Fake-Oxygen/3D-PRINTER/SOLIDWORKS/ASSEMBLY/Titan Aero from Aliexpress for GC/Render/Probe4_1.jpg

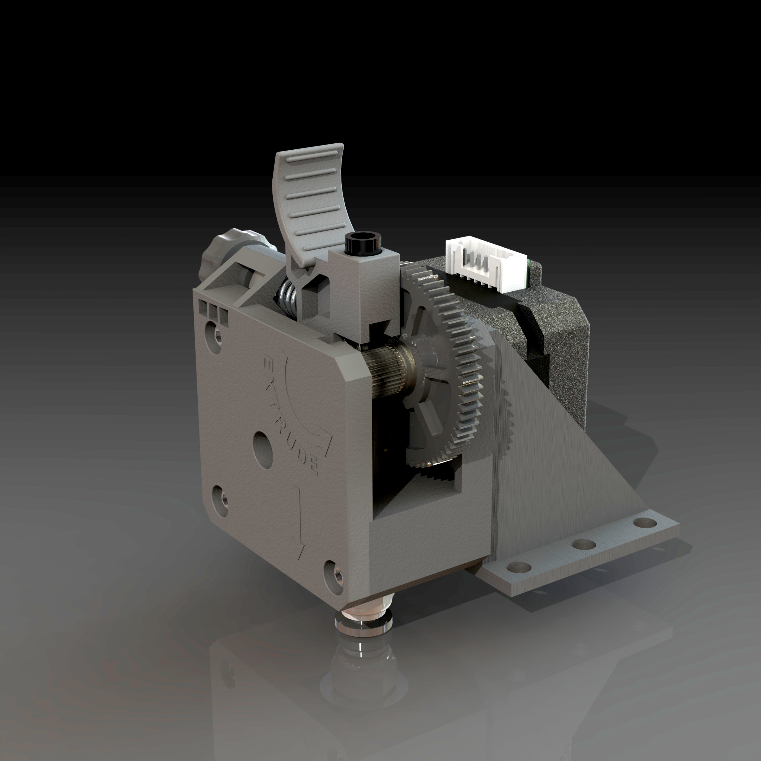
SOLIDWORKS/ASSEMBLY/Titan Aero from Aliexpress for GC/Render/Probe4_1.jpg
