Fake-Oxygen/3D-PRINTER/DRAWINGS/Back Header Cover2.pdf

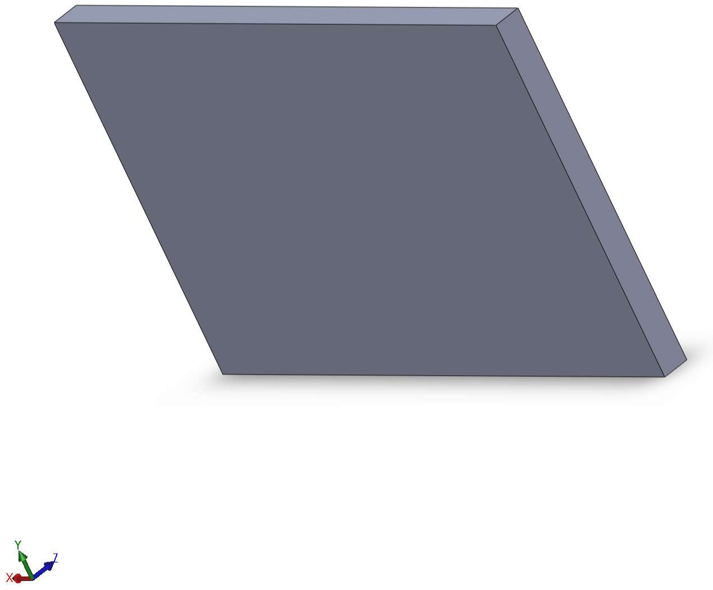
[picture p3: page 1]
