Fake-Oxygen/3D-PRINTER/DRAWINGS/Bearing holder cover2.pdf

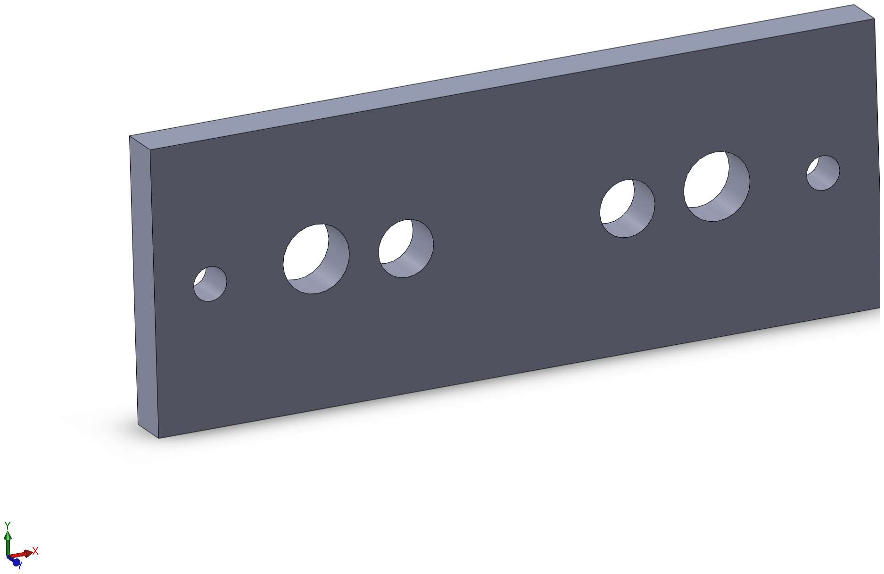
[picture p4: page 1]
