Fake-Oxygen/3D-PRINTER/DRAWINGS/Bearing holder2.pdf

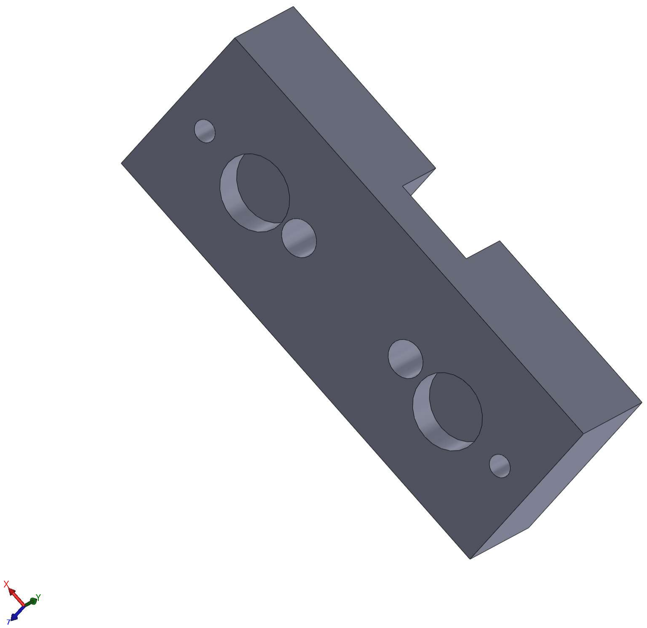
[picture p5: page 1]
