Fake-Oxygen/3D-PRINTER/DRAWINGS/Head Holder2.pdf

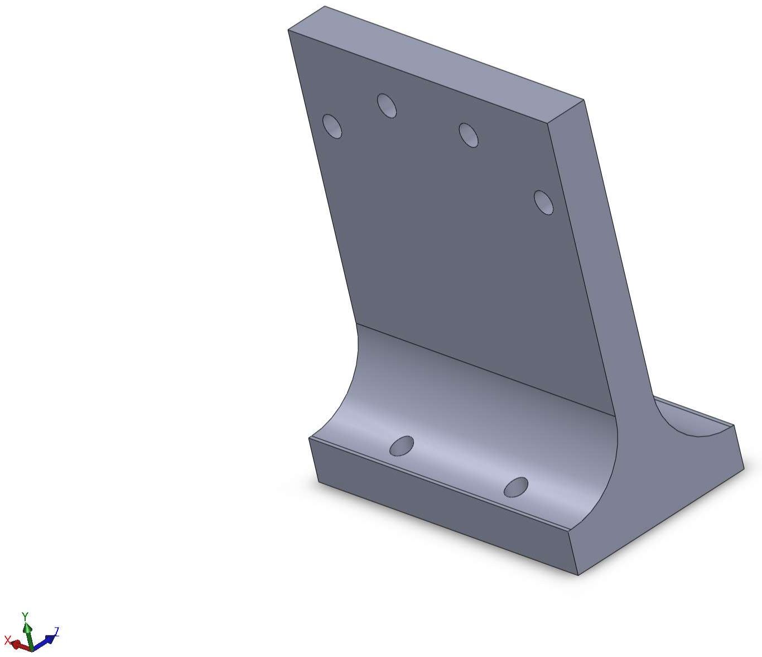
[picture p6: page 1]
