Fake-Oxygen/3D-PRINTER/DRAWINGS/Header fan holder2.pdf

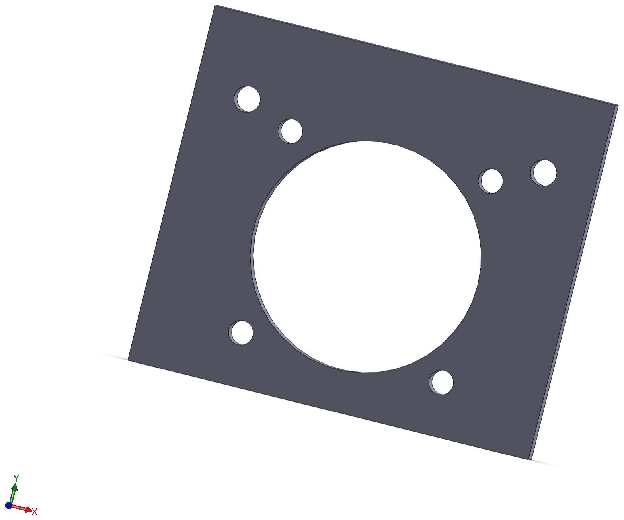
[picture p7: page 1]
