Fake-Oxygen/3D-PRINTER/DRAWINGS/Side Header Cover2.pdf

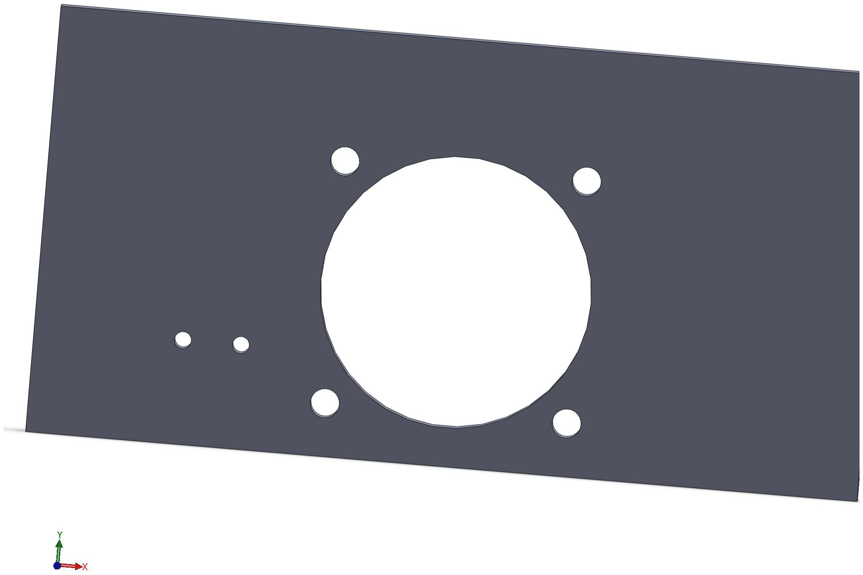
[picture p8: page 1]
