Fake-Oxygen/3D-PRINTER/DRAWINGS/Stabilizer2.pdf

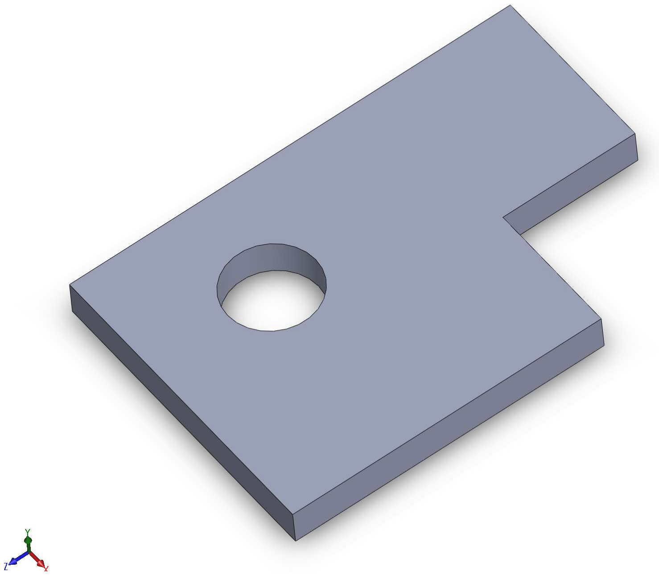
[picture p9: page 1]
