Fake-Oxygen/3D-PRINTER/IMAGES/Circuitry.png

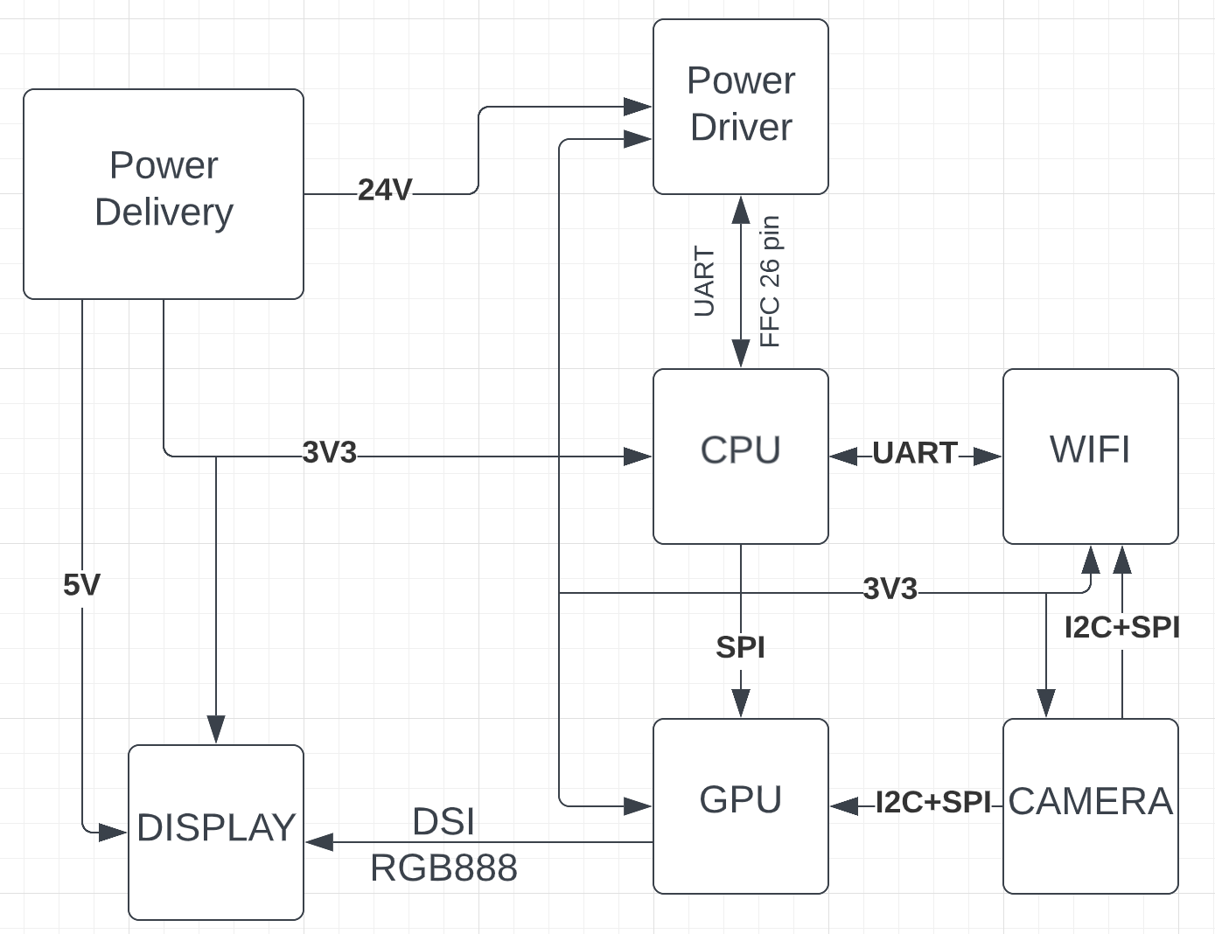
IMAGES/Circuitry.png
