Fake-Oxygen/3D-PRINTER/IMAGES/CPU (1).jpg

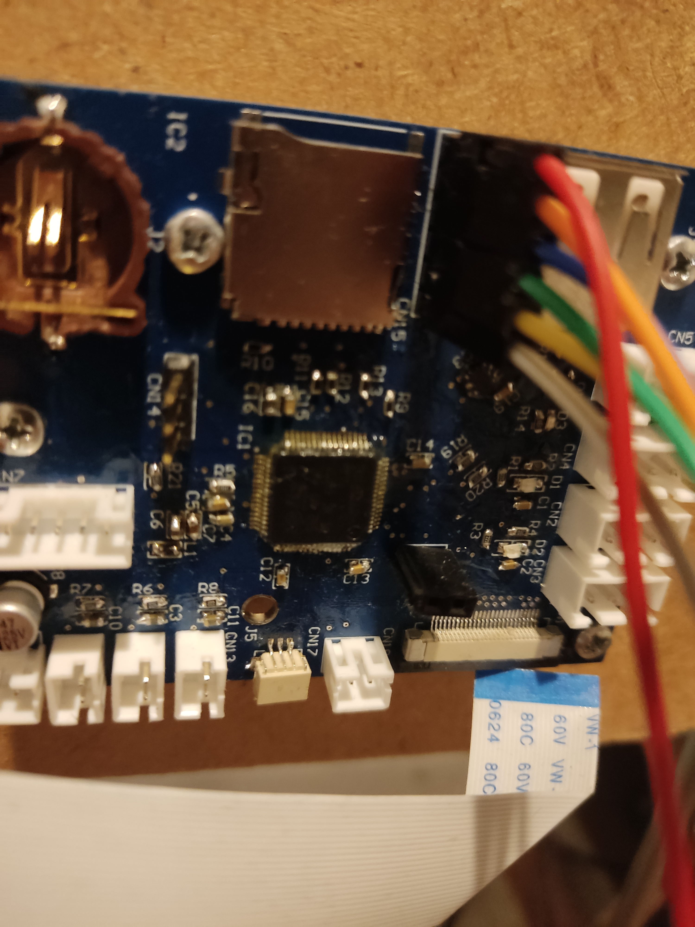
IMAGES/CPU (1).jpg
