Fake-Oxygen/3D-PRINTER/IMAGES/CPU (2).jpg

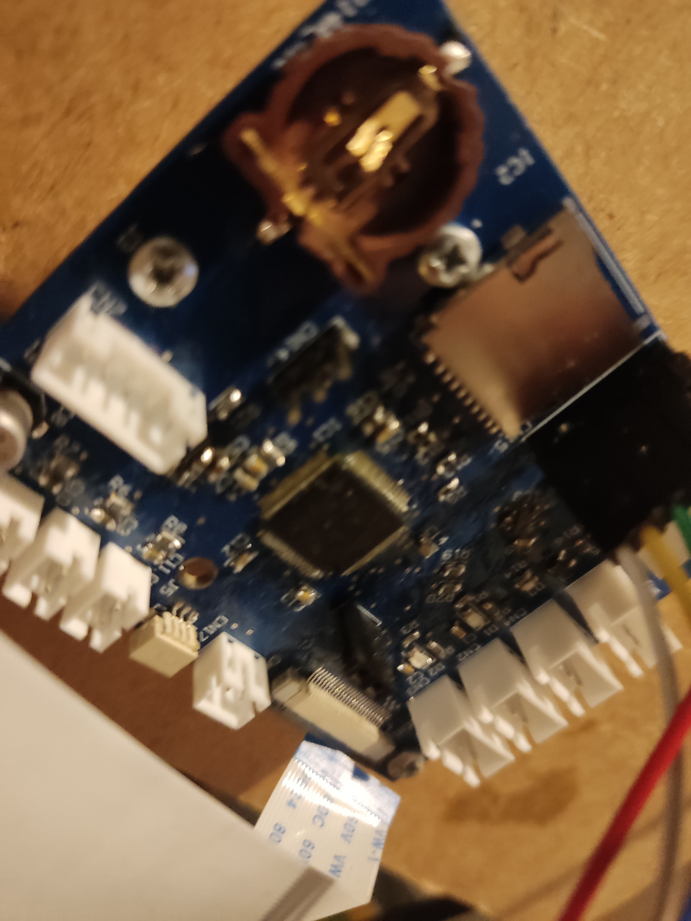
IMAGES/CPU (2).jpg
