Fake-Oxygen/3D-PRINTER/IMAGES/General Input Output Diagram.jpg

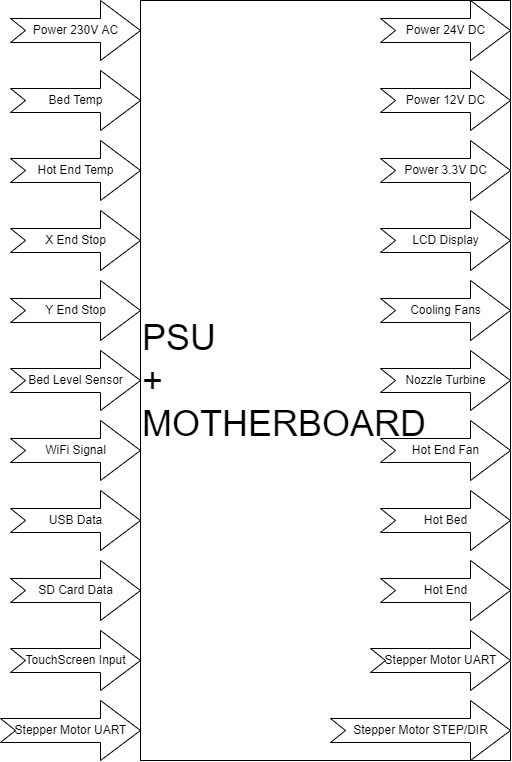
IMAGES/General Input Output Diagram.jpg
