Fake-Oxygen/3D-PRINTER/IMAGES/IMG_20221021_211350.jpg

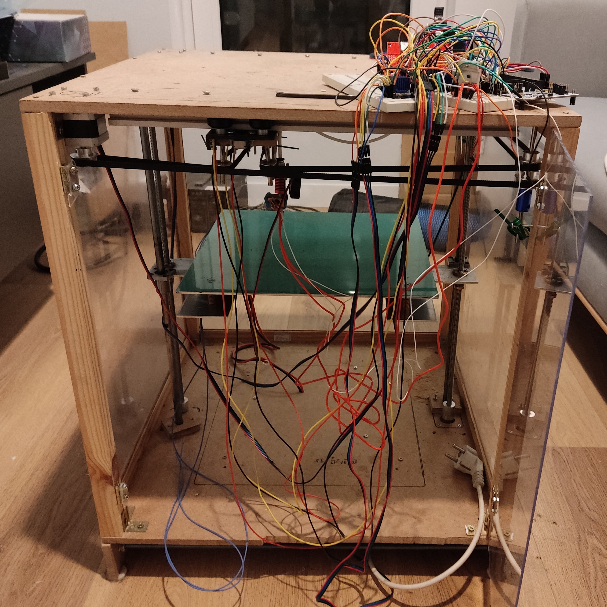
IMAGES/IMG_20221021_211350.jpg
