Fake-Oxygen/3D-PRINTER/IMAGES/preview2.JPG

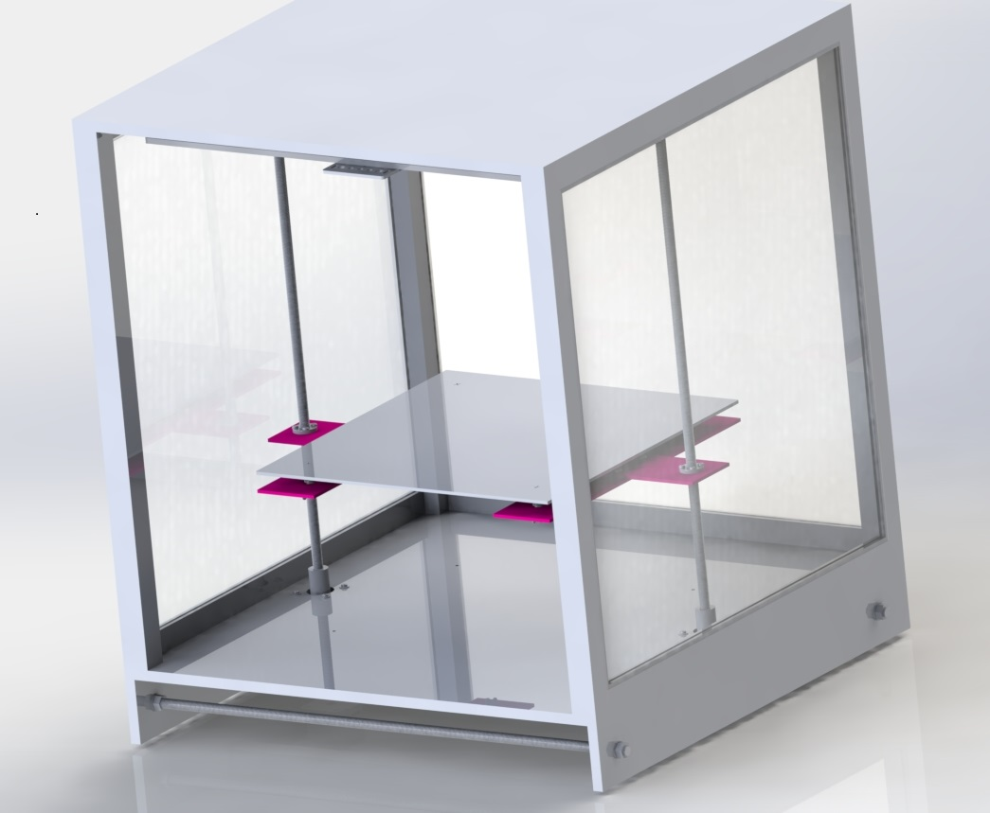
IMAGES/preview2.JPG
