Fake-Oxygen/3D-PRINTER/IMAGES/preview3.JPG

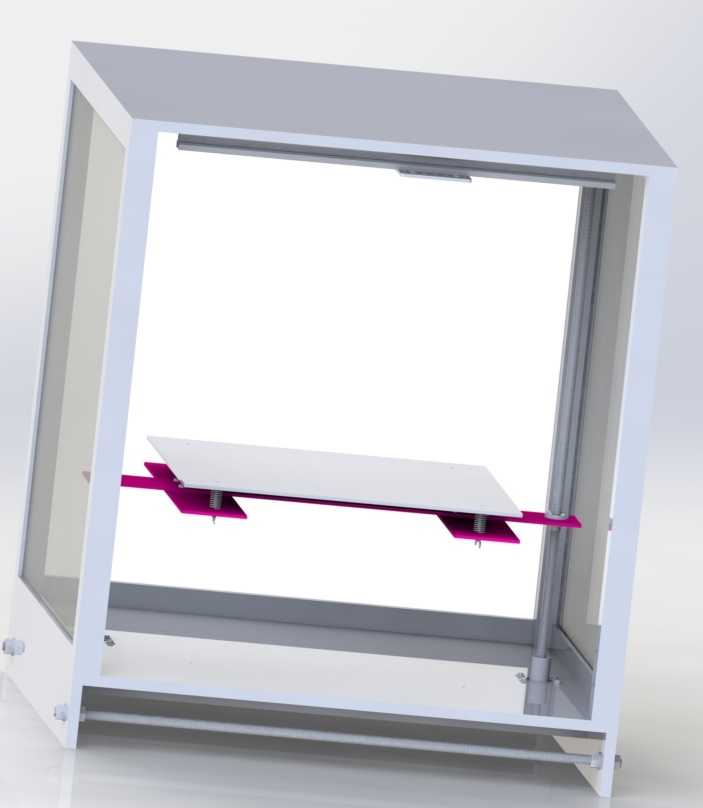
IMAGES/preview3.JPG
