Fake-Oxygen/3D-PRINTER/IMAGES/Preview4.JPG

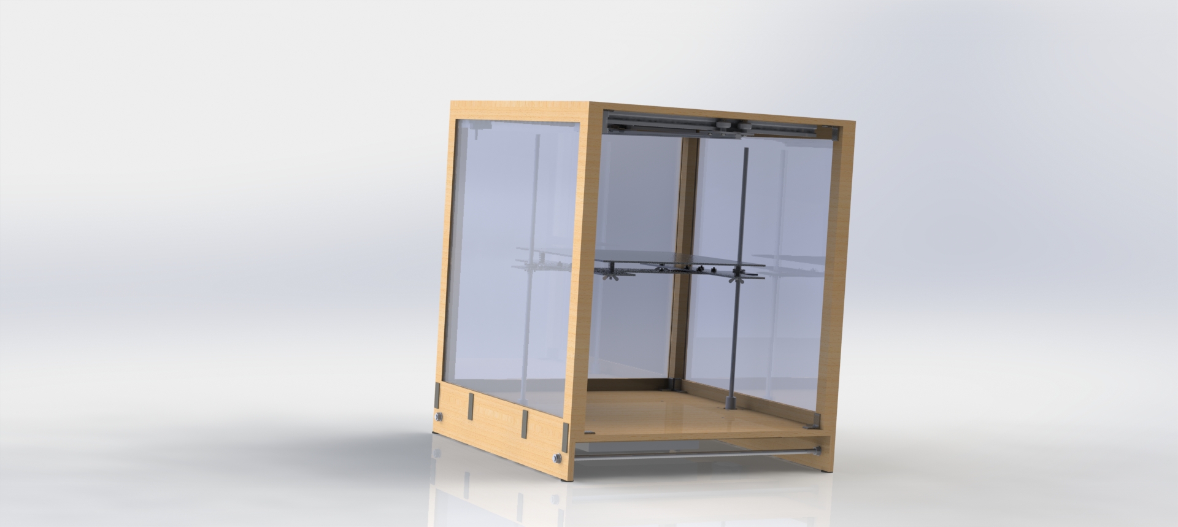
IMAGES/Preview4.JPG
