Fake-Oxygen/3D-PRINTER/IMAGES/Preview5.JPG

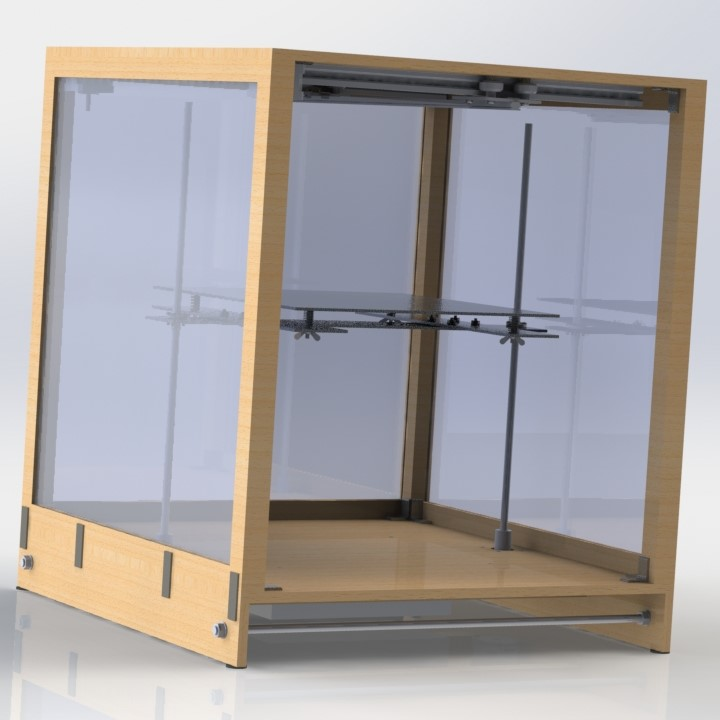
IMAGES/Preview5.JPG
