Fake-Oxygen/3D-PRINTER/IMAGES/preview.JPG

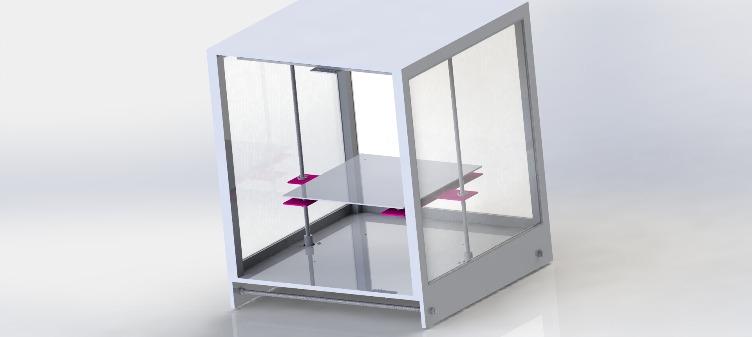
IMAGES/preview.JPG
