Fake-Oxygen/3D-PRINTER/IMAGES/RC for DIAG buffor 2.png

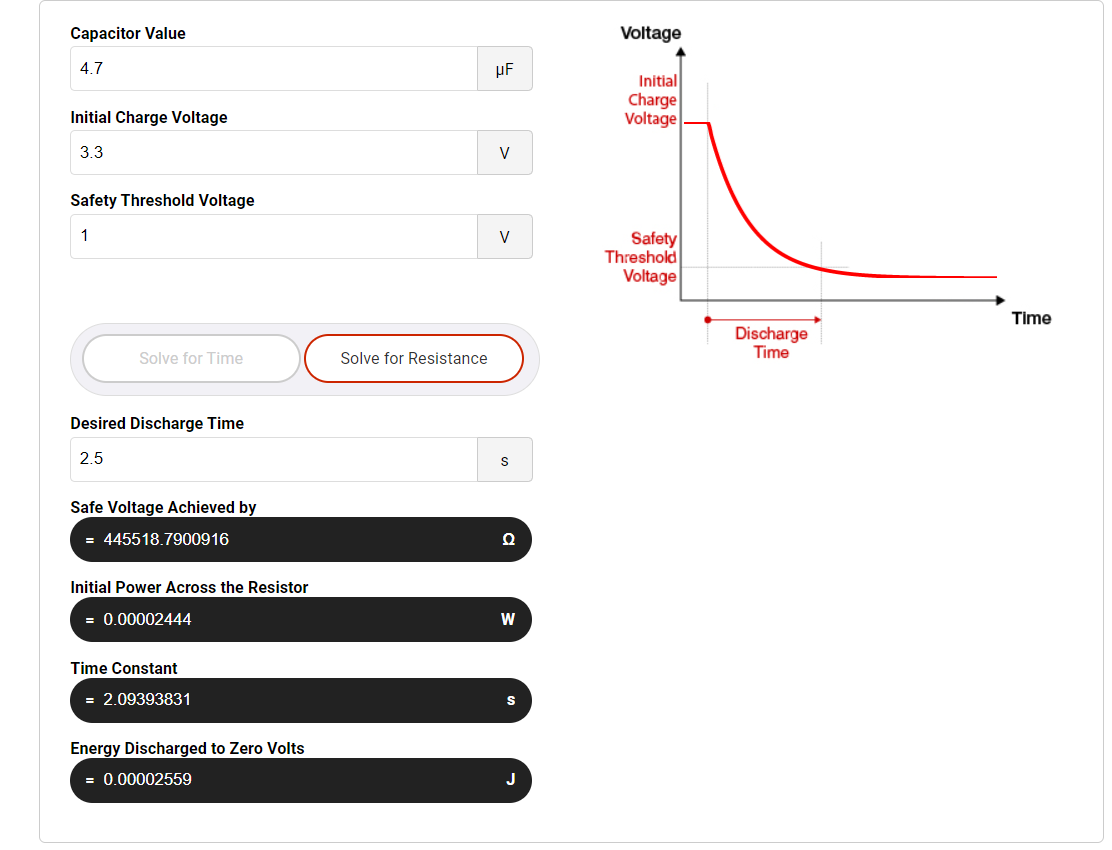
IMAGES/RC for DIAG buffor 2.png
