Fake-Oxygen/3D-PRINTER/IMAGES/RC for DIAG buffor 3.png

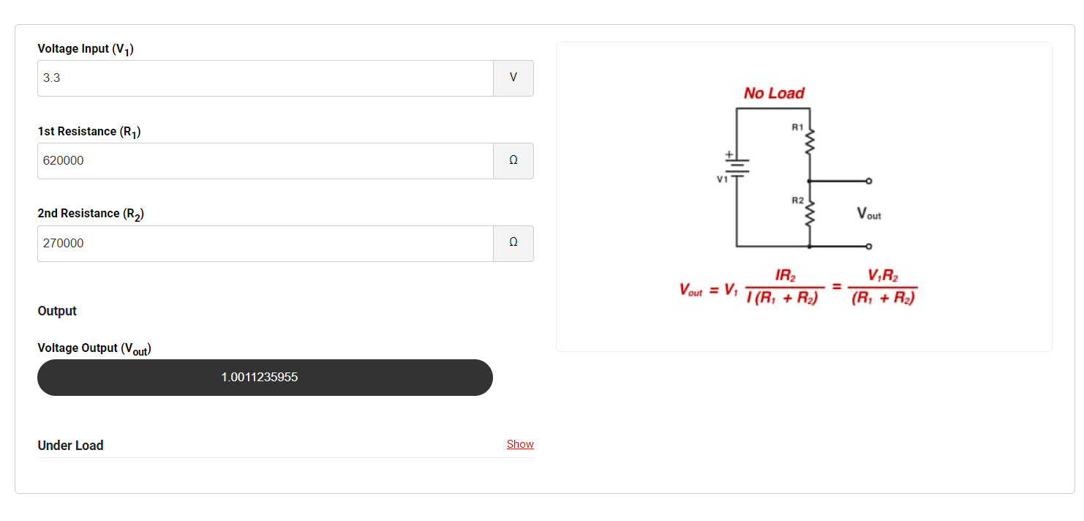
IMAGES/RC for DIAG buffor 3.png
