Fake-Oxygen/3D-PRINTER/IMAGES/RC for DIAG buffor.png

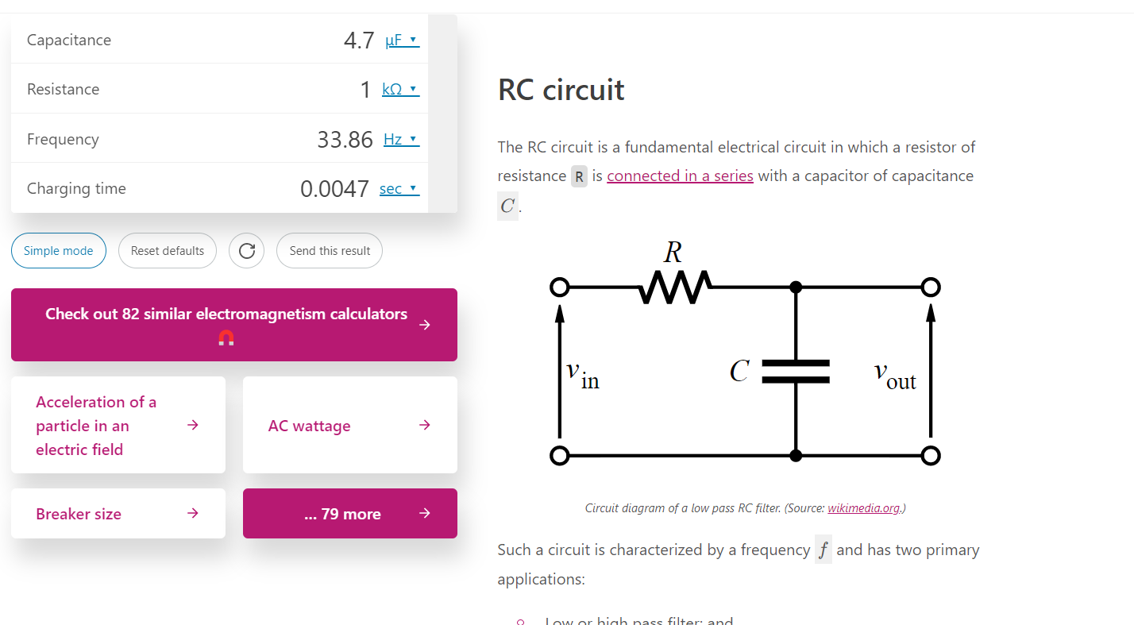
IMAGES/RC for DIAG buffor.png
