Fake-Oxygen/3D-PRINTER/IMAGES/Untit1led.JPG

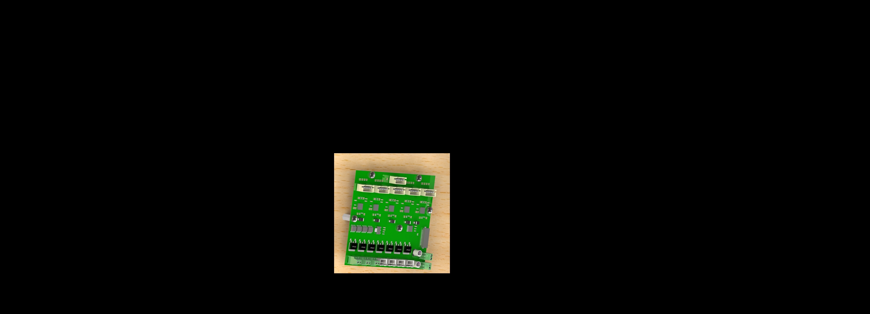
IMAGES/Untit1led.JPG
