Fake-Oxygen/3D-PRINTER/IMAGES/Untitled.JPG

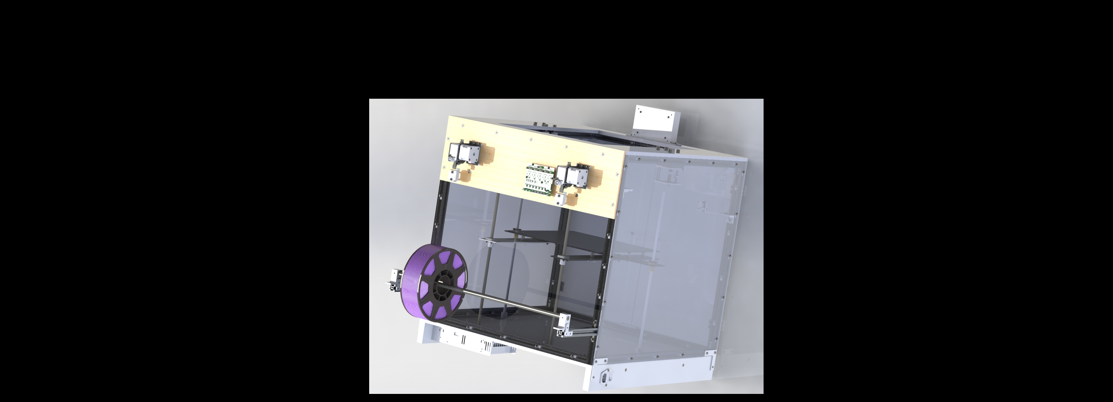
IMAGES/Untitled.JPG
