Fake-Oxygen/3D-PRINTER/PLANS/logic.png

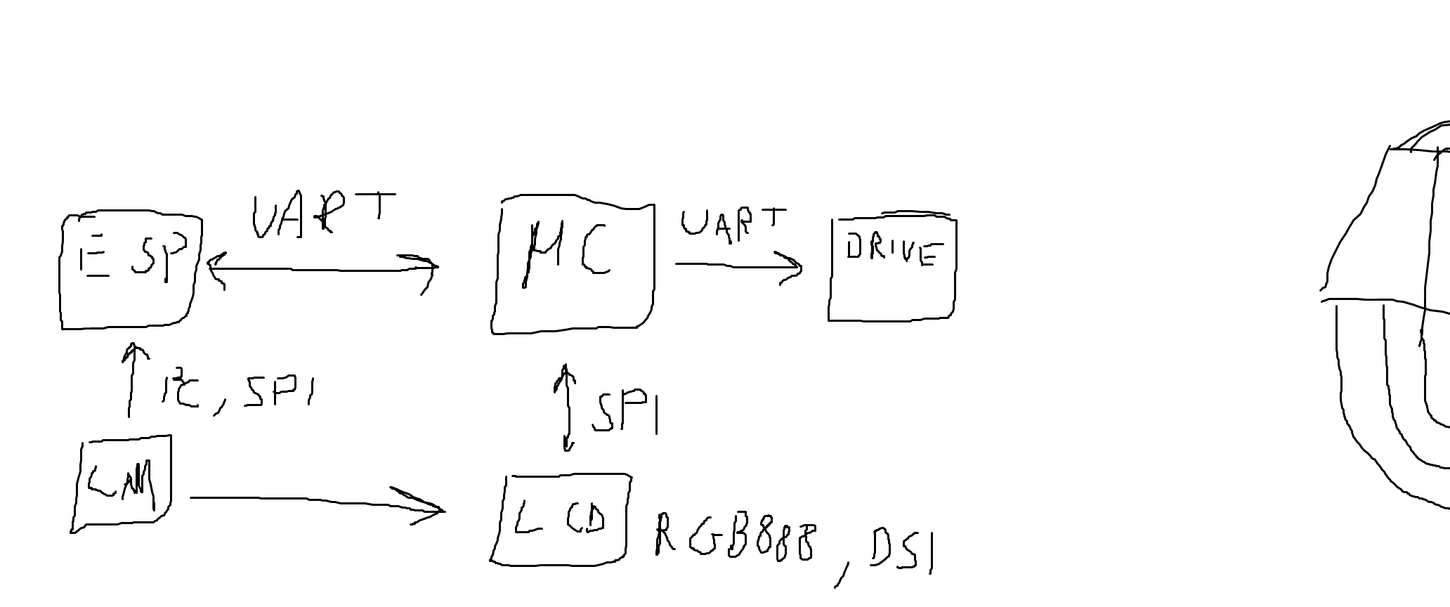
PLANS/logic.png
