Fake-Oxygen/3D-PRINTER/SOLIDWORKS/GENERAL/LMK_seri/LMK01.PNG

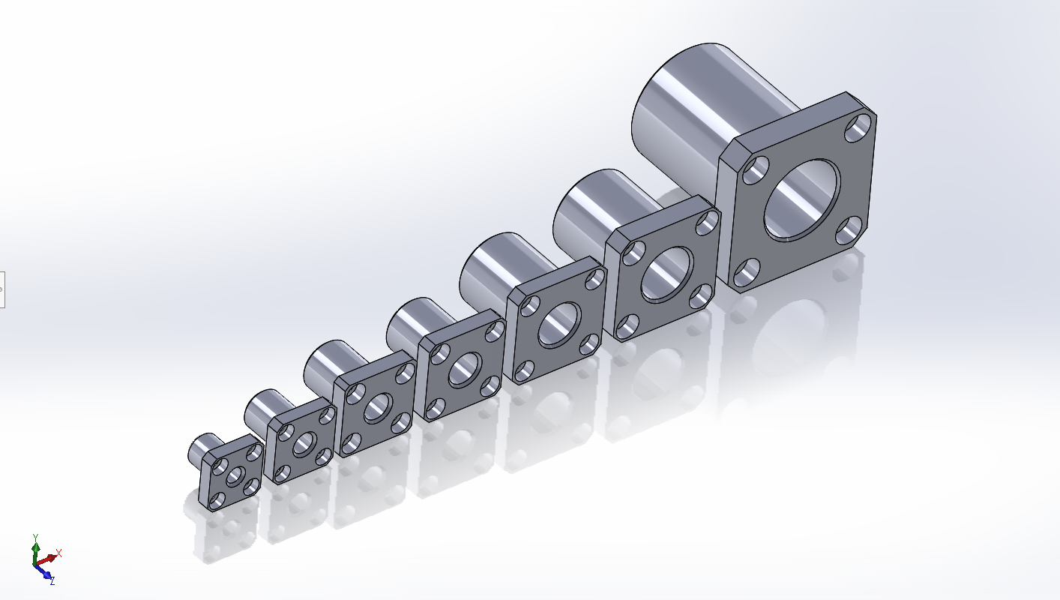
SOLIDWORKS/GENERAL/LMK_seri/LMK01.PNG
