Fake-Oxygen/3D-PRINTER/SOLIDWORKS/GENERAL/LMK_seri/LMKseri.JPG

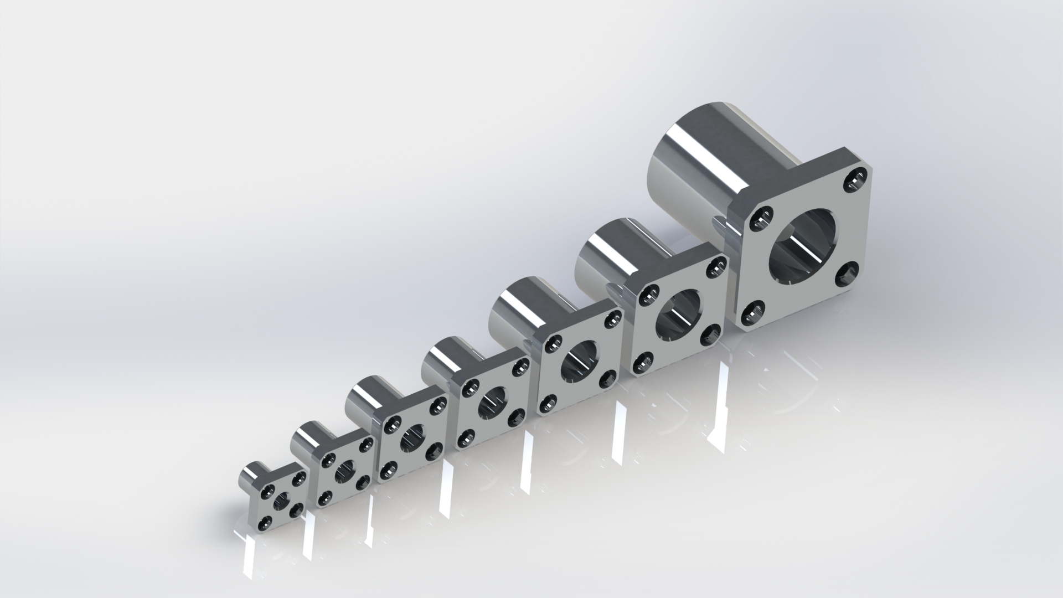
SOLIDWORKS/GENERAL/LMK_seri/LMKseri.JPG
