Fake-Oxygen/3D-PRINTER/BOM2.xlsx

Comment | Value | Description | Designator | Footprint | Quantity | price | Power (Watts)
1µF | 1µF | CAP CER 1UF 50V X7R 0603, CAP CER 1UF 35V X5R 0603 | C1, C2, C11, C28, C31, C67 | CAP 0603_1608 | 9 | 0.15, 0.03
0.1 µF | 0.1 µF | CAP CER 0.1UF 100V X7R 0603 | C3, C4, C5, C6, C7, C8, C9, C10, C12, C13, C14, C15, C19, C20, C21, C22, C23, C24, C29, C30, C32, C33, C34, C35, C36, C37, C50, C51, C52, C53, C66, C68 | CAP 0603_1608 | 51 | 0.01
22n | 22n | CAP CER 2200PF 50V NP0 0603 | C16, C17, C18, C48, C49 | CAP 0603_1608 | 5 | 0.18
4.7µF | 4.7µF | CAP CER 4.7UF 6.3V X5R 0603 | C25, C26, C27, C64, C65 | CAP 0603_1608 | 5 | 0.81
470 pF | 470 pF | CAP CER 0603 470PF 5% X7R 50V FL | C38, C39, C40, C41, C42, C43, C44, C45, C46, C47, C54, C55, C56, C57, C58, C59, C60, C61, C62, C63 | CAP 0603_1608 | 21 | 0.09
100µF | 100µF | CAP ALUM POLY 100UF 20% 35V SMD | C69, C70 | CAP ALSMD POLY 5.3MM H6.0MM | 2 | 0.51
B4B-XH-A_LF__SN_ |  | Connector | CN1, CN2, CN6, CN7, CN11, CN12 | B4BXHALFSN | 6
282834-2 |  | TERM BLK 2P SIDE ENT 2.54MM PCB | CN3, CN4, CN5, CN8, CN9 | TE 282834-2 | 5 | 0.88
B2B-XH-AM_LF__SN_ |  | Connector | CN10, CN13, CN14, CN15 | B2BXHAMLFSN | 4
FH12-26S-0.5SH_55_ |  | Connector | CN16 | FH1226S05SH55 | 1
MBRA120ET3G |  | DIODE SCHOTTKY 20V 1A SMA | D1, D2, D3, D4, D5 | DO214AC SMA | 5 | 0.09
IRLR7843TR |  | MOSFET (N-Channel) | Q1, Q2, Q3, Q4, Q5, Q6, Q7 | IRLR7843TR | 7
0R15 | 150 mOhms | RES 0.15 OHM 1% 1/4W 0603 | R1, R2, R3, R4, R5, R6, R16, R17, R18, R19 | STACKPOLE CSR0603 | 10 | 0.14 | 0.25W, 1/4W
20k | 20k | RES 20K OHM 1% 1/4W 0603 | R7, R8, R9, R10, R12, R14, R22, R23, R24, R26 | RES 0603_1608 | 10 | 0.03 | 0.25W, 1/4W
22k | 22k | RES 22K OHM 1% 1/10W 0603 | R11, R13, R15, R25, R27 | RES 0603_1608 | 5 | 0.01 | 0.1W, 1/10W
240R | 240R | RES SMD 240 OHM 1% 1/4W 0603 | R28 | RES 0603_1608 | 1 | 0.02 | 0.25W, 1/4W
2k | 2k | RES SMD 2K OHM 5% 1/4W 0603 | R29 | RES 0603_1608 | 1 | 0.01 | 0.25W, 1/4W
10k | 10k | RES 10K OHM 1% 1/5W 0603 | R30, R31, R32 | RES 0603_1608 | 3 | 0.01 | 0.2W, 1/5W
TMC2208-LA-T |  | Integrated Circuit | U1, U2, U3, U4, U5 | QFN50P500X500X90-29N-D | 5
LM317MBSTT3G |  | Integrated Circuit | U6 | SOT230P700X175-4N | 1
TC4427EOA713 |  | Integrated Circuit | U7, U8, U9, U10 | SOIC127P600X175-8N | 4
NX3L4051PW,118 |  | Integrated Circuit | U11 | SOP65P640X110-16N | 1
RESET | SE PUSHBUTTON | B1 | PB-6X6mm-Blue | SW PUSHBUTTON | 1
X7R | Capacitor | C5 | 1608[0603] | Cap | 1 | 10nF
Cap | Capacitor | C8, C10, C18, C19 | 1608[0603] | Cap | 4 | 6pF
10µF | CAP ALUM 10UF 20% 16V SMD | C25 | CAP ALSMD 5.3MM H5.4MM | UZP1C100MCL1GB | 1 | 10µF
FH12-30S-0.5SH | Connector | CN1 | FH1230S05SH | FH12-30S-0.5SH | 1
MEM2080-00-128-00-A | Connector | CN2 | MEM20800012800A | MEM2080-00-128-00-A | 1
Header 6 | Header, 6-Pin | CN3 | HDR1X6 | Header 6 | 1
Header 4 | Header, 4-Pin | CN4 | HDR1X4 | Header 4 | 1
10118193-0001LF | CONN RCPT USB2.0 MICRO B SMD R/A | CN5 | FCI USB 10118193-0001LF | 10118193-0001LF | 1
USB-A1HSW6 | CONN RCPT TYPEA 4POS R/A | CN6 | ON SHORE TECHNOLOGY USB-A1HSW6 | USB-A1HSW6 | 1
Header 8 | Header, 8-Pin | CN7 | HDR1X8 | Header 8 | 1
6339191-1 | Connector | CN8 | 63391911 | 6339191-1 | 1
282834-2 | TERM BLK 2P SIDE ENT 2.54MM PCB | CN9 | TE 282834-2 | 282834-2 | 1
BAT60JFILM | Default Diode | D1, D2, D5 | C0805 | Diode | 3
Green | Typical BLUE SiC LED | D3, D6 | 1608[0603] | LED3 | 2
Red | Typical BLUE SiC LED | D4 | 1608[0603] | LED3 | 1
BEAD | Inductor | L1 | 0603L | Inductor | 1 | 100uH
MMBT3904-TP | TRANS NPN 40V 0.2A SOT23 | Q1, Q2 | MCCSEMI SOT-23-3 | MMBT3904-TP | 2
Res1 | Resistor | R1, R2, R3, R4, R5, R6, R32 | 1608[0603] | Res1 | 7 | 47k
Res1 | Resistor | R7 | 1608[0603] | Res1 | 1 | 2k7
Res1 | Resistor | R8, R13, R14 | 1608[0603] | Res1 | 3 | 4k7
Res1 | Resistor | R9, R12, R30 | 1608[0603] | Res1 | 3 | 100k
Res1 | Resistor | R10, R11, R20, R27, R34, R35, R36, R37, R38, R41, R42, R43, R46, R51, R62 | 1608[0603] | Res1 | 15 | 10k
Res1 | Resistor | R15, R18, R26, R39, R40 | 1608[0603] | Res1 | 5 | 100R
Res1 | Resistor | R16, R17 | 1608[0603] | Res1 | 2 | 330R
Res1 | Resistor | R19, R21, R22, R23, R24, R25 | 1608[0603] | Res1 | 6 | 22R
Res1 | Resistor | R28 | 1608[0603] | Res1 | 1 | 36k
Res1 | Resistor | R29, R49 | 1608[0603] | Res1 | 2 | 1k5
Res1 | Resistor | R31 | 1608[0603] | Res1 | 1 | 330
Res1 | Resistor | R33 | 1608[0603] | Res1 | 1 | 22k
Res1 | Resistor | R44, R45, R47, R48, R50 | 1608[0603] | Res1 | 5 | 33R
Res1 | Resistor | R52 | 1608[0603] | Res1 | 1 | 12k1
Res1 | Resistor | R53, R54, R55, R56 | 1608[0603] | Res1 | 4 | 50R
Res1 | Resistor | R57, R58, R59, R60 | 1608[0603] | Res1 | 4 | 75R
Res1 | Resistor | R61, R63 | 1608[0603] | Res1 | 2 | 270R
Closed | Circuit Breaker | SB1, SB3, SB4, SB5, SB6, SB7, SB8, SB9, SB12 | SB_0603 | Circuit Breaker | 9
Open | Circuit Breaker | SB2, SB10, SB11 | SB_0603 | Circuit Breaker | 3
STM32F103CBT6 | Integrated Circuit | U1 | QFP50P900X900X160-48N | STM32F103CBT6 | 1
USBLC6-2SC6 | Integrated Circuit | U2, U4 | SOT95P280X145-6N | USBLC6-2SC6 | 2
LD3985M33R | Integrated Circuit | U3 | SOT95P280X145-5N | LD3985M33R | 1
ESP-12S | Integrated Circuit | U5 | ESP12S | ESP-12S | 1
KMS-1102NL |  | U6 | Transformer | KMS-1102NL | 1
USBLC6-4SC6 | Integrated Circuit | U7 | SOT95P280X145-6N | USBLC6-4SC6 | 1
LAN8742A-CZ-TR | LAN8742A-CZ-TR - Small Footprint RMII 10/100 Ethernet, Transceiver with HP Auto-MDIX and flexPWR Technology SQFN-24 | U8 | QFN24_0R5_4X4 | LAN8742A-CZ-TR | 1
Open | Jumper Wire | W1 | HDR1X2 | Jumper | 1
8 MHz | CRYSTAL 12.0000MHZ 20PF SMD | X1 | ECS CSM-3X | ECS-120-20-3X-EN-TR | 1 | 12 MHz
EB2532JA12-25.000M_TR | Crystal or Oscillator | X2 | EB2532JA1225000MTR | EB2532JA12-25.000M_TR | 1
X5R | Capacitor | C1, C2 | 1608[0603] | Cap | 2
FH12-20S-0.5SH_55_ | Connector | CN1 | FH12-20S-0.5SH(55) | FH12-20S-0.5SH_55_ | 1
Header 10X2 | Header, 10-Pin, Dual row | CN2 | HDR2X10 | Header 10X2 | 1
Res1 | Resistor | R1, R2, R3 | 1608[0603] | Res1 | 3
0.1 µF | CAP CER 0.1UF 100V X7R 0603 | C1, C2, C3, C4, C5, C6, C7, C8, C17, C18, C19, C20, C21, C22, C23, C24, C25, C26, C27, C28, C29, C30, C31 | CAP 0603_1608 | 0603B104K101CT | 23
10µF | CAP ALUM 10UF 20% 16V SMD | C9, C10 | CAP ALSMD 5.3MM H5.4MM | UZP1C100MCL1GB | 2
4.7µF | CAP ALUM POLY 4.7UF 20% 10V SMD | C11 | CAP ALSMD POLY 4.3MM H5.5MM | PCF1A4R7MCL1GB | 1
2.2 µF | CAP CER 2.2UF 6.3V X7R 0603 | C12, C13 | CAP 0603_1608 | CGA3E1X7R0J225M080AC | 2
X5R | Capacitor | C14, C15, C16, C36, C37, C38, C39, C40, C41, C42, C43, C44, C45, C46, C48 | 1608[0603] | Cap | 15
1µF | CAP CER 1UF 16V X5R 0603 | C32, C35 | CAP 0603_1608 | 0603YD105KAT4A | 2
4.7 µF | CAP CER 4.7UF 16V X5R 0603 | C33, C34 | CAP 0603_1608 | GRM185R61C475KE11D | 2
100µF | CAP ALUM POLY 100UF 20% 6.3V SMD | C47 | CAP ALSMD POLY 5.3MM H6.0MM | 6SVPC100M | 1
B2B-PH-K-S(LF)(SN) | CONN HEADER VERT 2POS 2MM | CN1, CN2, CN3 | JST B2B-PH-K | B2B-PH-K-S(LF)(SN) | 3
Header 3 | Header, 3-Pin | CN4 | HDR1X3 | Header 3 | 1
B3B-XH-A(LF)(SN) | CONN HEADER VERT 3POS 2.5MM | CN5, CN6, CN11, CN13 | JST XH B3B-XH-A | B3B-XH-A(LF)(SN) | 4
FH12-30S-0.5SH | Connector | CN7 | FH1230S05SH | FH12-30S-0.5SH | 1
FH12-26S-0.5SH_55_ | Connector | CN8 | FH1226S05SH55 | FH12-26S-0.5SH_55_ | 1
1-84953-5 | Connector | CN9 | 1849535 | 1-84953-5 | 1
FH12-20S-0.5SH_55_ | Connector | CN10 | FH12-20S-0.5SH(55) | FH12-20S-0.5SH_55_ | 1
282834-2 | TERM BLK 2P SIDE ENT 2.54MM PCB | CN12, CN14 | TE 282834-2 | 282834-2 | 2
B5B-PH-K-S(LF)(SN) | CONN HEADER VERT 5POS 2MM | CN15 | JST B5B-PH-K | B5B-PH-K-S(LF)(SN) | 1
Header 6 | Header, 6-Pin | CN16 | HDR1X6 | Header 6 | 1
Green | LED GREEN CLEAR 0805 SMD | D1, D2, D3 | LED 0805_2012 GREEN | QTLP630C4TR | 3
IS42S16160G-6TL | Integrated Circuit | IC1 | SOP80P1176X120-54N | IS42S16160G-6TL | 1
MX25L25645GZNI-08G | Integrated Circuit | IC2 | SON127P600X500X80-9N-D | MX25L25645GZNI-08G | 1
STM32F779IIT6 | Integrated Circuit | IC3 | QFP50P2600X2600X160-176N | STM32F779IIT6 | 1
CR1220-H-SMD | Integrated Circuit | IC4 | CR1220HSMD | CR1220-H-SMD | 1
FCM1608KF-601T03 | FIXED IND 27NH 780MA 200 MOHM | L1 | IND 0603_1608 RF WW | 744917127 | 1
SMT-0827-S-2-R | AUDIO MAGNETIC XDCR 2.5-4.5V SMD | LS1 | PUI Audio SMT-0827-S-2-R | SMT-0827-S-2-R | 1
MMBT3904 | TRANS NPN 40V 0.2A SOT416 | Q1, Q2 | SOT-23_N | MMBT3904TT1G | 2
4.7 kOhms | RES 4.7K OHM 0.1% 1/5W 0603 | R1, R2 | RES 0603_1608 | RS73G1JTTD4701B | 2
2.2 kOhms | RES 2.2K OHM 0.1% 1/5W 0603 | R3 | RES 0603_1608 | RS73G1JTTD2201B | 1
10k | RES 10K OHM 1% 1/5W 0603 | R4, R5, R6, R7 | RES 0603_1608 | RC0603FR-7W10KL | 4
Res1 | Resistor | R8, R9, R10, R11, R12, R13, R14 | 1608[0603] | Res1 | 7
32.768kHz | CRYSTAL 25.0000MHZ 8PF SMD | X1 | NDK NX5032GA | NX5032GA-25.000000MHZ-LN-CD-1 | 1
25 MHz | CRYSTAL 25.0000MHZ 8PF SMD | X2 | NDK NX5032GA | NX5032GA-25.000000MHZ-LN-CD-1 | 1
47uF | CAP ALUM 68UF 20% 16V SMD | C1, C2, C3 | CAP ALSMD 6.6MM H6.1MM | UUD1C680MCL1GS | 3
470uF | CAP ALUM 68UF 20% 16V SMD | C4 | CAP ALSMD 6.6MM H6.1MM | UUD1C680MCL1GS | 1
X5R | Capacitor | C5, C6, C7, C9, C10 | 1608[0603] | Cap | 5
X7R | Capacitor | C8 | 1608[0603] | Cap | 1
282834-2 | TERM BLK 2P SIDE ENT 2.54MM PCB | CN1, CN3 | TE 282834-2 | 282834-2 | 2
282834-3 | TERM BLK 3P SIDE ENT 2.54MM PCB | CN2 | TE 282834-3 | 282834-3 | 1
D Schottky | Schottky Diode | D1 | C0805 | D Schottky | 1
BAT60JFILM | Default Diode | D2 | C0805 | Diode | 1
120uH | FIXED IND 10UH 470MA 1.119OHM SM | L1 | IND 0806_2016 | SDED20161T-100MS | 1
Res1 | Resistor | R1, R2 | 1608[0603] | Res1 | 2 | 3k1
LM2596S-ADJ | Integrated Circuit | U1 | LM2596SXADJ | LM2596S-ADJ | 1
LD3985M33R | Integrated Circuit | U2 | SOT95P280X145-5N | LD3985M33R | 1
