Fake-Oxygen/3D-PRINTER/BOM.xlsx

No. | Part | Quantity | Cost | In Pack | Cost Total
1 | Płyta MDF 1x120x60 | 1 | 54.05 zł | 1 | 54.05 zł
2 | Pręt gwintowany M8x1000 | 1 | 3.95 zł | 1 | 3.95 zł
3 | Nakrętka M8 | 8 | 7.55 zł | 12 | 5.03 zł
4 | Podkładka M8 | 8 | 3.65 zł | 20 | 1.46 zł
5 | Łącznik płaski wąski 40x17x2 | 8 | 3.19 zł | 1 | 25.52 zł
6 | Kątownik meblowy 30 x 30 x 15 | 9 | 1.75 zł | 1 | 15.75 zł
7 | Listwa drewniana kwadratowa 25x25x1000 | 3 | 10.70 zł | 1 | 32.10 zł
8 | Listwa drewniana prostokątna sosnowa surowa 10x22x1000 | 3 | 10.70 zł | 1 | 32.10 zł
9 | Płyta MDF 4 mm 60 x 30 | 1 | 9.90 zł | 1 | 9.90 zł
10 | Zasilacz impulsowy 24V 25A | 1 | 145.00 zł | 1 | 145.00 zł
11 | Śruba 3 x 30 mm | 20 | 3.99 zł | 25 | 3.19 zł
12 | Śruba 3 x 20 mm | 16 | 3.95 zł | 30 | 2.11 zł
13 | Silnik krokowy NEMA17 - 42HB34F08AB - 1,70A - 36mm | 4 | 33.13 zł | 1 | 132.52 zł
14 | Korkowa Podkładka amortyzująca do silnika krokowego NEMA17 | 4 | 1.88 zł | 1 | 7.52 zł
15 | Wkręt 3.5 x 16 mm | 14 | 3.20 zł | 40 | 1.12 zł
16 | Wkręt 3 x 25 mm | 42 | 4.88 zł | 35 | 5.86 zł
17 | Nakrętka M3 | 30 | 7.35 zł | 45 | 4.90 zł
18 | Podkładka płaska 3 mm | 2 | 3.49 zł | 150 | 0.05 zł
19 | Śruba 3 x 10 mm | 8 | 3.99 zł | 30 | 1.06 zł
20 | Nakrętka trapezowa, samoregulująca T8 - do śruby trapezowej - ze sprężyną - 8mm | 2 | 7.24 zł | 1 | 14.48 zł
21 | Sprzęgło elastyczne 5/8 mm | 2 | 4.40 zł | 1 | 8.80 zł
22 | Nakrętka ślizgowa - wpust - M4 z kulką do profili aluminiowych 2020 | 12 | 5.57 zł | 10 | 6.68 zł
23 | Koło prowadnicy oś 5mm - rolka łożyskowana jezdna 625ZZ | 8 | 3.98 zł | 1 | 31.84 zł
24 | Ośka 5x150mm | 1 | 2.89 zł | 1 | 2.89 zł
25 | Łącznik osi - adapter z 5mm na 5mm | 2 | 3.88 zł | 1 | 7.76 zł
26 | Zębatka GT2 36 zębów - 5mm - na pasek 6mm | 6 | 7.76 zł | 1 | 46.56 zł
27 | Pasek zębaty GT2 Black - napędowy - szerokość 6mm | 4 | 6.90 zł | 1 | 27.60 zł
28 | Łożysko kulkowe 5x10x4 - oś 5mm - typ MR105 MINI | 6 | 1.60 zł | 1 | 9.60 zł
29 | Ośka 5x50mm | 4 | 1.30 zł | 1 | 5.20 zł
30 | Blacha Aluminiowa 3mm | 7 | 3.90 zł | 1 | 27.30 zł
31 | Sprężyn Stołu 4x8x30 | 4 | 14.99 zł | 4 | 14.99 zł
32 | Profil aluminiowy V-SLOT 2020 400mm | 2 | 18.80 zł | 1 | 37.60 zł
33 | LMK 10 UU ŁOŻYSKO LINIOWE z kołnierzem kwadratowym | 2 | 16.45 zł | 1 | 32.90 zł
34 | Płytka: V-Slot Gantry Plate | 2 | 26.90 zł | 1 | 53.80 zł
35 | 2x DYSTANS I TULEJKA MIMOŚRODOWA WÓZEK 2020 | 8 | 15.40 zł | 2 | 61.60 zł
36 | Śruba imbusowa walcowa M3 x 40mm | 7 | 6.99 zł | 10 | 4.89 zł
37 | Koło pasowe bez zębów napinacz do paska GT2 | 4 | 5.75 zł | 1 | 23.00 zł
38 | Zestaw Głowica hotend Ptfe CR 10 Ender 1.75 24V | 1 | 49.99 zł | 1 | 49.99 zł
39 | TMC2208 v3.0 STEPSTICK sterownik silnika | 3 | 19.99 zł | 1 | 59.97 zł
40 | Śruba trapezowa Tr8x8 450mm | 2 | 22.00 zł | 1 | 44.00 zł
41 | Pręt okrągły stalowy 1 m x 10 mm surowy | 1 | 14.70 zł | 1 | 14.70 zł
42 | Aluminium Heatbed MK3 310x310 | 1 | 109.70 zł | 1 | 109.70 zł
43 | Śruba 4 x 50 mm | 4 | 12.30 zł | 8 | 6.15 zł
44 | Nakrętka motylkowa 4 | 4 | 9.10 zł | 8 | 4.55 zł
45 | Nakrętka 4 | 12 | 7.35 zł | 45 | 1.96 zł
46 | Podkładka płaska 4 mm | 8 | 3.99 zł | 100 | 0.32 zł
47 | Śruba 4 x 16 mm | 12 | 4.40 zł | 25 | 2.11 zł
48 | Szkło syntetyczne Gładkie 4 mm Przejrzyste 150 x 50 cm | 1 | 159.00 zł | 1 | 159.00 zł
49 | Zawias 33x41 mm przykręcany ocynkowany | 4 | 3.75 zł | 1 | 15.00 zł
50 | Śruba 4 x 25 mm | 12 | 4.95 zł | 12 | 4.95 zł
51 | Śruba 5 x 25 mm | 4 | 4.95 zł | 12 | 1.65 zł
52 | Nakrętka 5 | 4 | 6.85 zł | 40 | 0.68 zł
53 | MGN12 Prowadnica liniowa 450 | 1 | 116.93 zł | 1 | 116.93 zł
Total |  | 340 |  |  | 1492.35 zł
