Fake-Oxygen/3D-PRINTER/SOLIDWORKS/BOM.xlsx

ITEM NO. | PART NUMBER | DESCRIPTION | MATERIAL | STOCK SIZE | WEIGHT | VENDOR | QTY.
1 | Frame |  |  |  |  |  | 1
1.1 | Aluminium panel | 560mm |  |  |  | v slot | 12
1.2 | CTI20-01 - Cantoneira interna base 20 v-slot |  | Zamak (Zn-Al-Cu-Mg) |  |  | abc rc | 20
1.3 | Top Plate v2 |  |  |  |  |  | 1
1.4 | Aluminium panel connector |  |  |  |  | abc rc | 228
1.5 | B18.6.7M - M4 x 0.7 x 16 Type I Cross Recessed FHMS --16N |  |  |  |  |  | 112
1.6 | B18.6.7M - M4 x 0.7 x 8 Type I Cross Recessed FHMS --8N |  |  |  |  |  | 32
1.7 | bottom plate v2 |  |  |  |  |  | 1
1.8 | Bottom Leg |  |  |  |  |  | 1
1.9 | Bottom Leg |  |  |  |  |  | 1
1.1 | L Shape profile connector |  |  |  |  |  | 4
1.11 | B18.6.7M - M5 x 0.8 x 13 Type I Cross Recessed PHMS --13N |  |  |  |  |  | 4
1.12 | B18.6.7M - M4 x 0.7 x 10 Type I Cross Recessed PHMS --10N |  |  |  |  |  | 4
1.13 | Bottom support bar |  |  |  |  |  | 2
1.14 | B18.6.7M - M3 x 0.5 x 16 Type I Cross Recessed FHMS --16N |  |  |  |  |  | 20
1.15 | Plexi side panel |  |  |  |  |  | 2
1.16 | B18.6.7M - M4 x 0.7 x 10 Type I Cross Recessed PHMS --10N |  |  |  |  |  | 40
1.17 | Back top plate |  |  |  |  |  | 1
1.18 | B18.6.7M - M4 x 0.7 x 13 Type I Cross Recessed FHMS --13N |  |  |  |  |  | 9
1.19 | Aluminium panel |  |  |  |  |  | 2
1.2 | B18.6.7M - M4 x 0.7 x 8 Type I Cross Recessed FHMS --8N |  |  |  |  |  | 4
1.21 | Plexi back plate |  |  |  |  |  | 1
1.22 | B18.6.7M - M4 x 0.7 x 10 Type I Cross Recessed PHMS --10N |  |  |  |  |  | 19
1.23 | Assem4^Frame |  |  |  |  |  | 2
1.23.1 | Filament holder rod support |  |  |  |  |  | 1
1.23.2 | L Shape profile connector |  |  |  |  |  | 2
1.24 | Rod |  |  |  |  |  | 1
1.25 | B18.3.6M - M3 x 0.5 x 5 Hex Socket Cone Pt. SS --N |  |  |  |  |  | 2
1.26 | 30x38 2020 HINGE v2.step |  |  |  |  |  | 4
1.27 | Slider T-Nut for 2020 - M5.step |  |  |  |  |  | 8
1.28 | B18.6.7M - M5 x 0.8 x 10 Type I Cross Recessed FHMS --10N |  |  |  |  |  | 8
1.29 | Plexi door |  |  |  |  |  | 2
1.3 | B18.6.7M - M5 x 0.8 x 13 Type I Cross Recessed FHMS --13N |  |  |  |  |  | 8
1.31 | B18.2.4.1M - Hex nut, Style 1, M5 x 0.8 --D-N |  |  |  |  |  | 8
1.32 | Part3 |  |  |  |  |  | 2
1.33 | B18.2.4.1M - Hex nut, Style 1, M4 x 0.7 --D-N |  |  |  |  |  | 4
1.34 | Assem3^Frame |  |  |  |  |  | 2
1.34.1 | Door blocker |  |  |  |  |  | 1
1.34.2 | Aluminium panel connector |  |  |  |  |  | 2
1.34.3 | B18.6.7M - M4 x 0.7 x 13 Type I Cross Recessed FHMS --13N |  |  |  |  |  | 2
2 | XY Axis assembly |  |  |  |  |  | 1
2.1 | Header |  |  |  |  |  | 1
2.1.1 | Head Holder v2 |  |  |  |  |  | 1
2.1.2 | e3d v6 |  |  |  |  |  | 2
2.1.2.1 | e3d nozzle (0.4) |  |  |  |  |  | 1
2.1.2.2 | e3d heaterblock |  |  |  |  |  | 1
2.1.2.3 | e3d heat break |  |  |  |  |  | 1
2.1.2.4 | e3d heatsink |  |  |  |  |  | 1
2.1.3 | Header holder bracket |  |  |  |  |  | 2
2.1.4 | B18.6.7M - M3 x 0.5 x 20 Type I Cross Recessed PHMS --20N |  |  |  |  |  | 4
2.1.5 | Radial-Cooling-Fan- 5015-DC12V |  |  |  |  |  | 1
2.1.5.1 | turbine |  |  |  |  |  | 1
2.1.5.2 | top |  |  |  |  |  | 1
2.1.5.3 | bottom |  |  |  |  |  | 1
2.1.6 | Blower fan holder |  |  |  |  |  | 1
2.1.7 | B18.6.7M - M4 x 0.7 x 25 Type I Cross Recessed PHMS --25N |  |  |  |  |  | 2
2.1.8 | B18.2.4.1M - Hex nut, Style 1, M4 x 0.7 -- D-N |  |  |  |  |  | 2
2.1.9 | Header fan holder plate v2 |  |  |  |  |  | 1
2.1.10 | B18.6.7M - M3 x 0.5 x 16 Type I Cross Recessed PHMS --16N |  |  |  |  |  | 8
2.1.11 | B18.6.7M - M3 x 0.5 x 20 Type I Cross Recessed PHMS --20N |  |  |  |  |  | 4
2.1.12 | B18.2.4.2M - Hex nut, Style 2, M3 x 0.5 -- D-N |  |  |  |  |  | 6
2.1.13 | BLTouch-Smart V3.1.step |  |  |  |  |  | 1
2.1.13.1 | 93245A111.step |  |  |  |  |  | 1
2.1.13.2 | BL-touch.step |  |  |  |  |  | 1
2.1.13.3 | BL-touch-0.step |  |  |  |  |  | 1
2.1.13.4 | BL-touch-1.step |  |  |  |  |  | 1
2.1.13.5 | BL-touch-2.step |  |  |  |  |  | 1
2.1.13.6 | BL-touch-3.step |  |  |  |  |  | 1
2.1.13.7 | BL-touch-4.step |  |  |  |  |  | 1
2.1.13.8 | BL-touch-5.step |  |  |  |  |  | 1
2.1.13.9 | BL-touch-6.step |  |  |  |  |  | 1
2.1.13.10 | BL-touch-7.step |  |  |  |  |  | 1
2.1.13.11 | BL-touch-8.step |  |  |  |  |  | 1
2.1.14 | B18.6.7M - M3 x 0.5 x 10 Type I Cross Recessed PHMS --10N |  |  |  |  |  | 2
2.1.15 | Part2^Header |  |  |  |  |  | 1
2.1.16 | Part3^Header |  |  |  |  |  | 1
2.1.17 | Part4^Header |  |  |  |  |  | 1
2.1.18 | Part5^Header |  |  |  |  |  | 1
2.1.19 | Part6^Header |  |  |  |  |  | 1
2.1.20 | fanduct |  |  |  |  |  | 1
2.1.20.1 | fan duct |  |  |  |  |  | 1
2.1.21 | FanDut |  |  |  |  |  | 1
2.1.22 | PTFE tube connector |  |  |  |  |  | 2
2.1.23 | B18.6.7M - M3 x 0.5 x 13 Type I Cross Recessed PHMS --13N |  |  |  |  |  | 1
2.1.24 | fan |  |  |  |  |  | 3
2.1.25 | fan duct |  |  |  |  |  | 1
2.2 | MGNxx block |  |  |  |  |  | 1
2.3 | MGNxx rail |  |  |  |  |  | 1
2.4 | Side pulley assembly |  |  |  |  |  | 2
2.4.1 | Bearing Holder |  |  |  |  |  | 1
2.4.2 | V Slot Carriage Assembly |  |  |  |  |  | 1
2.4.2.1 | Carriage for V Slot |  |  |  |  |  | 1
2.4.2.2 | Spacer M5 6mm |  |  |  |  |  | 4
2.4.2.3 | Wheel for guideway |  |  |  |  |  | 4
2.4.2.3.1 | Tire for 625ZZ bearing |  |  |  |  |  | 1
2.4.2.3.2 | Bearing |  |  |  |  |  | 2
2.4.2.4 | ISO 1580 - M5 x 25 - 25N |  |  |  |  |  | 4
2.4.2.5 | B18.2.4.1M - Hex nut, Style 1, M5 x 0.8 -- D-N |  |  |  |  |  | 4
2.4.3 | idle pulley |  |  |  |  |  | 2
2.4.4 | Bearing |  |  |  |  |  | 4
2.4.5 | Rod |  |  |  |  |  | 2
2.4.6 | Rod |  |  |  |  |  | 4
2.4.7 | B18.22M - Plain washer, 3 mm, narrow |  |  |  |  |  | 1
2.4.8 | B18.2.4.1M - Hex nut, Style 1, M3 x 0.5 -- D-N |  |  |  |  |  | 1
2.4.9 | bearing holder v2 |  |  |  |  |  | 1
2.4.10 | bearing holder v2 |  |  |  |  |  | 1
2.4.11 | Rod |  |  |  |  |  | 1
2.4.12 | B18.2.4.1M - Hex nut, Style 1, M5 x 0.8 -- D-N |  |  |  |  |  | 4
2.5 | Aluminium panel |  |  |  |  |  | 2
2.6 | Aluminium panel connector |  |  |  |  |  | 20
2.7 | B18.6.7M - M3 x 0.5 x 20 Type I Cross Recessed PHMS --20N |  |  |  |  |  | 2
2.8 | B18.6.7M - M3 x 0.5 x 30 Type I Cross Recessed PHMS --30N |  |  |  |  |  | 4
3 | B18.6.7M - M4 x 0.7 x 16 Type I Cross Recessed FHMS --16N |  |  |  |  |  | 22
4 | NEMA17 |  |  |  |  |  | 2
5 | Podkładka pod NEMA17 |  |  |  |  |  | 2
6 | AC Power Socket |  |  |  |  |  | 1
7 | Power supply |  |  |  |  |  | 1
8 | Back Belt Drive |  |  |  |  |  | 2
8.1 | Bearing |  |  |  |  |  | 2
8.2 | Rod |  |  |  |  |  | 1
8.3 | 36 Teeth GT2 gear |  |  |  |  |  | 2
9 | B18.6.7M - M3 x 0.5 x 25 Type I Cross Recessed FHMS --25N |  |  |  |  |  | 8
10 | 36 Teeth GT2 gear |  |  |  |  |  | 2
11 | Back belt holder |  |  |  |  |  | 2
12 | angle bar |  |  |  |  |  | 5
13 | Aluminium panel connector |  |  |  |  |  | 6
14 | B18.6.7M - M4 x 0.7 x 13 Type I Cross Recessed PHMS --13N |  |  |  |  |  | 4
15 | B18.2.4.1M - Hex nut, Style 1, M4 x 0.7 --D-N |  |  |  |  |  | 4
16 | B18.6.7M - M4 x 0.7 x 10 Type I Cross Recessed PHMS --10N |  |  |  |  |  | 4
17 | Hot Bed |  |  |  |  |  | 1
17.1 | Hot Bed |  |  |  |  |  | 1
17.2 | Left Y Carriage Plate |  |  |  |  |  | 1
17.3 | Right Y Carriage Plate |  |  |  |  |  | 1
17.4 | Spring M4 |  |  |  |  |  | 4
17.5 | B18.6.7M - M4 x 0.7 x 30 Slotted FHMS --30N |  |  |  |  |  | 4
17.6 | Wing nut M4 |  |  |  |  |  | 4
17.7 | Z Axis |  |  |  |  |  | 2
17.7.1 | NEMA17 |  |  |  |  |  | 1
17.7.2 | Podkładka pod NEMA17 |  |  |  |  |  | 1
17.7.3 | Stepper Motor Clutch |  |  |  |  |  | 1
17.7.4 | ROD M8 |  |  |  |  |  | 1
17.7.5 | t8 preload nut.step |  |  |  |  |  | 1
17.8 | Middle Y Carriage Plate |  |  |  |  |  | 1
17.9 | B18.6.7M - M4 x 0.7 x 13 Type I Cross Recessed PHMS --13N |  |  |  |  |  | 8
17.1 | B18.22M - Plain washer, 4 mm, regular |  |  |  |  |  | 8
17.11 | B18.2.4.1M - Hex nut, Style 1, M4 x 0.7 --D-N |  |  |  |  |  | 8
17.12 | B18.6.7M - M2.5 x 0.45 x 10 Type I Cross Recessed PHMS --10N |  |  |  |  |  | 8
17.13 | B18.2.4.1M - Hex nut, Style 1, M2.5 x 0.45 -- D-N |  |  |  |  |  | 8
18 | B18.6.7M - M3 x 0.5 x 20 Type I Cross Recessed FHMS --20N |  |  |  |  |  | 8
19 | B18.6.7M - M4 x 0.7 x 25 Type I Cross Recessed FHMS --25N |  |  |  |  |  | 4
20 | B18.6.7M - M3 x 0.5 x 10 Type I Cross Recessed FHMS --10N |  |  |  |  |  | 4
21 | Rod |  |  |  |  |  | 2
22 | LMK08 |  |  |  |  |  | 2
23 | B18.6.7M - M3 x 0.5 x 10 Type I Cross Recessed PHMS --10N |  |  |  |  |  | 8
24 | B18.22M - Plain washer, 3 mm, narrow |  |  |  |  |  | 8
25 | B18.2.4.1M - Hex nut, Style 1, M3 x 0.5 --D-N |  |  |  |  |  | 16
26 | SS-5GL |  |  |  |  |  | 2
27 | Titan_aero_Aliexpress |  |  |  |  |  | 2
27.1 | House |  |  |  |  |  | 1
27.2 | Adapter for connector |  |  |  |  |  | 1
27.3 | PC4-1_8 my edition |  |  |  |  |  | 1
27.4 | Guide |  |  |  |  |  | 1
27.5 | Thumbscrew |  |  |  |  |  | 1
27.6 | Hexagon Thin Nut ISO 4035 - M4 - C |  |  |  |  |  | 1
27.7 | Main Gear |  |  |  |  |  | 1
27.8 | Cup |  |  |  |  |  | 1
27.9 | Rocker_ASMBL |  |  |  |  |  | 1
27.9.1 | Rocker |  |  |  |  |  | 1
27.9.2 | Sleeve_in_rocker |  |  |  |  |  | 1
27.9.3 | MR95ZZ |  |  |  |  |  | 1
27.9.4 | 623-D-ZZ |  |  |  |  |  | 1
27.9.5 | ISO 7380 - M3 x 8 - 8C |  |  |  |  |  | 1
27.1 | Spring |  |  |  |  |  | 1
27.11 | Shaft and gear |  |  |  |  |  | 1
27.11.1 | Shaft |  |  |  |  |  | 1
27.11.2 | Gear |  |  |  |  |  | 1
27.12 | ISO 15 RBB - 276 - 16,DE,NC,16_68 |  |  |  |  |  | 2
27.13 | ISO 4029 - M3 x 3-C |  |  |  |  |  | 1
27.14 | ISO 7380 - M3 x 8 - 8C |  |  |  |  |  | 2
27.15 | ISO 7380 - M3 x 12 - 12C |  |  |  |  |  | 1
27.16 | ISO 7380 - M3 x 12 - 12C |  |  |  |  |  | 2
27.17 | NEMA17 |  |  |  |  |  | 1
27.18 | Bracket |  |  |  |  |  | 1
27.19 | Dystans |  |  |  |  |  | 6
28 | Filament sensor |  |  |  |  |  | 2
28.1 | Filament_Sensor_1.75m m.stp |  |  |  |  |  | 1
28.2 | Dystans |  |  |  |  |  | 2
29 | B18.6.7M - M3.5 x 0.6 x 25 Type I Cross Recessed PHMS --25N |  |  |  |  |  | 12
30 | B18.22M - Plain washer, 3.5 mm, regular |  |  |  |  |  | 12
31 | B18.2.4.1M - Hex nut, Style 1, M3.5 x 0.6 --D- N |  |  |  |  |  | 12
32 | Rod |  |  |  |  |  | 4
33 | B18.22M - Plain washer, 3 mm, regular |  |  |  |  |  | 8
34 | 1.75mm-filament- spool.step |  |  |  |  |  | 1
35 | Display |  |  |  |  |  | 1
35.1 | display | NOT SPECIFIED |  |  |  |  | 1
35.2 | Front frame |  |  |  |  |  | 1
35.3 | Spacer |  |  |  |  |  | 4
35.4 | Back plate |  |  |  |  |  | 1
35.5 | Spacer |  |  |  |  |  | 4
35.6 | B18.6.7M - M3 x 0.5 x 30 Type I Cross Recessed PHMS --30N |  |  |  |  |  | 4
35.7 | B18.6.7M - M2 x 0.4 x 20 Type I Cross Recessed PHMS --20N |  |  |  |  |  | 4
35.8 | Holding bracket |  |  |  |  |  | 1
36 | B18.6.7M - M5 x 0.8 x 20 Type I Cross Recessed PHMS --20N |  |  |  |  |  | 2
37 | B18.2.4.1M - Hex nut, Style 1, M5 x 0.8 --D-N |  |  |  |  |  | 2
38 | LED STRIP |  |  |  |  |  | 2
39 | Camera |  |  |  |  |  | 1
39.1 | Camera module |  |  |  |  |  | 1
39.2 | Spacer |  |  |  |  |  | 2
39.3 | Camera stand |  |  |  |  |  | 1
39.4 | B18.6.7M - M3 x 0.5 x 20 Type I Cross Recessed PHMS --20N |  |  |  |  |  | 2
39.5 | B18.2.4.1M - Hex nut, Style 1, M3 x 0.5 --D-N |  |  |  |  |  | 2
40 | B18.6.7M - M4 x 0.7 x 10 Type I Cross Recessed PHMS --10N |  |  |  |  |  | 4
41 | B18.2.4.1M - Hex nut, Style 1, M4 x 0.7 --D-N |  |  |  |  |  | 2
42 | angle bar |  |  |  |  |  | 1
