Fake-Oxygen/3D-PRINTER/MOTHERBOARD V2/Extension_Board/Project Outputs for Extension_Board/Extension_Board.xls

Sheet: BOM Report
 | Bill of Materials |  |  | Bill of Materials for Project [Extension_Board.PrjPcb] (No PCB Document Selected)
 | Source Data From: |  | Extension_Board.PrjPcb
 | Project: |  | Extension_Board.PrjPcb
 | Variant: |  | None
 | Creation Date: | 2/3/2023 | 9:15 PM
 | Print Date: | 2023-02-03 | 21:49:16
Name | Footprint | Comment | LibRef | Designator | Description | Pack | Cost/unit | Cost/quanity | Cost total | Quantity | Link
PTS645SM43SMTR92LFS | PB-6X6mm-Blue | RESET | SW PUSHBUTTON | B1 | SE PUSHBUTTON | 10 | PLN 1.39 | PLN 1.39 | PLN 13.90 | 1 | https://pl.farnell.com/c-k-components/pts645sm43smtr92lfs/switch-spst-0-05a-12vdc-smd-4/dp/2320087
CGA3E2X7R1H104K080AA | 0603 | Cap | Cap | C1, C2, C9, C11, C12, C13, C14, C15, C16, C17, C22, C23, C24, C26, C27, C28, C29 | Capacitor | 100 | PLN 0.18 | PLN 3.06 | PLN 18.00 | 17 | https://pl.farnell.com/tdk/cga3e2x7r1h104k080aa/cap-0-1-f-50v-10-x7r-0603/dp/2346967
C0603C105K8PACTU | 0603 | X5R | Cap | C3, C6, C21 | Capacitor | 100 | PLN 0.13 | PLN 0.39 | PLN 13.00 | 3 | https://pl.farnell.com/kemet/c0603c105k8pactu/cap-1-f-10v-10-x5r-0603/dp/9227776
CGA3E2X7R1H104K080AA | 0603 | X5R | Cap | C4, C7 | Capacitor | 100 | PLN 0.18 | PLN 0.36 | PLN 18.00 | 2 | https://pl.farnell.com/tdk/cga3e2x7r1h104k080aa/cap-0-1-f-50v-10-x7r-0603/dp/2346967
CC0603KRX7R8BB103 | 0603 | X7R | Cap | C5 | Capacitor | 100 | PLN 0.09 | PLN 0.09 | PLN 9.00 | 1 | https://pl.farnell.com/yageo/cc0603krx7r8bb103/cap-0-01-f-25v-10-x7r-0603/dp/3019561
0603N100D500CT | 0603 | Cap | Cap | C8, C10 | Capacitor | 100 | PLN 0.03 | PLN 0.06 | PLN 3.00 | 2 | https://pl.farnell.com/walsin/0603n100d500ct/cap-10pf-50v-c0g-np0-0603/dp/2496877
CC0603JRNPO9BN240 | 0603 | Cap | Cap | C18, C19 | Capacitor | 10 | PLN 0.19 | PLN 0.38 | PLN 1.90 | 2 | https://pl.farnell.com/yageo/cc0603jrnpo9bn240/cap-24pf-50v-mlcc-0603/dp/3764469
CC0603KRX7R9BB471 | 0603 | Cap | Cap | C20 | Capacitor | 10 | PLN 0.11 | PLN 0.11 | PLN 1.10 | 1 | https://pl.farnell.com/yageo/cc0603krx7r9bb471/cap-470pf-50v-10-x7r-0603/dp/722157
EEE1EA100SR | 5x5.4 | 10uF | Cap Pol1 | C25 | Polarized Capacitor (Radial) | 10 | PLN 1.25 | PLN 1.25 | PLN 12.50 | 1 | https://pl.farnell.com/panasonic/eee1ea100sr/cap-10-f-25v-radial-smd/dp/9696962
 | FH1234S05SH55 | FH12-34S-0.5SH_55_ | FH12-34S-0.5SH_55_ | CN1 | Connector |  |  | PLN 0.00 | PLN 0.00 | 1
 | PJS00820031 | PJS008-2003-1 | PJS008-2003-1 | CN2 | Connector |  |  | PLN 0.00 | PLN 0.00 | 1
 | HDR1X6 | Header 6 | Header 6 | CN3 | Header, 6-Pin |  |  | PLN 0.00 | PLN 0.00 | 1
 | HDR1X4 | Header 4 | Header 4 | CN4 | Header, 4-Pin |  |  | PLN 0.00 | PLN 0.00 | 1
 | FCI USB 10118193-0001LF | 10118193-0001LF | 10118193-0001LF | CN5 | CONN RCPT USB2.0 MICRO B SMD R/A |  |  | PLN 0.00 | PLN 0.00 | 1
 | ON SHORE TECHNOLOGY USB-A1HSW6 | USB-A1HSW6 | USB-A1HSW6 | CN6 | CONN RCPT TYPEA 4POS R/A |  |  | PLN 0.00 | PLN 0.00 | 1
 | HDR1X8 | Header 8 | Header 8 | CN7 | Header, 8-Pin |  |  | PLN 0.00 | PLN 0.00 | 1
 | RJ45_KRJ-CB4.2GYZNL | KRJ-CB4.2GYZNL | KRJ-CB4.2GYZNL | CN8 | 100 Base-TX (Fast Ethernet) SMD RJ45 single port (1x1) with LEDS Integrated Magnetics Connector |  |  | PLN 0.00 | PLN 0.00 | 1
 | TE 282834-2 | 282834-2 | 282834-2 | CN9 | TERM BLK 2P SIDE ENT 2.54MM PCB |  |  | PLN 0.00 | PLN 0.00 | 1
 | SMC | BAT60JFILM | Diode | D1, D2, D5 | Default Diode |  |  | PLN 0.00 | PLN 0.00 | 3
 | 3.5X2.8X1.9 | Green | LED3 | D3, D6 | Typical BLUE SiC LED |  |  | PLN 0.00 | PLN 0.00 | 2
 | 3.5X2.8X1.9 | Red | LED3 | D4 | Typical BLUE SiC LED |  |  | PLN 0.00 | PLN 0.00 | 1
 | 0603L | BEAD | Inductor | L1 | Inductor |  |  | PLN 0.00 | PLN 0.00 | 1
 | AXIAL-0.3 | Res1 | Res1 | R1, R2, R3, R4, R5, R6, R32 | Resistor |  |  | PLN 0.00 | PLN 0.00 | 7
 | AXIAL-0.3 | Res1 | Res1 | R7 | Resistor |  |  | PLN 0.00 | PLN 0.00 | 1
 | AXIAL-0.3 | Res1 | Res1 | R8, R13, R14 | Resistor |  |  | PLN 0.00 | PLN 0.00 | 3
 | AXIAL-0.3 | Res1 | Res1 | R9, R12, R30 | Resistor |  |  | PLN 0.00 | PLN 0.00 | 3
 | AXIAL-0.3 | Res1 | Res1 | R10, R11, R20, R27, R34, R35, R36, R37, R38, R41, R42, R43, R46, R51, R62 | Resistor |  |  | PLN 0.00 | PLN 0.00 | 15
 | AXIAL-0.3 | Res1 | Res1 | R15, R18, R26, R39, R40 | Resistor |  |  | PLN 0.00 | PLN 0.00 | 5
 | AXIAL-0.3 | Res1 | Res1 | R16, R17 | Resistor |  |  | PLN 0.00 | PLN 0.00 | 2
 | AXIAL-0.3 | Res1 | Res1 | R19, R21, R22, R23, R24, R25 | Resistor |  |  | PLN 0.00 | PLN 0.00 | 6
 | AXIAL-0.3 | Res1 | Res1 | R28 | Resistor |  |  | PLN 0.00 | PLN 0.00 | 1
 | AXIAL-0.3 | Res1 | Res1 | R29, R49 | Resistor |  |  | PLN 0.00 | PLN 0.00 | 2
 | AXIAL-0.3 | Res1 | Res1 | R31 | Resistor |  |  | PLN 0.00 | PLN 0.00 | 1
 | AXIAL-0.3 | Res1 | Res1 | R33 | Resistor |  |  | PLN 0.00 | PLN 0.00 | 1
 | AXIAL-0.3 | Res1 | Res1 | R44, R45, R47, R48, R50 | Resistor |  |  |  | PLN 0.00 | 5
 | AXIAL-0.3 | Res1 | Res1 | R52 | Resistor |  |  |  | PLN 0.00 | 1
 | AXIAL-0.3 | Res1 | Res1 | R53, R54, R55, R56 | Resistor |  |  |  | PLN 0.00 | 4
 | AXIAL-0.3 | Res1 | Res1 | R57, R58, R59, R60 | Resistor |  |  |  | PLN 0.00 | 4
 | AXIAL-0.3 | Res1 | Res1 | R61, R63 | Resistor |  |  |  | PLN 0.00 | 2
 | SB_0603 | Closed | Circuit Breaker | SB1, SB12 | Circuit Breaker |  |  |  | PLN 0.00 | 2
 | SPST-2 | Open | Circuit Breaker | SB2 | Circuit Breaker |  |  |  | PLN 0.00 | 1
 | SPST-2 | Closed | Circuit Breaker | SB3, SB4, SB5, SB6, SB7, SB8, SB9 | Circuit Breaker |  |  |  | PLN 0.00 | 7
 | SB_0603 | Open | Circuit Breaker | SB10, SB11 | Circuit Breaker |  |  |  | PLN 0.00 | 2
 | TO-226-AA | 9013 | NPN | T1, T2 | NPN Bipolar Transistor |  |  |  | PLN 0.00 | 2
 | QFP50P900X900X160-48N | STM32F103CBT6 | STM32F103CBT6 | U1 | Integrated Circuit |  |  |  | PLN 0.00 | 1
 | SOT95P280X145-6N | USBLC6-2SC6 | USBLC6-2SC6 | U2, U4 | Integrated Circuit |  |  |  | PLN 0.00 | 2
 | SOT95P280X145-5N | LD3985M33R | LD3985M33R | U3 | Integrated Circuit |  |  |  |  | 1
 | ESP12S | ESP-12S | ESP-12S | U5 | Integrated Circuit |  |  |  |  | 1
 | Transformer | KMS-1102NL | KMS-1102NL | U6 |  |  |  |  |  | 1
 | SOT95P280X145-6N | USBLC6-4SC6 | USBLC6-4SC6 | U7 | Integrated Circuit |  |  |  |  | 1
 | QFN24_0R5_4X4 | LAN8742A-CZ-TR | LAN8742A-CZ-TR | U8 | LAN8742A-CZ-TR - Small Footprint RMII 10/100 Ethernet, Transceiver with HP Auto-MDIX and flexPWR Technology SQFN-24 |  |  |  |  | 1
 | RAD-0.2 | Open | Jumper | W1 | Jumper Wire |  |  |  |  | 1
 | R38 | NX3225GD-8.00M | XTAL | X1 | Crystal Oscillator |  |  |  |  | 1
 | R38 | X53T-C20SSA-25.000MHz | XTAL | X2 | Crystal Oscillator |  |  |  |  | 1
 |  |  |  |  |  |  |  |  |  | 134
 | Approved |  | Notes

Sheet: Project Information
Project Full Path | C:\Users\Morroway\Documents\.A\Projects\3D-PRINTER\MOTHERBOARD V2\Extension_Board\Extension_Board.PrjPcb
Project Filename | Extension_Board.PrjPcb
Variant Name | None
Data-Source Filename | Extension_Board.PrjPcb
Data-Source Full Path | C:\Users\Morroway\Documents\.A\Projects\3D-PRINTER\MOTHERBOARD V2\Extension_Board\Extension_Board.PrjPcb
Title | Bill of Materials for Project [Extension_Board.PrjPcb] (No PCB Document Selected)
Total Quantity | 134
Report Time | 9:15 PM
Report Date | 2/3/2023
Report Date & Tine | 2/3/2023 9:15 PM
Output Name | Bill of Materials
Output Type | BOM_PartType
Output Generator Name | BOM
Output Generator Description | Bill of Materials
