Fake-Oxygen/3D-PRINTER/MOTHERBOARD V2/Motherboard/Project Outputs for Motherboard/Motherboard.xls

Sheet: BOM Report
Bill of Materials |  |  | Bill of Materials for Project [Motherboard.PrjPcb] (No PCB Document Selected)
Source Data From: |  | Motherboard.PrjPcb
Project: |  | Motherboard.PrjPcb
Variant: |  | None
Creation Date: | 2/3/2023 | 8:51 PM
Print Date: | 2023-02-03 | 20:52:00
Footprint | Comment | LibRef | Designator | Description | Quantity
RAD-0.3 | X5R | Cap | C1, C2, C3, C4, C5, C6, C7, C8, C9, C10, C11, C12, C13, C14, C15, C16, C17, C18, C22, C24, C25, C26, C27, C28, C29, C30, C33, C34, C35, C48_E0_AXIS, C48_E1_AXIS, C48_X_AXIS, C48_Y_AXIS, C48_Z_AXIS, C49_E0_AXIS, C49_E1_AXIS, C49_X_AXIS, C49_Y_AXIS, C49_Z_AXIS, C50_E0_AXIS, C50_E1_AXIS, C50_X_AXIS, C50_Y_AXIS, C50_Z_AXIS, C51_E0_AXIS, C51_E1_AXIS, C51_X_AXIS, C51_Y_AXIS, C51_Z_AXIS, C52_E0_AXIS, C52_E1_AXIS, C52_X_AXIS, C52_Y_AXIS, C52_Z_AXIS, C53_E0_AXIS, C53_E1_AXIS, C53_X_AXIS, C53_Y_AXIS, C53_Z_AXIS, C54_E0_AXIS, C54_E1_AXIS, C54_X_AXIS, C54_Y_AXIS, C54_Z_AXIS, C55_E0_AXIS, C55_E1_AXIS, C55_X_AXIS, C55_Y_AXIS, C55_Z_AXIS, C57_E0_AXIS, C57_E1_AXIS, C57_X_AXIS, C57_Y_AXIS, C57_Z_AXIS, C58_E0_AXIS, C58_E1_AXIS, C58_X_AXIS, C58_Y_AXIS, C58_Z_AXIS, C59_E0_AXIS, C59_E1_AXIS, C59_X_AXIS, C59_Y_AXIS, C59_Z_AXIS, C60_E0_AXIS, C60_E1_AXIS, C60_X_AXIS, C60_Y_AXIS, C60_Z_AXIS, C61 | Capacitor | 90
TAN-B | 4u7 | Cap Pol1 | C19, C20, C44 | Polarized Capacitor (Radial) | 3
TAN-B | 1uF | Cap Pol1 | C21, C23 | Polarized Capacitor (Radial) | 2
TAN-B | 100uF | Cap Pol1 | C30, C31, C32, C47_HOTBED, C47_HOTEND0, C47_HOTEND0_FAN, C47_HOTEND1, C47_HOTEND1_FAN, C47_NOZZLE_FAN | Polarized Capacitor (Radial) | 9
RAD-0.3 | X7R | Cap | C36, C37, C38, C39, C40, C41, C42, C43 | Capacitor | 8
TAN-B | 10uF | Cap Pol1 | C45, C46 | Polarized Capacitor (Radial) | 2
TAN-B | 100u | Cap Pol1 | C56_E0_AXIS, C56_E1_AXIS, C56_X_AXIS, C56_Y_AXIS, C56_Z_AXIS | Polarized Capacitor (Radial) | 5
JST XH B6B-XH-A | X_AXIS | B6B-XH-A(LF)(SN) | CN1 | CONN HEADER VERT 6POS 2.5MM | 1
JST XH B6B-XH-A | Y_AXIS | B6B-XH-A(LF)(SN) | CN2 | CONN HEADER VERT 6POS 2.5MM | 1
JST XH B6B-XH-A | Z0_AXIS | B6B-XH-A(LF)(SN) | CN3 | CONN HEADER VERT 6POS 2.5MM | 1
JST XH B6B-XH-A | Z1_AXIS | B6B-XH-A(LF)(SN) | CN4 | CONN HEADER VERT 6POS 2.5MM | 1
JST XH B6B-XH-A | E0_AXIS | B6B-XH-A(LF)(SN) | CN5 | CONN HEADER VERT 6POS 2.5MM | 1
JST XH B6B-XH-A | E1_AXIS | B6B-XH-A(LF)(SN) | CN6 | CONN HEADER VERT 6POS 2.5MM | 1
TE 282834-2 | 282834-2 | 282834-2 | CN7, CN8, CN9 | TERM BLK 2P SIDE ENT 2.54MM PCB | 3
JST XH B2B-XH-A | B2B-XH-A(LF)(SN) | B2B-XH-A(LF)(SN) | CN10, CN11, CN12 | CONN HEADER VERT 2POS 2.5MM | 3
TE 282834-6 | 282834-6 | 282834-6 | CN13 | TERM BLK 6P SIDE ENT 2.54MM PCB | 1
FH12-20S-0.5SH(55) | FH12-20S-0.5SH_55_ | FH12-20S-0.5SH_55_ | CN14 | Connector | 1
FH1240S05SH55 | FH12-40S-0.5SH_55_ | FH12-40S-0.5SH_55_ | CN15 | Connector | 1
JST XH B3B-XH-A | B3B-XH-A(LF)(SN) | B3B-XH-A(LF)(SN) | CN15, CN16 | CONN HEADER VERT 3POS 2.5MM | 2
JST B5B-PH-K | B5B-PH-K-S(LF)(SN) | B5B-PH-K-S(LF)(SN) | CN17 | CONN HEADER VERT 5POS 2MM | 1
FH1234S05SH55 | FH12-34S-0.5SH_55_ | FH12-34S-0.5SH_55_ | CN18 | Connector | 1
JST B2B-PH-K | B2B-PH-K-S(LF)(SN) | B2B-PH-K-S(LF)(SN) | CN19, CN20, CN21 | CONN HEADER VERT 2POS 2MM | 3
Broadcom 4-PLLC 3228 | GREEN | ASMT-QABD-AEF0E | D1, D2 | LED INDICATOR 0.5W AMBER 4PLCC | 2
DIODE-0.7 | 15V | D Zener | D3_HOTBED, D3_HOTEND0, D3_HOTEND0_FAN, D3_HOTEND1, D3_HOTEND1_FAN, D3_NOZZLE_FAN | Zener Diode | 6
Broadcom 4-PLLC 3228 | RED | ASMT-QABD-AEF0E | D4_HOTBED, D4_HOTEND0, D4_HOTEND0_FAN, D4_HOTEND1, D4_HOTEND1_FAN, D4_NOZZLE_FAN | LED INDICATOR 0.5W AMBER 4PLCC | 6
SOT-23_N | Diode BAT17 | Diode BAT17 | D5_E0_AXIS, D5_E1_AXIS, D5_X_AXIS, D5_Y_AXIS, D5_Z_AXIS | Silicon RF Schottky Diode for Mixer Applications in the VHF/UHF Range | 5
0603L | FCM1608KF-601T03 | Inductor | L1 | Inductor | 1
PUI Audio SMT-0827-S-2-R | SMT-0827-S-2-R | SMT-0827-S-2-R | LS1 | AUDIO MAGNETIC XDCR 2.5-4.5V SMD | 1
ON SEMICONDUCTOR SC-75 | MMBT3904 | MMBT3904TT1G | Q1, Q2_HOTBED, Q2_HOTEND0, Q2_HOTEND0_FAN, Q2_HOTEND1, Q2_HOTEND1_FAN, Q2_NOZZLE_FAN, Q3_HOTBED, Q3_HOTEND0, Q3_HOTEND0_FAN, Q3_HOTEND1, Q3_HOTEND1_FAN, Q3_NOZZLE_FAN | TRANS NPN 40V 0.2A SOT416 | 13
TO-92A | MMBT3906 | 2N3906 | Q4_HOTBED, Q4_HOTEND0, Q4_HOTEND0_FAN, Q4_HOTEND1, Q4_HOTEND1_FAN, Q4_NOZZLE_FAN | PNP General Purpose Amplifier | 6
E3 | IRLR7843PbF | MOSFET-N | Q5_HOTBED, Q5_HOTEND0, Q5_HOTEND0_FAN, Q5_HOTEND1, Q5_HOTEND1_FAN, Q5_NOZZLE_FAN | N-Channel MOSFET | 6
AXIAL-0.3 | Res1 | Res1 | R1, R2, R3, R4, R5, R6, R7, R8, R9, R10, R11, R12, R13, R14, R15, R16, R17, R18_HOTBED, R18_HOTEND0, R18_HOTEND0_FAN, R18_HOTEND1, R18_HOTEND1_FAN, R18_NOZZLE_FAN, R19_HOTBED, R19_HOTEND0, R19_HOTEND0_FAN, R19_HOTEND1, R19_HOTEND1_FAN, R19_NOZZLE_FAN, R20_HOTBED, R20_HOTEND0, R20_HOTEND0_FAN, R20_HOTEND1, R20_HOTEND1_FAN, R20_NOZZLE_FAN, R21_HOTBED, R21_HOTEND0, R21_HOTEND0_FAN, R21_HOTEND1, R21_HOTEND1_FAN, R21_NOZZLE_FAN, R22_HOTBED, R22_HOTEND0, R22_HOTEND0_FAN, R22_HOTEND1, R22_HOTEND1_FAN, R22_NOZZLE_FAN, R23_HOTBED, R23_HOTEND0, R23_HOTEND0_FAN, R23_HOTEND1, R23_HOTEND1_FAN, R23_NOZZLE_FAN, R24_HOTBED, R24_HOTEND0, R24_HOTEND0_FAN, R24_HOTEND1, R24_HOTEND1_FAN, R24_NOZZLE_FAN, R25_HOTBED, R25_HOTEND0, R25_HOTEND0_FAN, R25_HOTEND1, R25_HOTEND1_FAN, R25_NOZZLE_FAN, R26_HOTBED, R26_HOTEND0, R26_HOTEND0_FAN, R26_HOTEND1, R26_HOTEND1_FAN, R26_NOZZLE_FAN, R27_HOTBED, R27_HOTEND0, R27_HOTEND0_FAN, R27_HOTEND1, R27_HOTEND1_FAN, R27_NOZZLE_FAN, R28_E0_AXIS, R28_E1_AXIS, R28_X_AXIS, R28_Y_AXIS, R28_Z_AXIS, R29_E0_AXIS, R29_E1_AXIS, R29_X_AXIS, R29_Y_AXIS, R29_Z_AXIS, R30_E0_AXIS, R30_E1_AXIS, R30_X_AXIS, R30_Y_AXIS, R30_Z_AXIS, R31_E0_AXIS, R31_E1_AXIS, R31_X_AXIS, R31_Y_AXIS, R31_Z_AXIS, R32_E0_AXIS, R32_E1_AXIS, R32_X_AXIS, R32_Y_AXIS, R32_Z_AXIS, R33_E0_AXIS, R33_E1_AXIS, R33_X_AXIS, R33_Y_AXIS, R33_Z_AXIS, R34_E0_AXIS, R34_E1_AXIS, R34_X_AXIS, R34_Y_AXIS, R34_Z_AXIS, R35, R36, R37 | Resistor | 115
QFP50P3000X3000X160-208N | STM32F746BGT6 | STM32F746BGT6 | U1 | Integrated Circuit | 1
SOP80P1176X120-54N | IS42S16160G-6TL | IS42S16160G-6TL | U2 | Integrated Circuit | 1
SON127P600X500X80-9N-D | MX25L25645GZNI-08G | MX25L25645GZNI-08G | U3 | Integrated Circuit | 1
QFN50P500X500X90-29N-D | TMC2208-LA-T | TMC2208-LA-T | U4_E0_AXIS, U4_E1_AXIS, U4_X_AXIS, U4_Y_AXIS, U4_Z_AXIS | Integrated Circuit | 5
SOP65P640X110-16N | NX3L4051PW,118 | NX3L4051PW,118 | U5 | Integrated Circuit | 1
OSC_2SM_3R2x2R5 | 32.768kHz | XTAL | X1 | Crystal Oscillator | 1
OSC_2SM_3R2x2R5 | 25Mhz | XTAL | X2 | Crystal Oscillator | 1
 |  |  |  |  | 313
Approved |  | Notes

Sheet: Project Information
Project Full Path | C:\Users\Morroway\Documents\.A\Projects\3D-PRINTER\MOTHERBOARD V2\Motherboard\Motherboard.PrjPcb
Project Filename | Motherboard.PrjPcb
Variant Name | None
Data-Source Filename | Motherboard.PrjPcb
Data-Source Full Path | C:\Users\Morroway\Documents\.A\Projects\3D-PRINTER\MOTHERBOARD V2\Motherboard\Motherboard.PrjPcb
Title | Bill of Materials for Project [Motherboard.PrjPcb] (No PCB Document Selected)
Total Quantity | 313
Report Time | 8:51 PM
Report Date | 2/3/2023
Report Date & Tine | 2/3/2023 8:51 PM
Output Name | Bill of Materials
Output Type | BOM_PartType
Output Generator Name | BOM
Output Generator Description | Bill of Materials
