Fake-Oxygen/3D-PRINTER/MOTHERBOARD V2/Power Driver/Zeszyt1.xlsx

Object Kind | Layer | X1 (mil) | Y1 (mil) | Height (mil) | Locked | Designator | Show Designator | Component Comment | Show Comment | Lock Strings | Component Type | Footprint | Channel Offset | Rotation | Lock Primitives | Enable Pin Swapping | Enable Part Swapping | Hide Jumpers | Area
Component | Top Layer | 4650 | 3700.512 | 0 | False | U1 | True | TMC2208-LA-T | False | False | Standard | QFN50P500X500X90-29N-D | 97 | 0 | True | False | False | False | 0.056 sq.inch
Component | Top Layer | 4780 | 3495 | 17.716 | False | R11 | True | 22k | False | False | Standard | RES 0603_1608 | 80 | 180 | True | False | False | False | 0.006 sq.inch
Component | Top Layer | 4685 | 3470 | 17.716 | False | R10 | True | 20k | False | False | Standard | RES 0603_1608 | 79 | 90 | True | False | False | False | 0.006 sq.inch
Component | Top Layer | 4430 | 3740 | 17.716 | False | R7 | True | 20k | False | False | Standard | RES 0603_1608 | 76 | 180 | True | False | False | False | 0.006 sq.inch
Component | Top Layer | 4690 | 3970.433 | 17.716 | False | R2 | True | 0R15 | False | False | Standard | STACKPOLE CSR0603 | 71 | 90 | True | False | False | False | 0.008 sq.inch
Component | Top Layer | 4610 | 3970.433 | 17.716 | False | R1 | True | 0R15 | False | False | Standard | STACKPOLE CSR0603 | 70 | 90 | True | False | False | False | 0.008 sq.inch
Component | Top Layer | 4580 | 3468.425 | 35.039 | False | C26 | True | 4.7µF | False | False | Standard | CAP 0603_1608 | 25 | 90 | True | False | False | False | 0.007 sq.inch
Component | Top Layer | 14750 | 3910 | 35.039 | False | C21 | True | 0.1 µF | False | False | Standard | CAP 0603_1608 | 20 | 0 | True | False | False | False | 0.007 sq.inch
Component | Top Layer | 4385 | 3643.425 | 35.039 | False | C19 | True | 0.1 µF | False | False | Standard | CAP 0603_1608 | 18 | 270 | True | False | False | False | 0.007 sq.inch
Component | Top Layer | 4455 | 3643.425 | 35.039 | False | C16 | True | 22n | False | False | Standard | CAP 0603_1608 | 15 | 270 | True | False | False | False | 0.007 sq.inch
Component | Top Layer | 4760 | 3968.425 | 35.039 | False | C8 | True | 0.1 µF | False | False | Standard | CAP 0603_1608 | 7 | 90 | True | False | False | False | 0.007 sq.inch
Component | Top Layer | 4540 | 3970 | 35.039 | False | C7 | True | 0.1 µF | False | False | Standard | CAP 0603_1608 | 6 | 90 | True | False | False | False | 0.007 sq.inch
Component | Top Layer | 4420 | 3885 | 35.039 | False | C4 | True | 0.1 µF | False | False | Standard | CAP 0603_1608 | 3 | 0 | True | False | False | False | 0.007 sq.inch
Component | Top Layer | 4880 | 3885 | 35.039 | False | C3 | True | 0.1 µF | False | False | Standard | CAP 0603_1608 | 2 | 180 | True | False | False | False | 0.007 sq.inch
Component | Top Layer | 4880 | 3960 | 35.039 | False | C1 | True | 1µF | False | False | Standard | CAP 0603_1608 | 0 | 180 | True | False | False | False | 0.007 sq.inch
 |  |  |  |  |  |  |  |  |  |  | 4755 | 3953.425
 |  |  |  |  |  |  |  |  |  |  | 4535 | 3955
Object Kind | String Type | Layer | Component | X1 (mil) | Y1 (mil) | Locked | Hide | Rotation | String | Text Height (mil) | Text Width (mil) | Stroke Font | Autoposition | Mirror | TrueType Font Name | Bold | Italic | Inverted | Inverted Border Width (mil) | Bounding Rectangle Width (mil) | Bounding Rectangle Height (mil) | Text Justification | Inverted Text Offset (mil) | Text Kind | BarCode Full Width (mil) | BarCode Full Height (mil) | BarCode X Margin (mil) | BarCode Y Margin (mil) | BarCode Min Width (mil) | BarCode Type | BarCode Render Mode | BarCode Inverted | BarCode Text Font Name | BarCode Show Text | Border Space Type
Text | Designator | TopOverlay | U1 | 4534.997 | 3853.998 | False | False | 0 | U1 | 12 | 2 | Default | Left-Above | False | Arial | False | False | False | 0 | 0 | 0 | Center | 0 | Stroke Font | 1050 | 210 | 20 | 20 | 0 | Code 39 | By BarCode Full Width | True | Arial | True | Border Margin
Text | Designator | TopOverlay | R11 | 4740.996 | 3553.998 | False | False | 0 | R11 | 12 | 2 | Default | Left-Above | False | Arial | False | False | False | 0 | 0 | 0 | Center | 0 | Stroke Font | 1050 | 210 | 20 | 20 | 0 | Code 39 | By BarCode Full Width | True | Arial | True | Border Margin
Text | Designator | TopOverlay | R10 | 4670.995 | 3551.998 | False | False | 0 | R10 | 12 | 2 | Default | Left-Above | False | Arial | False | False | False | 0 | 0 | 0 | Center | 0 | Stroke Font | 1050 | 210 | 20 | 20 | 0 | Code 39 | By BarCode Full Width | True | Arial | True | Border Margin
Text | Designator | TopOverlay | R7 | 4387.997 | 3798.998 | False | False | 0 | R7 | 12 | 2 | Default | Left-Above | False | Arial | False | False | False | 0 | 0 | 0 | Center | 0 | Stroke Font | 1050 | 210 | 20 | 20 | 0 | Code 39 | By BarCode Full Width | True | Arial | True | Border Margin
Text | Designator | TopOverlay | R2 | 4670.997 | 4065.998 | False | False | 0 | R2 | 12 | 2 | Default | Left-Above | False | Arial | False | False | False | 0 | 0 | 0 | Center | 0 | Stroke Font | 1050 | 210 | 20 | 20 | 0 | Code 39 | By BarCode Full Width | True | Arial | True | Border Margin
Text | Designator | TopOverlay | R1 | 4588.997 | 4065.998 | False | False | 0 | R1 | 12 | 2 | Default | Left-Above | False | Arial | False | False | False | 0 | 0 | 0 | Center | 0 | Stroke Font | 1050 | 210 | 20 | 20 | 0 | Code 39 | By BarCode Full Width | True | Arial | True | Border Margin
Text | Designator | TopOverlay | C26 | 4566.995 | 3553.998 | False | False | 0 | C26 | 12 | 2 | Default | Left-Above | False | Arial | False | False | False | 0 | 0 | 0 | Center | 0 | Stroke Font | 1050 | 210 | 20 | 20 | 0 | Code 39 | By BarCode Full Width | True | Arial | True | Border Margin
Text | Designator | TopOverlay | C19 | 4350 | 3720 | False | False | 0 | C19 | 12 | 2 | Default | Manual | False | Arial | False | False | False | 0 | 0 | 0 | Center | 0 | Stroke Font | 1050 | 210 | 20 | 20 | 0 | Code 39 | By BarCode Full Width | True | Arial | True | Border Margin
Text | Designator | TopOverlay | C16 | 4505 | 3710 | False | False | 0 | C16 | 12 | 2 | Default | Manual | False | Arial | False | False | False | 0 | 0 | 0 | Center | 0 | Stroke Font | 1050 | 210 | 20 | 20 | 0 | Code 39 | By BarCode Full Width | True | Arial | True | Border Margin
Text | Designator | TopOverlay | C8 | 4740.997 | 4053.998 | False | False | 0 | C8 | 12 | 2 | Default | Left-Above | False | Arial | False | False | False | 0 | 0 | 0 | Center | 0 | Stroke Font | 1050 | 210 | 20 | 20 | 0 | Code 39 | By BarCode Full Width | True | Arial | True | Border Margin
Text | Designator | TopOverlay | C7 | 4520.997 | 4055.998 | False | False | 0 | C7 | 12 | 2 | Default | Left-Above | False | Arial | False | False | False | 0 | 0 | 0 | Center | 0 | Stroke Font | 1050 | 210 | 20 | 20 | 0 | Code 39 | By BarCode Full Width | True | Arial | True | Border Margin
Text | Designator | TopOverlay | C4 | 4373.997 | 3943.998 | False | False | 0 | C4 | 12 | 2 | Default | Left-Above | False | Arial | False | False | False | 0 | 0 | 0 | Center | 0 | Stroke Font | 1050 | 210 | 20 | 20 | 0 | Code 39 | By BarCode Full Width | True | Arial | True | Border Margin
Text | Designator | TopOverlay | C3 | 4805 | 3885 | False | False | 0 | C3 | 12 | 2 | Default | Manual | False | Arial | False | False | False | 0 | 0 | 0 | Center | 0 | Stroke Font | 1050 | 210 | 20 | 20 | 0 | Code 39 | By BarCode Full Width | True | Arial | True | Border Margin
Text | Designator | TopOverlay | C1 | 4831.997 | 4018.998 | False | False | 0 | C1 | 12 | 2 | Default | Left-Above | False | Arial | False | False | False | 0 | 0 | 0 | Center | 0 | Stroke Font | 1050 | 210 | 20 | 20 | 0 | Code 39 | By BarCode Full Width | True | Arial | True | Border Margin
