Fake-Oxygen/3D-PRINTER/SOLIDWORKS/Złożenie1.SLDASM

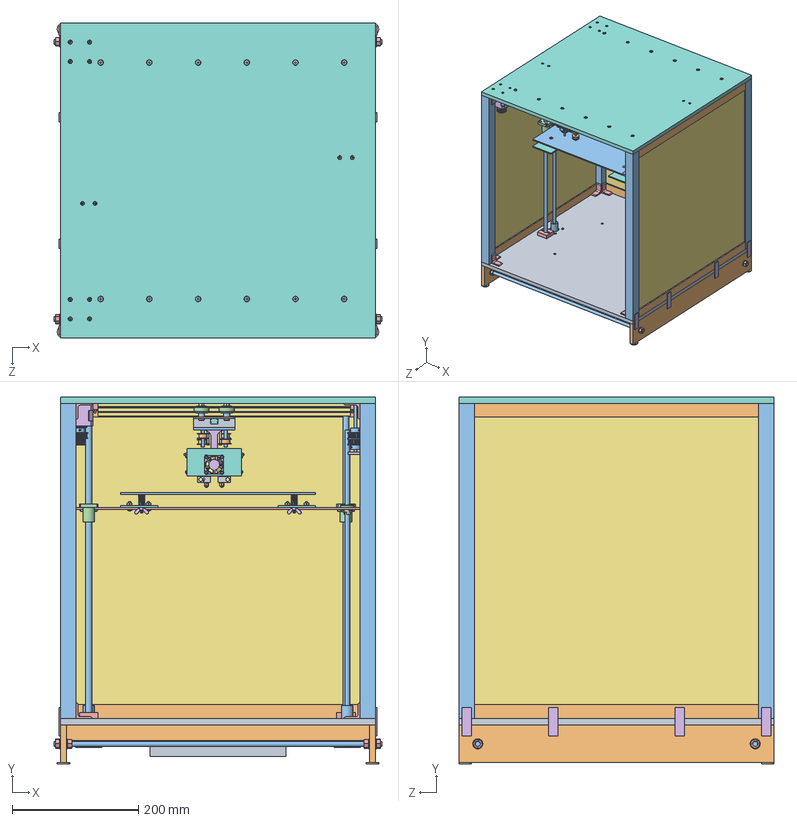
[picture p28: CAD file, 2022-10-26]
SOLIDWORKS/Złożenie1.SLDASM
520.0 x 582.0 x 500.0 mm
Bottom-Top Plate
Side Plate Bottom x 2
Rod x 16
Kopia Bolt Washer x 8
Kopia Nut x 8
NEMA17 x 4
Felt pad x 4
Podkładka pod NEMA17 x 4
cross recessed ctsk wood screws gb x 14
Bottom Plate Support Bar x 2
Stepper Motor Clutch x 2
Lead Screw M8 x 2
Middle Y Carriage Plate
pan cross head_ai x 16
machine screw nut hex_ai x 16
Left Y Carriage Plate x 2
flat washer type a narrow_ai x 8
Side Plate Top x 6
Pillar x 4
socket head cap screw_am x 5
equal angle (new zealand) as-nzs x 16
Reinforcement x 8
Plexi Panel x 2
Top Plate
Zasilacz WIP
flat head screw_am x 20
Hot Bed
Spring M4 x 4
Screw M4 x 4
Wing nut M4 x 4
Aluminium panel x 2
Aluminium panel connector x 12
socket countersunk head screw_am x 12
Carriage for V Slot x 2
Spacer M5 6mm x 8
Tire for 625ZZ bearing x 8
Bearing x 24
slotted pan head screw_iso x 8
hex nut style 1_am x 50
MGNxx rail
pan cross head_am x 22
flat washer narrow_am x 2
36 Teeth GT2 gear x 6
socket set screw flat point_am2 x 10
MGNxx block
Head Holder
HeatEnd Cooler block x 2
Throat tube x 2
Heating Block x 2
Nozzle 0.4mm x 2
PTFE tube connector x 2
flat washer regular_am x 8
Header fan holder x 2
Fan Housing x 3
Fan Propeller x 3
Side Header Cover
Bearing Holder x 2
idle pulley x 4
Bearing holder cover x 2
LMK Bearing x 2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
