Fake-Oxygen/3D-PRINTER/SOLIDWORKS/ASSEMBLY/Titan Aero from Aliexpress for GC/Main Gear.SLDPRT

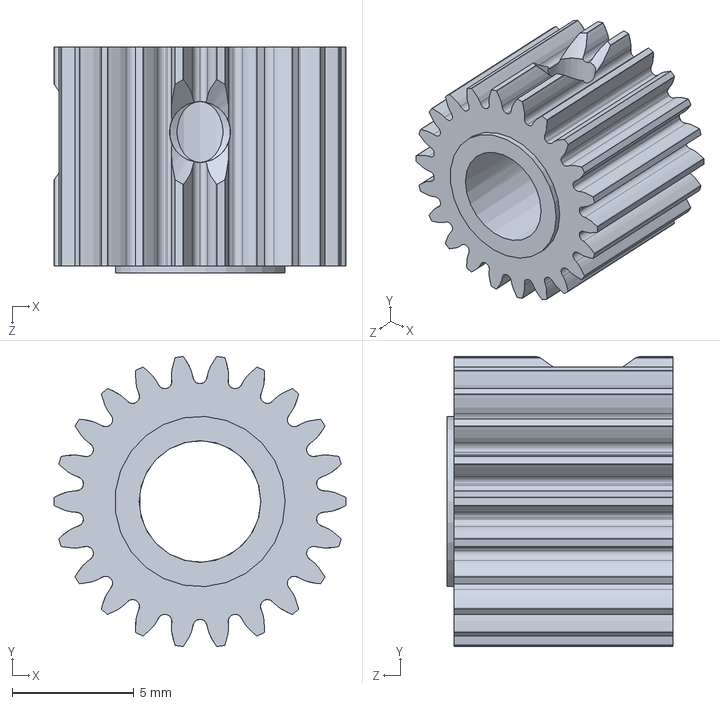
[picture p29: CAD file, 2023-02-11]
SOLIDWORKS/ASSEMBLY/Titan Aero from Aliexpress for GC/Main Gear.SLDPRT
12.0 x 11.9 x 9.30 mm
