Fake-Oxygen/3D-PRINTER/MOTHERBOARD V2/D-PACK.stp

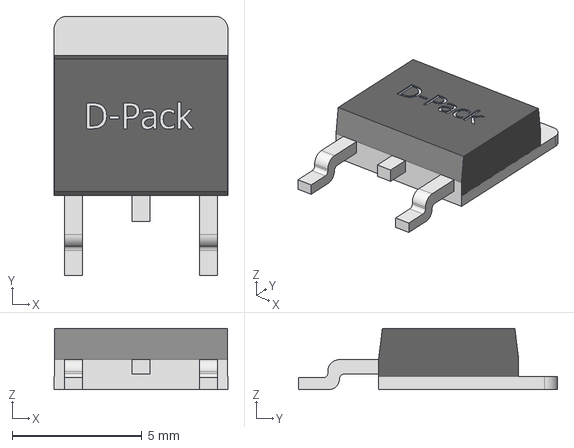
[picture p30: CAD file, 2023-06-17]
MOTHERBOARD V2/D-PACK.stp
6.70 x 9.99 x 2.35 mm
