Fake-Oxygen/3D-PRINTER/MOTHERBOARD V2/Power Driver/PCB1.step

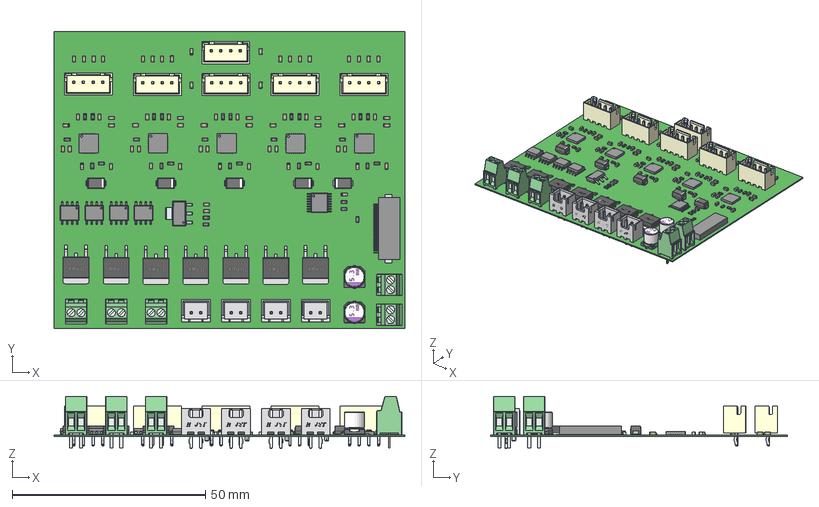
[picture p31: CAD file, 2023-06-17]
MOTHERBOARD V2/Power Driver/PCB1.step
90.8 x 76.8 x 13.5 mm
PinsArrayLR x 10
PinsArrayL
FilletPinR
ThermalPin x 5
PinsArrayTB x 5
0603 resistor x 20
Stackpole CSR0603 Res x 10
SMA x 5
Pins
B4B-XH-A(LF)(SN) - BODY x 6
B4B-XH-A(LF)(SN) - PIN x 6
c-282834-2-c-3d x 5
CAP ALSMD - POLY - 5.3 x 5.3 x 6.0 x 2
0603 cap x 68
D-PACK x 7
