Fake-Oxygen/3D-PRINTER/SOLIDWORKS/GENERAL/4.3inch Capacitive Touch LCD 3D Drawing/Front frame.SLDPRT

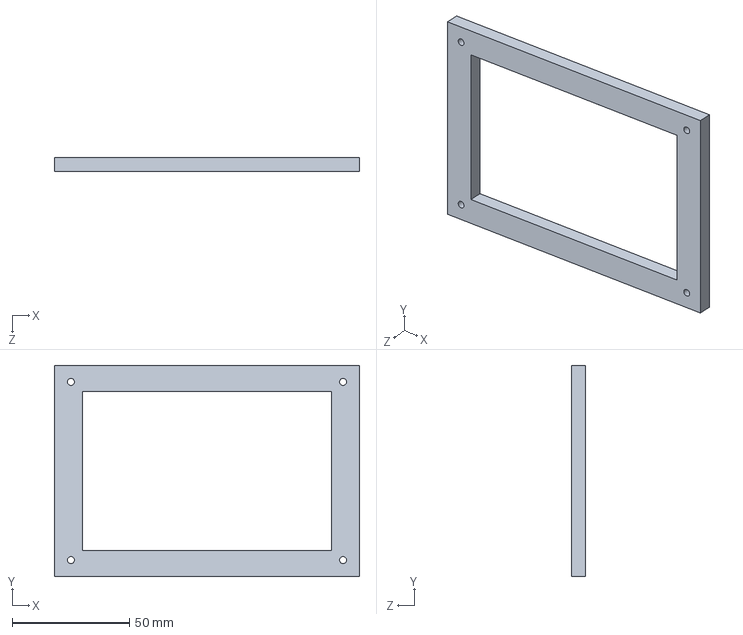
[picture p32: CAD file, 2023-10-18]
SOLIDWORKS/GENERAL/4.3inch Capacitive Touch LCD 3D Drawing/Front frame.SLDPRT
130.0 x 90.0 x 6.00 mm
