Fake-Oxygen/3D-PRINTER/SOLIDWORKS/GENERAL/camera/Camera stand.SLDPRT

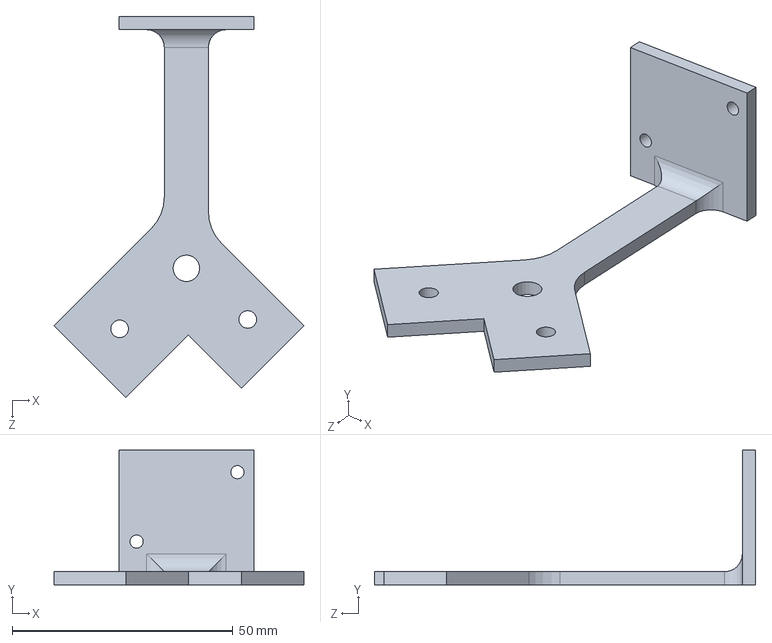
[picture p33: CAD file, 2023-10-18]
SOLIDWORKS/GENERAL/camera/Camera stand.SLDPRT
56.6 x 30.5 x 86.3 mm
