Fake-Oxygen/3D-PRINTER/SOLIDWORKS/GENERAL/LMK_seri/LMK30.SLDPRT

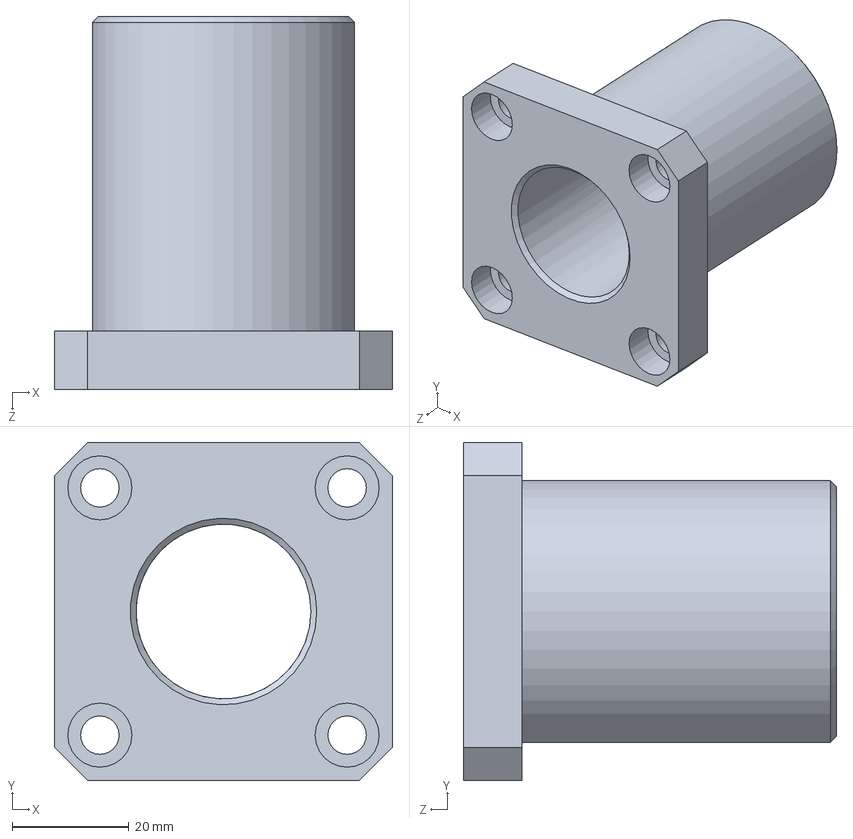
[picture p34: CAD file, 2023-01-27]
SOLIDWORKS/GENERAL/LMK_seri/LMK30.SLDPRT
58.0 x 58.0 x 64.0 mm
