Fake-Oxygen/3D-PRINTER/SOLIDWORKS/GENERAL/Radial Cooling Fan 50mm DC12V/top.SLDPRT

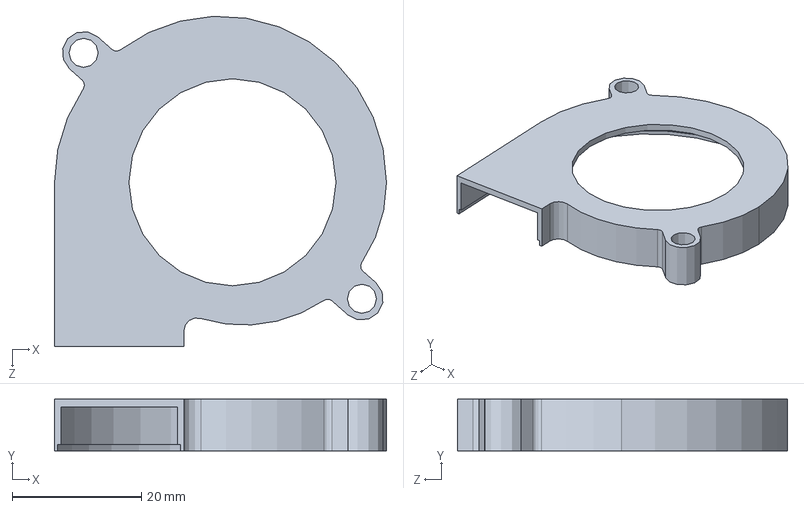
[picture p35: CAD file, 2023-08-07]
SOLIDWORKS/GENERAL/Radial Cooling Fan 50mm DC12V/top.SLDPRT
51.3 x 8.00 x 51.0 mm
