Fake-Oxygen/3D-PRINTER/SOLIDWORKS/SPECIFIC/Head Holder v2.SLDPRT

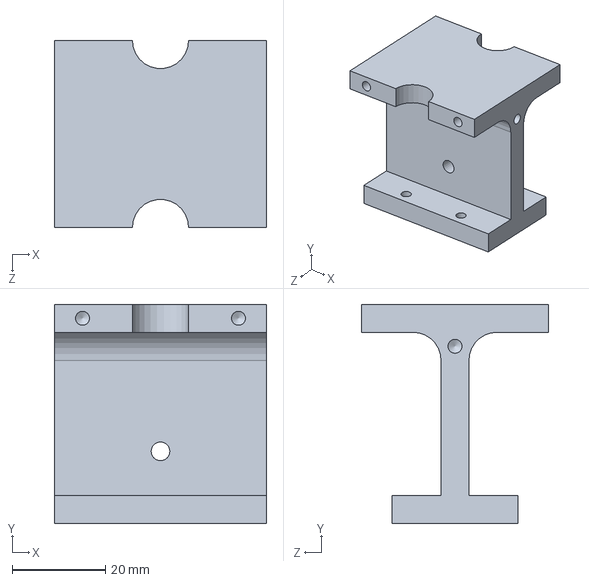
[picture p36: CAD file, 2023-10-18]
SOLIDWORKS/SPECIFIC/Head Holder v2.SLDPRT
45.4 x 47.0 x 40.0 mm
