Fake-Oxygen/3D-PRINTER/SOLIDWORKS/STL/Bearing holder Z axis.STL

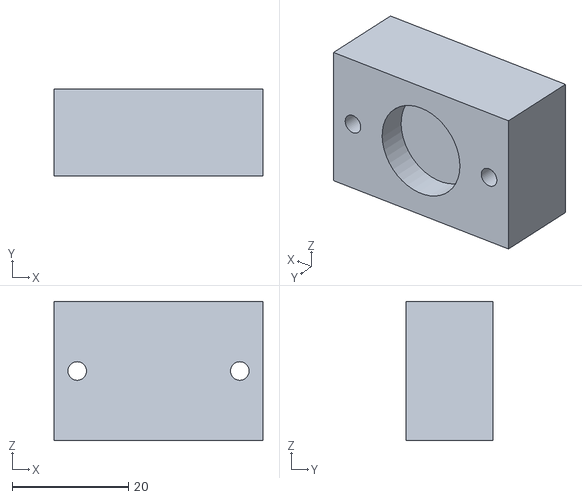
[picture p37: CAD file, 2023-08-07]
SOLIDWORKS/STL/Bearing holder Z axis.STL
36.0 x 15.0 x 24.0
