Fake-Oxygen/3D-PRINTER/TESTS/cube.SLDPRT

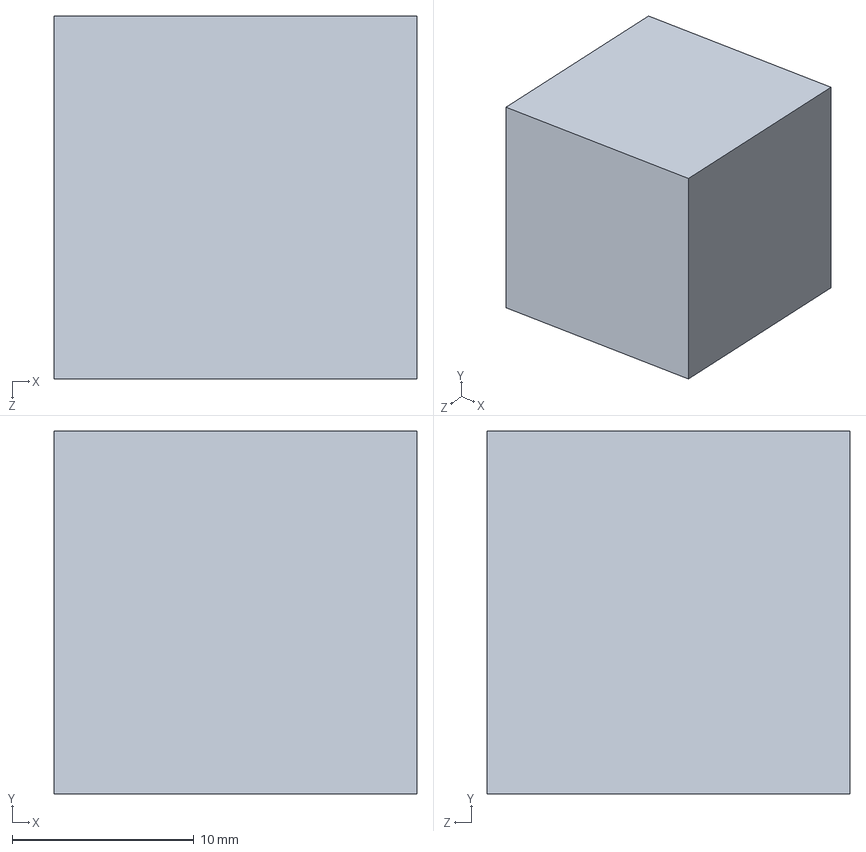
[picture p38: CAD file, 2023-10-18]
TESTS/cube.SLDPRT
20.0 x 20.0 x 20.0 mm
