Fake-Oxygen/3D-PRINTER/SOLIDWORKS/GENERAL/2020/30x38 2020 HINGE v2.step.SLDPRT

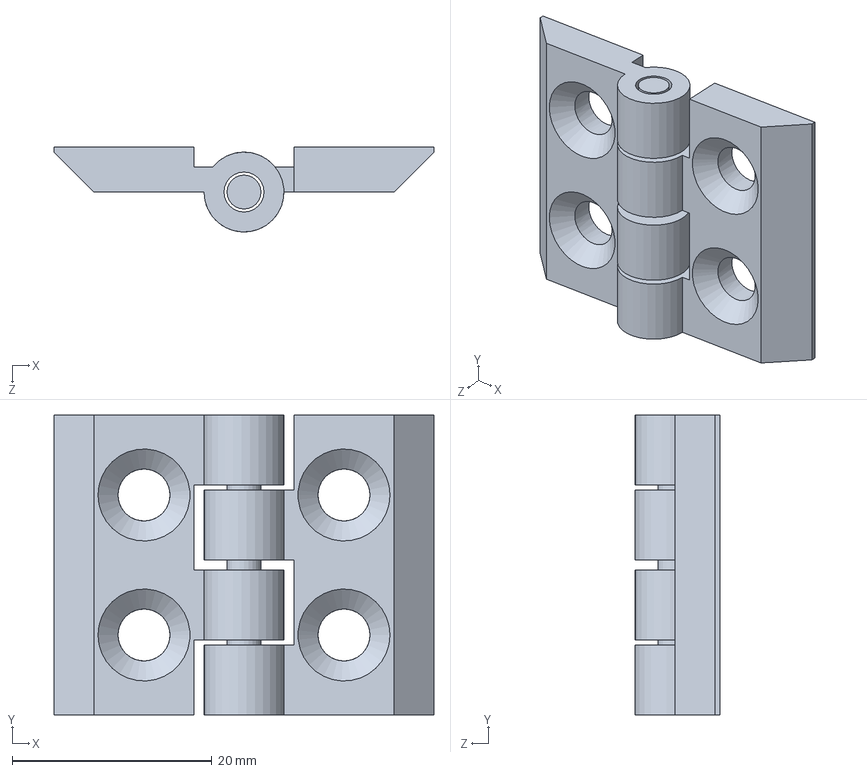
[picture p39: CAD file, 2023-02-11]
SOLIDWORKS/GENERAL/2020/30x38 2020 HINGE v2.step.SLDPRT
38.0 x 30.0 x 8.49 mm
