Fake-Oxygen/3D-PRINTER/SOLIDWORKS/GENERAL/LMK Bearing.SLDPRT

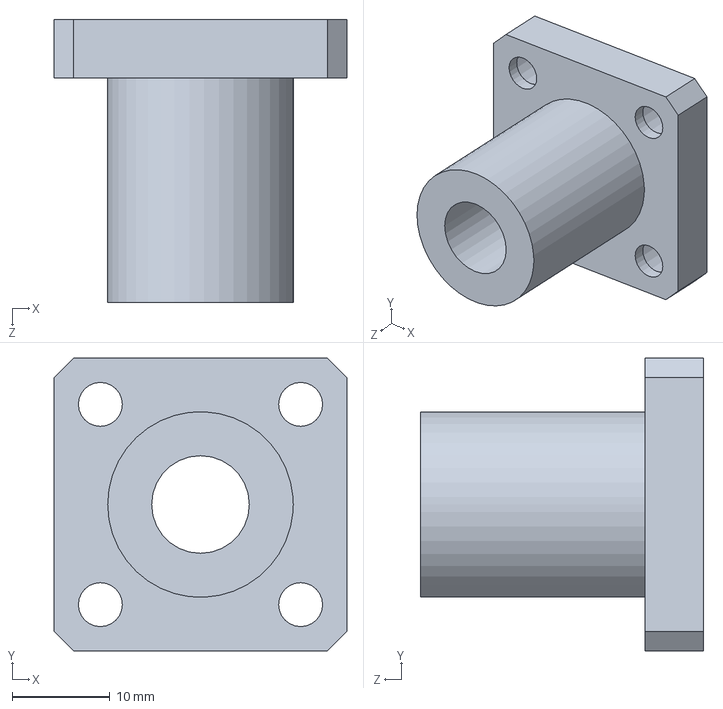
[picture p41: CAD file, 2023-10-18]
SOLIDWORKS/GENERAL/LMK Bearing.SLDPRT
30.0 x 30.0 x 29.0 mm
