Fake-Oxygen/3D-PRINTER/SOLIDWORKS/GENERAL/LMK_seri/LMK16.SLDPRT

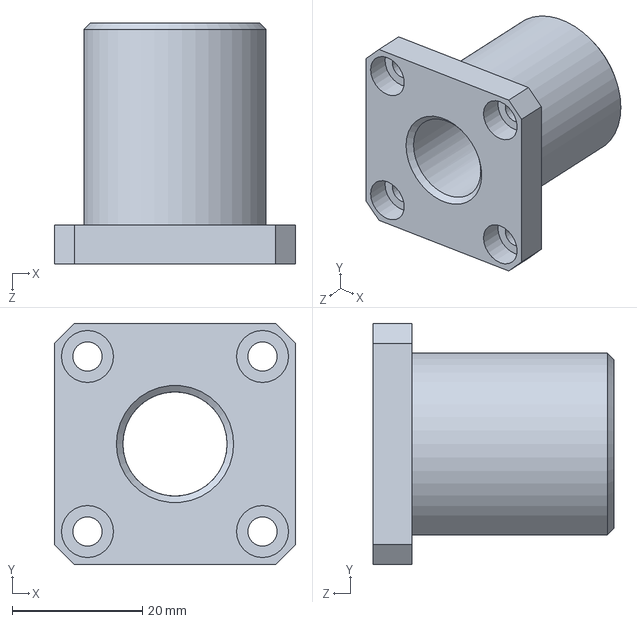
[picture p42: CAD file, 2023-01-27]
SOLIDWORKS/GENERAL/LMK_seri/LMK16.SLDPRT
37.0 x 37.0 x 37.0 mm
