Fake-Oxygen/3D-PRINTER/SOLIDWORKS/GENERAL/Power supply/Isulator.SLDPRT

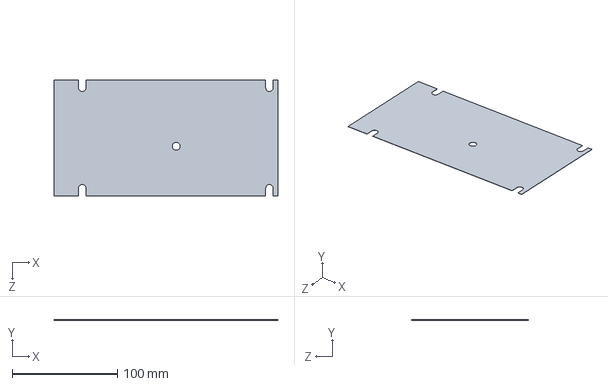
[picture p43: CAD file, 2023-01-27]
SOLIDWORKS/GENERAL/Power supply/Isulator.SLDPRT
212.4 x 0.2 x 110.1 mm
