Fake-Oxygen/3D-PRINTER/SOLIDWORKS/GENERAL/Radial Cooling Fan 50mm DC12V/bottom.SLDPRT

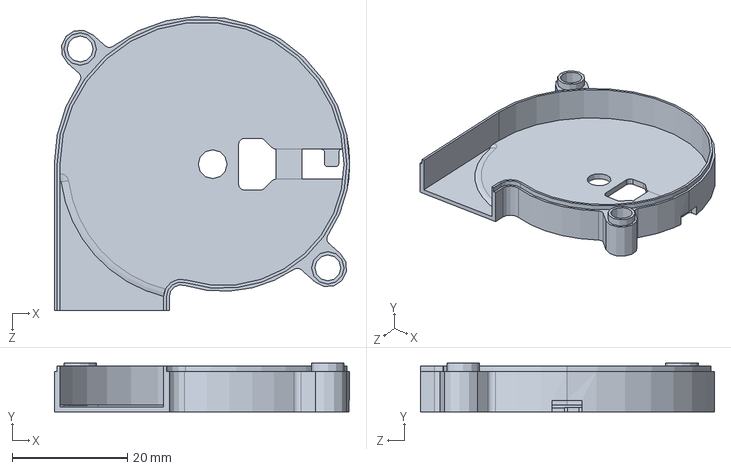
[picture p44: CAD file, 2023-08-07]
SOLIDWORKS/GENERAL/Radial Cooling Fan 50mm DC12V/bottom.SLDPRT
51.3 x 8.50 x 51.0 mm
