Fake-Oxygen/3D-PRINTER/SOLIDWORKS/SPECIFIC/Door blocker.SLDPRT

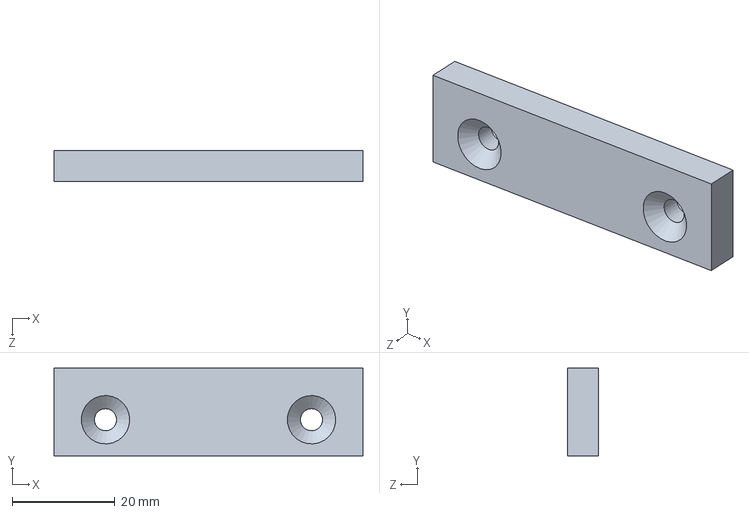
[picture p45: CAD file, 2023-10-18]
SOLIDWORKS/SPECIFIC/Door blocker.SLDPRT
60.0 x 17.0 x 6.00 mm
