Fake-Oxygen/3D-PRINTER/SOLIDWORKS/STL/Holding bracket.STL

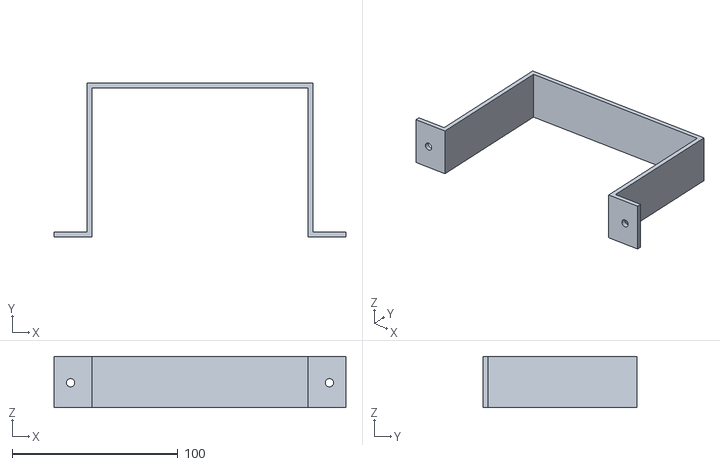
[picture p46: CAD file, 2023-08-07]
SOLIDWORKS/STL/Holding bracket.STL
176.0 x 93.0 x 30.9
