Fake-Oxygen/3D-PRINTER/SOLIDWORKS/GENERAL/36 Teeth GT2 gear.SLDPRT

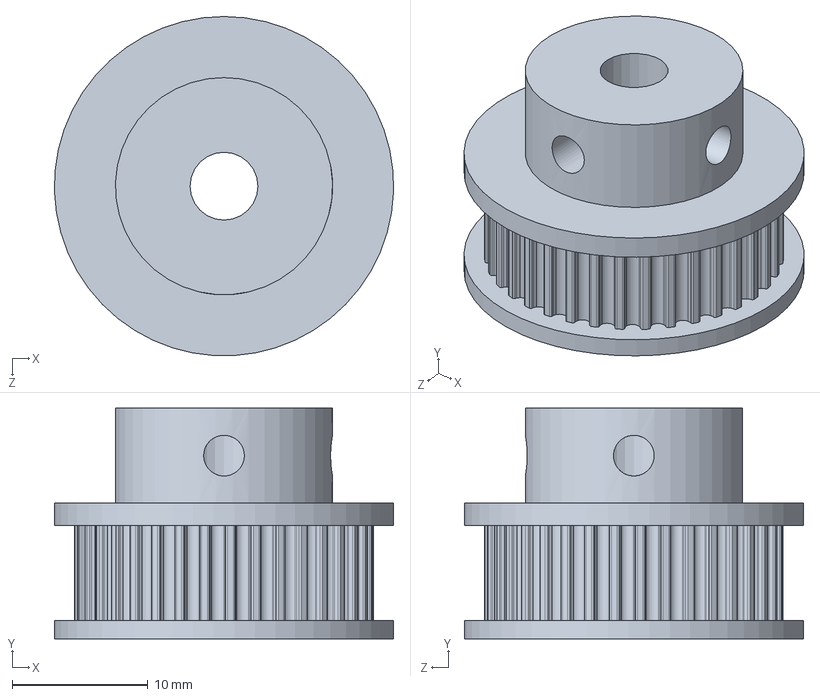
[picture p47: CAD file, 2023-10-18]
SOLIDWORKS/GENERAL/36 Teeth GT2 gear.SLDPRT
25.0 x 17.0 x 25.0 mm
