Fake-Oxygen/3D-PRINTER/SOLIDWORKS/GENERAL/camera/Camera module.SLDPRT

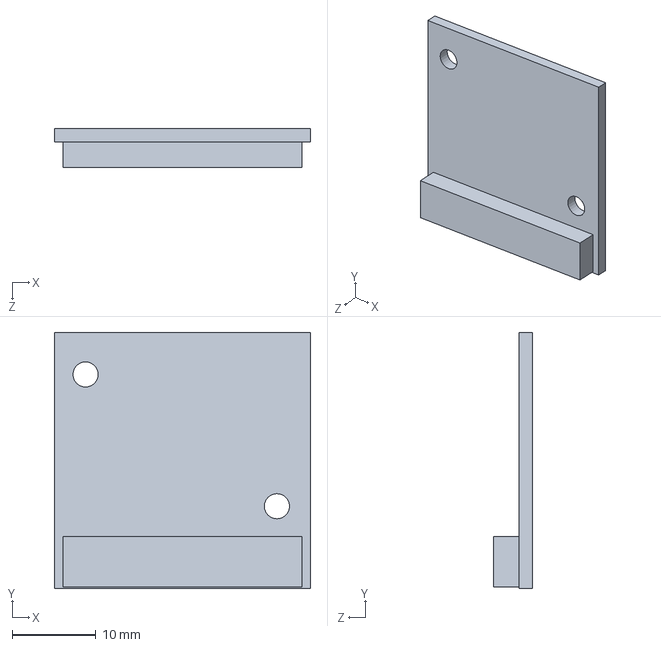
[picture p48: CAD file, 2023-02-11]
SOLIDWORKS/GENERAL/camera/Camera module.SLDPRT
30.5 x 30.5 x 4.60 mm
