Fake-Oxygen/3D-PRINTER/SOLIDWORKS/GENERAL/LMK_seri/LMK08.SLDPRT

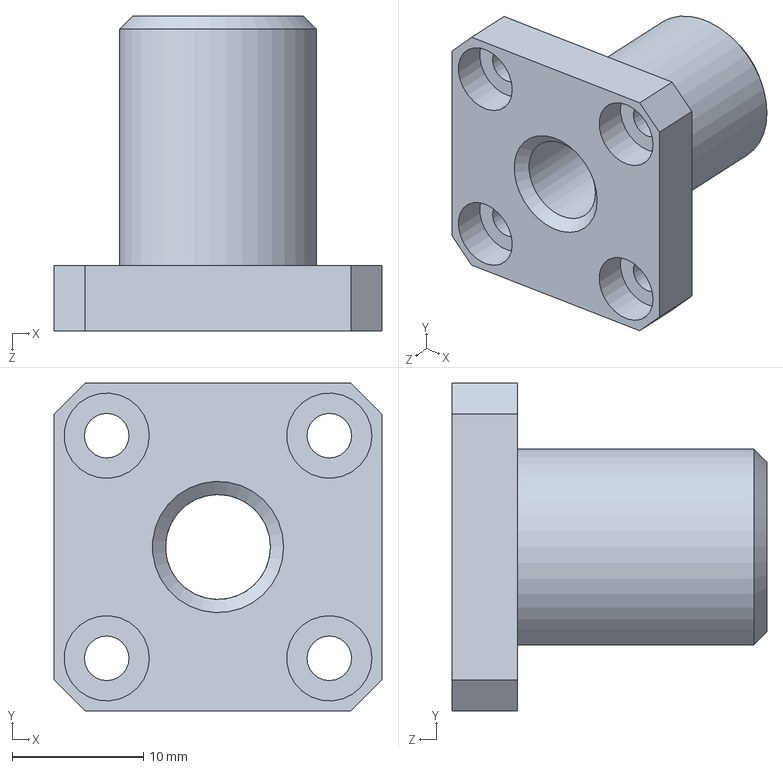
[picture p49: CAD file, 2023-01-27]
SOLIDWORKS/GENERAL/LMK_seri/LMK08.SLDPRT
25.0 x 25.0 x 24.0 mm
