Fake-Oxygen/3D-PRINTER/SOLIDWORKS/GENERAL/Power supply/Bottom case.SLDPRT

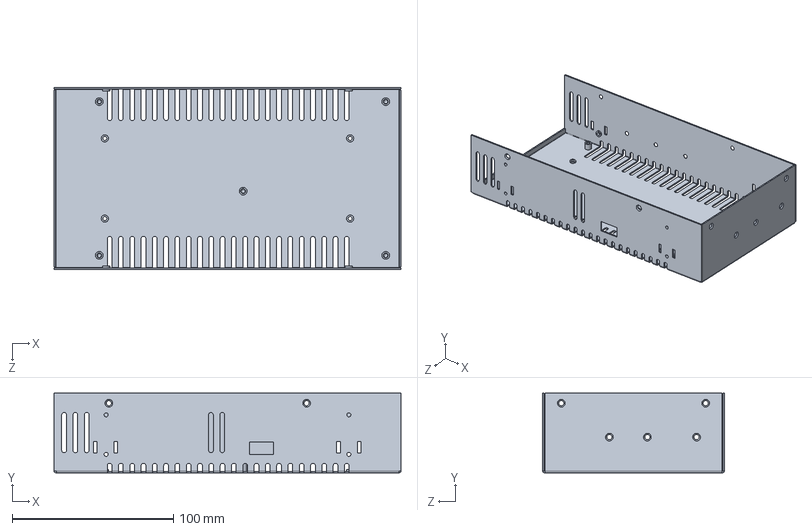
[picture p50: CAD file, 2023-01-27]
SOLIDWORKS/GENERAL/Power supply/Bottom case.SLDPRT
215.0 x 49.5 x 112.7 mm
