Fake-Oxygen/3D-PRINTER/SOLIDWORKS/GENERAL/Radial Cooling Fan 50mm DC12V/turbine.SLDPRT

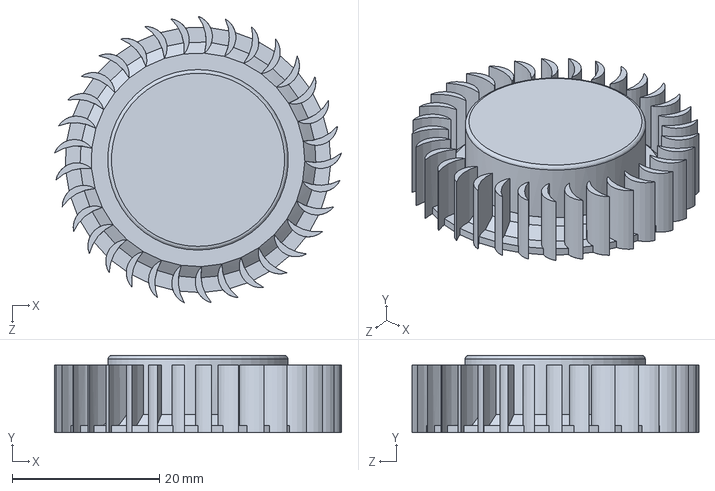
[picture p51: CAD file, 2023-05-07]
SOLIDWORKS/GENERAL/Radial Cooling Fan 50mm DC12V/turbine.SLDPRT
39.0 x 10.5 x 38.9 mm
