Fake-Oxygen/3D-PRINTER/SOLIDWORKS/SPECIFIC/Belt holder.SLDPRT

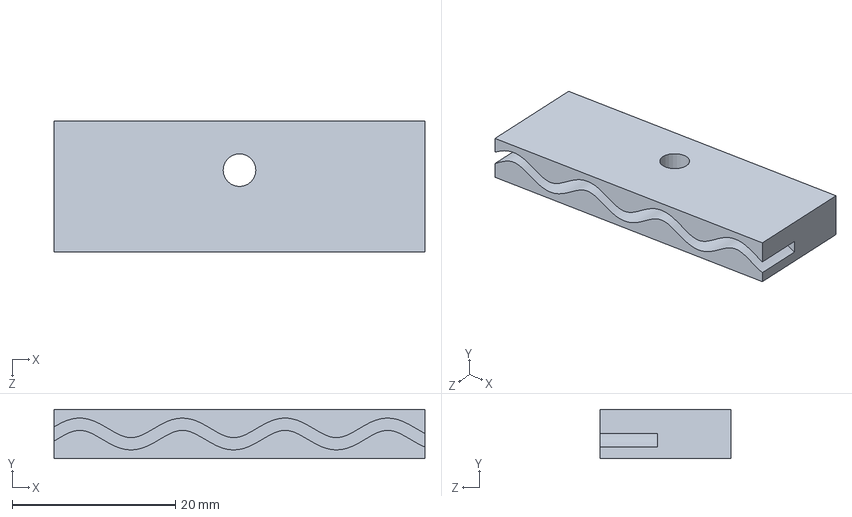
[picture p52: CAD file, 2023-10-18]
SOLIDWORKS/SPECIFIC/Belt holder.SLDPRT
45.4 x 6.00 x 16.0 mm
