Fake-Oxygen/3D-PRINTER/SOLIDWORKS/GENERAL/e3d v6/e3d heat break.SLDPRT

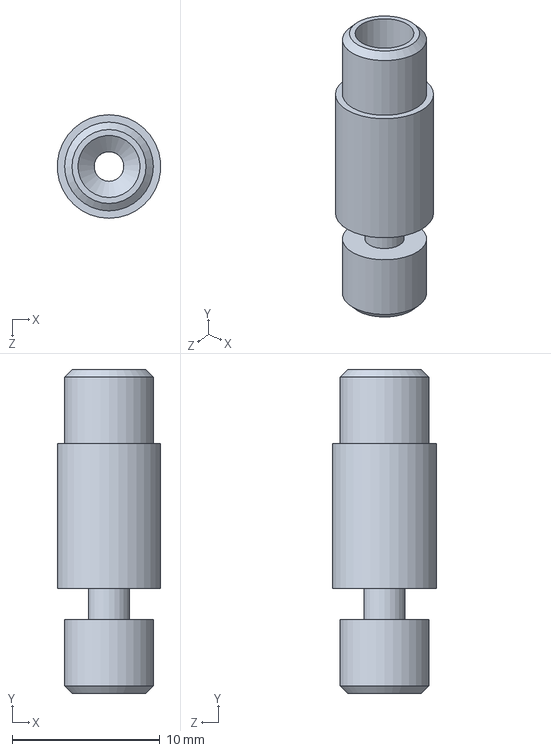
[picture p53: CAD file, 2023-05-07]
SOLIDWORKS/GENERAL/e3d v6/e3d heat break.SLDPRT
6.97 x 21.9 x 7.00 mm
