Fake-Oxygen/3D-PRINTER/SOLIDWORKS/GENERAL/LMK_seri/LMK12.SLDPRT

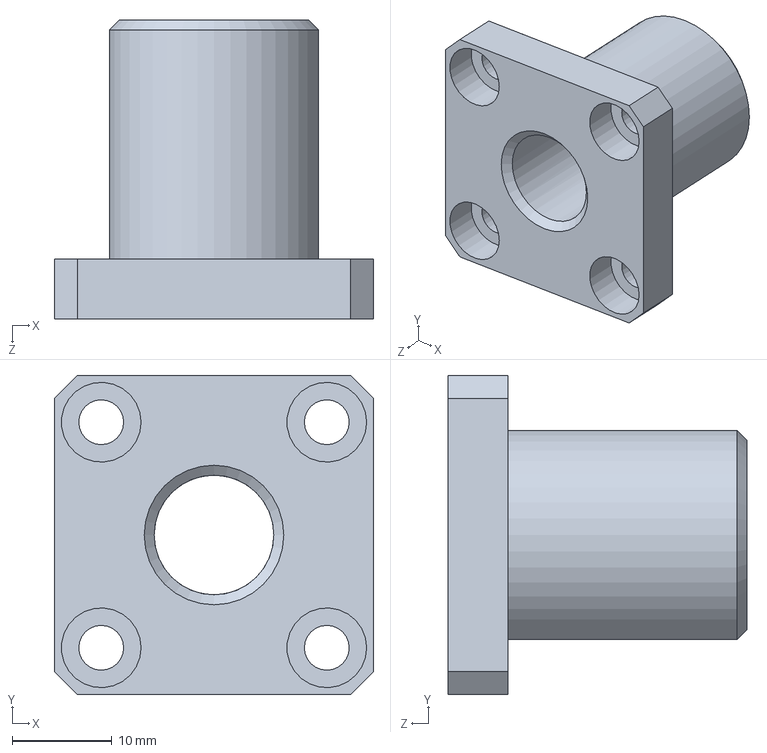
[picture p54: CAD file, 2023-01-27]
SOLIDWORKS/GENERAL/LMK_seri/LMK12.SLDPRT
32.0 x 32.0 x 30.0 mm
