Fake-Oxygen/3D-PRINTER/SOLIDWORKS/GENERAL/Power supply/Top case.SLDPRT

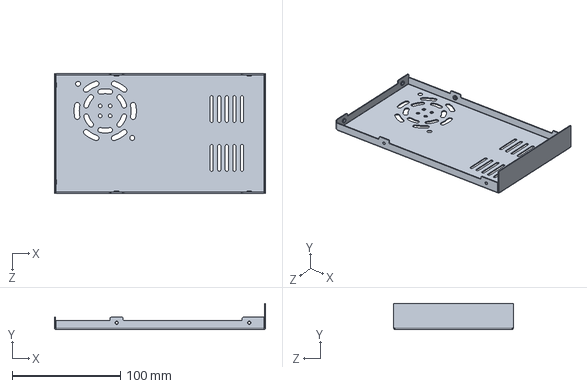
[picture p55: CAD file, 2023-01-27]
SOLIDWORKS/GENERAL/Power supply/Top case.SLDPRT
195.0 x 24.2 x 110.5 mm
