Fake-Oxygen/3D-PRINTER/SOLIDWORKS/GENERAL/Radial Cooling Fan 50mm DC12V/Radial-Cooling-Fan-5015-DC12V.STEP

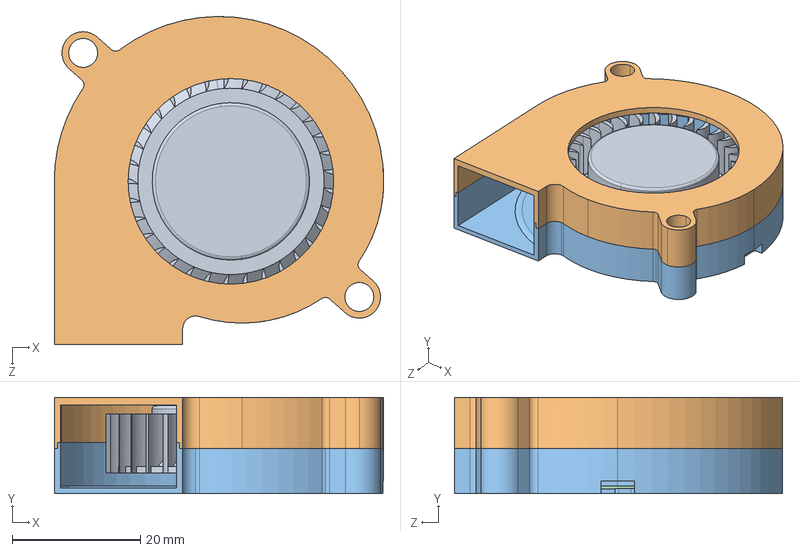
[picture p56: CAD file, 2023-01-13]
SOLIDWORKS/GENERAL/Radial Cooling Fan 50mm DC12V/Radial-Cooling-Fan-5015-DC12V.STEP
51.3 x 15.0 x 51.1 mm
turbine
top
bottom
