Fake-Oxygen/3D-PRINTER/SOLIDWORKS/GENERAL/Top Plate v2.SLDPRT

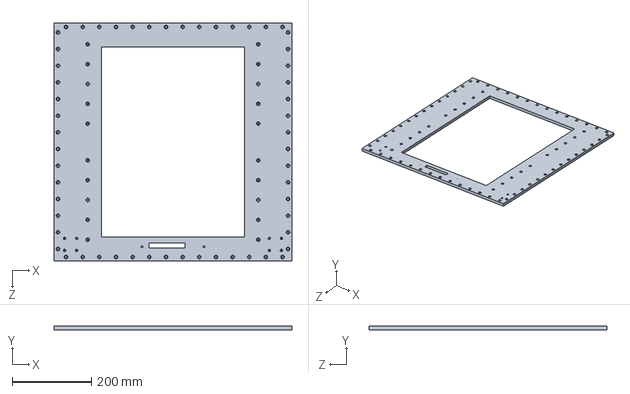
[picture p57: CAD file, 2023-08-07]
SOLIDWORKS/GENERAL/Top Plate v2.SLDPRT
600.0 x 10.0 x 600.0 mm
