Fake-Oxygen/3D-PRINTER/SOLIDWORKS/STL/rail cover.STL

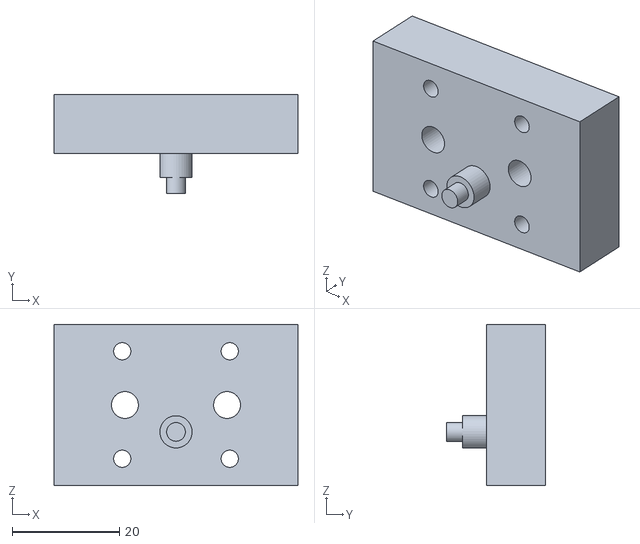
[picture p58: CAD file, 2023-08-07]
SOLIDWORKS/STL/rail cover.STL
45.4 x 18.5 x 30.0
