Fake-Oxygen/3D-PRINTER/SOLIDWORKS/GENERAL/4.3inch Capacitive Touch LCD 3D Drawing/Spacer.SLDPRT

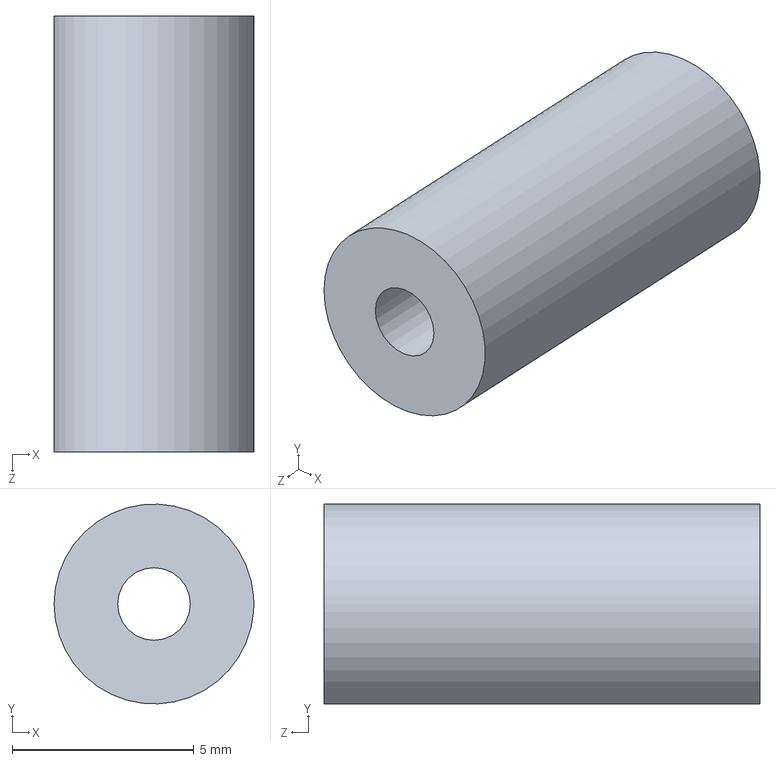
[picture p59: CAD file, 2023-05-07]
SOLIDWORKS/GENERAL/4.3inch Capacitive Touch LCD 3D Drawing/Spacer.SLDPRT
5.50 x 5.50 x 12.0 mm
