Fake-Oxygen/3D-PRINTER/SOLIDWORKS/GENERAL/e3d v6/e3d heatsink.SLDPRT

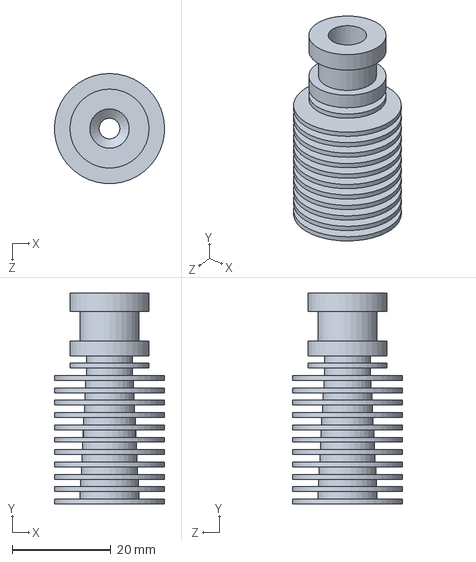
[picture p60: CAD file, 2023-05-07]
SOLIDWORKS/GENERAL/e3d v6/e3d heatsink.SLDPRT
22.3 x 42.7 x 22.3 mm
