Fake-Oxygen/3D-PRINTER/SOLIDWORKS/GENERAL/Throat tube.SLDPRT

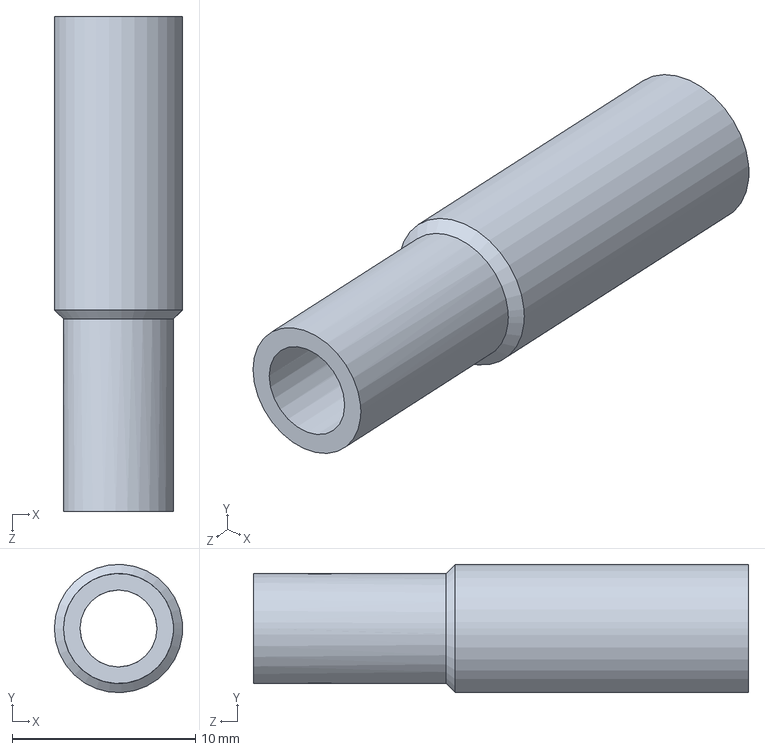
[picture p61: CAD file, 2023-08-07]
SOLIDWORKS/GENERAL/Throat tube.SLDPRT
7.00 x 6.99 x 27.0 mm
