Fake-Oxygen/3D-PRINTER/SOLIDWORKS/SPECIFIC/Belt protector in.SLDPRT

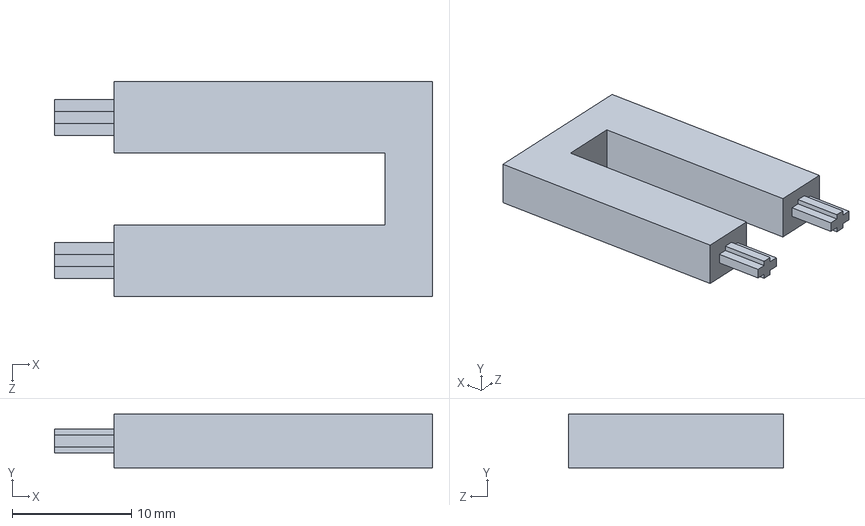
[picture p62: CAD file, 2023-10-18]
SOLIDWORKS/SPECIFIC/Belt protector in.SLDPRT
31.7 x 4.50 x 18.0 mm
