Fake-Oxygen/3D-PRINTER/SOLIDWORKS/STL/Blower fan holder.STL

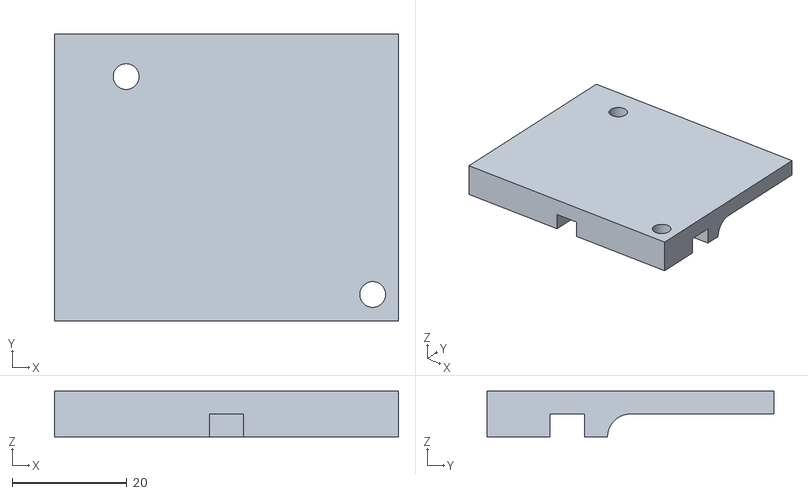
[picture p63: CAD file, 2023-08-07]
SOLIDWORKS/STL/Blower fan holder.STL
60.0 x 50.0 x 8.00
