Fake-Oxygen/3D-PRINTER/SOLIDWORKS/ASSEMBLY/Titan Aero from Aliexpress for GC/Adapter for connector.SLDPRT

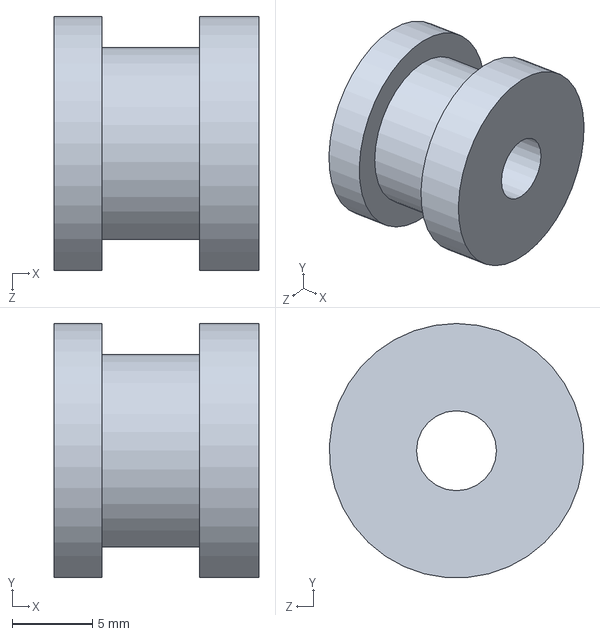
[picture p64: CAD file, 2023-02-11]
SOLIDWORKS/ASSEMBLY/Titan Aero from Aliexpress for GC/Adapter for connector.SLDPRT
12.8 x 15.9 x 15.9 mm
