Fake-Oxygen/3D-PRINTER/SOLIDWORKS/GENERAL/4.3inch Capacitive Touch LCD 3D Drawing/1.stp

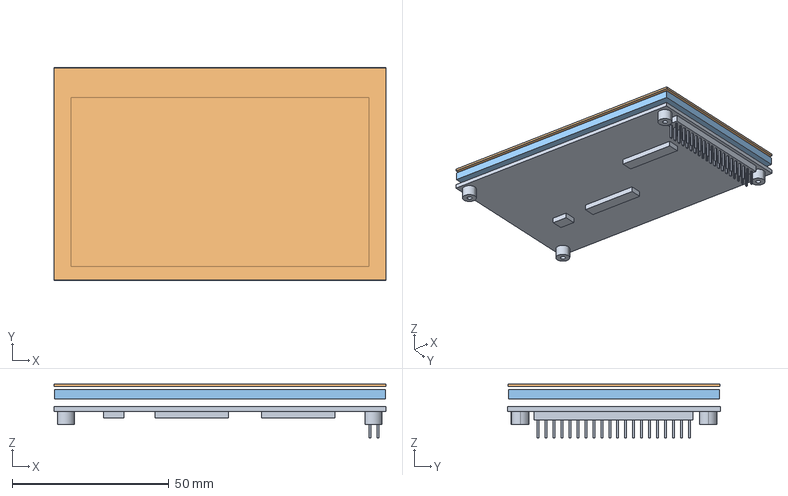
[picture p65: CAD file, 2023-02-11]
SOLIDWORKS/GENERAL/4.3inch Capacitive Touch LCD 3D Drawing/1.stp
106.0 x 67.9 x 17.2 mm
