Fake-Oxygen/3D-PRINTER/SOLIDWORKS/GENERAL/e3d v6/e3d nozzle (0.4).SLDPRT

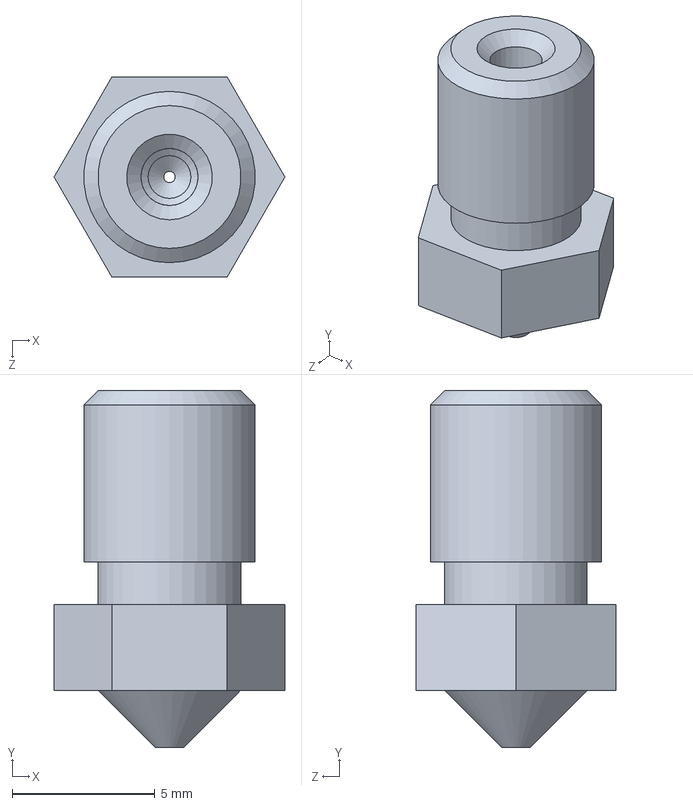
[picture p66: CAD file, 2023-05-07]
SOLIDWORKS/GENERAL/e3d v6/e3d nozzle (0.4).SLDPRT
8.08 x 12.5 x 7.00 mm
