Fake-Oxygen/3D-PRINTER/SOLIDWORKS/GENERAL/End Stop.SLDPRT

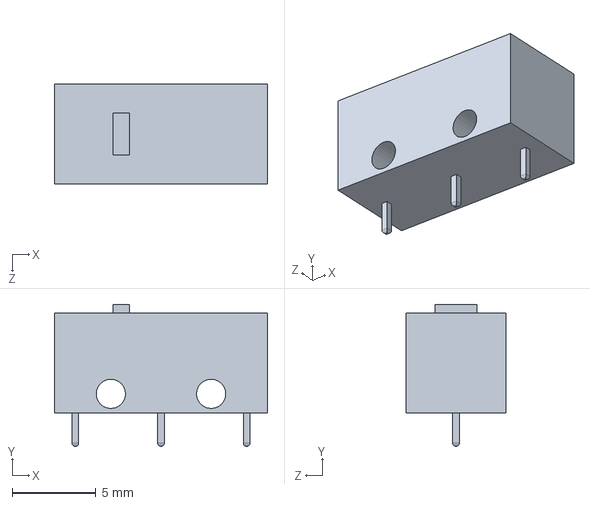
[picture p67: CAD file, 2023-08-07]
SOLIDWORKS/GENERAL/End Stop.SLDPRT
12.8 x 8.50 x 6.00 mm
