Fake-Oxygen/3D-PRINTER/SOLIDWORKS/GENERAL/LMK_seri/LMK06.SLDPRT

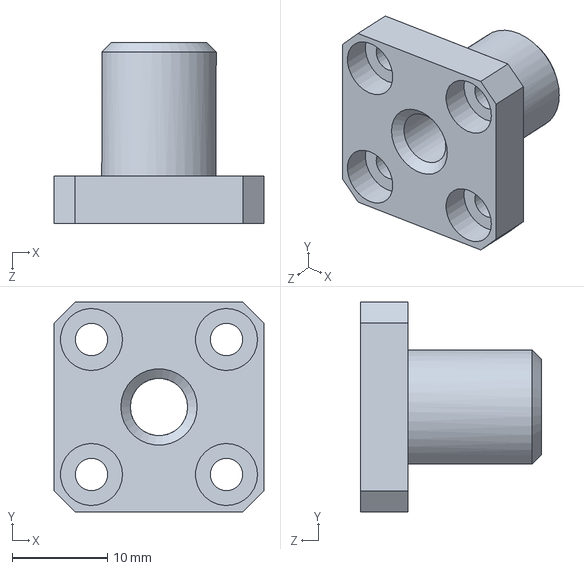
[picture p68: CAD file, 2023-01-27]
SOLIDWORKS/GENERAL/LMK_seri/LMK06.SLDPRT
22.0 x 22.0 x 19.0 mm
