Fake-Oxygen/3D-PRINTER/SOLIDWORKS/GENERAL/Power supply/Cooling_fan.SLDPRT

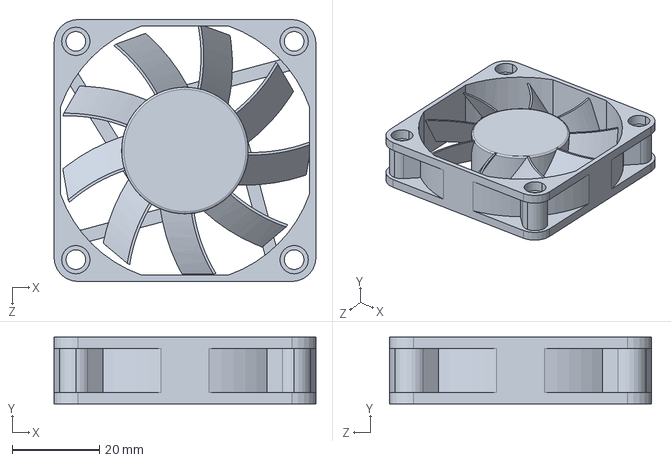
[picture p69: CAD file, 2023-01-27]
SOLIDWORKS/GENERAL/Power supply/Cooling_fan.SLDPRT
60.0 x 15.3 x 60.0 mm
