Fake-Oxygen/3D-PRINTER/SOLIDWORKS/SPECIFIC/Carriage.SLDPRT

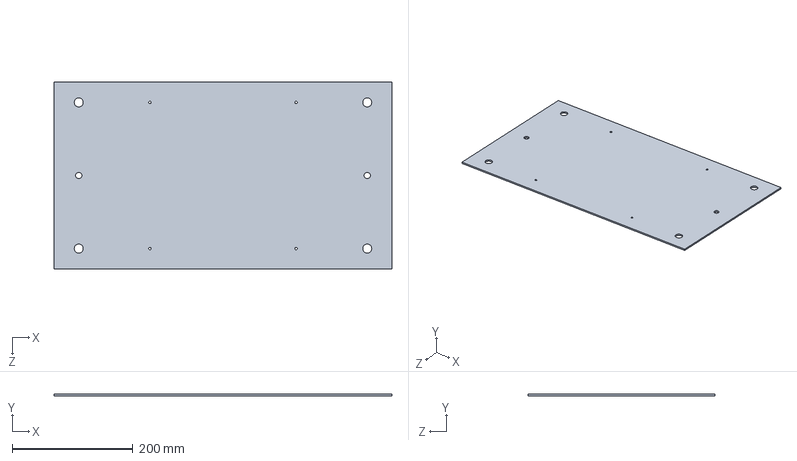
[picture p70: CAD file, 2023-10-18]
SOLIDWORKS/SPECIFIC/Carriage.SLDPRT
560.0 x 3.00 x 310.0 mm
