Fake-Oxygen/3D-PRINTER/SOLIDWORKS/STL/Header fan holder plate v2.STL

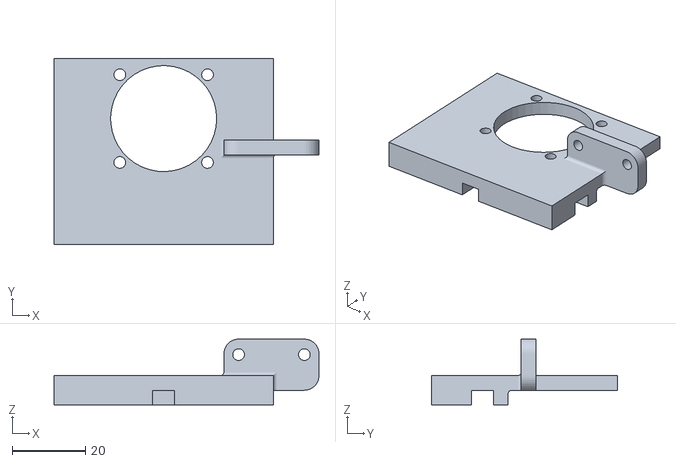
[picture p71: CAD file, 2023-08-07]
SOLIDWORKS/STL/Header fan holder plate v2.STL
72.5 x 51.0 x 18.0
