Fake-Oxygen/3D-PRINTER/SOLIDWORKS/ASSEMBLY/Titan Aero from Aliexpress for GC/Bracket.SLDPRT

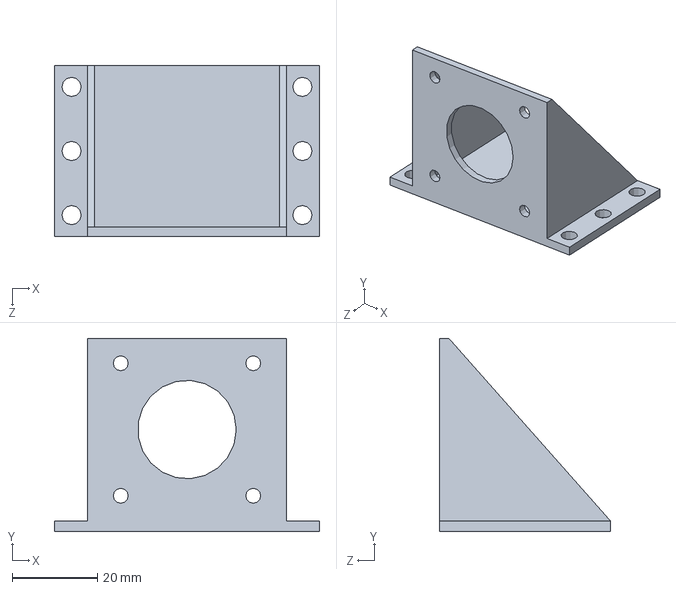
[picture p72: CAD file, 2023-02-11]
SOLIDWORKS/ASSEMBLY/Titan Aero from Aliexpress for GC/Bracket.SLDPRT
62.0 x 45.2 x 40.0 mm
