Fake-Oxygen/3D-PRINTER/SOLIDWORKS/GENERAL/4.3inch Capacitive Touch LCD 3D Drawing/2.stp

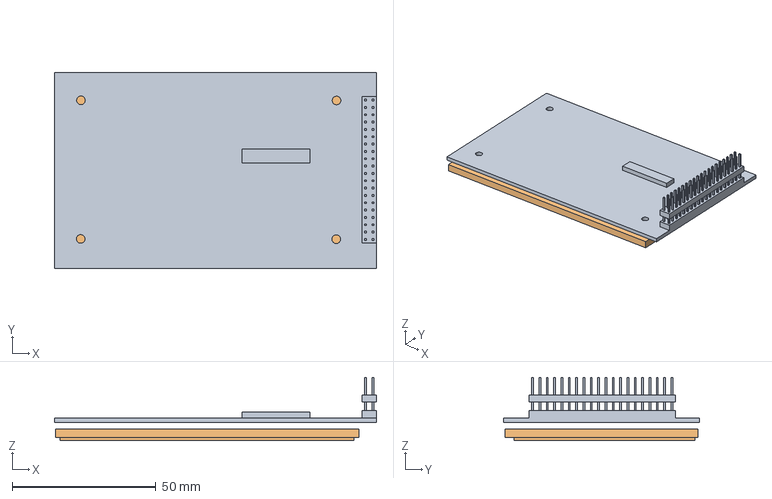
[picture p73: CAD file, 2023-02-11]
SOLIDWORKS/GENERAL/4.3inch Capacitive Touch LCD 3D Drawing/2.stp
112.0 x 68.1 x 22.0 mm
