Fake-Oxygen/3D-PRINTER/SOLIDWORKS/GENERAL/e3d v6/e3d heaterblock.SLDPRT

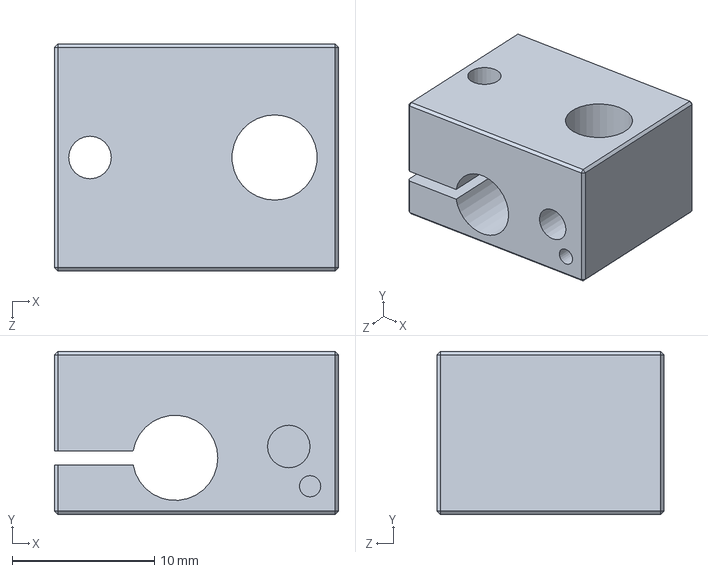
[picture p74: CAD file, 2023-05-07]
SOLIDWORKS/GENERAL/e3d v6/e3d heaterblock.SLDPRT
20.0 x 11.5 x 16.0 mm
