Fake-Oxygen/3D-PRINTER/SOLIDWORKS/GENERAL/Fan Housing.SLDPRT

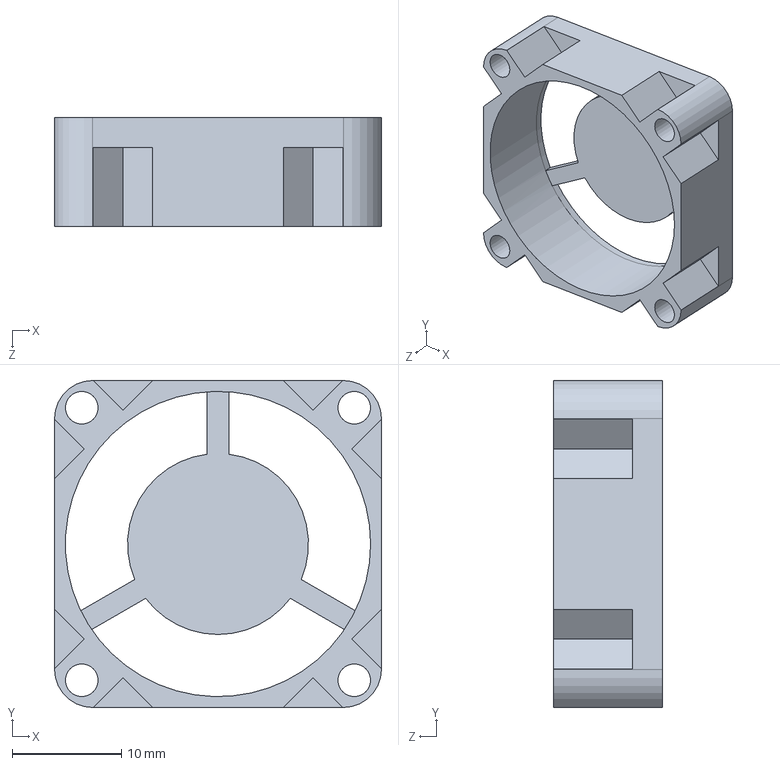
[picture p75: CAD file, 2023-08-07]
SOLIDWORKS/GENERAL/Fan Housing.SLDPRT
30.0 x 30.0 x 10.0 mm
