Fake-Oxygen/3D-PRINTER/SOLIDWORKS/GENERAL/LMK_seri/LMKAssem1.STEP

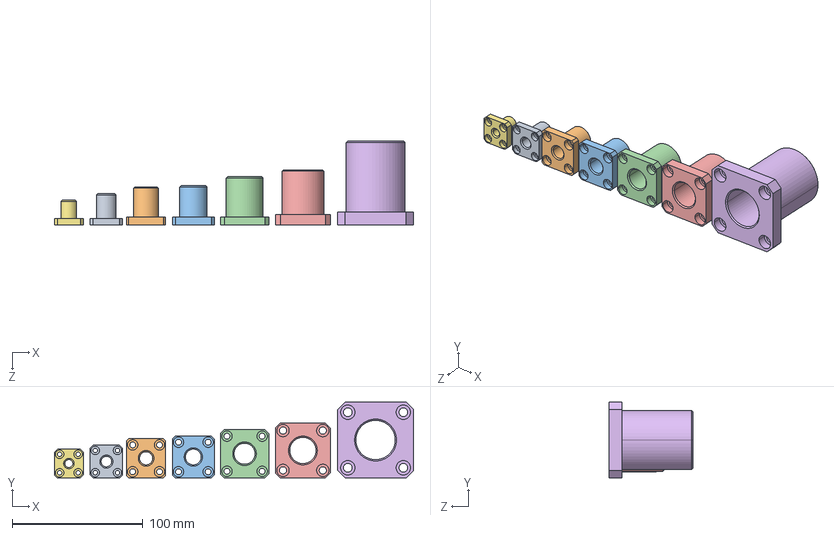
[picture p76: CAD file, 2023-01-27]
SOLIDWORKS/GENERAL/LMK_seri/LMKAssem1.STEP
274.3 x 58.0 x 64.0 mm
LMK08
LMK10
LMK12
LMK16
LMK20
LMK30
LMK06
