Fake-Oxygen/3D-PRINTER/SOLIDWORKS/SPECIFIC/Belt protector in2.STL

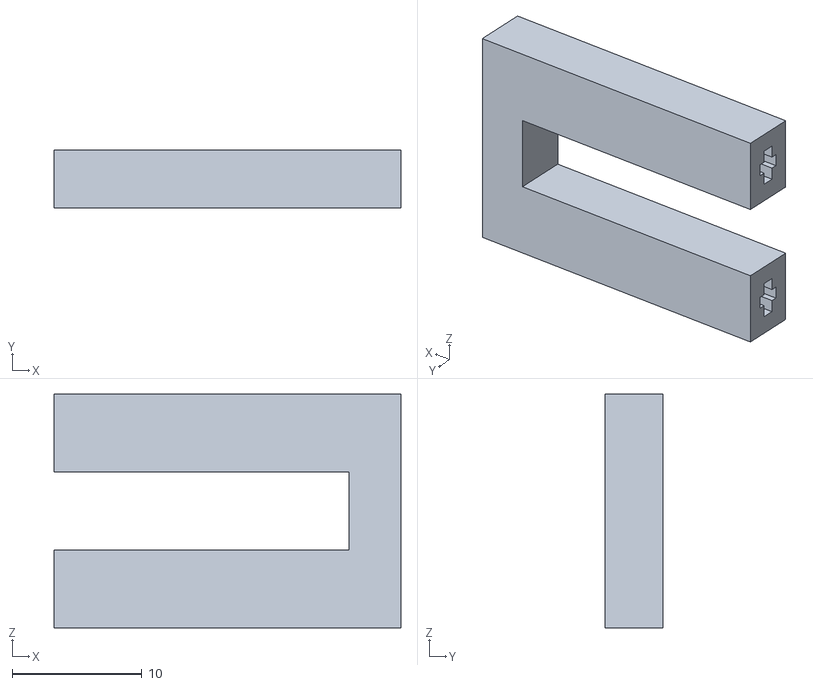
[picture p77: CAD file, 2023-10-18]
SOLIDWORKS/SPECIFIC/Belt protector in2.STL
26.7 x 4.50 x 18.0
