Fake-Oxygen/3D-PRINTER/SOLIDWORKS/ASSEMBLY/Titan Aero from Aliexpress for GC/Spring.SLDPRT

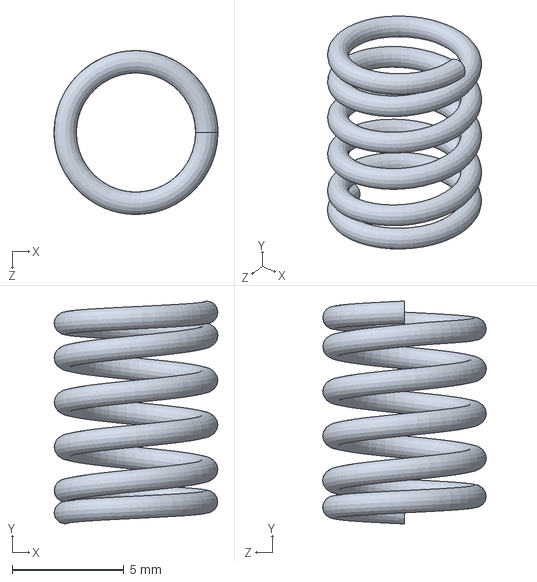
[picture p78: CAD file, 2023-02-11]
SOLIDWORKS/ASSEMBLY/Titan Aero from Aliexpress for GC/Spring.SLDPRT
7.35 x 10.0 x 7.35 mm
