Fake-Oxygen/3D-PRINTER/SOLIDWORKS/GENERAL/4.3inch Capacitive Touch LCD 3D Drawing/3.stp

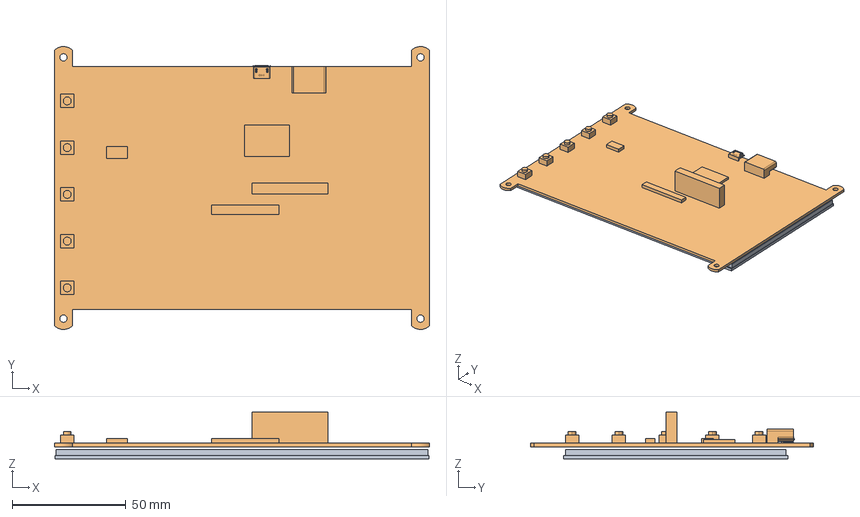
[picture p79: CAD file, 2023-02-11]
SOLIDWORKS/GENERAL/4.3inch Capacitive Touch LCD 3D Drawing/3.stp
164.9 x 124.4 x 20.5 mm
