Fake-Oxygen/3D-PRINTER/SOLIDWORKS/GENERAL/e3d v6/fan sub2.SLDPRT

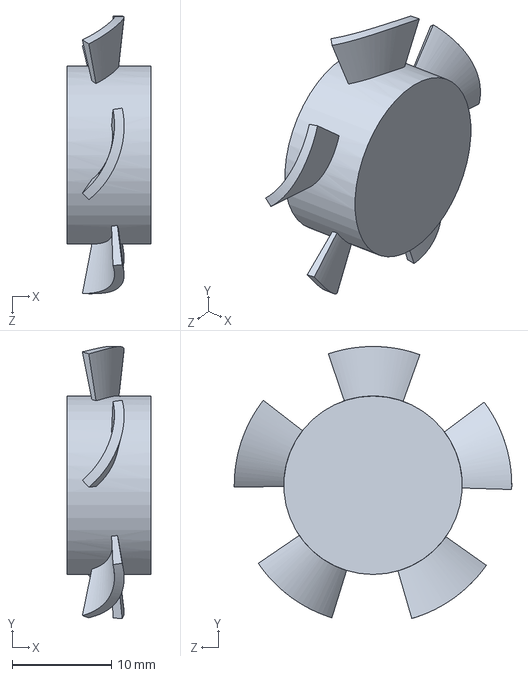
[picture p80: CAD file, 2023-01-13]
SOLIDWORKS/GENERAL/e3d v6/fan sub2.SLDPRT
8.50 x 27.4 x 28.0 mm
