Fake-Oxygen/3D-PRINTER/SOLIDWORKS/GENERAL/LMK_seri/LMK20.SLDPRT

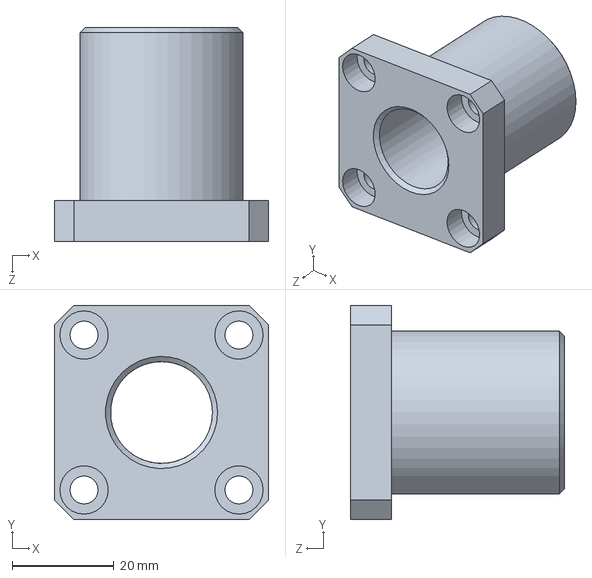
[picture p81: CAD file, 2023-01-27]
SOLIDWORKS/GENERAL/LMK_seri/LMK20.SLDPRT
42.0 x 42.0 x 42.0 mm
