Fake-Oxygen/3D-PRINTER/SOLIDWORKS/SPECIFIC/Middle Y Carriage Plate.SLDPRT

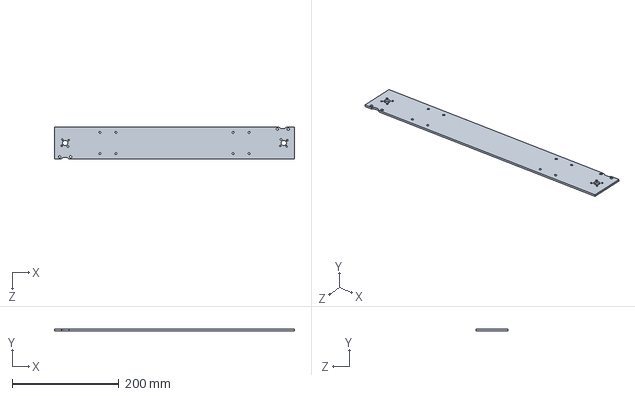
[picture p82: CAD file, 2023-10-18]
SOLIDWORKS/SPECIFIC/Middle Y Carriage Plate.SLDPRT
450.0 x 3.00 x 60.0 mm
