Fake-Oxygen/3D-PRINTER/SOLIDWORKS/STL/Header holder bracket.STL

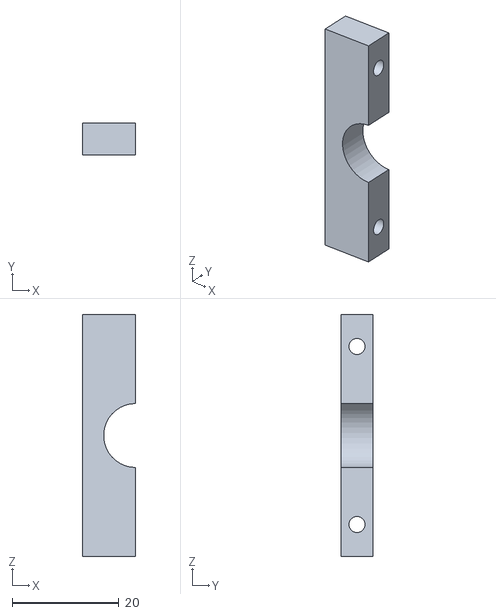
[picture p83: CAD file, 2023-08-07]
SOLIDWORKS/STL/Header holder bracket.STL
10.0 x 6.00 x 45.4
