Fake-Oxygen/3D-PRINTER/SOLIDWORKS/ASSEMBLY/Titan Aero from Aliexpress for GC/House.SLDPRT

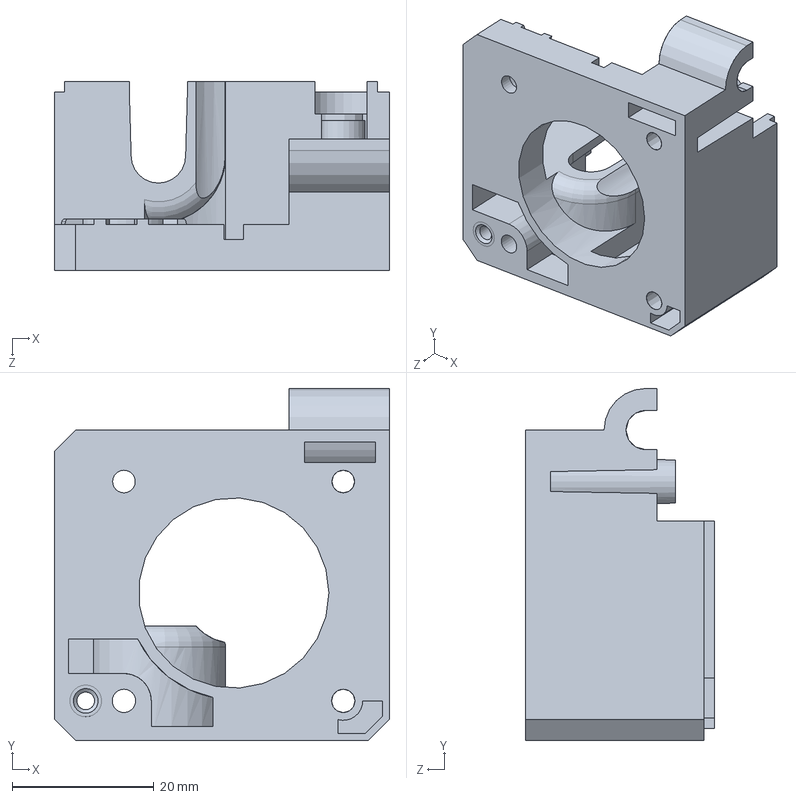
[picture p84: CAD file, 2023-02-11]
SOLIDWORKS/ASSEMBLY/Titan Aero from Aliexpress for GC/House.SLDPRT
47.4 x 49.8 x 26.7 mm
