Fake-Oxygen/3D-PRINTER/SOLIDWORKS/SPECIFIC/Z Stop Holder.SLDPRT

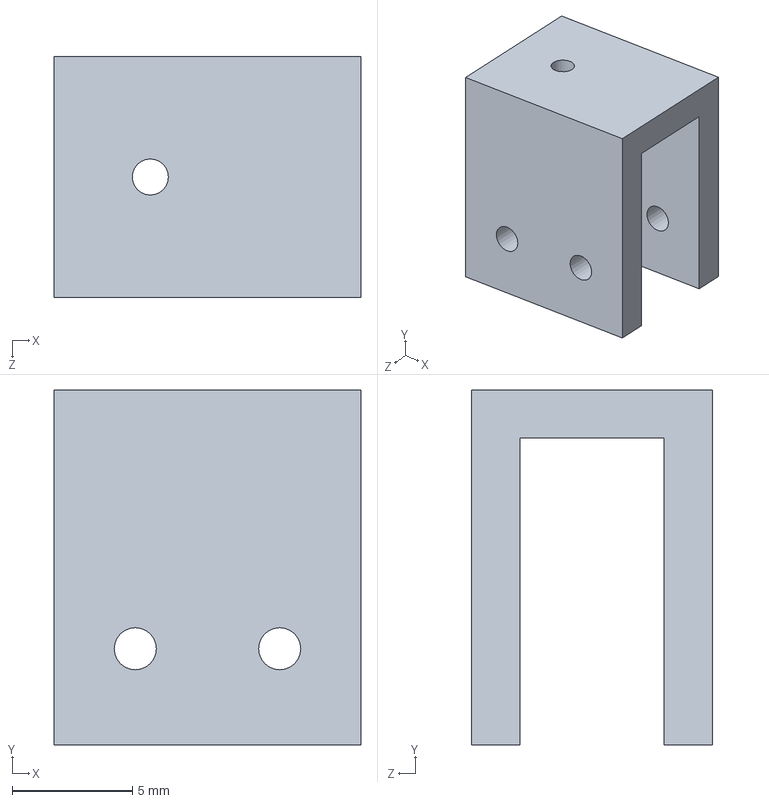
[picture p85: CAD file, 2023-08-07]
SOLIDWORKS/SPECIFIC/Z Stop Holder.SLDPRT
12.8 x 14.8 x 10.0 mm
