Fake-Oxygen/3D-PRINTER/SOLIDWORKS/STL/Head Holder v2.STL

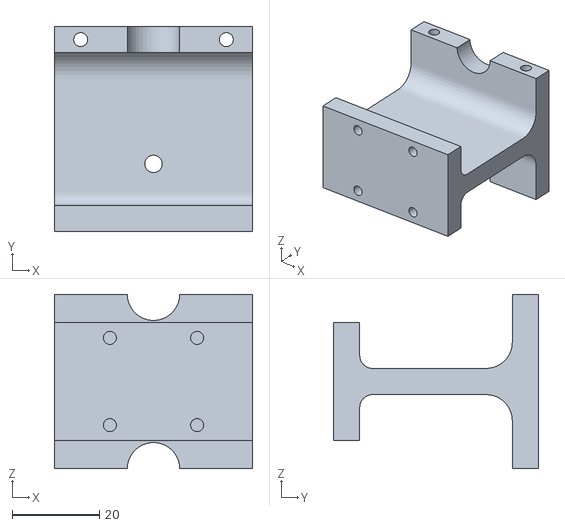
[picture p86: CAD file, 2023-08-07]
SOLIDWORKS/STL/Head Holder v2.STL
45.4 x 47.0 x 40.0
