Fake-Oxygen/3D-PRINTER/SOLIDWORKS/ASSEMBLY/Titan Aero from Aliexpress for GC/Sleeve_in_rocker.SLDPRT

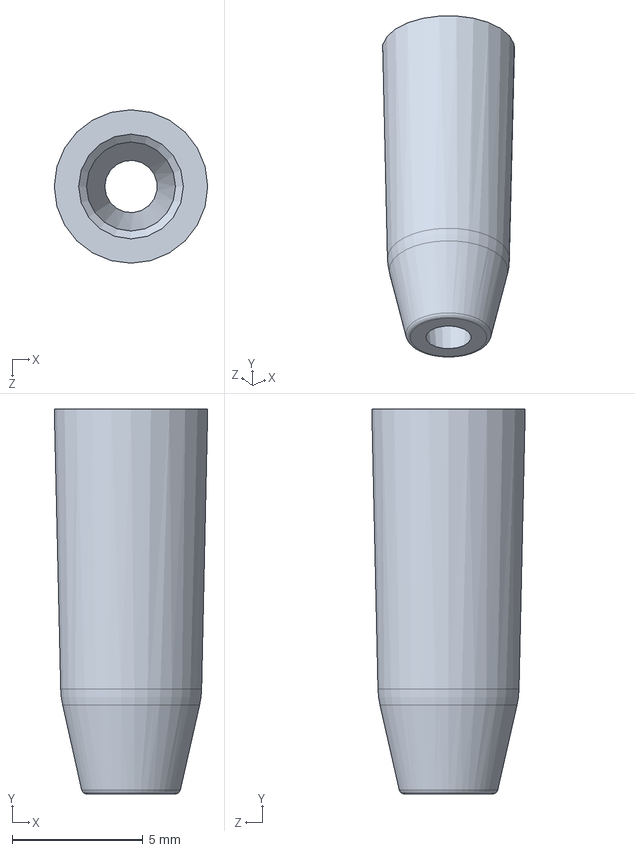
[picture p87: CAD file, 2023-02-11]
SOLIDWORKS/ASSEMBLY/Titan Aero from Aliexpress for GC/Sleeve_in_rocker.SLDPRT
5.86 x 14.7 x 5.86 mm
