Fake-Oxygen/3D-PRINTER/SOLIDWORKS/GENERAL/e3d v6/fan sub1.SLDPRT

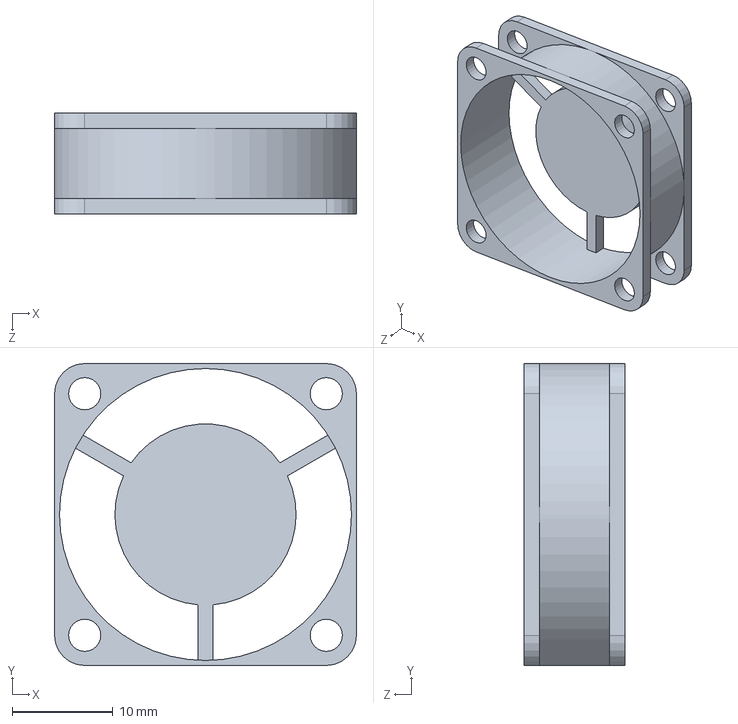
[picture p88: CAD file, 2023-01-13]
SOLIDWORKS/GENERAL/e3d v6/fan sub1.SLDPRT
30.0 x 30.0 x 10.0 mm
