Fake-Oxygen/3D-PRINTER/SOLIDWORKS/SPECIFIC/bearing holder v2.SLDPRT

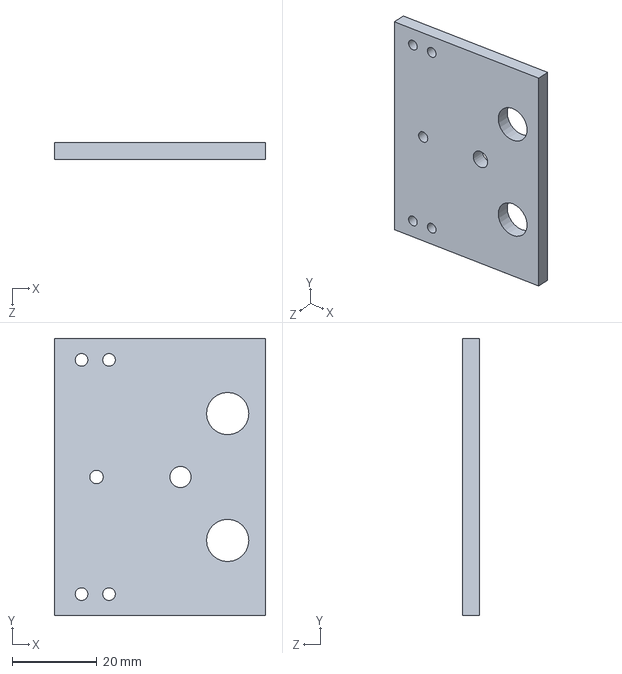
[picture p89: CAD file, 2023-08-07]
SOLIDWORKS/SPECIFIC/bearing holder v2.SLDPRT
50.0 x 65.5 x 4.00 mm
