Fake-Oxygen/3D-PRINTER/SOLIDWORKS/GENERAL/Bearing.SLDPRT

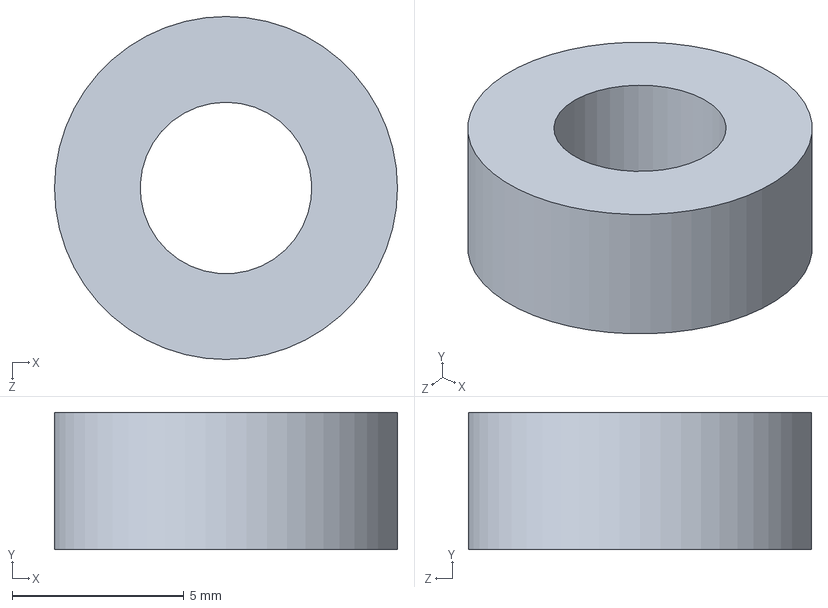
[picture p90: CAD file, 2023-08-07]
SOLIDWORKS/GENERAL/Bearing.SLDPRT
10.0 x 4.00 x 10.0 mm
