Fake-Oxygen/3D-PRINTER/SOLIDWORKS/SPECIFIC/Z Axis carriage.SLDPRT

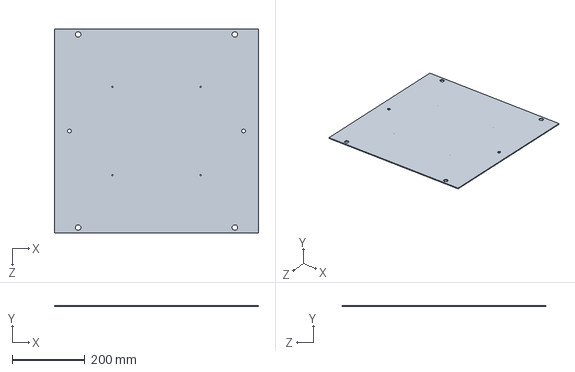
[picture p91: CAD file, 2023-08-07]
SOLIDWORKS/SPECIFIC/Z Axis carriage.SLDPRT
560.0 x 3.00 x 560.0 mm
