Fake-Oxygen/3D-PRINTER/SOLIDWORKS/STL/Cover for rail.STL

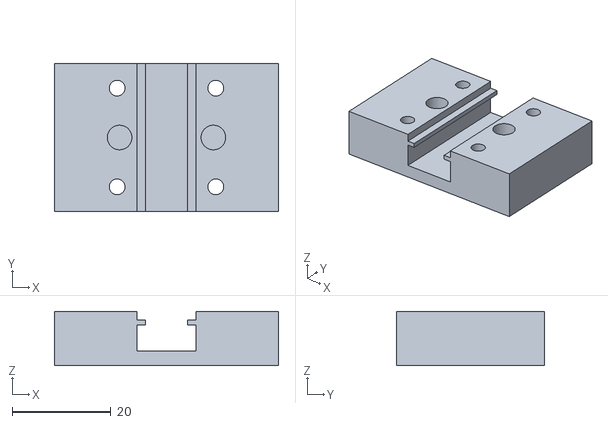
[picture p92: CAD file, 2023-08-07]
SOLIDWORKS/STL/Cover for rail.STL
45.4 x 30.0 x 11.0
