Fake-Oxygen/3D-PRINTER/SOLIDWORKS/ASSEMBLY/Titan Aero from Aliexpress for GC/Bearing 623-D-ZZ_modified.sldprt

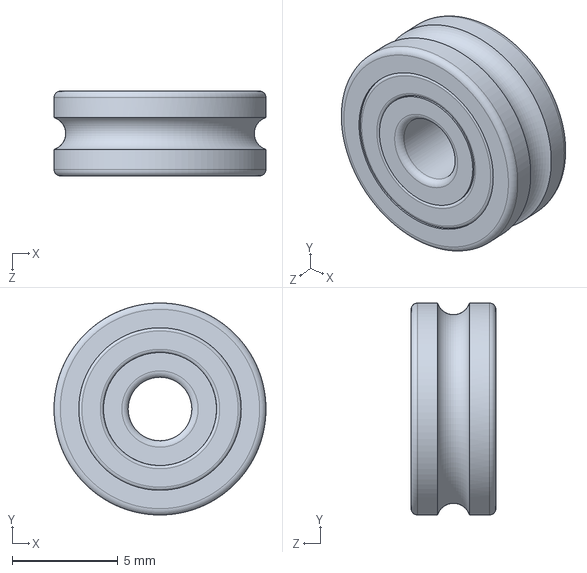
[picture p93: CAD file, 2023-02-11]
SOLIDWORKS/ASSEMBLY/Titan Aero from Aliexpress for GC/Bearing 623-D-ZZ_modified.sldprt
10.0 x 10.00 x 4.00 mm
