Fake-Oxygen/3D-PRINTER/SOLIDWORKS/ASSEMBLY/Titan Aero from Aliexpress for GC/ISO 15 RBB - 276 - 16,DE,NC,16_68.sldprt

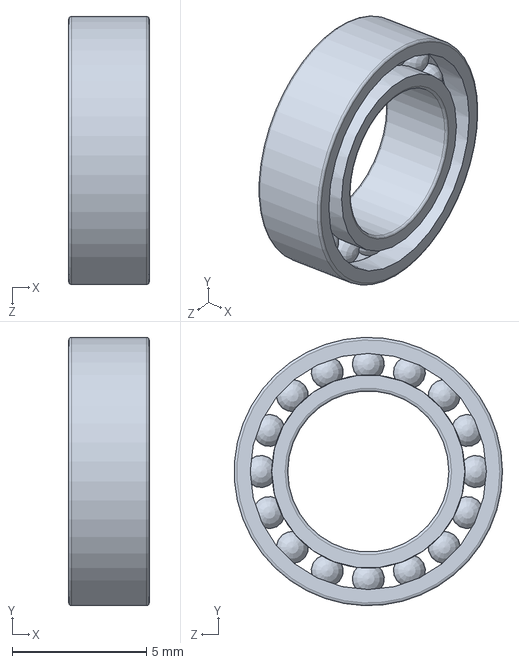
[picture p94: CAD file, 2023-02-11]
SOLIDWORKS/ASSEMBLY/Titan Aero from Aliexpress for GC/ISO 15 RBB - 276 - 16,DE,NC,16_68.sldprt
3.00 x 9.99 x 9.99 mm
