Fake-Oxygen/3D-PRINTER/SOLIDWORKS/GENERAL/Nozzle 0.4mm.SLDPRT

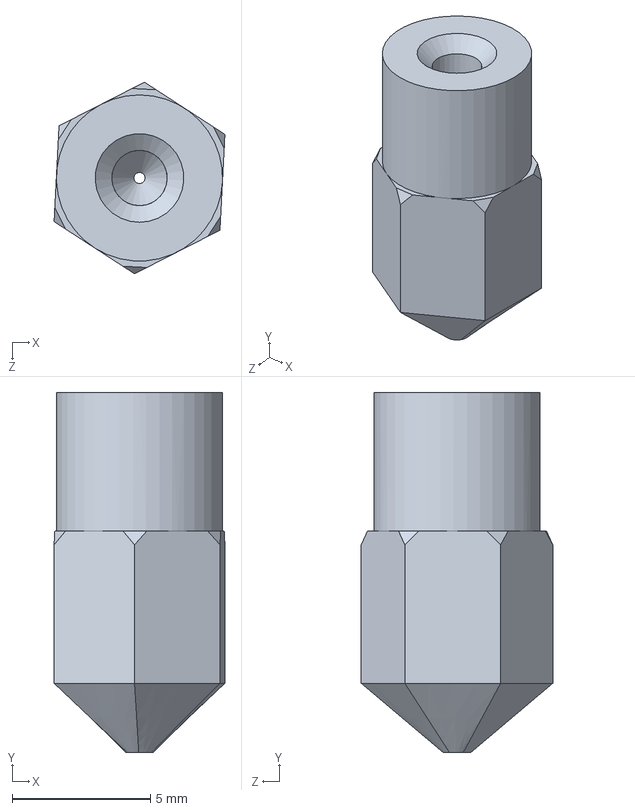
[picture p95: CAD file, 2023-08-07]
SOLIDWORKS/GENERAL/Nozzle 0.4mm.SLDPRT
6.17 x 13.0 x 6.92 mm
