Fake-Oxygen/3D-PRINTER/SOLIDWORKS/STL/Top cover for side pulleys.STL

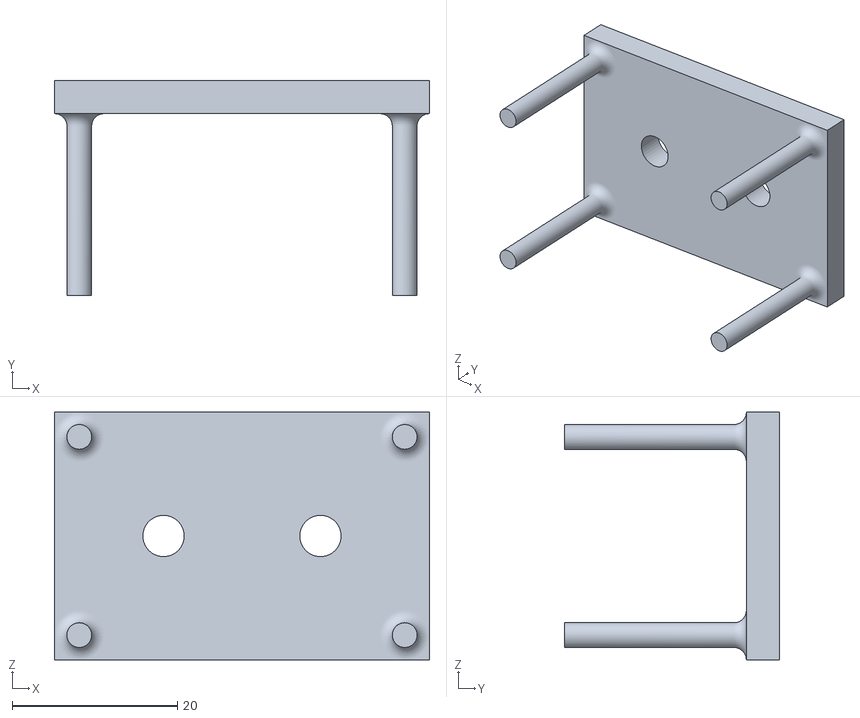
[picture p96: CAD file, 2023-08-07]
SOLIDWORKS/STL/Top cover for side pulleys.STL
45.4 x 26.0 x 30.0
