Fake-Oxygen/3D-PRINTER/SOLIDWORKS/GENERAL/Aluminium panel connector.SLDPRT

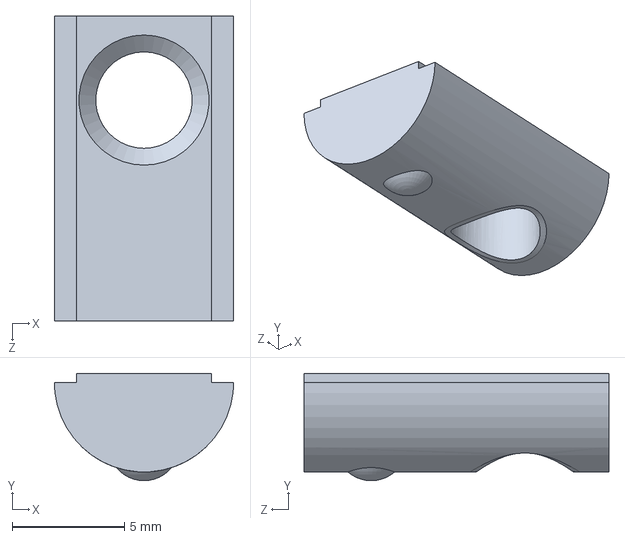
[picture p97: CAD file, 2023-08-07]
SOLIDWORKS/GENERAL/Aluminium panel connector.SLDPRT
8.00 x 4.79 x 13.6 mm
