Fake-Oxygen/3D-PRINTER/SOLIDWORKS/STL/FanDut.STL

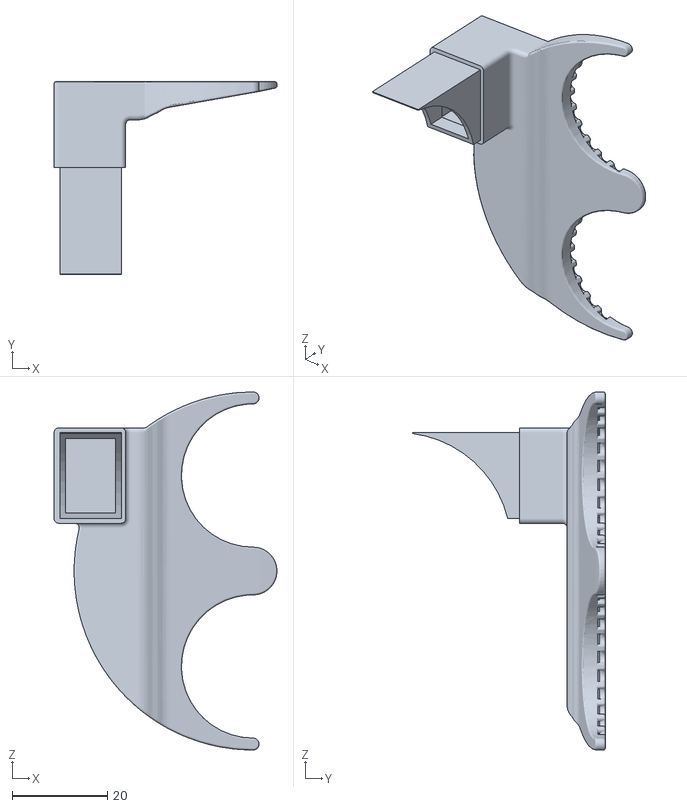
[picture p98: CAD file, 2023-01-13]
SOLIDWORKS/STL/FanDut.STL
46.7 x 40.4 x 75.0
