Fake-Oxygen/3D-PRINTER/SOLIDWORKS/ASSEMBLY/Titan Aero from Aliexpress for GC/Cuerpo.SLDPRT

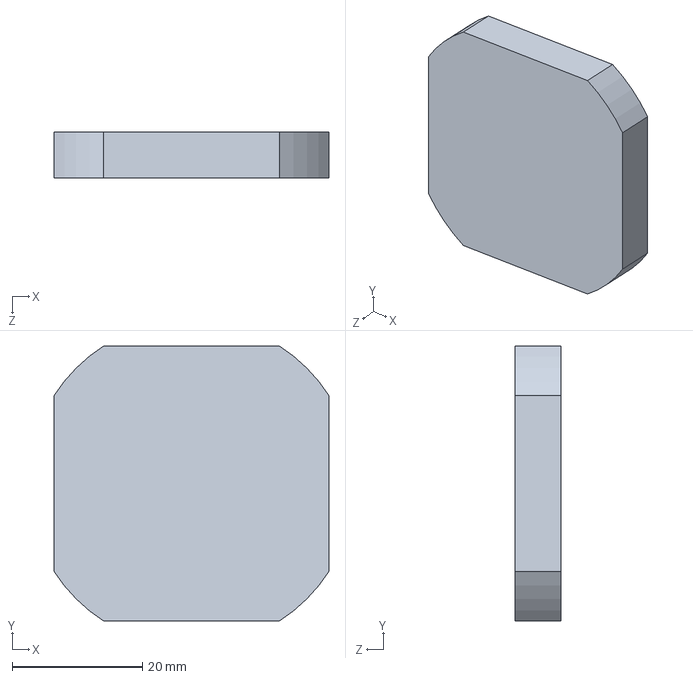
[picture p99: CAD file, 2023-02-11]
SOLIDWORKS/ASSEMBLY/Titan Aero from Aliexpress for GC/Cuerpo.SLDPRT
42.3 x 42.3 x 7.00 mm
