Fake-Oxygen/3D-PRINTER/SOLIDWORKS/GENERAL/Hot Bed.SLDPRT

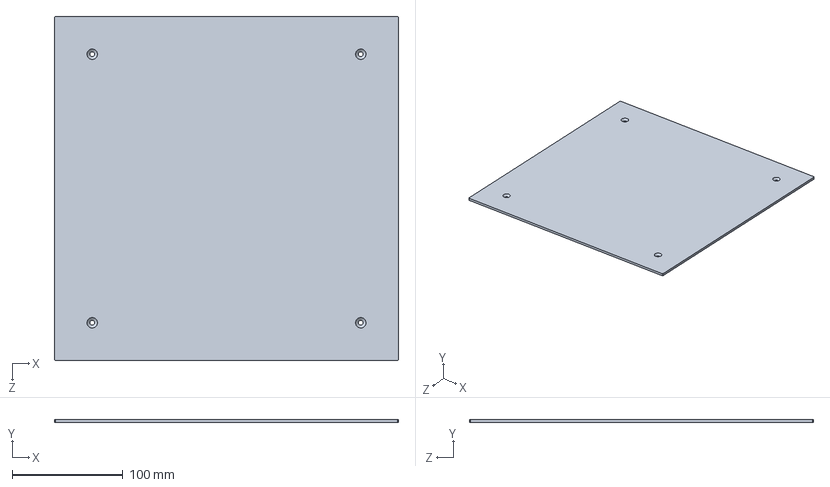
[picture p100: CAD file, 2023-08-07]
SOLIDWORKS/GENERAL/Hot Bed.SLDPRT
310.0 x 3.00 x 310.0 mm
