Fake-Oxygen/3D-PRINTER/SOLIDWORKS/GENERAL/Podkładka pod NEMA17.SLDPRT

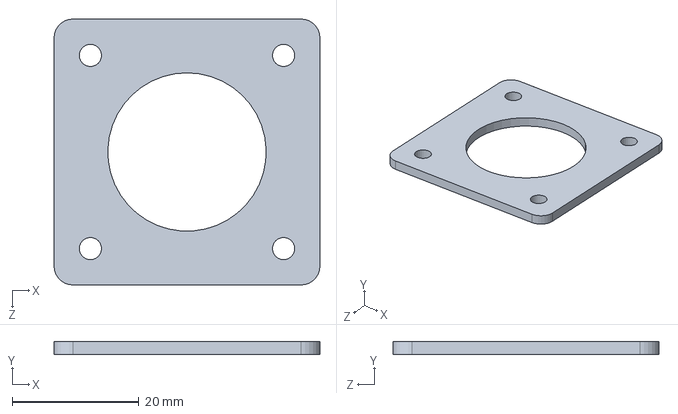
[picture p102: CAD file, 2023-08-07]
SOLIDWORKS/GENERAL/Podkładka pod NEMA17.SLDPRT
42.0 x 2.00 x 42.0 mm
