Fake-Oxygen/3D-PRINTER/SOLIDWORKS/ASSEMBLY/Titan Aero from Aliexpress for GC/JST - PH - Thru (V) - 6Pin - 2.00mm.SLDPRT

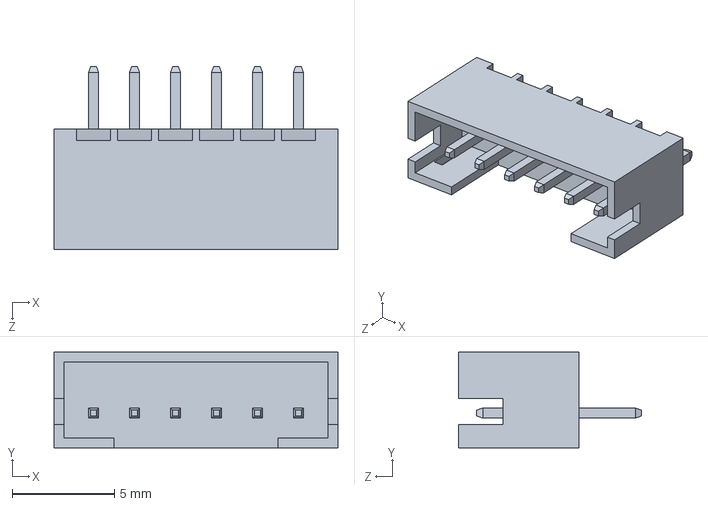
[picture p103: CAD file, 2023-02-11]
SOLIDWORKS/ASSEMBLY/Titan Aero from Aliexpress for GC/JST - PH - Thru (V) - 6Pin - 2.00mm.SLDPRT
13.9 x 4.67 x 8.94 mm
