Fake-Oxygen/3D-PRINTER/SOLIDWORKS/GENERAL/Heating Block.SLDPRT

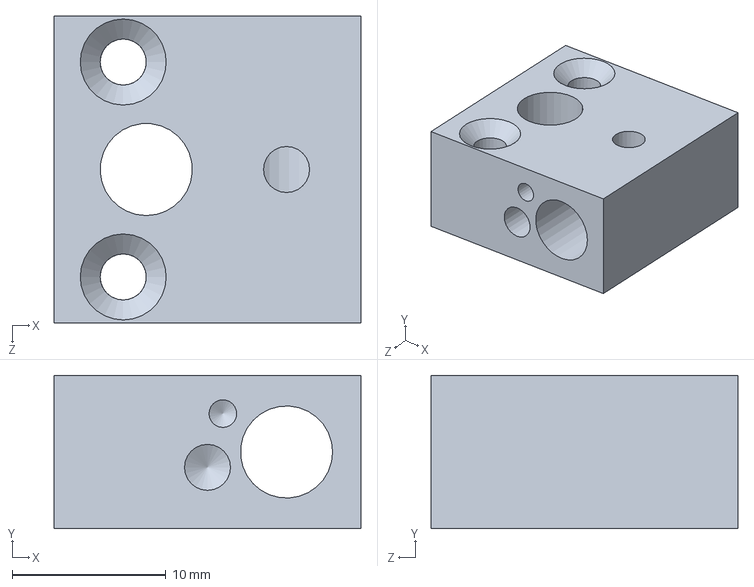
[picture p104: CAD file, 2023-08-07]
SOLIDWORKS/GENERAL/Heating Block.SLDPRT
20.0 x 10.0 x 20.0 mm
