Fake-Oxygen/3D-PRINTER/SOLIDWORKS/SPECIFIC/Plexi side panel.SLDPRT

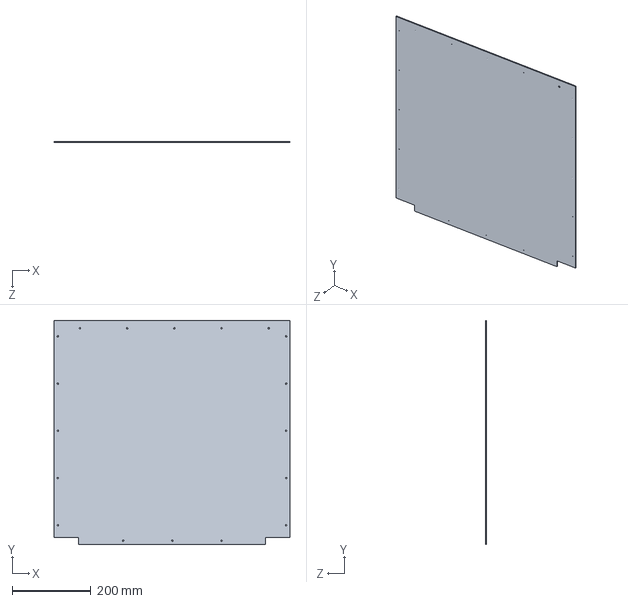
[picture p105: CAD file, 2023-08-07]
SOLIDWORKS/SPECIFIC/Plexi side panel.SLDPRT
600.0 x 570.0 x 3.00 mm
