Fake-Oxygen/3D-PRINTER/SOLIDWORKS/GENERAL/Fan Propeller.SLDPRT

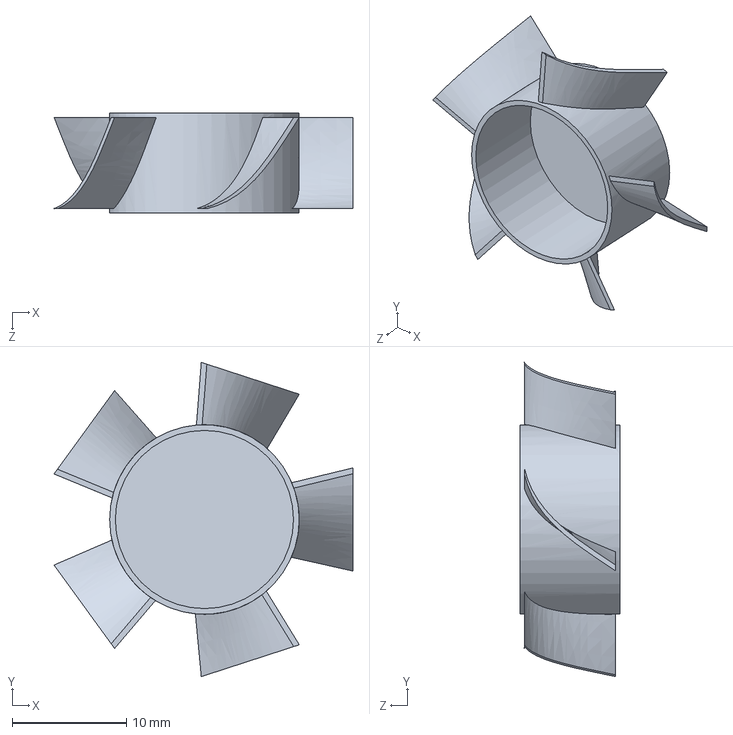
[picture p107: CAD file, 2023-08-07]
SOLIDWORKS/GENERAL/Fan Propeller.SLDPRT
26.2 x 27.5 x 8.75 mm
