Fake-Oxygen/3D-PRINTER/SOLIDWORKS/SPECIFIC/Header fan holder.SLDPRT

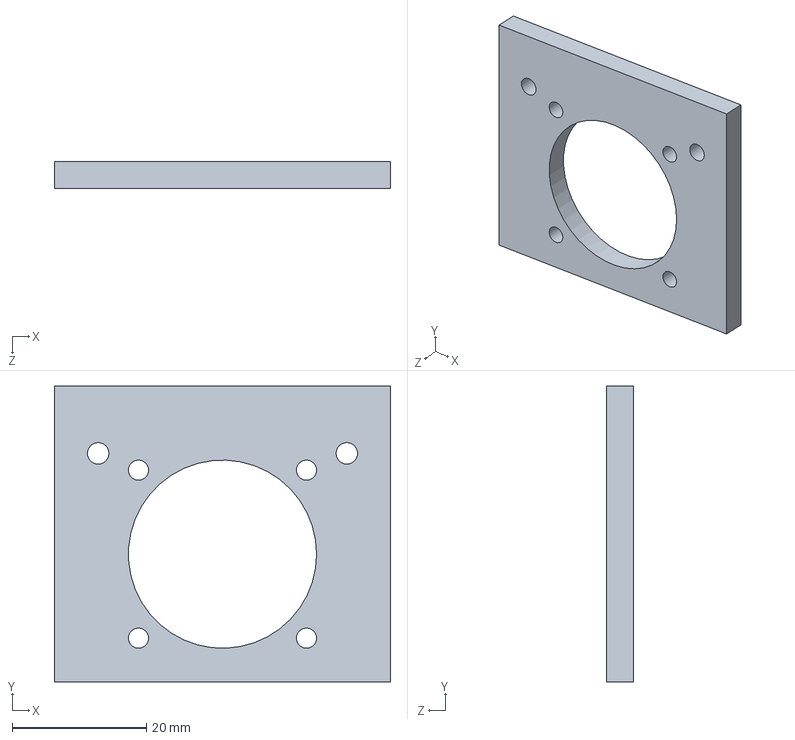
[picture p108: CAD file, 2023-08-07]
SOLIDWORKS/SPECIFIC/Header fan holder.SLDPRT
50.0 x 44.0 x 4.00 mm
