Fake-Oxygen/3D-PRINTER/SOLIDWORKS/GENERAL/idle pulley.SLDPRT

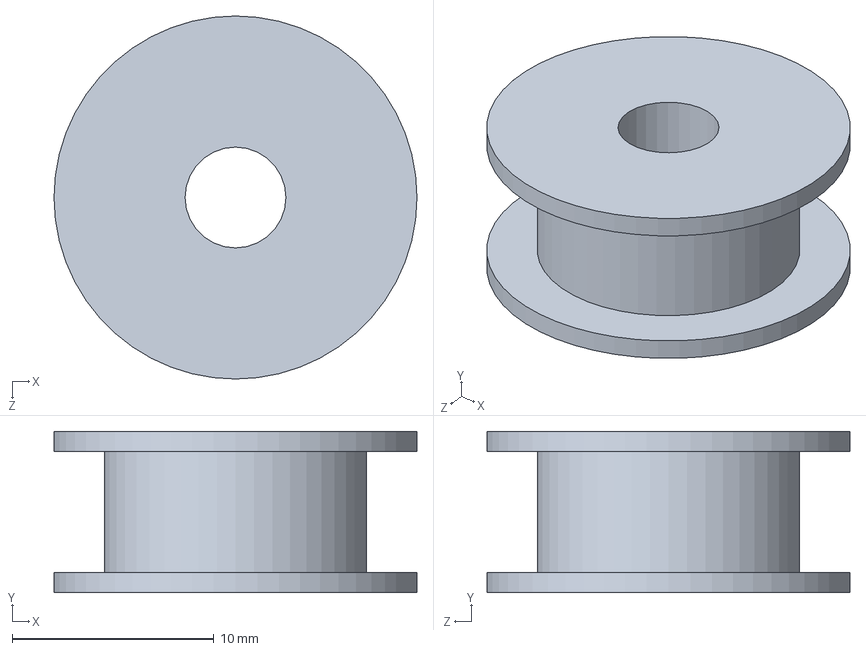
[picture p109: CAD file, 2023-08-07]
SOLIDWORKS/GENERAL/idle pulley.SLDPRT
18.0 x 8.00 x 18.0 mm
