Fake-Oxygen/3D-PRINTER/SOLIDWORKS/SPECIFIC/Pick.SLDPRT

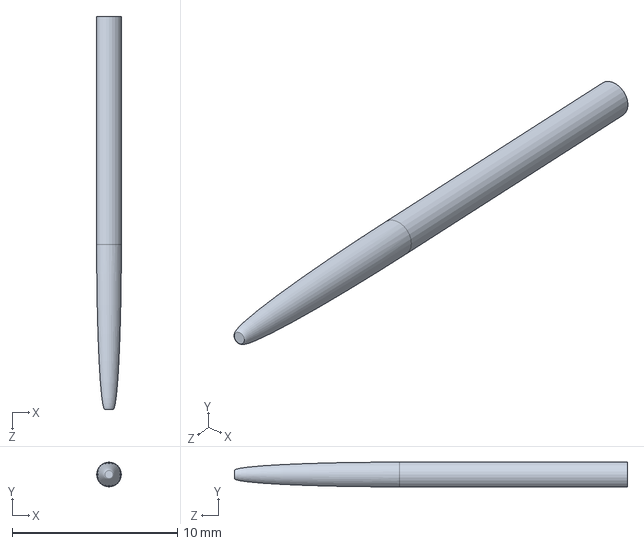
[picture p110: CAD file, 2023-08-07]
SOLIDWORKS/SPECIFIC/Pick.SLDPRT
1.50 x 1.50 x 23.8 mm
