Fake-Oxygen/3D-PRINTER/SOLIDWORKS/GENERAL/fan.SLDPRT

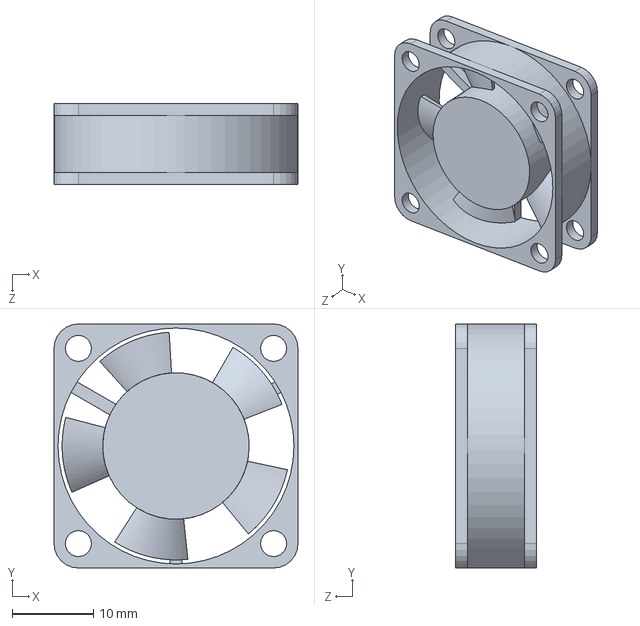
[picture p112: CAD file, 2023-08-07]
SOLIDWORKS/GENERAL/fan.SLDPRT
30.0 x 30.0 x 10.0 mm
