Fake-Oxygen/3D-PRINTER/SOLIDWORKS/SPECIFIC/Side Header Cover.SLDPRT

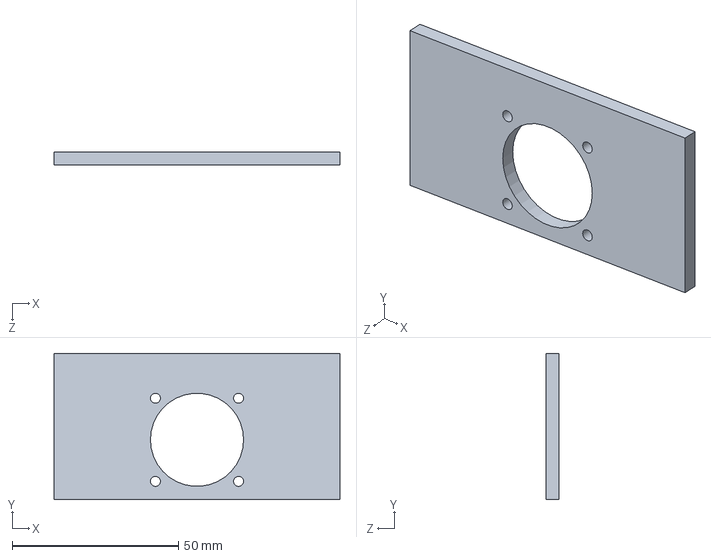
[picture p113: CAD file, 2023-08-07]
SOLIDWORKS/SPECIFIC/Side Header Cover.SLDPRT
86.0 x 44.0 x 4.00 mm
