Fake-Oxygen/3D-PRINTER/SOLIDWORKS/ASSEMBLY/Titan Aero from Aliexpress for GC/Tapa.SLDPRT

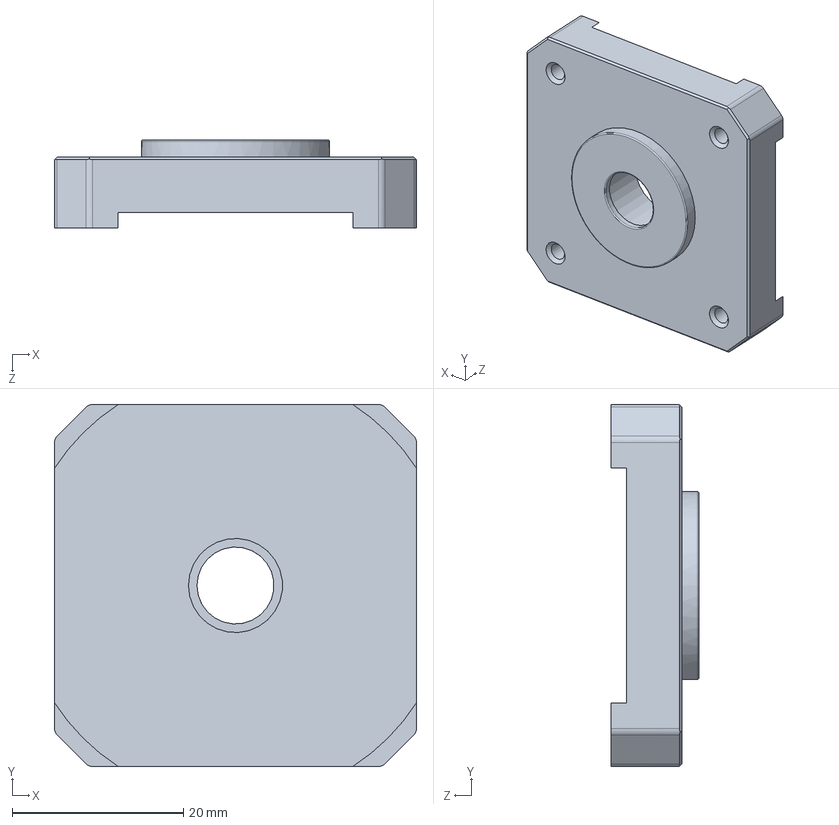
[picture p114: CAD file, 2023-02-11]
SOLIDWORKS/ASSEMBLY/Titan Aero from Aliexpress for GC/Tapa.SLDPRT
42.3 x 42.3 x 10.3 mm
