Fake-Oxygen/3D-PRINTER/SOLIDWORKS/GENERAL/Aluminium panel.SLDPRT

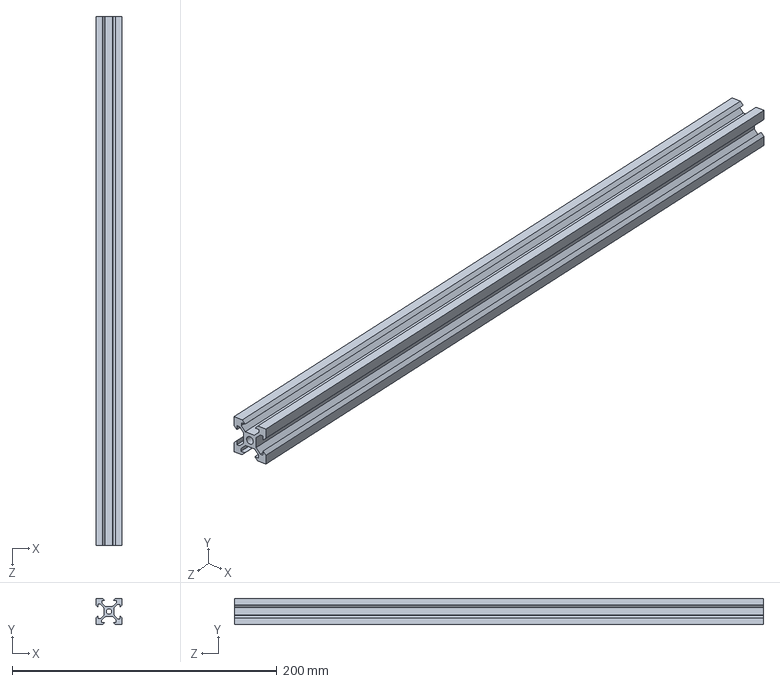
[picture p115: CAD file, 2023-08-07]
SOLIDWORKS/GENERAL/Aluminium panel.SLDPRT
20.0 x 20.0 x 400.0 mm
