Fake-Oxygen/3D-PRINTER/SOLIDWORKS/SPECIFIC/bottom plate v2.SLDPRT

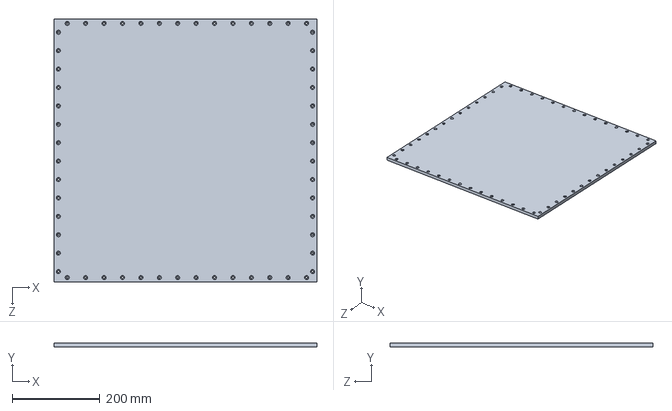
[picture p116: CAD file, 2023-08-07]
SOLIDWORKS/SPECIFIC/bottom plate v2.SLDPRT
600.0 x 10.0 x 600.0 mm
