Fake-Oxygen/3D-PRINTER/SOLIDWORKS/ASSEMBLY/Titan Aero from Aliexpress for GC/PC4-1_8 my edition.SLDPRT

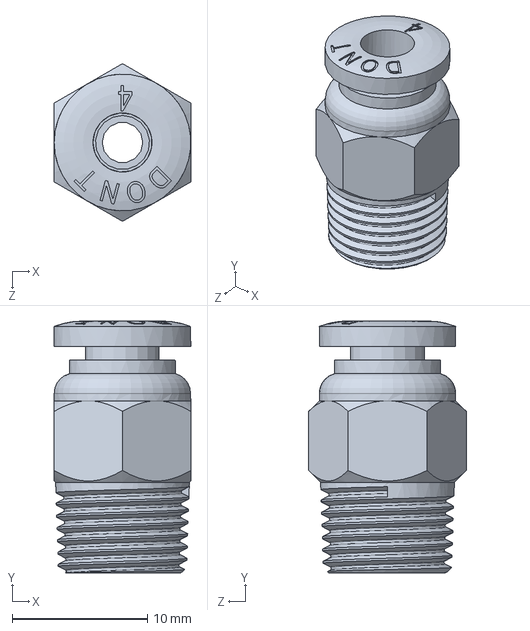
[picture p117: CAD file, 2023-02-11]
SOLIDWORKS/ASSEMBLY/Titan Aero from Aliexpress for GC/PC4-1_8 my edition.SLDPRT
10.1 x 18.6 x 11.7 mm
