Fake-Oxygen/3D-PRINTER/SOLIDWORKS/GENERAL/NEMA17.SLDPRT

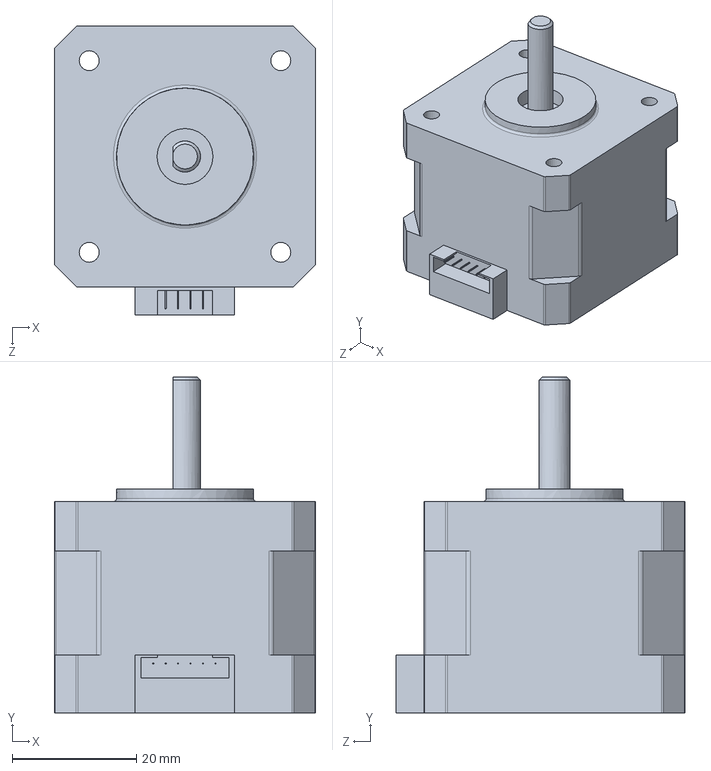
[picture p118: CAD file, 2023-08-07]
SOLIDWORKS/GENERAL/NEMA17.SLDPRT
42.0 x 54.0 x 46.5 mm
