Fake-Oxygen/3D-PRINTER/SOLIDWORKS/ASSEMBLY/Titan Aero from Aliexpress for GC/Shaft.SLDPRT

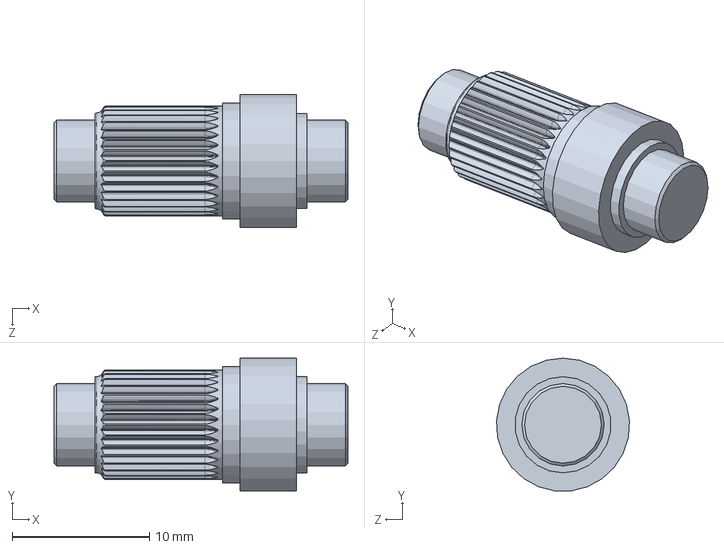
[picture p119: CAD file, 2023-02-11]
SOLIDWORKS/ASSEMBLY/Titan Aero from Aliexpress for GC/Shaft.SLDPRT
21.4 x 9.66 x 9.68 mm
