Fake-Oxygen/3D-PRINTER/SOLIDWORKS/GENERAL/HeatEnd Cooler block.SLDPRT

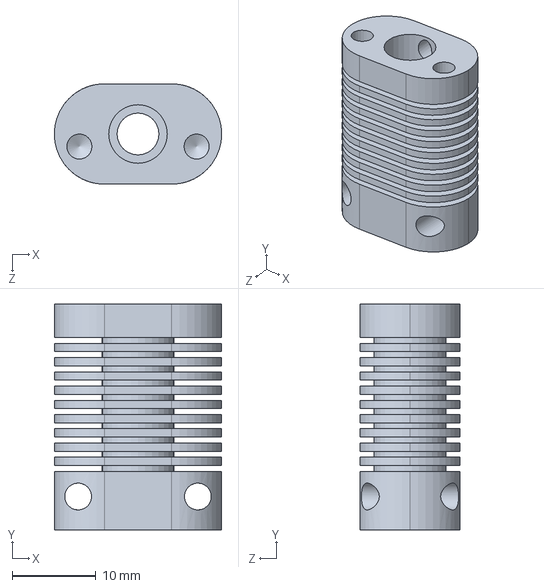
[picture p120: CAD file, 2023-08-07]
SOLIDWORKS/GENERAL/HeatEnd Cooler block.SLDPRT
20.0 x 27.0 x 12.0 mm
