Fake-Oxygen/3D-PRINTER/SOLIDWORKS/GENERAL/MGNxx block.SLDPRT

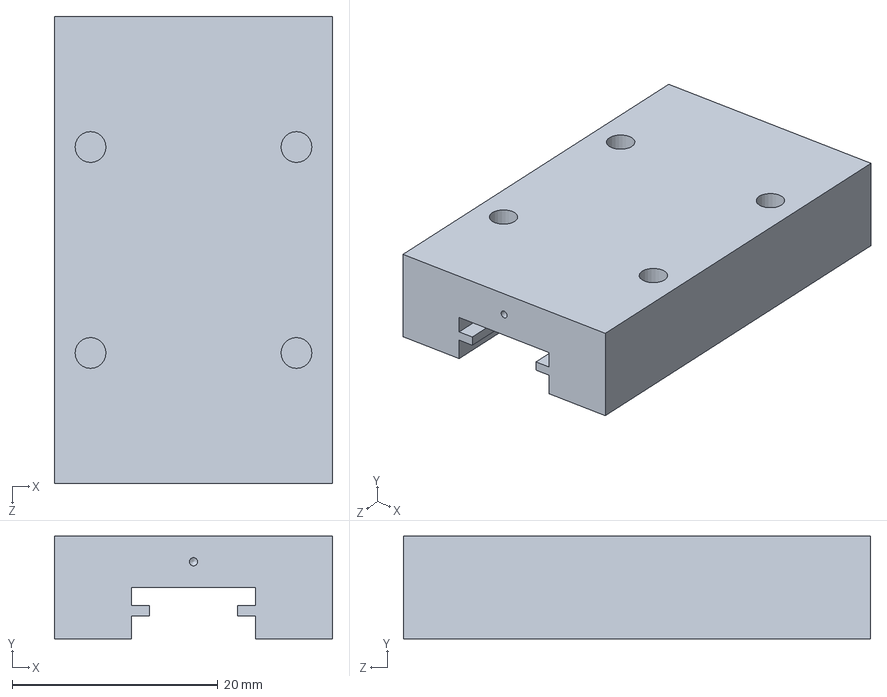
[picture p121: CAD file, 2023-06-17]
SOLIDWORKS/GENERAL/MGNxx block.SLDPRT
27.0 x 10.0 x 45.4 mm
