Fake-Oxygen/3D-PRINTER/SOLIDWORKS/SPECIFIC/Back top plate.SLDPRT

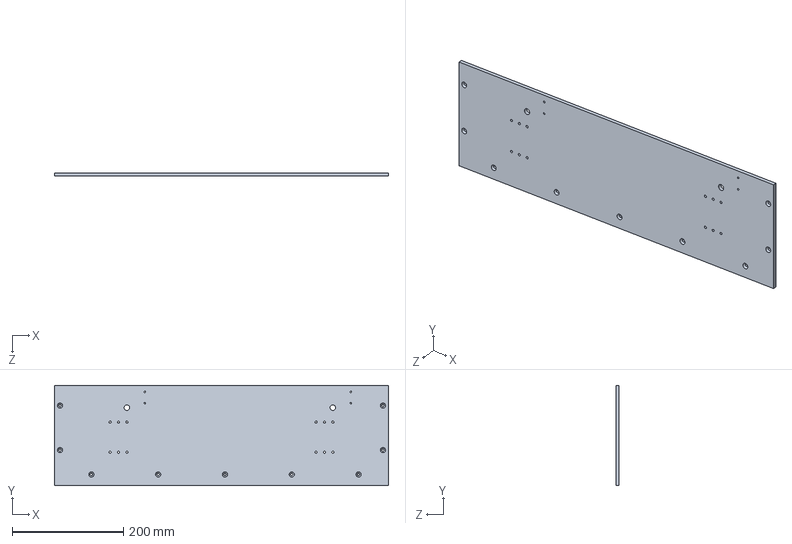
[picture p122: CAD file, 2023-06-17]
SOLIDWORKS/SPECIFIC/Back top plate.SLDPRT
600.0 x 180.0 x 6.00 mm
