Fake-Oxygen/3D-PRINTER/SOLIDWORKS/GENERAL/Carriage for V Slot.SLDPRT

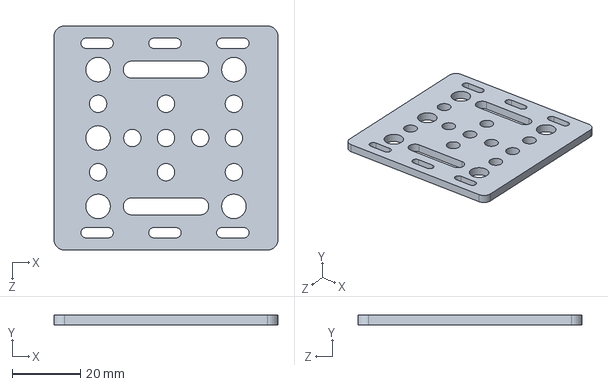
[picture p123: CAD file, 2023-06-17]
SOLIDWORKS/GENERAL/Carriage for V Slot.SLDPRT
65.5 x 3.00 x 65.5 mm
