Fake-Oxygen/3D-PRINTER/SOLIDWORKS/ASSEMBLY/Titan Aero from Aliexpress for GC/B18.6.7M - M3 x 0.5 x 5 Type I Cross Recessed PHMS --5N.sldprt

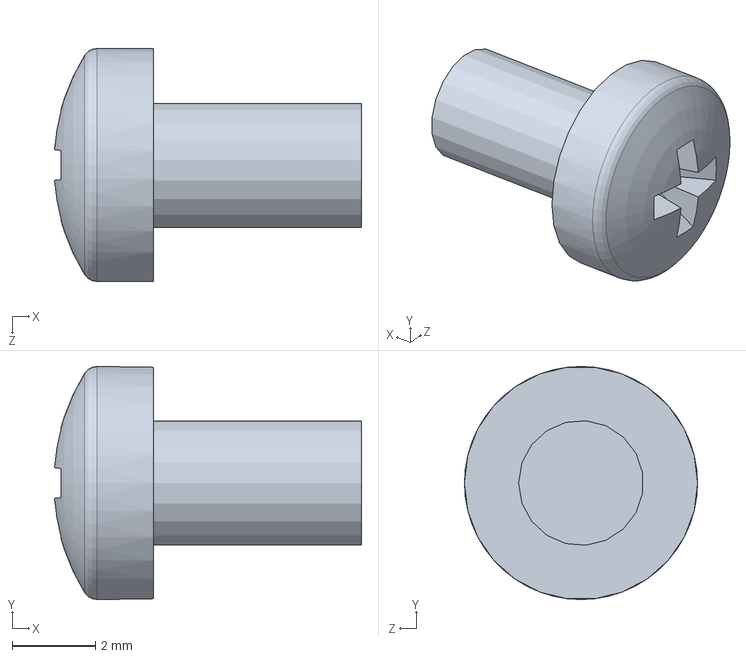
[picture p124: CAD file, 2023-02-11]
SOLIDWORKS/ASSEMBLY/Titan Aero from Aliexpress for GC/B18.6.7M - M3 x 0.5 x 5 Type I Cross Recessed PHMS --5N.sldprt
7.37 x 5.60 x 5.60 mm
