Fake-Oxygen/3D-PRINTER/SOLIDWORKS/GENERAL/Tire for 625ZZ bearing.SLDPRT

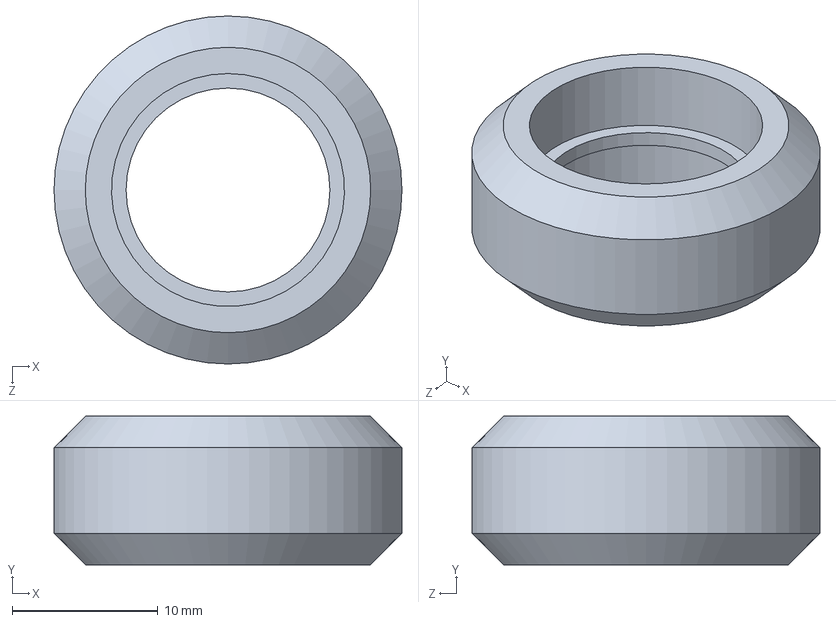
[picture p125: CAD file, 2023-06-17]
SOLIDWORKS/GENERAL/Tire for 625ZZ bearing.SLDPRT
23.9 x 10.2 x 23.9 mm
