Fake-Oxygen/3D-PRINTER/SOLIDWORKS/SPECIFIC/Plug.SLDPRT

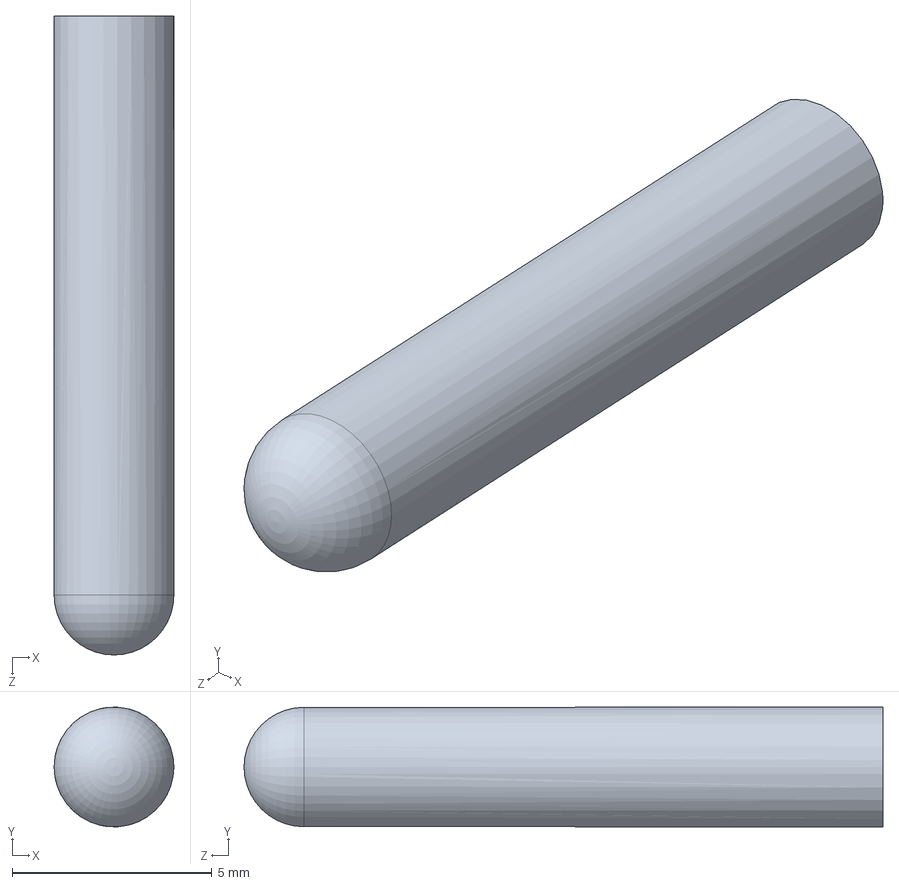
[picture p126: CAD file, 2023-05-07]
SOLIDWORKS/SPECIFIC/Plug.SLDPRT
3.00 x 2.99 x 16.0 mm
