Fake-Oxygen/3D-PRINTER/(list of files, cad)

Other CAD files:
SOLIDWORKS/Assem1.SLDASM
SOLIDWORKS/ASSEMBLY/Header.SLDASM
SOLIDWORKS/ASSEMBLY/Titan Aero from Aliexpress for GC/Nema17 17HS4223.SLDASM
SOLIDWORKS/GENERAL/e3d v6/e3d v6.SLDASM
SOLIDWORKS/GENERAL/Rail with block.SLDASM
SOLIDWORKS/ASSEMBLY/Hot Bed.SLDASM
SOLIDWORKS/ASSEMBLY/Titan Aero from Aliexpress for GC/Shaft and gear.SLDASM
SOLIDWORKS/GENERAL/camera/Camera.SLDASM
SOLIDWORKS/GENERAL/e3d v6/fanduct.SLDASM
SOLIDWORKS/ASSEMBLY/Titan Aero from Aliexpress for GC/Titan_aero_Aliexpress.SLDASM
SOLIDWORKS/ASSEMBLY/Z Axis v2.SLDASM
SOLIDWORKS/GENERAL/e3d v6/fan.SLDASM
SOLIDWORKS/ASSEMBLY/Frame.SLDASM
SOLIDWORKS/ASSEMBLY/Titan Aero from Aliexpress for GC/Rocker_ASMBL.SLDASM
SOLIDWORKS/GENERAL/4.3inch Capacitive Touch LCD 3D Drawing/Display.SLDASM
SOLIDWORKS/ASSEMBLY/Full Assembly.SLDASM
SOLIDWORKS/ASSEMBLY/Fan.SLDASM
SOLIDWORKS/ASSEMBLY/Heat End.SLDASM
SOLIDWORKS/ASSEMBLY/Head Assembly.SLDASM
SOLIDWORKS/ASSEMBLY/Side pulley assembly.SLDASM
SOLIDWORKS/GENERAL/Wheel for guideway.SLDASM
SOLIDWORKS/ASSEMBLY/Z End Stop.SLDASM
SOLIDWORKS/ASSEMBLY/V Slot Carriage Assembly.SLDASM
SOLIDWORKS/GENERAL/Assem2.SLDASM
SOLIDWORKS/ASSEMBLY/XY Axis assembly.SLDASM
SOLIDWORKS/ASSEMBLY/TRONXY TITAN EXTRUDER .SLDASM
SOLIDWORKS/ASSEMBLY/Filament sensor.SLDASM
SOLIDWORKS/ASSEMBLY/Back Belt Drive.SLDASM
SOLIDWORKS/ASSEMBLY/Turbine.SLDASM
SOLIDWORKS/ASSEMBLY/Aluminium panel with connectors.SLDASM
SOLIDWORKS/GENERAL/TRONXY TITAN EXTRUDER .SLDASM
SOLIDWORKS/GENERAL/Mini Interruptor v22.step.SLDASM
SOLIDWORKS/GENERAL/4.3inch Capacitive Touch LCD 3D Drawing/Holding bracket.SLDPRT
SOLIDWORKS/STL/Front frame.STL
SOLIDWORKS/SPECIFIC/Bearing holder Z axis.SLDPRT
SOLIDWORKS/GENERAL/LMK_seri/LMK10.SLDPRT
SOLIDWORKS/STL/Door blocker.STL
SOLIDWORKS/GENERAL/Blower fan holder.SLDPRT
SOLIDWORKS/GENERAL/e3d v6/e3d nozzle (0.2).SLDPRT
SOLIDWORKS/STL/Back plate.STL
SOLIDWORKS/GENERAL/e3d v6/e3d nozzle (0.6).SLDPRT
SOLIDWORKS/GENERAL/e3d v6/e3d nozzle (0.1).SLDPRT
SOLIDWORKS/SPECIFIC/Header fan holder plate v2.SLDPRT
SOLIDWORKS/STL/Camera stand.STL
SOLIDWORKS/GENERAL/e3d v6/e3d nozzle (0.3).SLDPRT
SOLIDWORKS/SPECIFIC/Cover for rail.SLDPRT
SOLIDWORKS/GENERAL/e3d v6/e3d nozzle (0.5).SLDPRT
SOLIDWORKS/SPECIFIC/Header holder bracket.SLDPRT
SOLIDWORKS/SPECIFIC/FanDut.SLDPRT
SOLIDWORKS/SPECIFIC/rail cover.SLDPRT
SOLIDWORKS/SPECIFIC/Top cover for side pulleys.SLDPRT
SOLIDWORKS/ASSEMBLY/Titan Aero from Aliexpress for GC/AFBMA 12.1.4.1 - 0050-11 - 10,SI,NC,10_68.sldprt
SOLIDWORKS/ASSEMBLY/Titan Aero from Aliexpress for GC/Cup.SLDPRT
SOLIDWORKS/ASSEMBLY/Titan Aero from Aliexpress for GC/Eje.SLDPRT
SOLIDWORKS/ASSEMBLY/Titan Aero from Aliexpress for GC/ISO 4029 - M3 x 3-C.sldprt
SOLIDWORKS/ASSEMBLY/Titan Aero from Aliexpress for GC/ISO 7380 - M3 x 25 - 12C.sldprt
SOLIDWORKS/ASSEMBLY/Titan Aero from Aliexpress for GC/ISO 7380 - M3 x 32 - 12C.sldprt
SOLIDWORKS/ASSEMBLY/Titan Aero from Aliexpress for GC/ISO 7380 - M3 x 8 - 8C.sldprt
SOLIDWORKS/ASSEMBLY/Titan Aero from Aliexpress for GC/MR95ZZ.SLDPRT
SOLIDWORKS/ASSEMBLY/Titan Aero from Aliexpress for GC/Nut M4 - 4,5 mm.sldprt
SOLIDWORKS/ASSEMBLY/Titan Aero from Aliexpress for GC/Rocker.SLDPRT
SOLIDWORKS/ASSEMBLY/Titan Aero from Aliexpress for GC/Thumbscrew.SLDPRT
SOLIDWORKS/ASSEMBLY/Z Axis.SLDASM
SOLIDWORKS/ASSEMBLY/t8 preload nut.step
SOLIDWORKS/DRAWINGS/Back Header Cover.SLDDRW
SOLIDWORKS/DRAWINGS/Bearing holder cover.SLDDRW
SOLIDWORKS/DRAWINGS/Bearing holder.SLDDRW
SOLIDWORKS/DRAWINGS/Bottom-Top Plate.SLDDRW
SOLIDWORKS/DRAWINGS/Head Holder.SLDDRW
SOLIDWORKS/DRAWINGS/Header fan holder.SLDDRW
SOLIDWORKS/DRAWINGS/Hot Bed.SLDDRW
SOLIDWORKS/DRAWINGS/Left Y Carriage Plate.SLDDRW
SOLIDWORKS/DRAWINGS/Middle Y Carriage Plate.SLDDRW
SOLIDWORKS/DRAWINGS/Right Y Carriage Plate.SLDDRW
SOLIDWORKS/DRAWINGS/Set1.SLDDRW
SOLIDWORKS/DRAWINGS/Set2.SLDDRW
SOLIDWORKS/DRAWINGS/Side Header Cover.SLDDRW
SOLIDWORKS/DRAWINGS/Stabilizer.SLDDRW
SOLIDWORKS/GENERAL/1.75mm-filament-spool.step
SOLIDWORKS/GENERAL/1.stp.SLDPRT
SOLIDWORKS/GENERAL/2.stp.SLDPRT
SOLIDWORKS/GENERAL/2020/Slider T-Nut for 2020 - M3.f3d
SOLIDWORKS/GENERAL/2020/Slider T-Nut for 2020 - M3.iges
SOLIDWORKS/GENERAL/2020/Slider T-Nut for 2020 - M3.step
SOLIDWORKS/GENERAL/2020/Slider T-Nut for 2020 - M4.f3d
SOLIDWORKS/GENERAL/2020/Slider T-Nut for 2020 - M4.iges
SOLIDWORKS/GENERAL/2020/Slider T-Nut for 2020 - M4.step
SOLIDWORKS/GENERAL/2020/Slider T-Nut for 2020 - M5.f3d
SOLIDWORKS/GENERAL/2020/Slider T-Nut for 2020 - M5.iges
SOLIDWORKS/GENERAL/2020/Slider T-Nut for 2020 - M5.step
SOLIDWORKS/GENERAL/2020/Slider T-Nut for 2020 - M5.step.SLDPRT
SOLIDWORKS/GENERAL/3.stp.SLDPRT
SOLIDWORKS/GENERAL/30x38 2020 HINGE v2.step
SOLIDWORKS/GENERAL/4.3inch Capacitive Touch LCD 3D Drawing/display.SLDPRT
SOLIDWORKS/GENERAL/BLTouch-Smart V3.1.step
SOLIDWORKS/GENERAL/CTI20-01 - Cantoneira interna base 20 v-slot.SLDPRT
SOLIDWORKS/GENERAL/Capsula Fusivel.step.SLDPRT
SOLIDWORKS/GENERAL/Case.step.SLDPRT
SOLIDWORKS/GENERAL/Component27.step.SLDPRT
SOLIDWORKS/GENERAL/Component28.step.SLDPRT
SOLIDWORKS/GENERAL/Component29.step.SLDPRT
SOLIDWORKS/GENERAL/Component32.step.SLDPRT
SOLIDWORKS/GENERAL/Component52.step.SLDPRT
SOLIDWORKS/GENERAL/Con 1.step.SLDPRT
SOLIDWORKS/GENERAL/Con 2.step.SLDPRT
SOLIDWORKS/GENERAL/Con 3.step.SLDPRT
SOLIDWORKS/GENERAL/Con 4.step.SLDPRT
SOLIDWORKS/GENERAL/Cont1.step.SLDPRT
SOLIDWORKS/GENERAL/Cont2.step.SLDPRT
SOLIDWORKS/GENERAL/Cover 1.SLDPRT
SOLIDWORKS/GENERAL/Dystans.SLDPRT
SOLIDWORKS/GENERAL/Encapsulamento.step.SLDPRT
SOLIDWORKS/GENERAL/Filament_Sensor_1.75mm.stp
SOLIDWORKS/GENERAL/Filament_Sensor_1.75mm.stp.SLDPRT
SOLIDWORKS/GENERAL/Fusivel.step.SLDPRT
SOLIDWORKS/GENERAL/GT2 Belt.SLDPRT
SOLIDWORKS/GENERAL/GT2 Belt.smg.SLDPRT
SOLIDWORKS/GENERAL/Interruptor.step.SLDPRT
SOLIDWORKS/GENERAL/Kopia Bolt Washer.SLDPRT
SOLIDWORKS/GENERAL/Kopia Nut.SLDPRT
SOLIDWORKS/GENERAL/L Shape profile connector.SLDPRT
SOLIDWORKS/GENERAL/LED STRIP.SLDPRT
SOLIDWORKS/GENERAL/LMK_seri/LMKAssem1.SLDASM
SOLIDWORKS/GENERAL/Lampada.step.SLDPRT
SOLIDWORKS/GENERAL/MGNxx rail.SLDPRT
SOLIDWORKS/GENERAL/Mola 1.step.SLDPRT
SOLIDWORKS/GENERAL/Mola 2.step.SLDPRT
SOLIDWORKS/GENERAL/PTFE tube connector.SLDPRT
SOLIDWORKS/GENERAL/Part3.SLDPRT
SOLIDWORKS/GENERAL/Plexi Panel.SLDPRT
SOLIDWORKS/GENERAL/Power supply/countersunk flat head cross recess screw_iso.SLDPRT
SOLIDWORKS/GENERAL/Power supply/pan head cross recess screw_iso.SLDPRT
SOLIDWORKS/GENERAL/Radial Cooling Fan 50mm DC12V/Radial-Cooling-Fan-5015-DC12V.SLDASM
SOLIDWORKS/GENERAL/Reinforcement.SLDPRT
SOLIDWORKS/GENERAL/Rod.SLDPRT
SOLIDWORKS/GENERAL/SS-5GL.SLDPRT
SOLIDWORKS/GENERAL/Screw Pan M3.SLDPRT
SOLIDWORKS/GENERAL/Serigrafia 0.step.SLDPRT
SOLIDWORKS/GENERAL/Serigrafia 1.step.SLDPRT
SOLIDWORKS/GENERAL/Spacer M5 6mm.SLDPRT
SOLIDWORKS/GENERAL/Speaker.SLDPRT
SOLIDWORKS/GENERAL/Turbine Housing Bot.SLDPRT
SOLIDWORKS/GENERAL/Turbine Housing Top.SLDPRT
SOLIDWORKS/GENERAL/Turbine propeller.SLDPRT
SOLIDWORKS/GENERAL/Zasilacz WIP.SLDPRT
SOLIDWORKS/GENERAL/angular connector for 2020.SLDPRT
SOLIDWORKS/GENERAL/e3d v6/fan duct.SLDPRT
SOLIDWORKS/GENERAL/spacer.SLDPRT
SOLIDWORKS/GENERAL/t8 preload nut.step.SLDPRT
SOLIDWORKS/SPECIFIC/Back Header Cover.SLDPRT
SOLIDWORKS/SPECIFIC/Back belt holder.SLDPRT
SOLIDWORKS/SPECIFIC/Bearing Holder.SLDPRT
SOLIDWORKS/SPECIFIC/Bearing Holder.STL
SOLIDWORKS/SPECIFIC/Bearing holder cover.SLDPRT
SOLIDWORKS/SPECIFIC/Belt holder.STL
SOLIDWORKS/SPECIFIC/Belt protector in.STL
SOLIDWORKS/SPECIFIC/Bottom Leg.SLDPRT
SOLIDWORKS/SPECIFIC/Bottom Plate Support Bar.SLDPRT
SOLIDWORKS/SPECIFIC/Bottom support bar.SLDPRT
SOLIDWORKS/SPECIFIC/Bottom-Top Plate.SLDPRT
SOLIDWORKS/SPECIFIC/FanDuct.SLDPRT
SOLIDWORKS/SPECIFIC/Filament holder rod support.SLDPRT
SOLIDWORKS/SPECIFIC/Filament holder rod support.STL
SOLIDWORKS/SPECIFIC/Head Holder v2.STL
SOLIDWORKS/SPECIFIC/Head Holder.SLDPRT
SOLIDWORKS/SPECIFIC/Head Holder.STL
SOLIDWORKS/SPECIFIC/Header fan holder plate v2.STL
SOLIDWORKS/SPECIFIC/Header fan holder plate.SLDPRT
SOLIDWORKS/SPECIFIC/Header holder bracket.STL
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
