Fake-Oxygen/3D-PRINTER/IMAGES/3D Printer-Specific.jpg

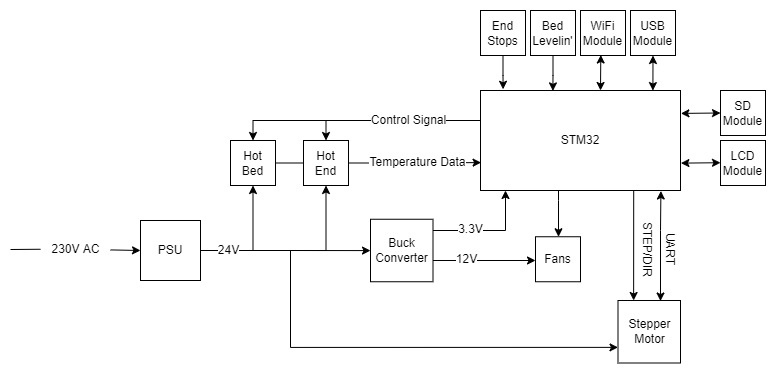
IMAGES/3D Printer-Specific.jpg
