Fake-Oxygen/3D-PRINTER/IMAGES/full assembly.JPG

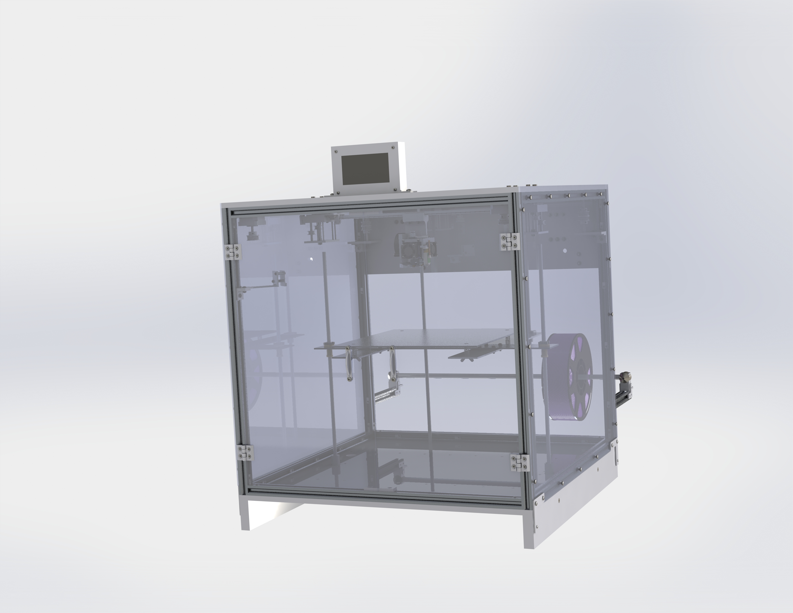
IMAGES/full assembly.JPG
