Fake-Oxygen/3D-PRINTER/SOLIDWORKS/ASSEMBLY/Titan Aero from Aliexpress for GC/Render/Probe1.JPG

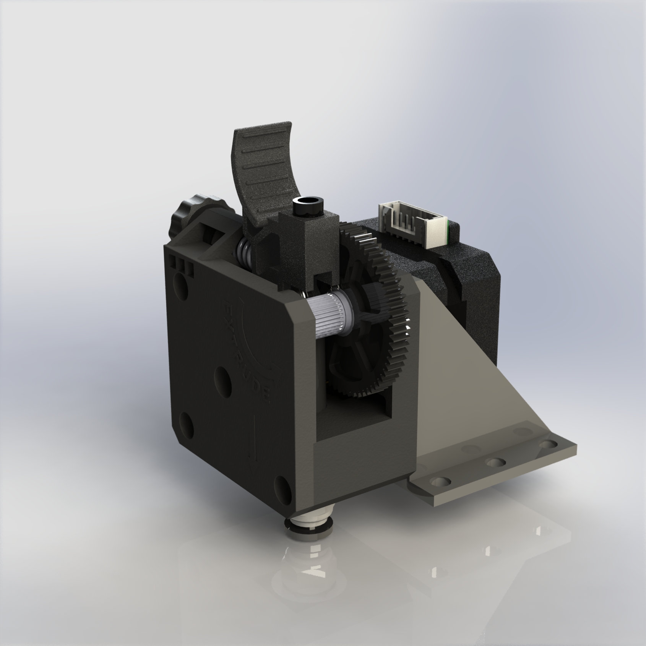
SOLIDWORKS/ASSEMBLY/Titan Aero from Aliexpress for GC/Render/Probe1.JPG
