Fake-Oxygen/3D-PRINTER/SOLIDWORKS/ASSEMBLY/Titan Aero from Aliexpress for GC/Render/Probe4 disassembly_1.jpg

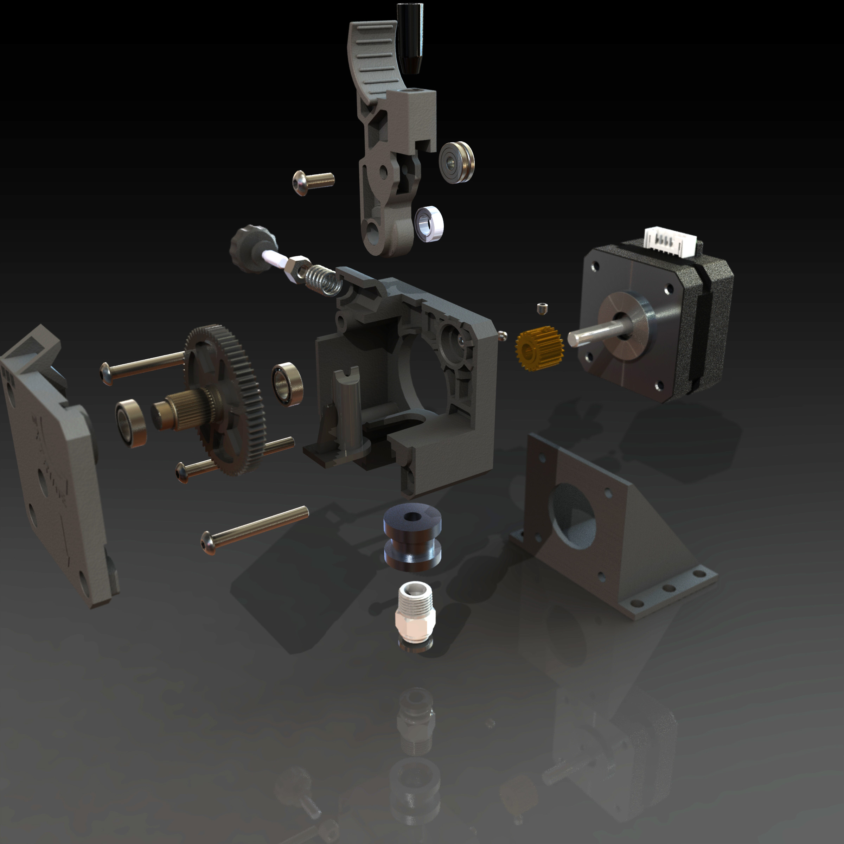
SOLIDWORKS/ASSEMBLY/Titan Aero from Aliexpress for GC/Render/Probe4 disassembly_1.jpg
