Fake-Oxygen/3D-PRINTER/TESTS/printer.png

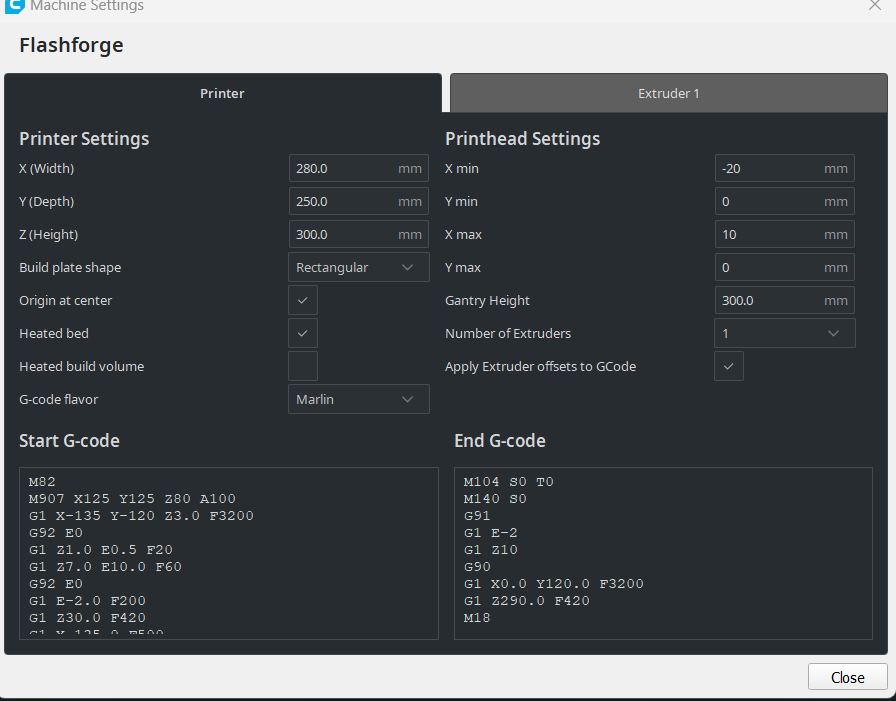
TESTS/printer.png
