Fake-Oxygen/3D-PRINTER/TESTS/Book1.xlsx

Sheet: data
Column1 | Column1.1 | Column1.2 | Column2.1 | Column2.2 | Column3 | Column4 | Column5 | Column6
0 | bed | 30.77 | outb | 100 | he0:32.34 | outhe0:100 | he1:32.61 | outhe1:100
1 | bed | 30.65 | outb | 100 | he0:32.34 | outhe0:100 | he1:32.71 | outhe1:100
2 | bed | 30.69 | outb | 100 | he0:32.36 | outhe0:100 | he1:32.58 | outhe1:100
3 | bed | 30.68 | outb | 100 | he0:32.33 | outhe0:100 | he1:32.59 | outhe1:100
4 | bed | 30.69 | outb | 100 | he0:32.34 | outhe0:100 | he1:32.85 | outhe1:100
5 | bed | 30.68 | outb | 100 | he0:32.63 | outhe0:100 | he1:32.88 | outhe1:100
6 | bed | 30.68 | outb | 100 | he0:32.37 | outhe0:100 | he1:32.90 | outhe1:100
7 | bed | 30.68 | outb | 100 | he0:32.36 | outhe0:100 | he1:32.60 | outhe1:100
8 | bed | 30.68 | outb | 100 | he0:32.34 | outhe0:100 | he1:32.59 | outhe1:100
9 | bed | 30.68 | outb | 100 | he0:32.42 | outhe0:100 | he1:32.86 | outhe1:100
10 | bed | 30.68 | outb | 100 | he0:32.62 | outhe0:100 | he1:32.89 | outhe1:100
11 | bed | 30.68 | outb | 100 | he0:32.33 | outhe0:100 | he1:32.91 | outhe1:100
12 | bed | 30.68 | outb | 100 | he0:32.34 | outhe0:100 | he1:32.56 | outhe1:100
13 | bed | 30.69 | outb | 100 | he0:32.34 | outhe0:100 | he1:32.71 | outhe1:100
14 | bed | 30.68 | outb | 100 | he0:32.55 | outhe0:100 | he1:32.86 | outhe1:100
15 | bed | 30.68 | outb | 100 | he0:32.64 | outhe0:100 | he1:32.89 | outhe1:100
16 | bed | 30.67 | outb | 100 | he0:32.35 | outhe0:100 | he1:32.60 | outhe1:100
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
1463 | bed | 45.81 | outb | 100 | he0:32.73 | outhe0:100 | he1:32.99 | outhe1:100
1464 | bed | 45.82 | outb | 100 | he0:32.74 | outhe0:100 | he1:33.03 | outhe1:100
1465 | bed | 45.83 | outb | 100 | he0:32.44 | outhe0:100 | he1:32.99 | outhe1:100
1466 | bed | 45.85 | outb | 100 | he0:32.47 | outhe0:100 | he1:32.68 | outhe1:100
1467 | bed | 45.85 | outb | 100 | he0:32.51 | outhe0:100 | he1:32.68 | outhe1:100
1468 | bed | 45.86 | outb | 100 | he0:32.47 | outhe0:100 | he1:33.03 | outhe1:100
1469 | bed | 45.88 | outb | 100 | he0:32.78 | outhe0:100 | he1:33.00 | outhe1:100
1470 | bed | 45.88 | outb | 100 | he0:32.70 | outhe0:100 | he1:32.99 | outhe1:100
1471 | bed | 45.89 | outb | 100 | he0:32.47 | outhe0:100 | he1:32.97 | outhe1:100
1472 | bed | 45.91 | outb | 100 | he0:32.49 | outhe0:100 | he1:32.70 | outhe1:100
1473 | bed | 45.92 | outb | 100 | he0:32.48 | outhe0:100 | he1:32.71 | outhe1:100
1474 | bed | 45.93 | outb | 100 | he0:32.53 | outhe0:100 | he1:32.98 | outhe1:100
1475 | bed | 45.95 | outb | 100 | he0:32.77 | outhe0:100 | he1:32.95 | outhe1:100
1476 | bed | 45.95 | outb | 100 | he0:32.50 | outhe0:100 | he1:33.01 | outhe1:100
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
