Fake-Oxygen/3D-PRINTER/COLLECTED DATA/STEPPER MOTOR DRIVER TEST.xlsx

Sterownik | Napięcie | Natężenie | Prędkość | Stepping | Ragged?
 |  | 0.85 | 50 | 1 | SLIGHTLY
 |  | 0.84 | 100 | 1 | NO
A4988 | 24V | 0.82 | 200 | 1 | NO | SLIGHTLY=NOISE
A4988 | 24V | 0.78 | 400 | 1 | NO
 |  | 0.66 | 600 | ` | NO | DRV8825 | > | A4988
 |  | 0.55 | 800 |  | NO
 |  | 0.45 | 1000 |  | NO
 |  | 0.36 | 1200 |  | NO
 |  | 0.28 | 1400 |  | NO
 |  | 0.82 | 50 | 1/2 | SLIGHTLY
 |  | 0.82 | 100 |  | SLIGHTLY
 |  | 0.81 | 200 |  | NO
 |  | 0.8 | 400 |  | NO
 |  | 0.72 | 1200 |  | NO
 |  | 0.47 | 2000 |  | NO
 |  | 0.3 | 3000 |  | No
 |  | 0.8 | 50 | 1/4 | SLIGHTLY
 |  | 0.8 | 200 |  | NO
 |  | 0.8 | 1000 |  | NO
 |  | 0.79 | 2000 |  | NO
 |  | 0.8 | 50 | 1/8 | SLIGHTLY
