Fake-Oxygen/3D-PRINTER/TESTS/extruder.png

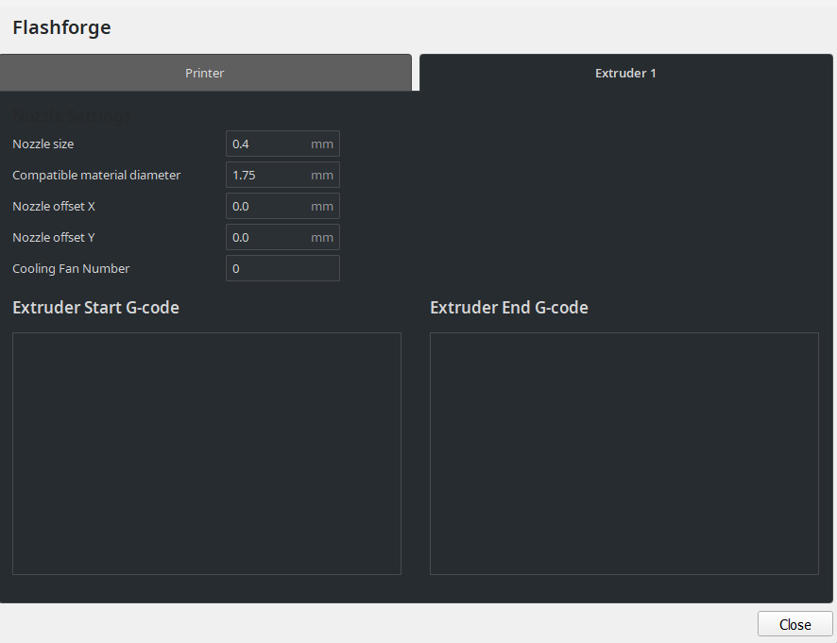
TESTS/extruder.png
