Fake-Oxygen/3D-PRINTER/SOLIDWORKS/BOM.pdf

Hex Socket Cone Pt. SS --
Type I Cross Recessed
FHMS --10N
