Fake-Oxygen/3D-PRINTER/DRAWINGS/Header fan holder.pdf

2

3

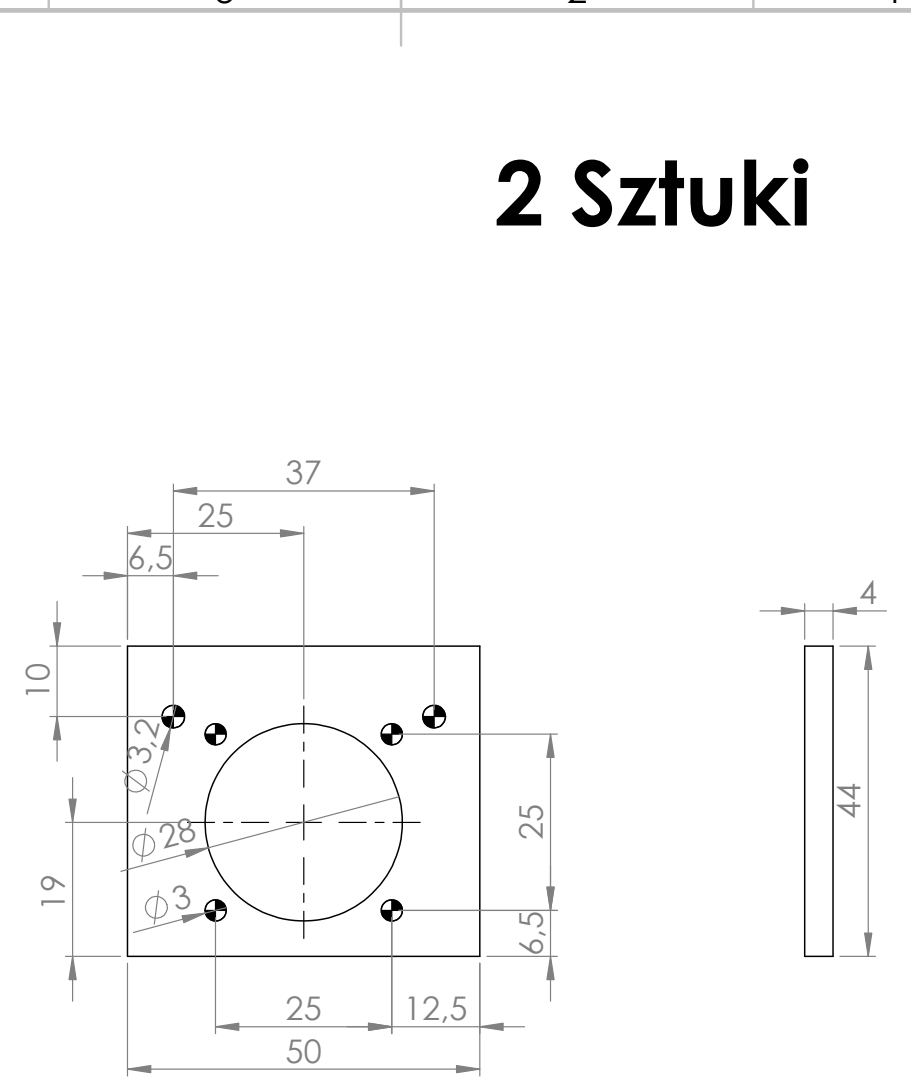
[picture p134: page 1]
MFG; FINISH:; EDGES; NAME; SIGNATURE; DATE; MATERIAL:; DO NOT SCALE DRAWING; REVISION; TITLE:; SCALE:1:1; SHEET 1 OF 1; DEBURR AND BREAK SHARP; 2 Sztuki 44

UNLESS OTHERWISE SPECIFIED:
DIMENSIONS ARE IN MILLIMETERS
SURFACE FINISH:
TOLERANCES:
LINEAR:
ANGULAR:

APPV'D | WEIGHT: DRAWN
CHK'D

DWG NO.
Header fan holder
