Fake-Oxygen/3D-PRINTER/DRAWINGS/Back Header Cover.pdf

E E

F F

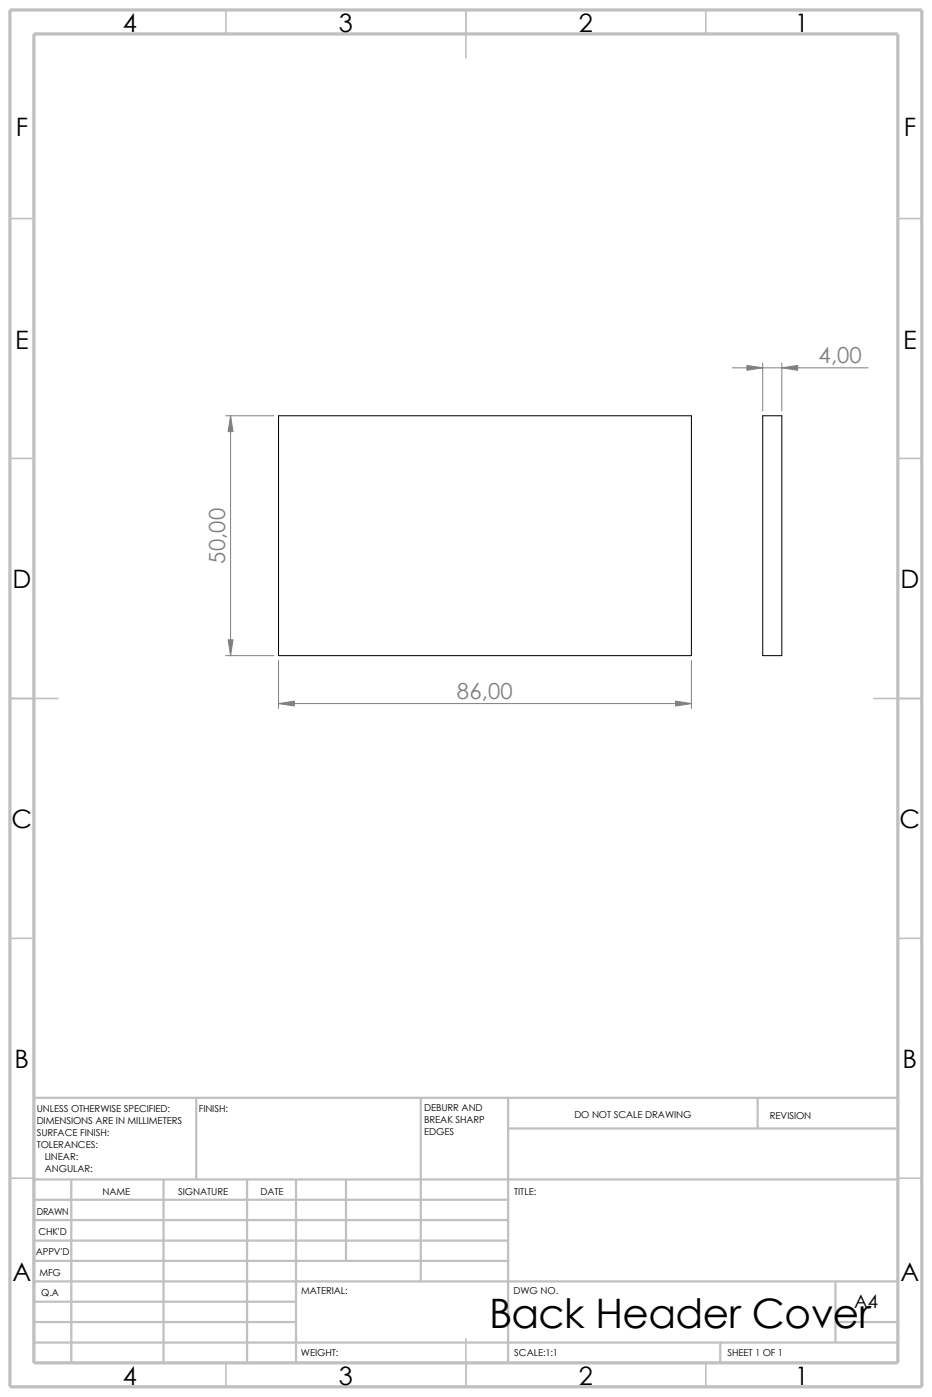
[picture p135: page 1]
SHEET 1 OF 1; WEIGHT:; SCALE:1:1; DO NOT SCALE DRAWING; REVISION; MFG; FINISH:; EDGES; MATERIAL:; DEBURR AND BREAK SHARP

UNLESS OTHERWISE SPECIFIED:
DIMENSIONS ARE IN MILLIMETERS
SURFACE FINISH:
TOLERANCES:
LINEAR:
ANGULAR:

NAME | SIGNATURE | DATE | TITLE:

DRAWN
CHK'D
APPV'D

DWG NO.
Back Header Cover
