Fake-Oxygen/3D-PRINTER/DRAWINGS/Bearing holder cover.pdf

E E

F F

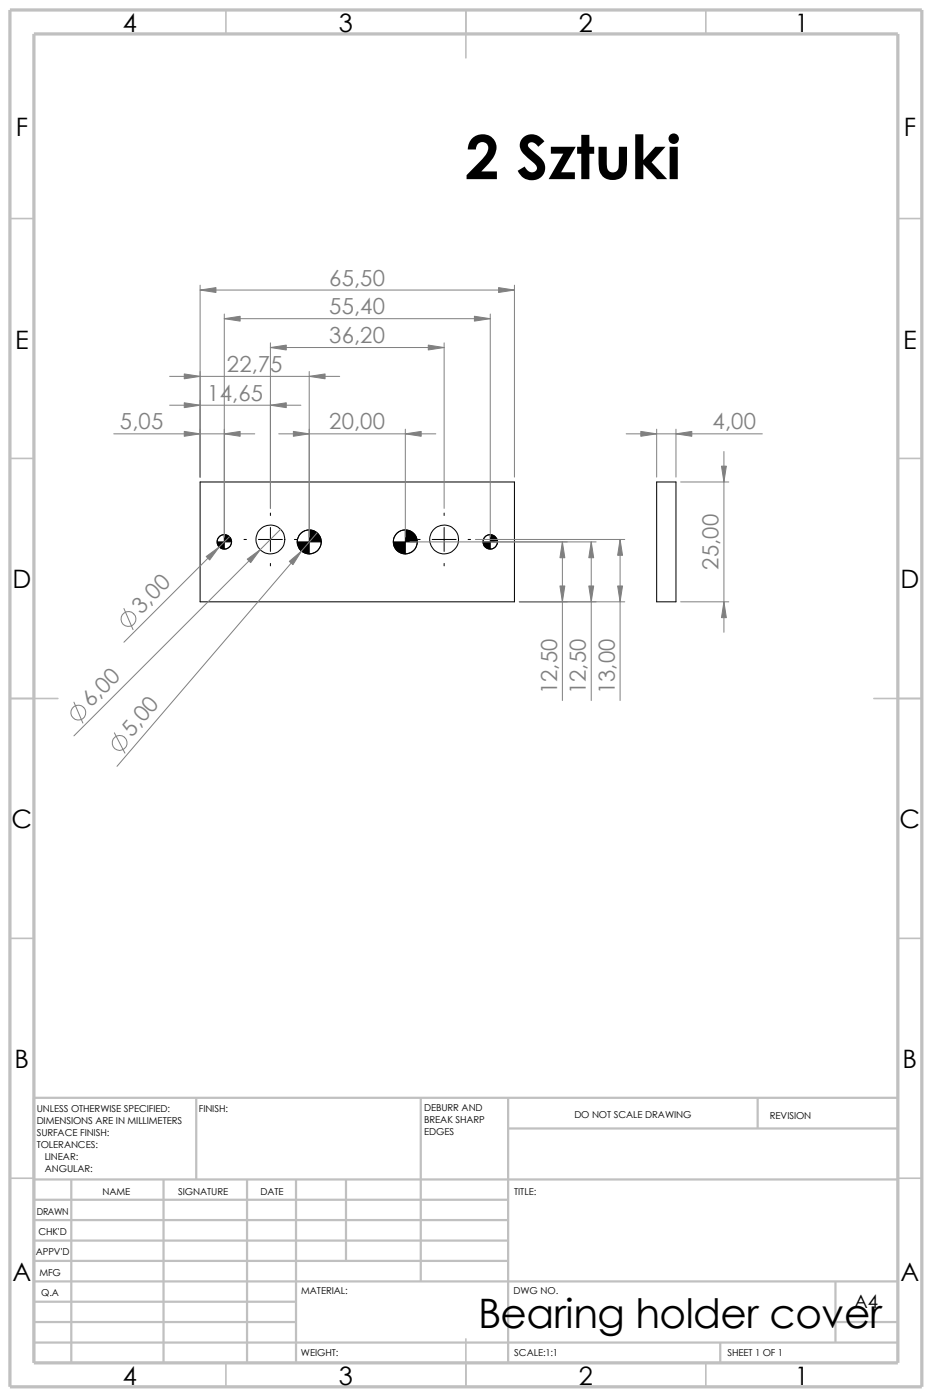
[picture p136: page 1]
SHEET 1 OF 1; WEIGHT:; SCALE:1:1; DO NOT SCALE DRAWING; REVISION; MFG; FINISH:; EDGES; MATERIAL:; DEBURR AND BREAK SHARP; 2 Sztuki 12,50

UNLESS OTHERWISE SPECIFIED:
DIMENSIONS ARE IN MILLIMETERS
SURFACE FINISH:
TOLERANCES:
LINEAR:
ANGULAR:

NAME | SIGNATURE | DATE | TITLE:

DRAWN
CHK'D
APPV'D

DWG NO.
Bearing holder cover
