Fake-Oxygen/3D-PRINTER/DRAWINGS/Bearing holder.pdf

E E

F F

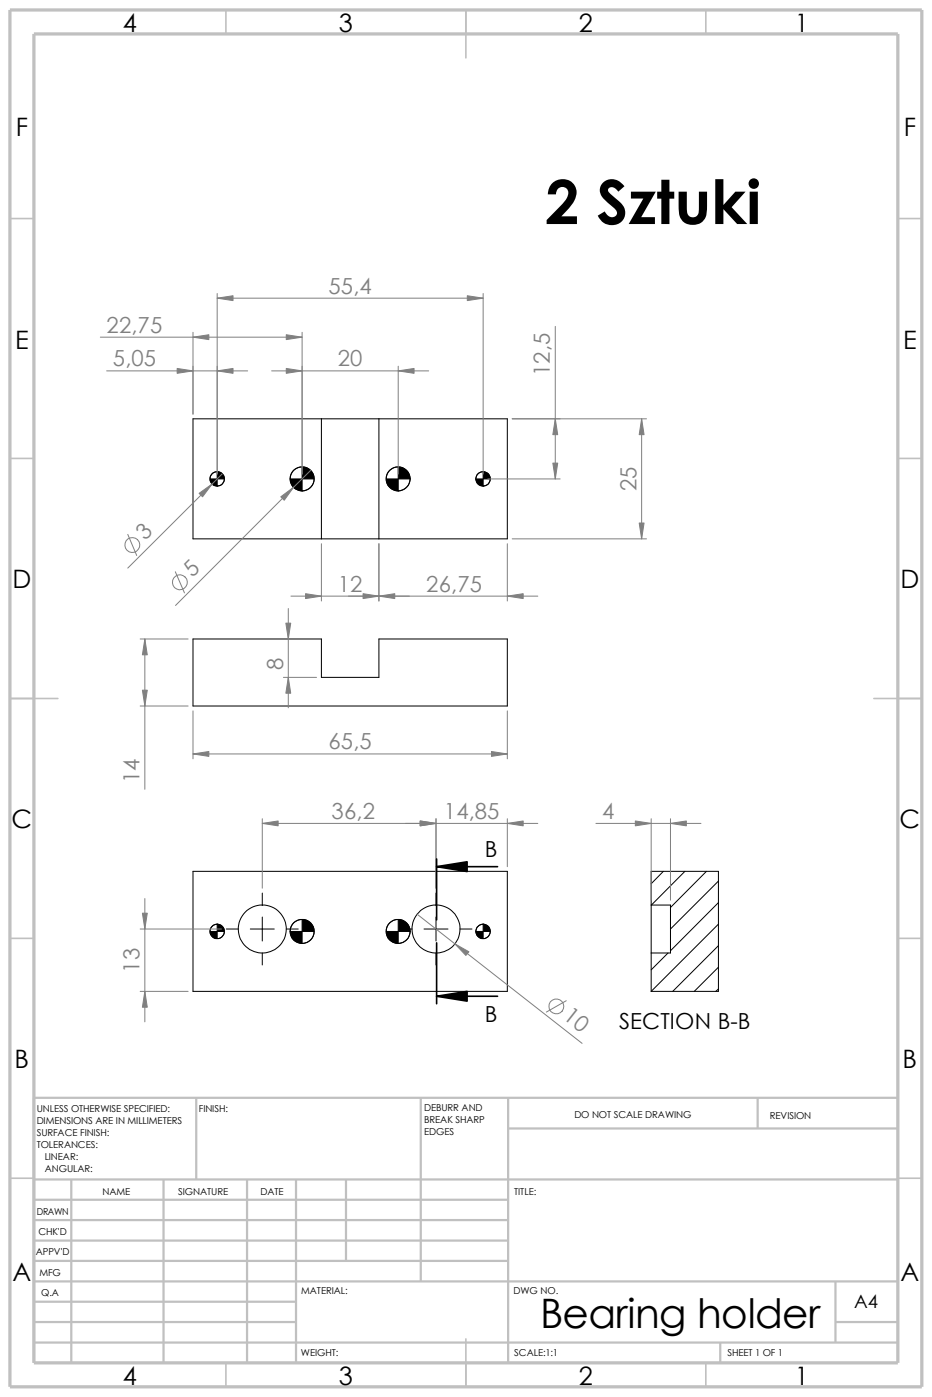
[picture p137: page 1]
SHEET 1 OF 1; WEIGHT:; SCALE:1:1; DWG NO.; DO NOT SCALE DRAWING; REVISION; MFG; FINISH:; EDGES; MATERIAL:; DEBURR AND BREAK SHARP; Bearing holder; 2 Sztuki; SECTION B-B

UNLESS OTHERWISE SPECIFIED:
DIMENSIONS ARE IN MILLIMETERS
SURFACE FINISH:
TOLERANCES:
LINEAR:
ANGULAR:

NAME | SIGNATURE | DATE | TITLE:

DRAWN
CHK'D
APPV'D
