Fake-Oxygen/3D-PRINTER/DRAWINGS/Czesci.pdf

E E

F F

SHEET 1 OF 1; WEIGHT:; SCALE:1:1; DO NOT SCALE DRAWING; REVISION; MFG; FINISH:; EDGES; MATERIAL:; DEBURR AND BREAK SHARP

UNLESS OTHERWISE SPECIFIED:
DIMENSIONS ARE IN MILLIMETERS
SURFACE FINISH:
TOLERANCES:
LINEAR:
ANGULAR:

NAME | SIGNATURE | DATE | TITLE:

DRAWN
CHK'D
APPV'D

DWG NO.
Back Header Cover

E E

F F

DO NOT SCALE DRAWING; REVISION; MFG; FINISH:; EDGES; DEBURR AND BREAK SHARP; 2 Sztuki 12,50

UNLESS OTHERWISE SPECIFIED:
DIMENSIONS ARE IN MILLIMETERS
SURFACE FINISH:
TOLERANCES:
LINEAR:
ANGULAR:

NAME | SIGNATURE | DATE | TITLE:

DRAWN
CHK'D
APPV'D

Bearing holder cover

SCALE:1:1

E E

F F

DO NOT SCALE DRAWING; REVISION; MFG; FINISH:; EDGES; DEBURR AND BREAK SHARP; 2 Sztuki; SECTION B-B

UNLESS OTHERWISE SPECIFIED:
DIMENSIONS ARE IN MILLIMETERS
SURFACE FINISH:
TOLERANCES:
LINEAR:
ANGULAR:

NAME | SIGNATURE | DATE | TITLE:

DRAWN
CHK'D
APPV'D

Bearing holder

SCALE:1:1

E E

F F

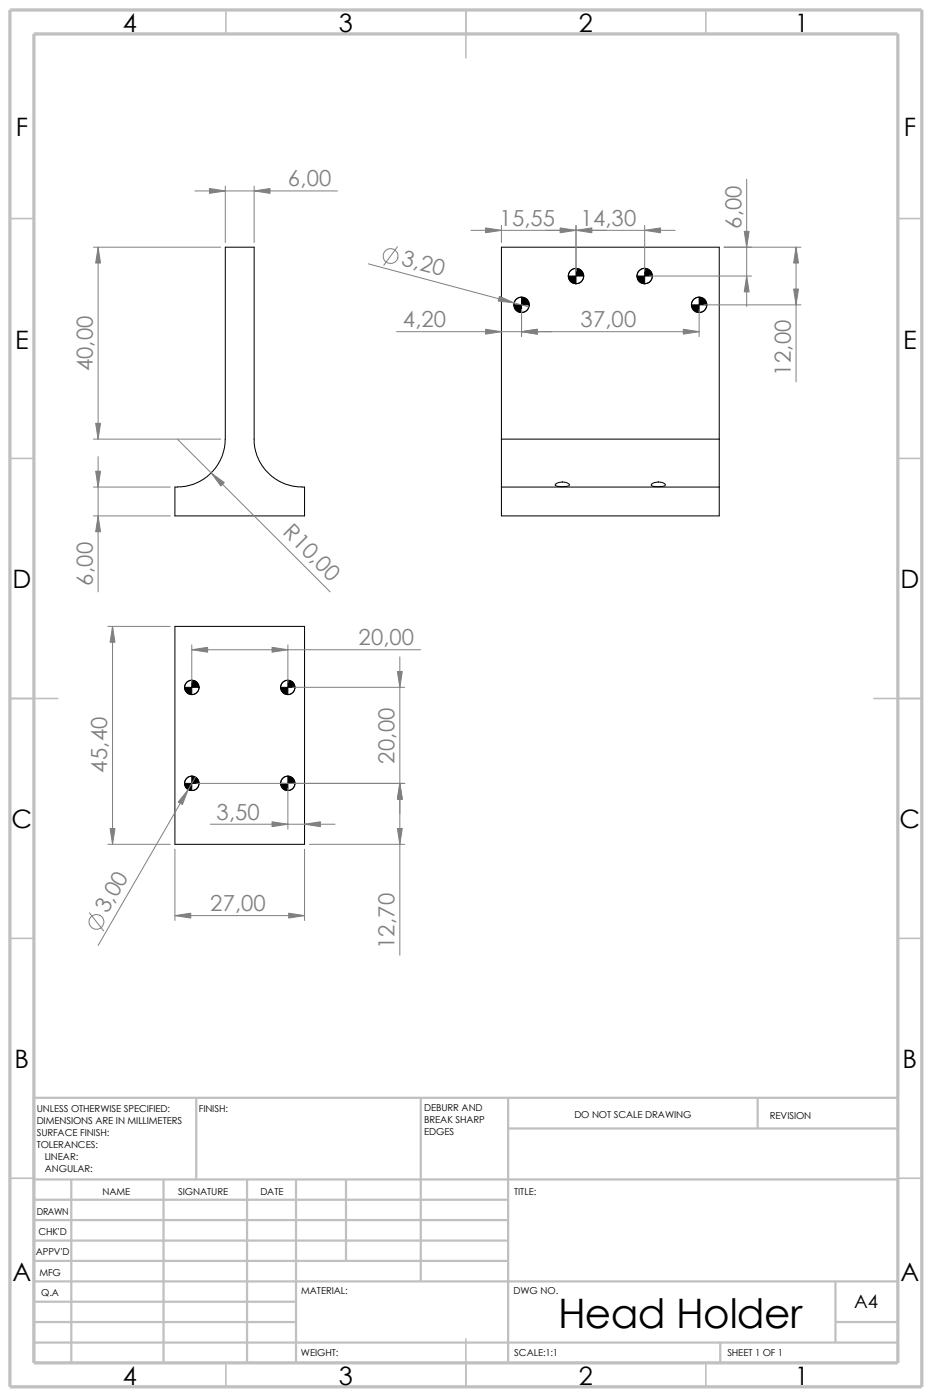
[picture p138: page 7]
DO NOT SCALE DRAWING; REVISION; SCALE:1:1; SHEET 1 OF 1; EDGES; FINISH:; MFG; DEBURR AND BREAK SHARP; Head Holder ⁴⁰,00 6,00

UNLESS OTHERWISE SPECIFIED:
DIMENSIONS ARE IN MILLIMETERS
SURFACE FINISH:
TOLERANCES:
LINEAR:
ANGULAR:

NAME | SIGNATURE | DATE | TITLE:

DRAWN
CHK'D
APPV'D

E E

F F

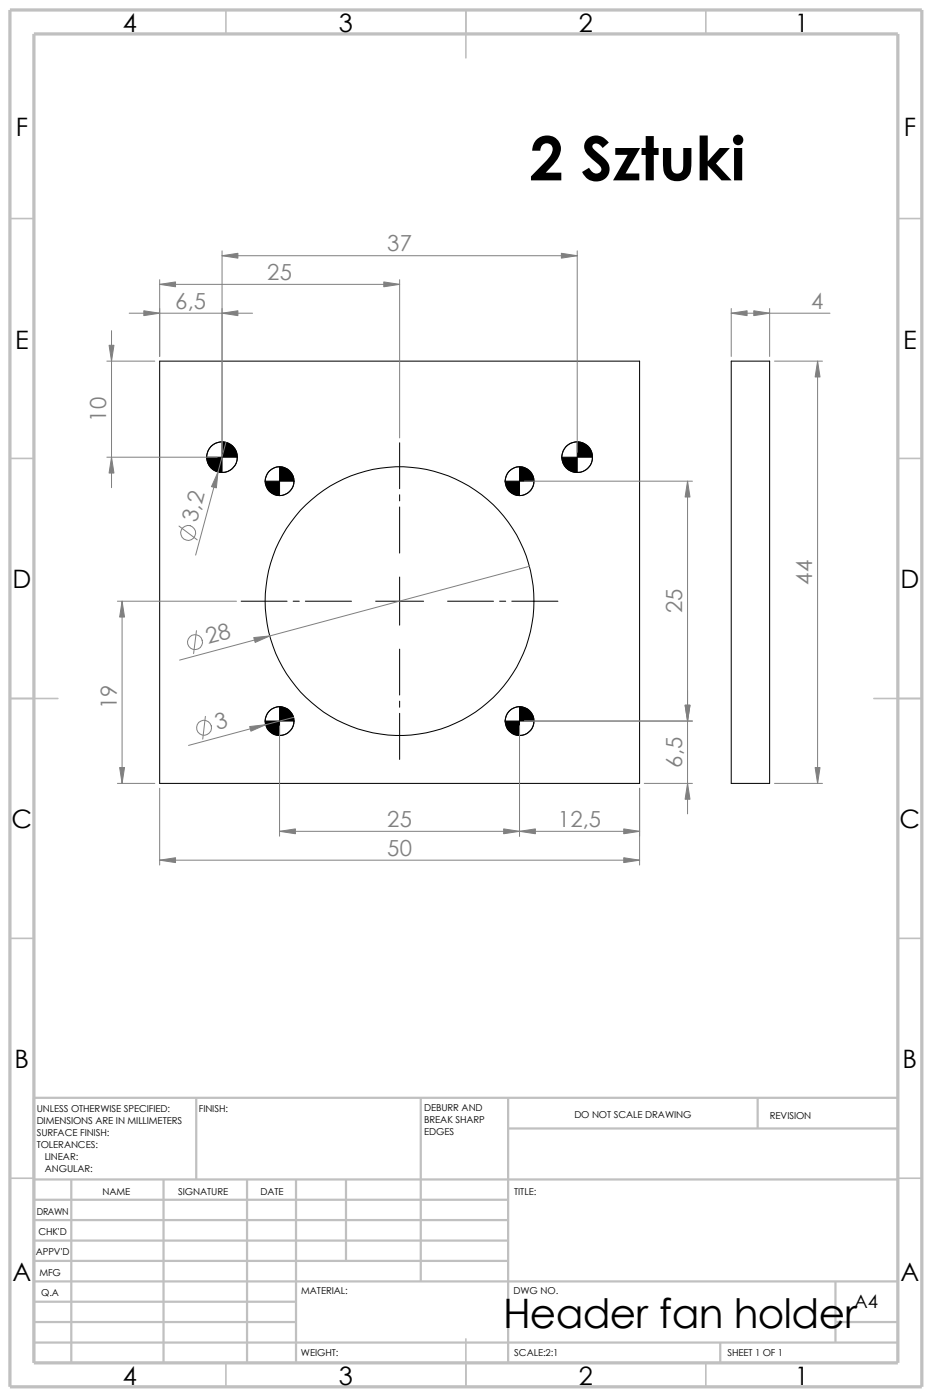
[picture p139: page 9]
DO NOT SCALE DRAWING; REVISION; MFG; FINISH:; EDGES; DEBURR AND BREAK SHARP; 2 Sztuki

UNLESS OTHERWISE SPECIFIED:
DIMENSIONS ARE IN MILLIMETERS
SURFACE FINISH:
TOLERANCES:
LINEAR:
ANGULAR:

NAME | SIGNATURE | DATE | TITLE:

DRAWN
CHK'D
APPV'D

Header fan holder

SCALE:2:1

E E

F F

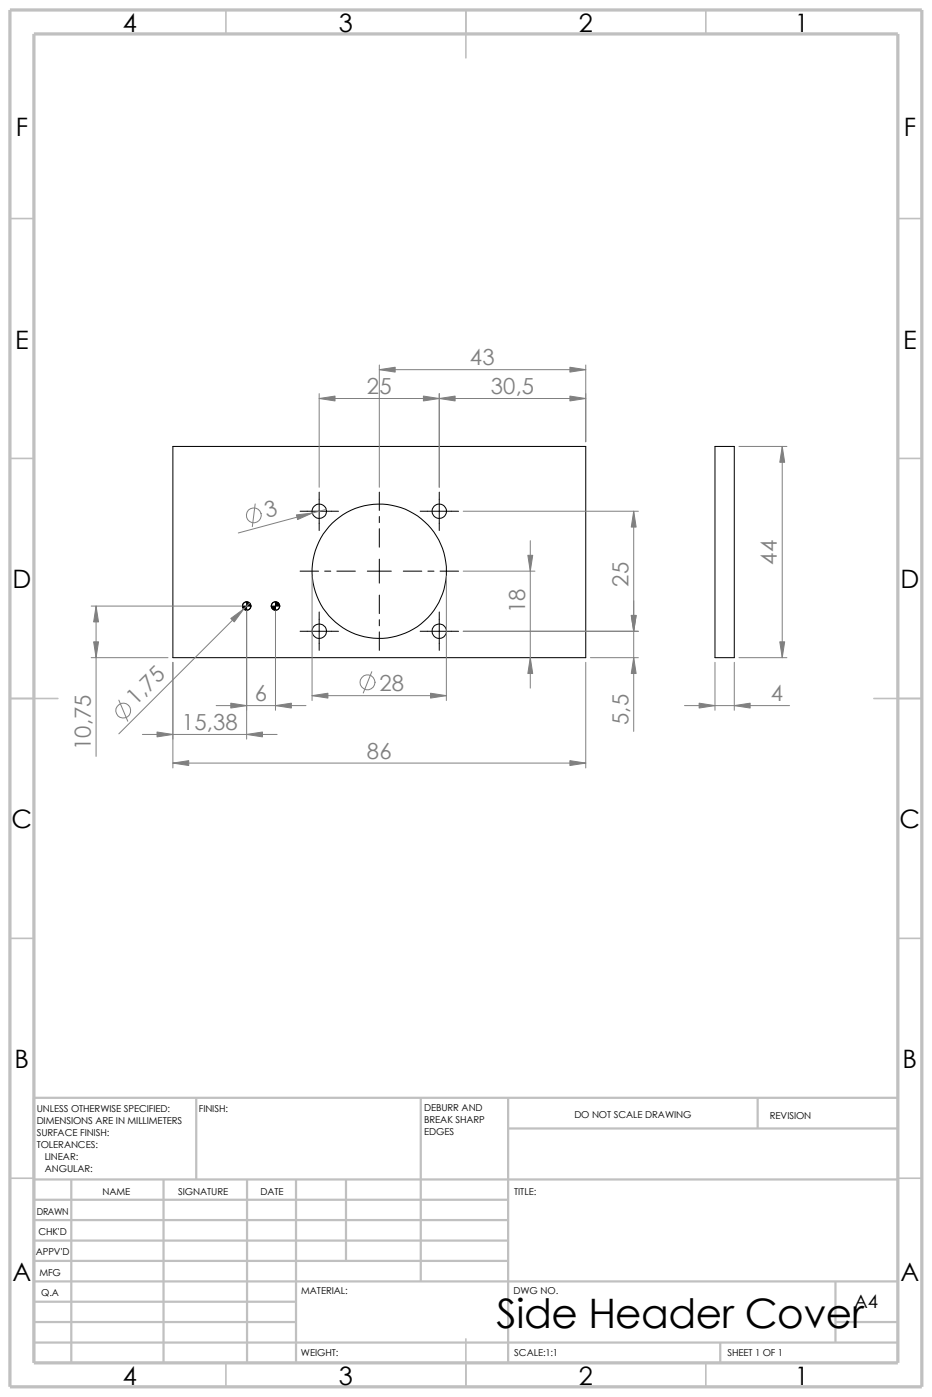
[picture p140: page 11]
DO NOT SCALE DRAWING; REVISION; MFG; FINISH:; EDGES; DEBURR AND BREAK SHARP

UNLESS OTHERWISE SPECIFIED:
DIMENSIONS ARE IN MILLIMETERS
SURFACE FINISH:
TOLERANCES:
LINEAR:
ANGULAR:

NAME | SIGNATURE | DATE | TITLE:

DRAWN
CHK'D
APPV'D

Side Header Cover

SCALE:1:1

E E

F F

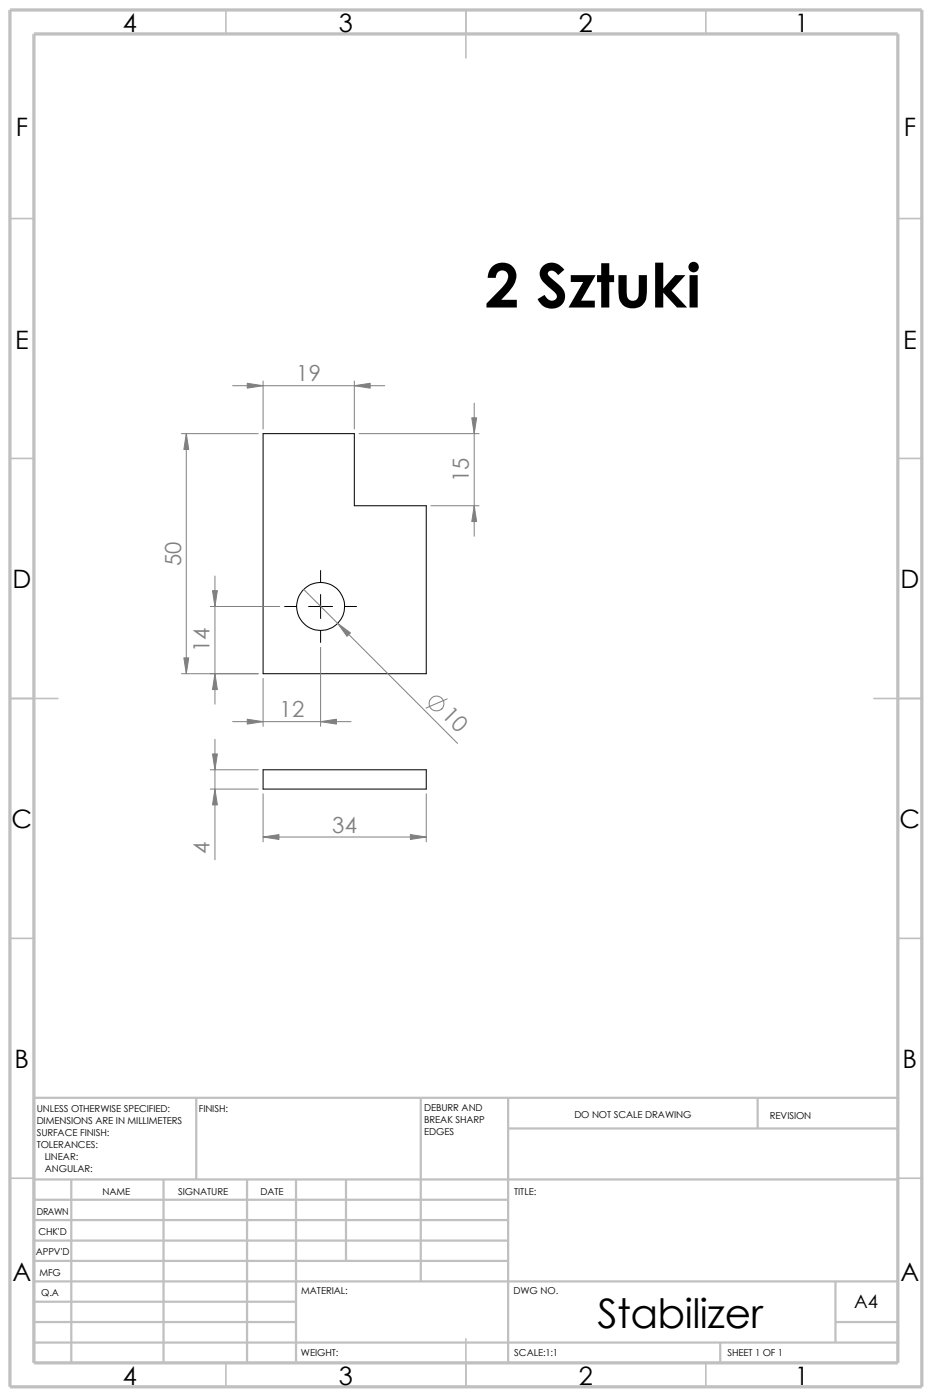
[picture p141: page 13]
DO NOT SCALE DRAWING; REVISION; MFG; FINISH:; EDGES; DEBURR AND BREAK SHARP; 2 Sztuki

UNLESS OTHERWISE SPECIFIED:
DIMENSIONS ARE IN MILLIMETERS
SURFACE FINISH:
TOLERANCES:
LINEAR:
ANGULAR:

NAME | SIGNATURE | DATE | TITLE:

DRAWN
CHK'D
APPV'D

Stabilizer

SCALE:1:1
