Fake-Oxygen/3D-PRINTER/DRAWINGS/Head Holder.pdf

E E

F F

MATERIAL:; DO NOT SCALE DRAWING; REVISION; DWG NO.; SCALE:1:1; SHEET 1 OF 1; WEIGHT:; EDGES; FINISH:; MFG; DEBURR AND BREAK SHARP; Head Holder ⁴⁰,00 6,00

UNLESS OTHERWISE SPECIFIED:
DIMENSIONS ARE IN MILLIMETERS
SURFACE FINISH:
TOLERANCES:
LINEAR:
ANGULAR:

NAME | SIGNATURE | DATE | TITLE:

DRAWN
CHK'D
APPV'D
