Fake-Oxygen/3D-PRINTER/MOTHERBOARD V2/CPU/CPU.pdf

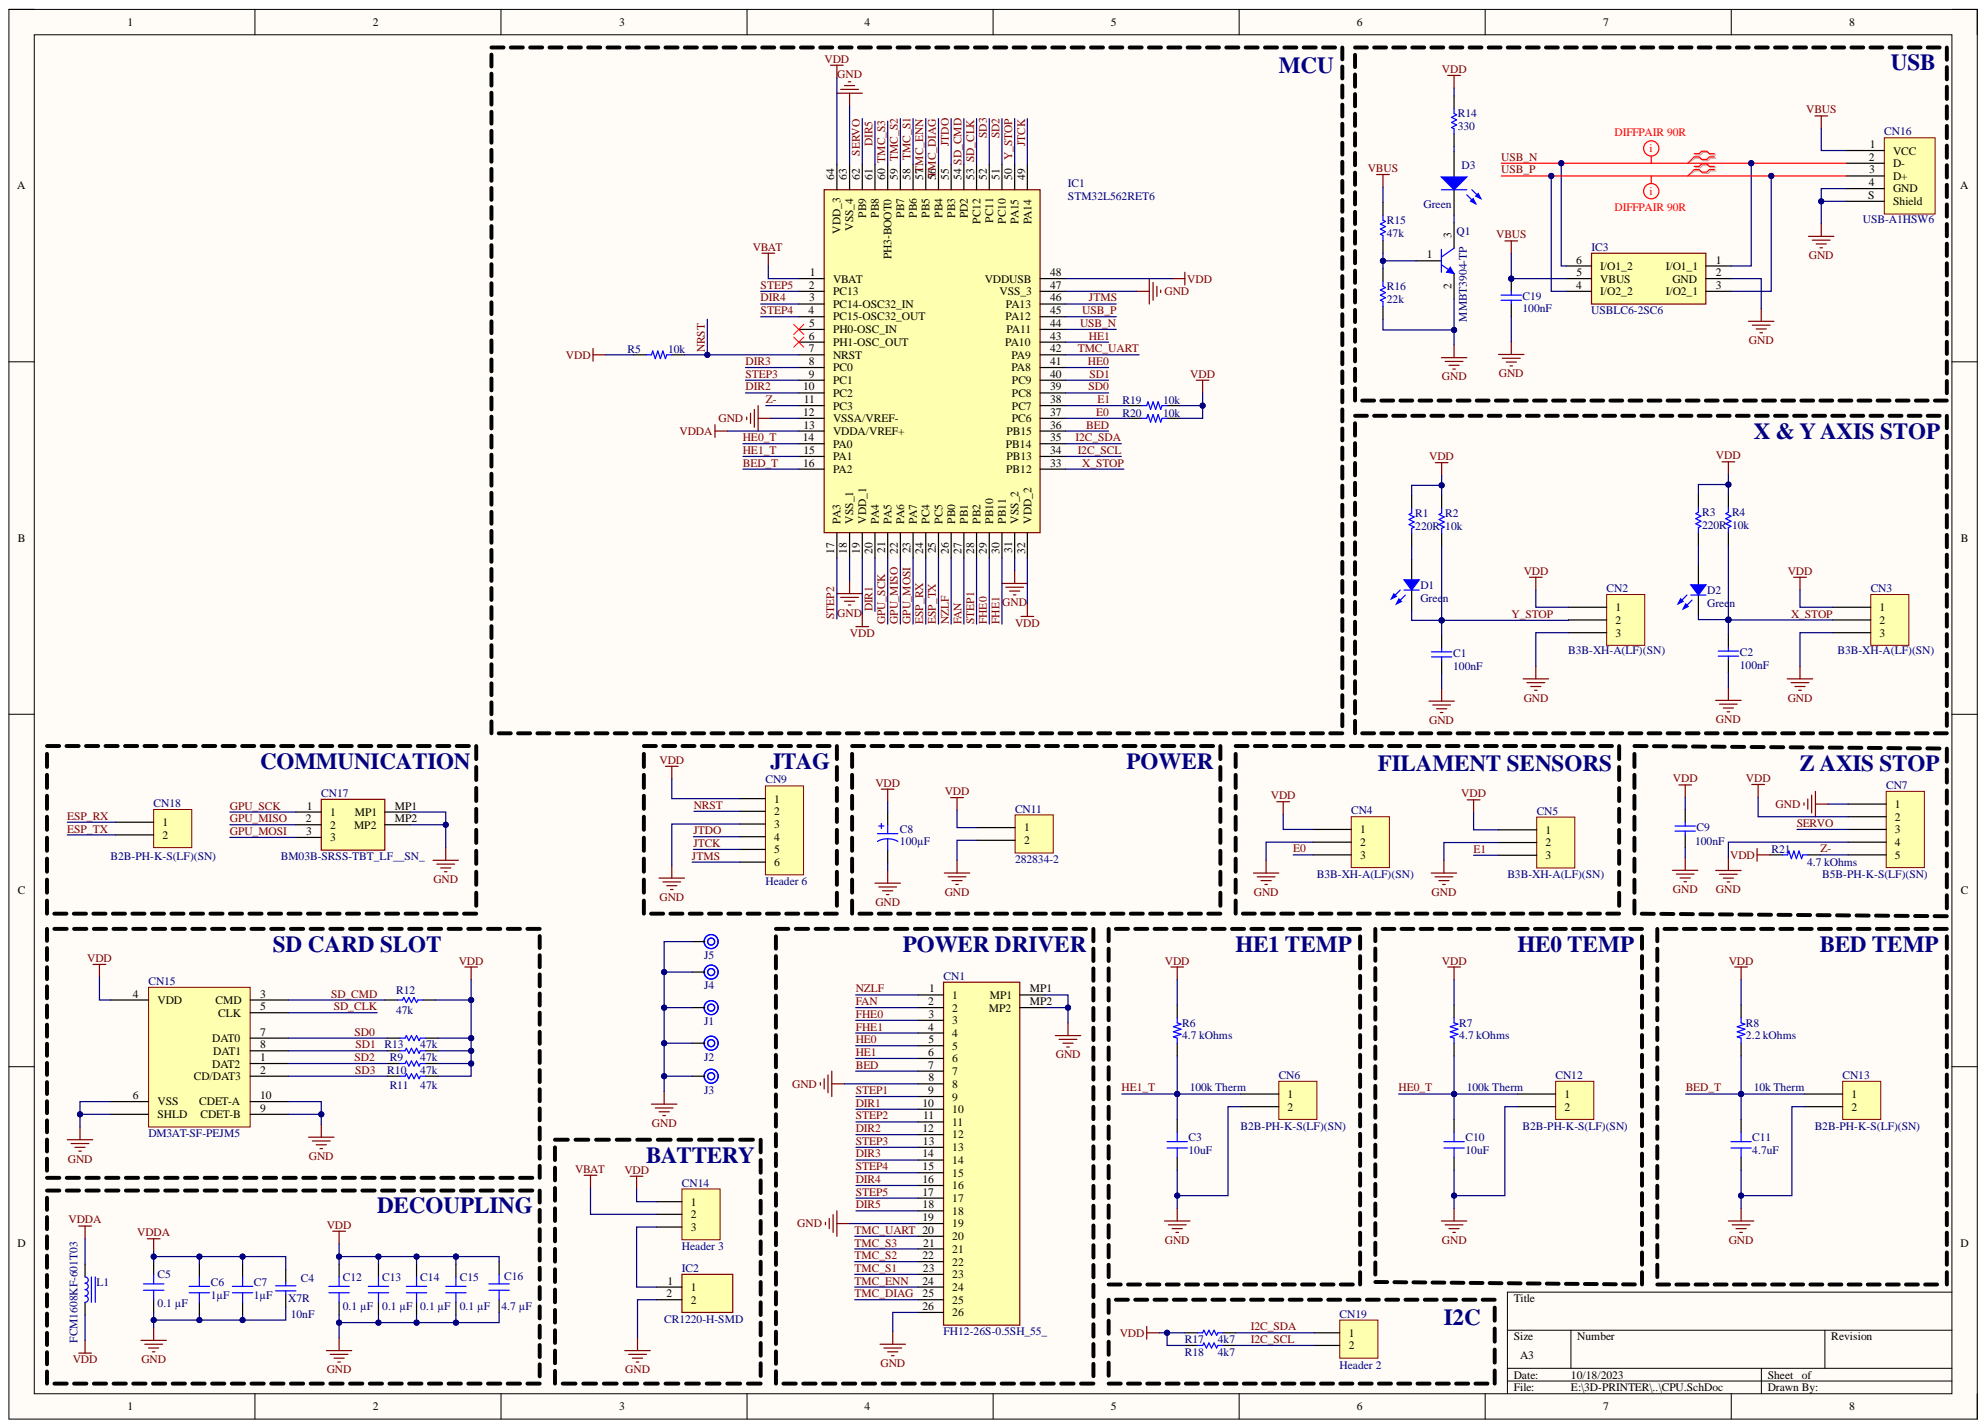
[picture p142: page 1]

i DIFFPAIR 90R IC3 | | GND 4

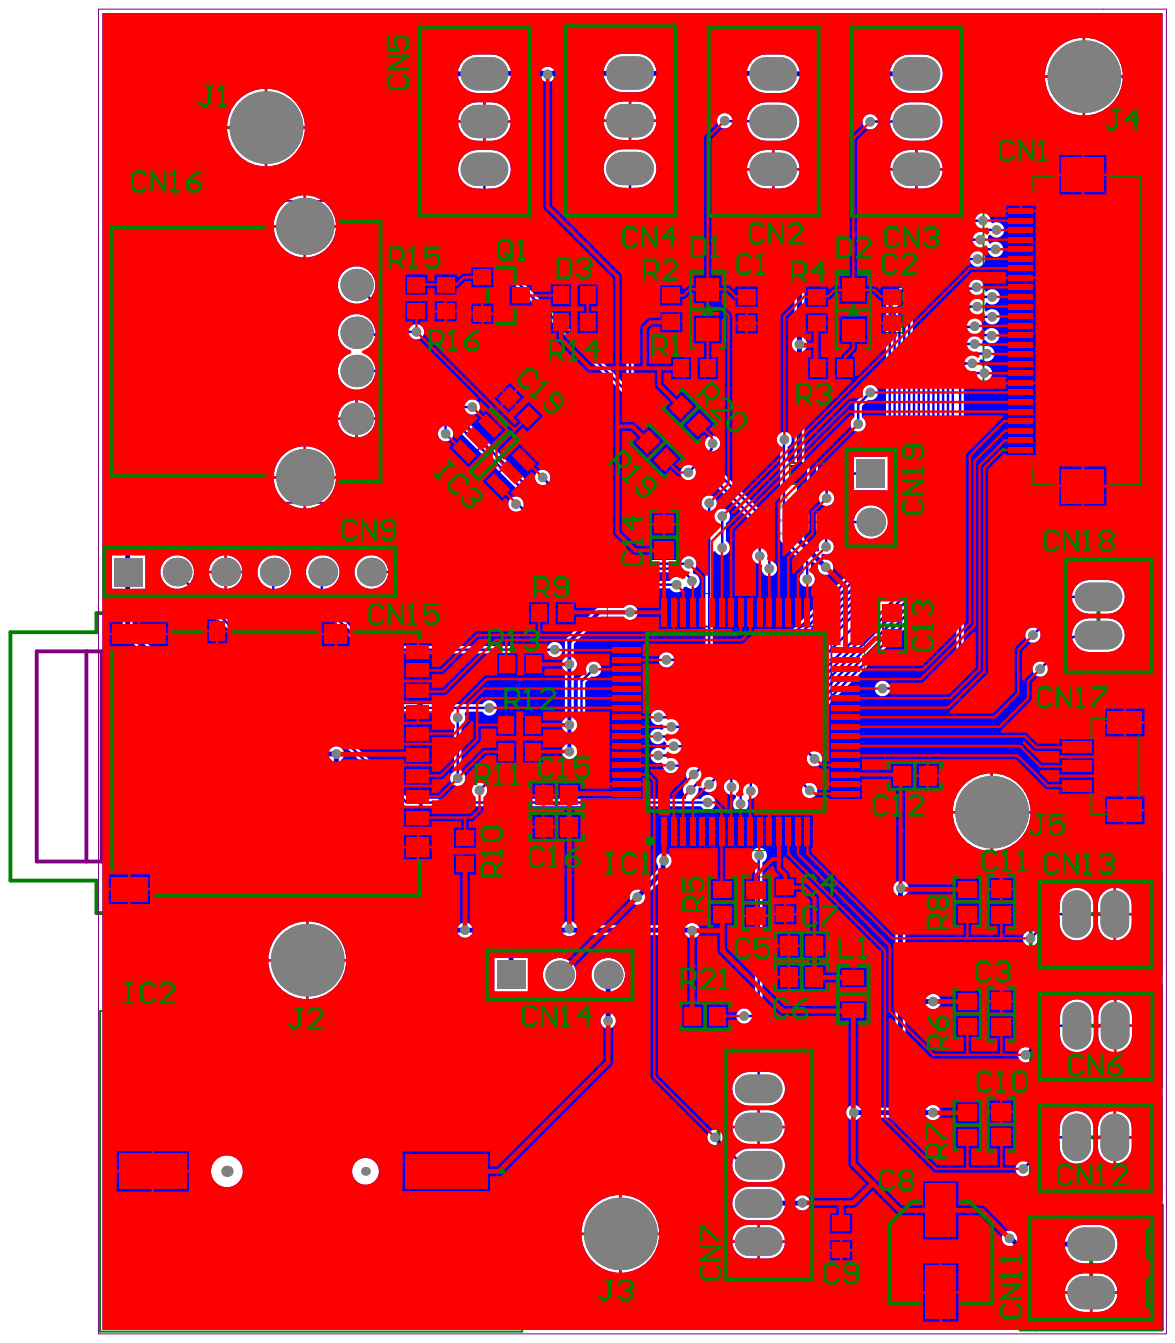
[picture p143: page 2]
