Fake-Oxygen/3D-PRINTER/MOTHERBOARD V2/Power Driver/Power Driver.pdf

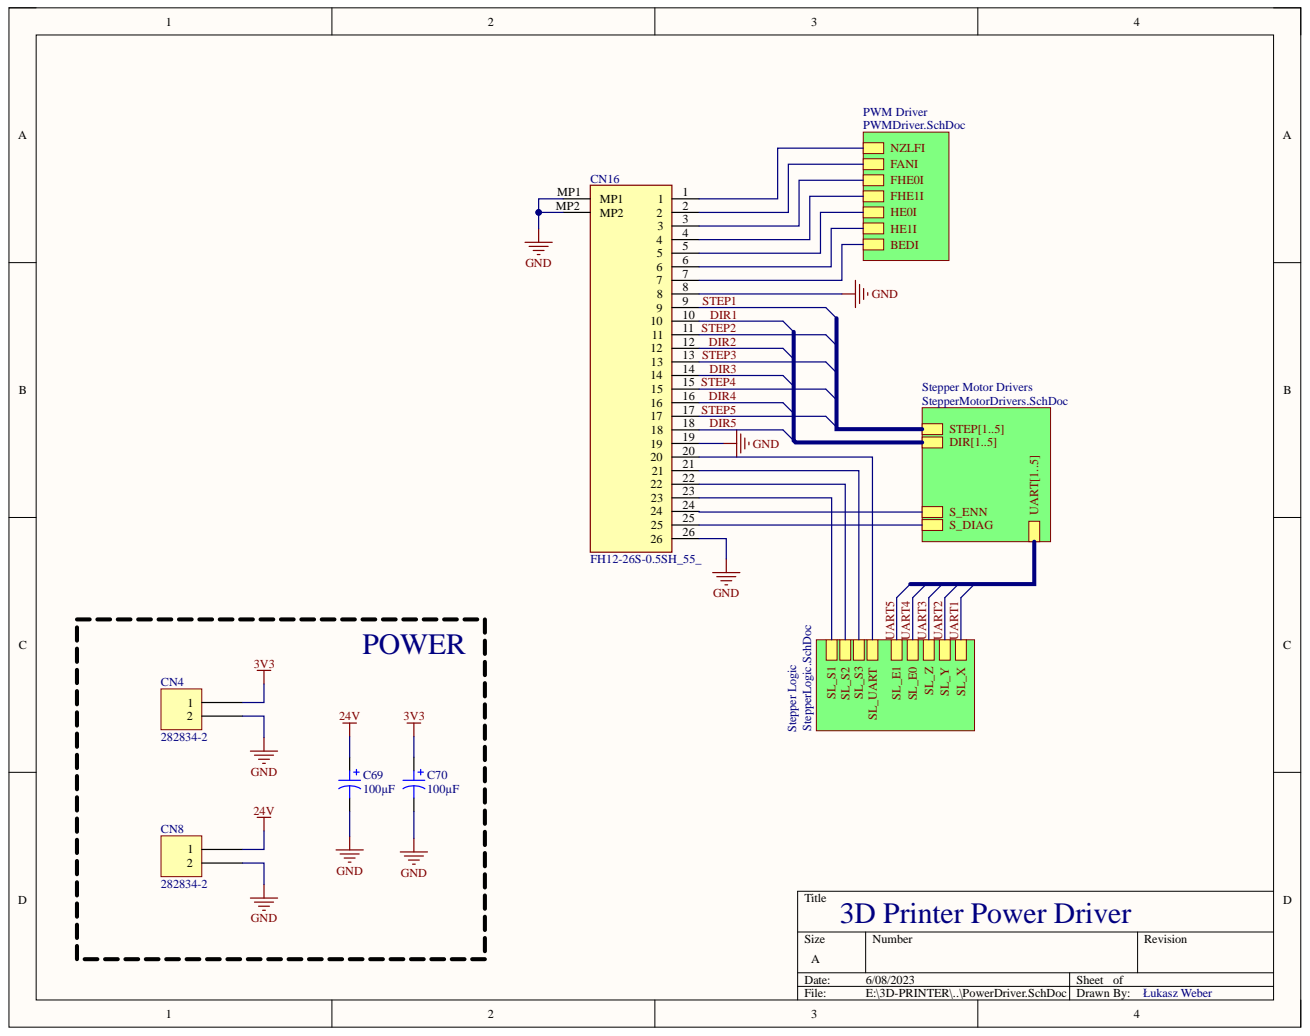
[picture p144: page 1]

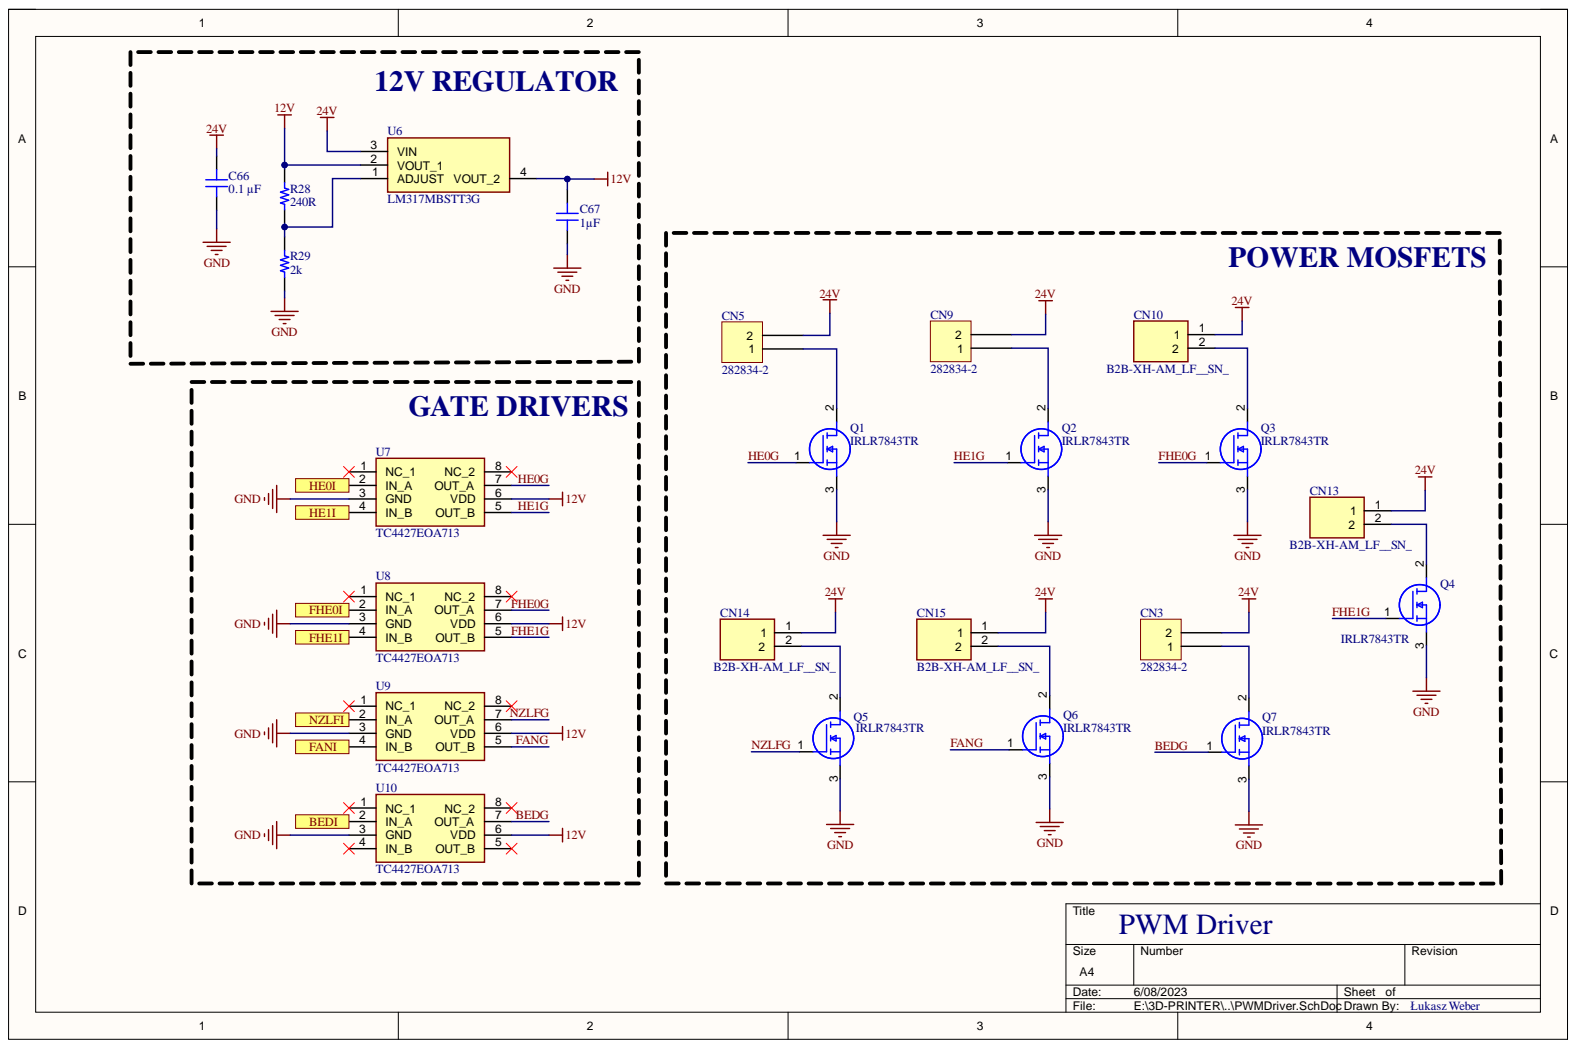
[picture p145: page 2]

S i z e A 4 | Number | Rev i s i o n

Date: 6/08/2023 | Sheet of
F i le: E:\3D-PRINT ER\..\P WMDr i ver.S chDoc Drawn B | y : Łukasz We b e r

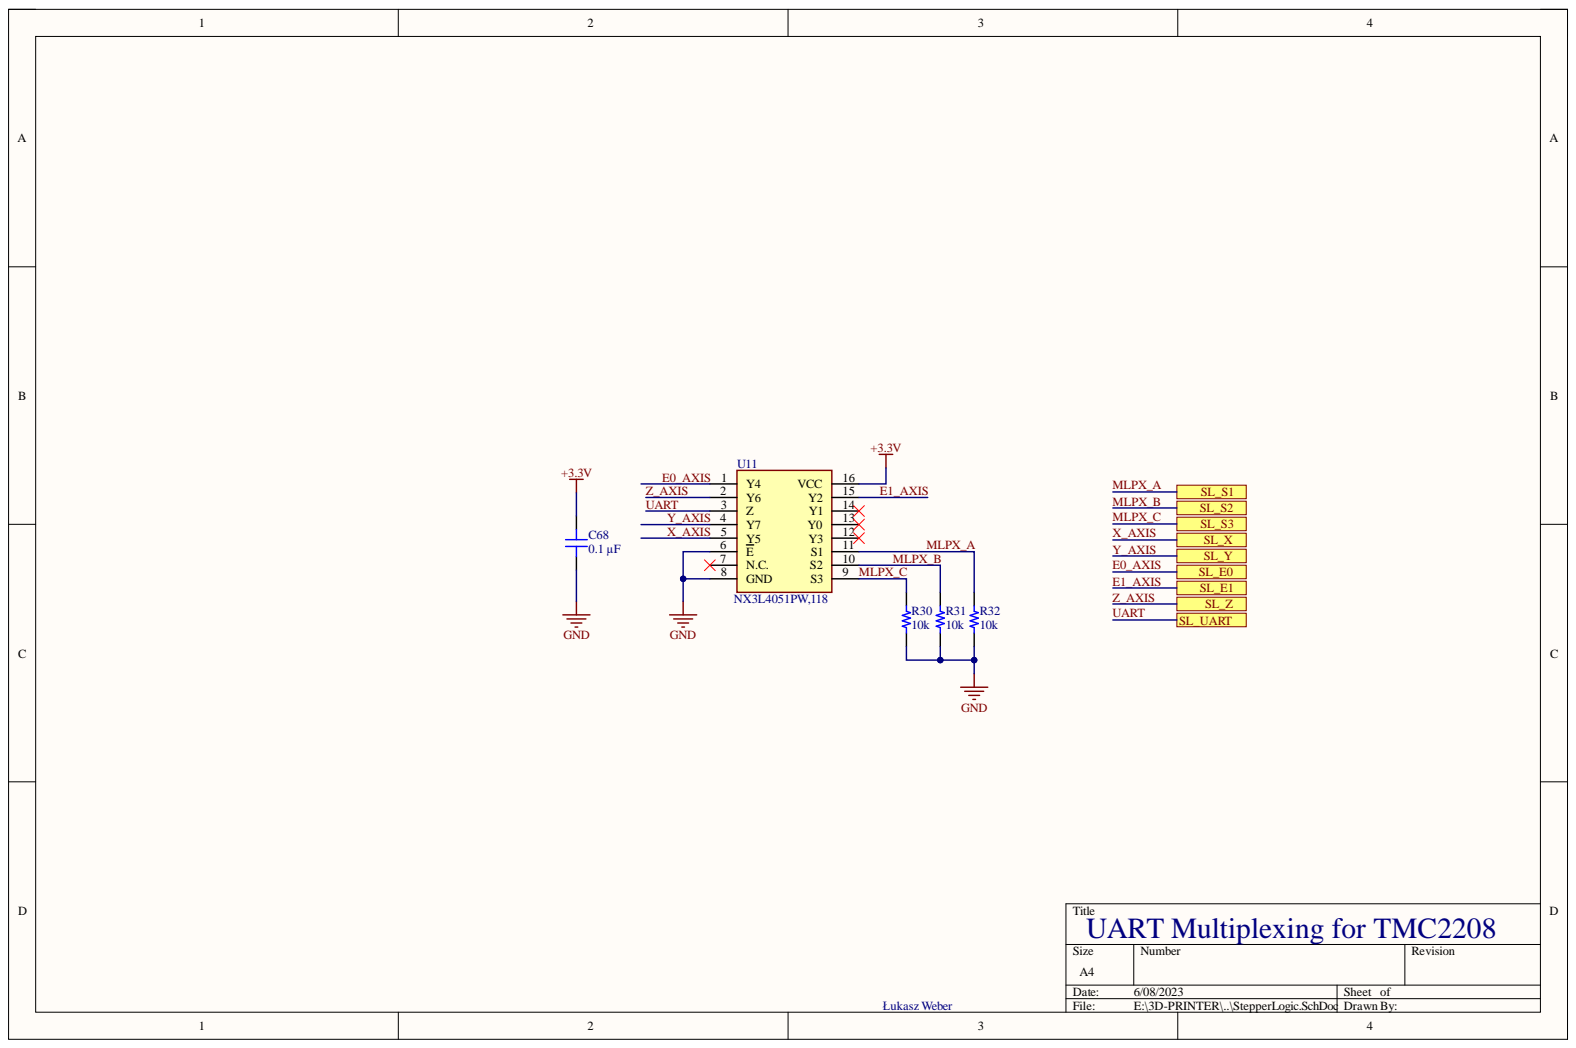
[picture p146: page 3]

Siz e A4 | Numb e r | R evisio n

Da te : 6/08/202 3 | She et of
File : E:\3D-P R INTER\. .\Steppe r L o g i c . S c hD o | c Dr awn B y :

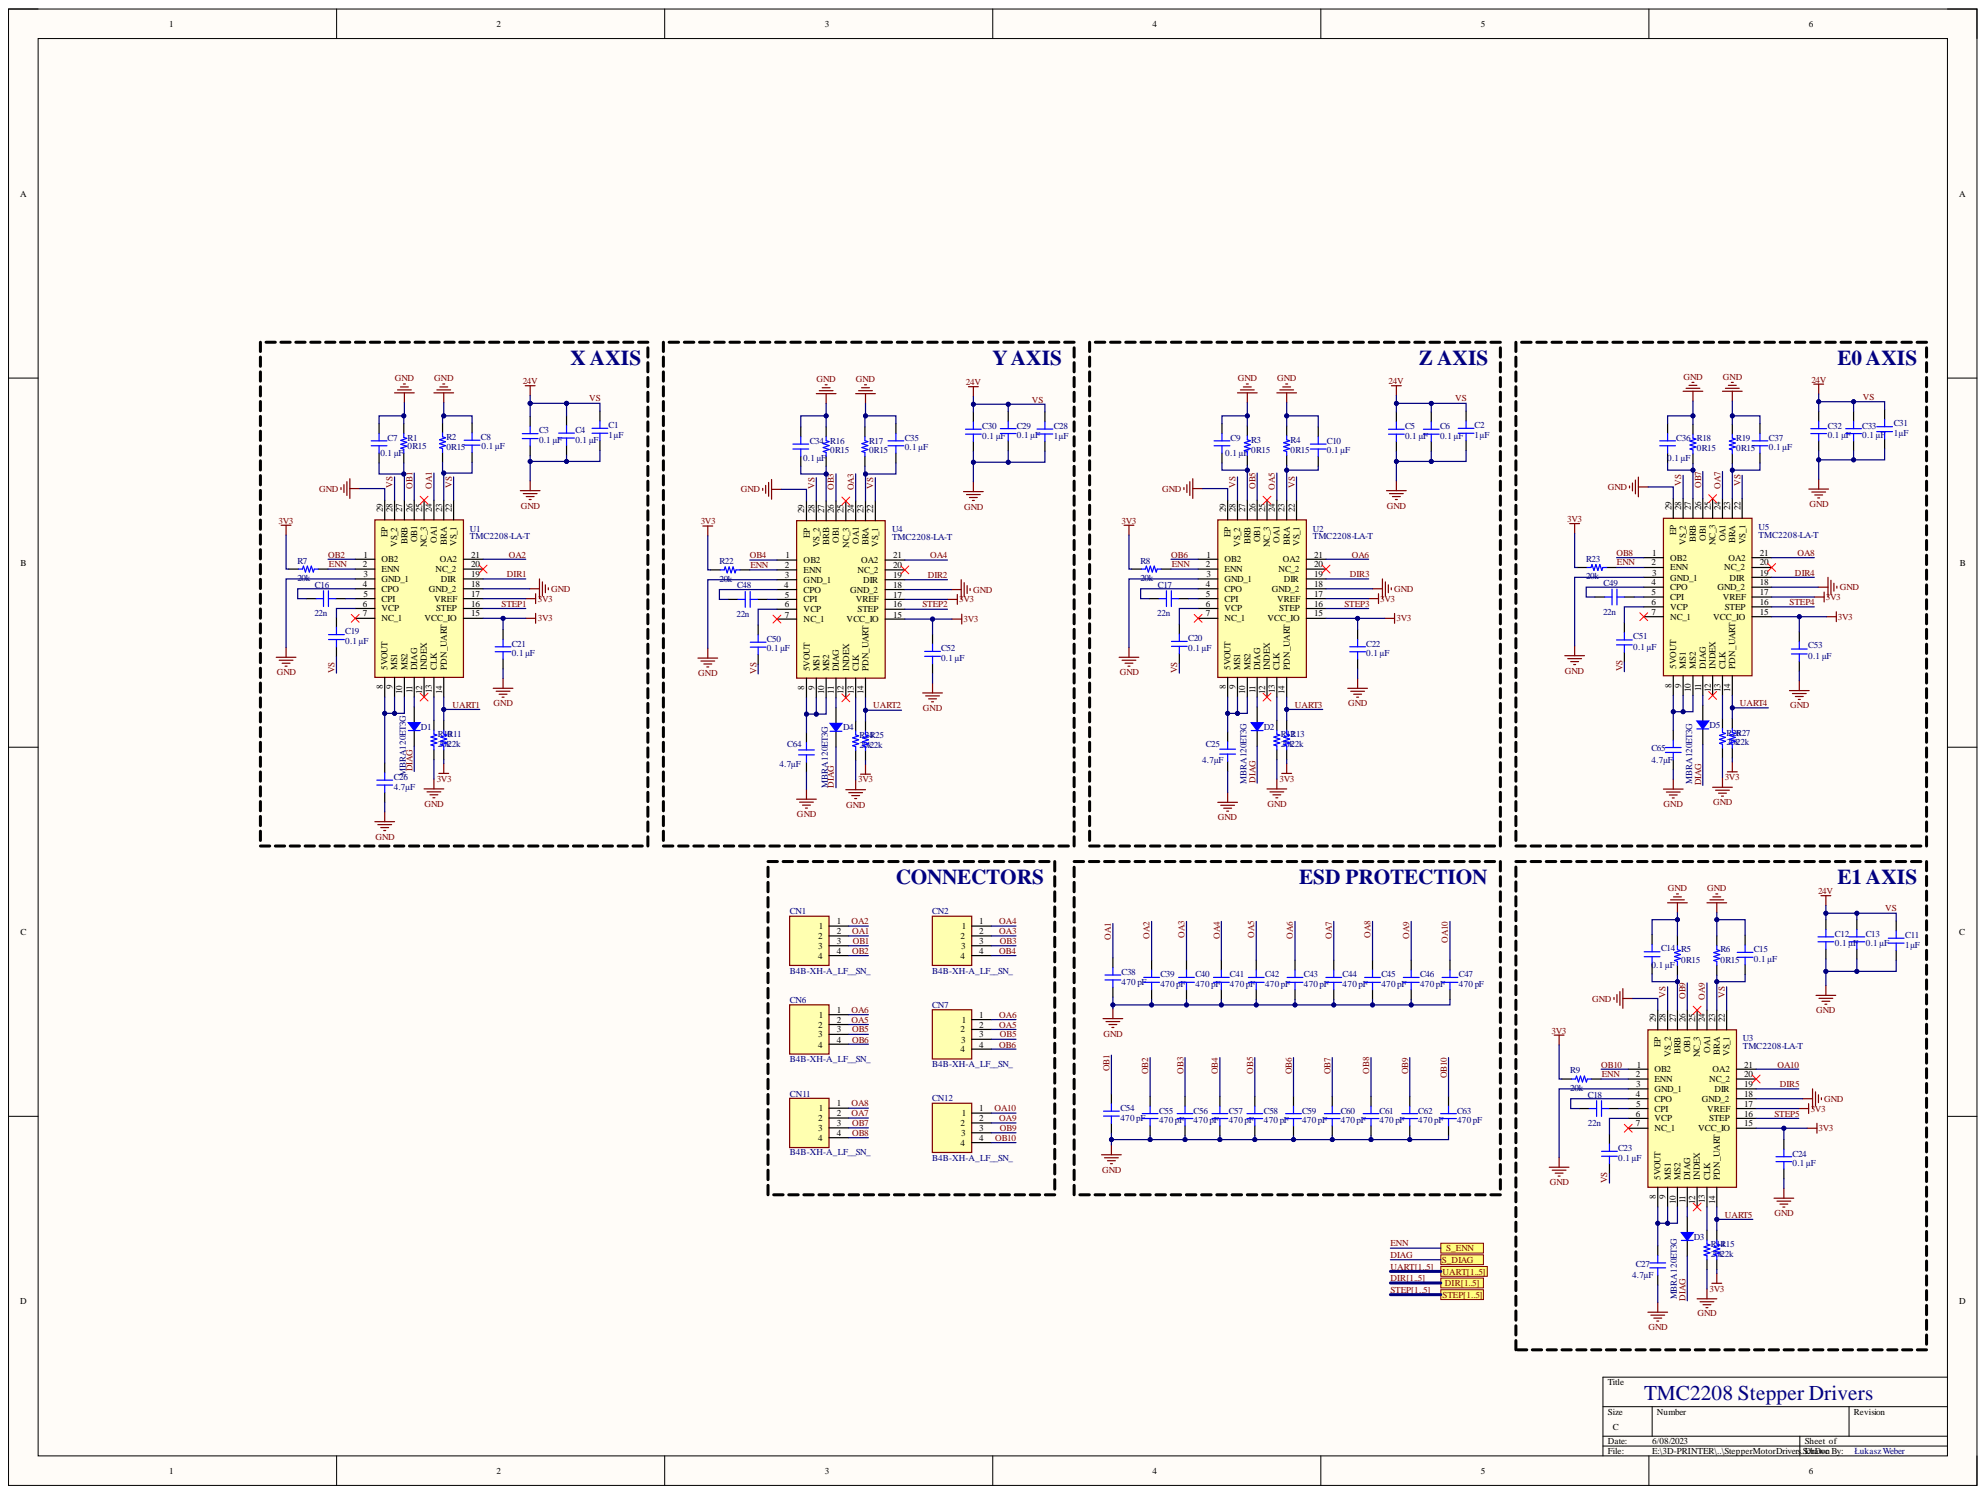
[picture p147: page 4]

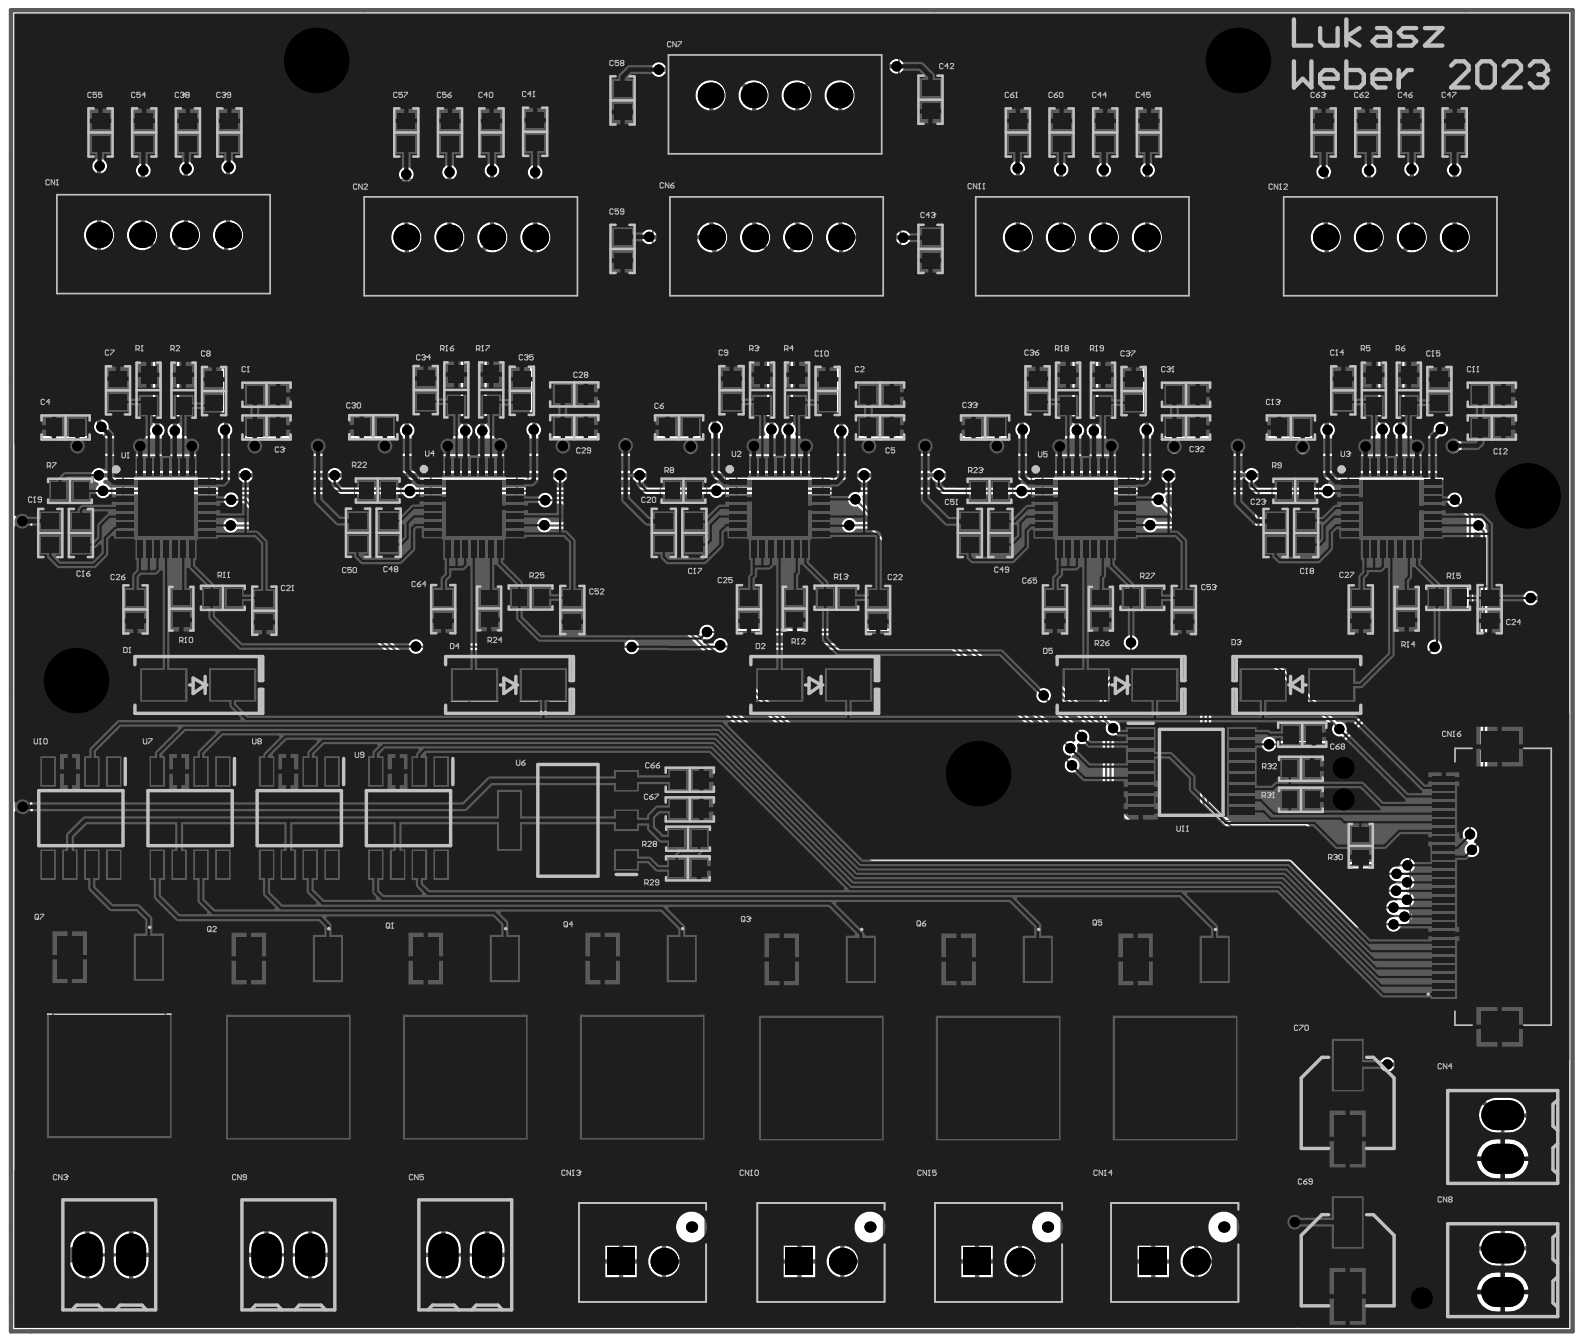
[picture p148: page 5]
