Fake-Oxygen/3D-PRINTER/MOTHERBOARD V2/Power Driver/Schemat.pdf

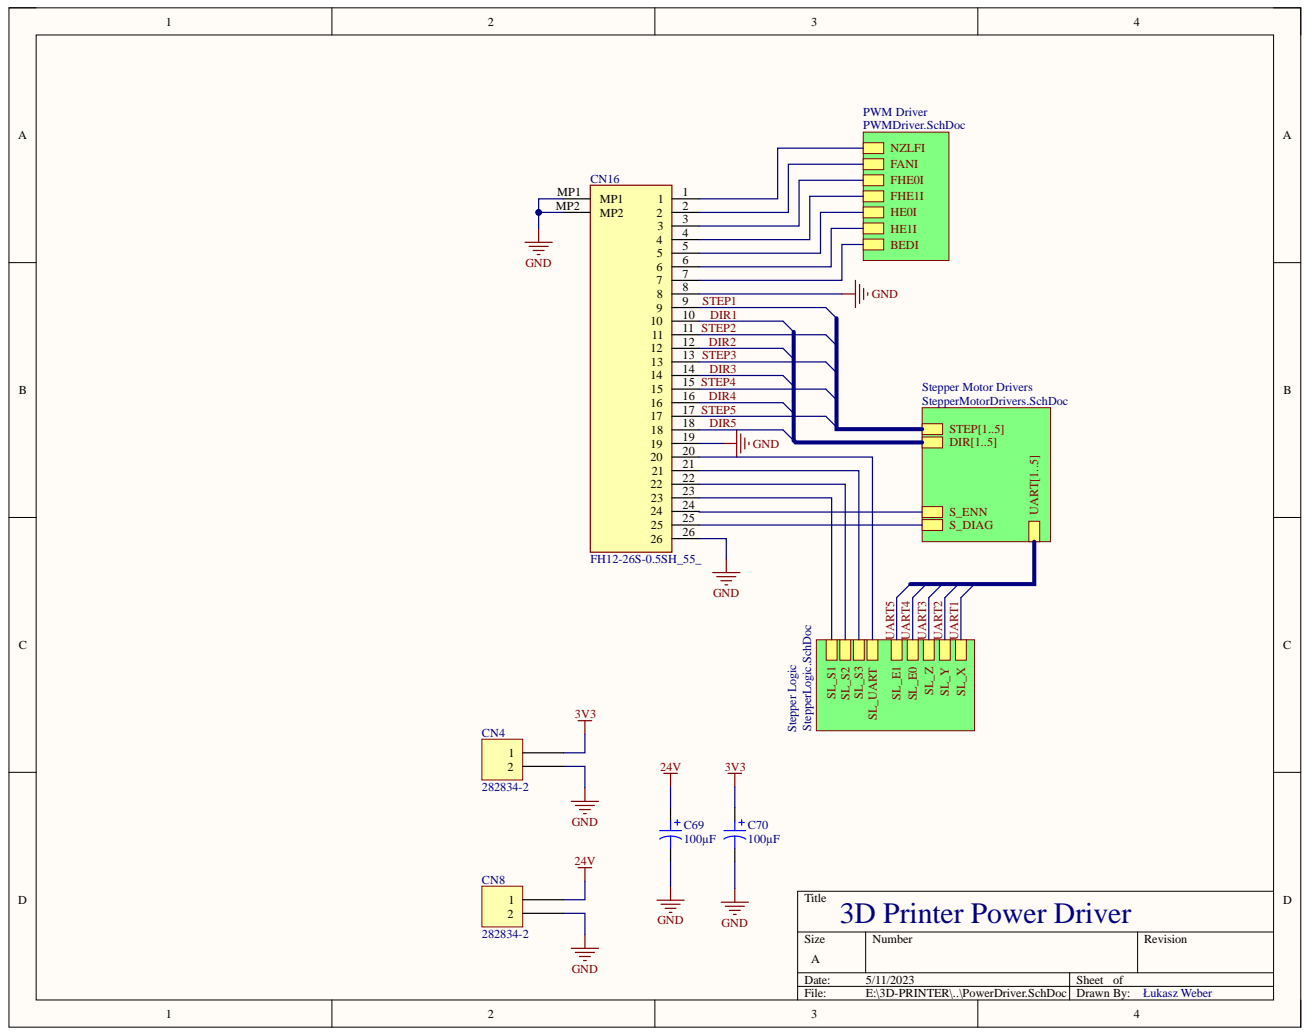
[picture p149: page 1]

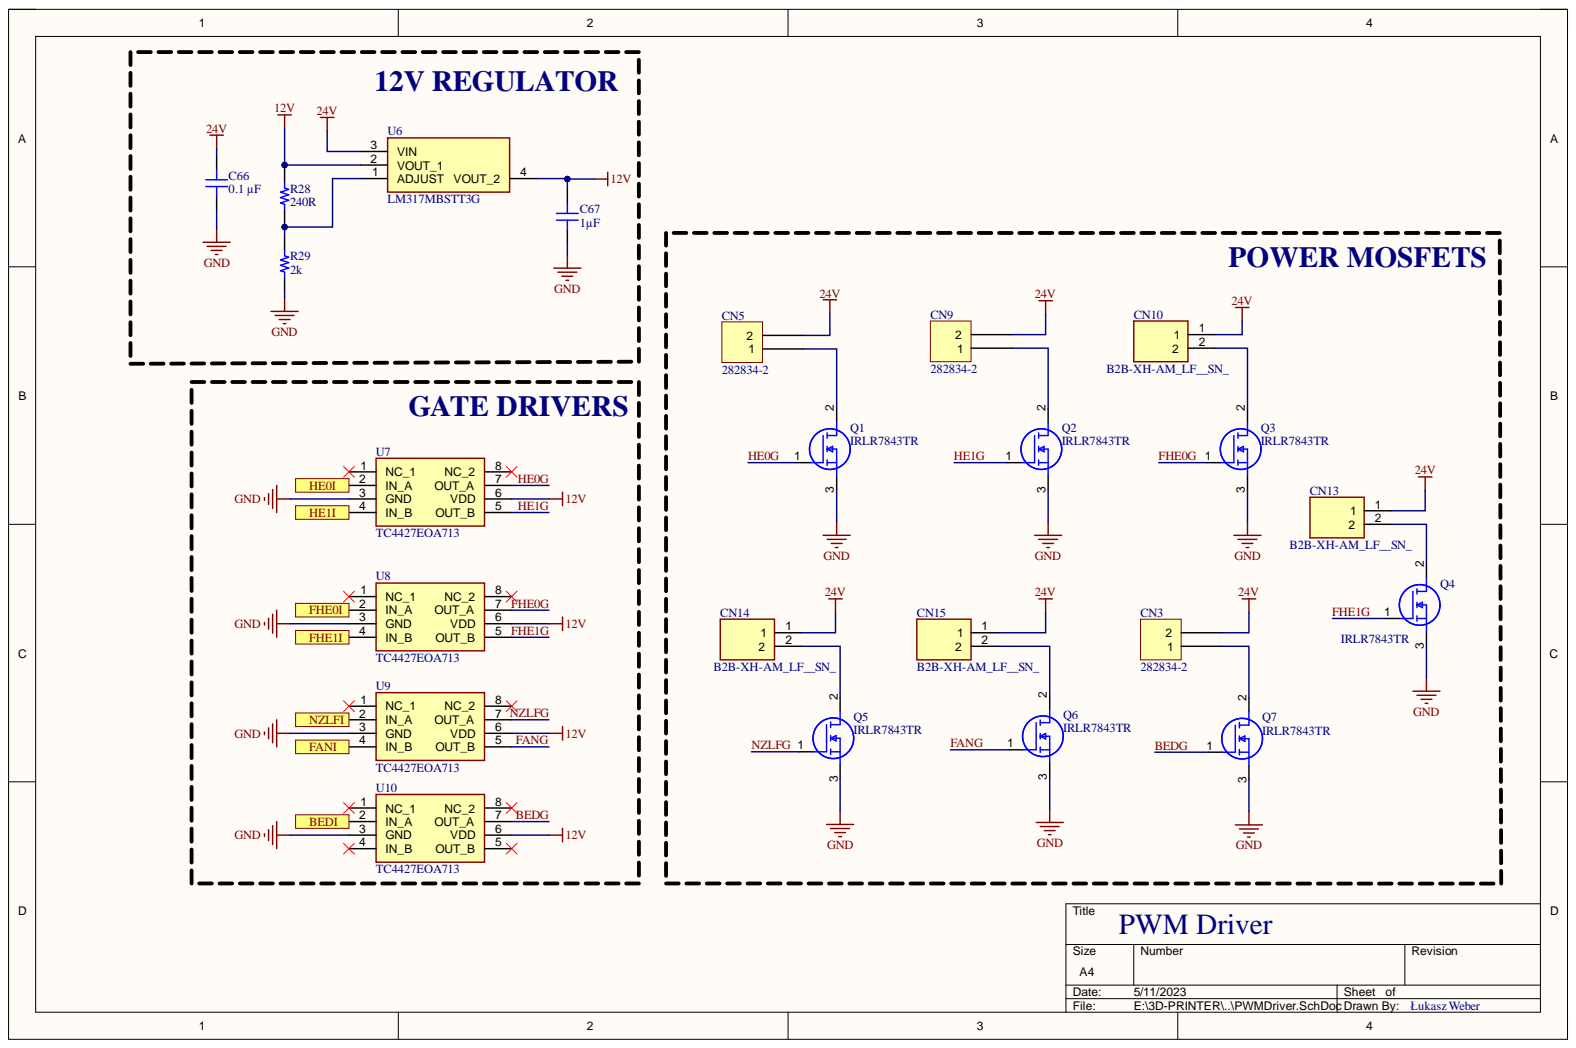
[picture p150: page 2]

S i z e A 4 | Number | Rev i s i o n

Date: 5/11/2023 | Sheet of
F i le: E:\3D-PRINT ER\..\P WMDr i ver.S chDoc Drawn B | y : Łukasz We b e r

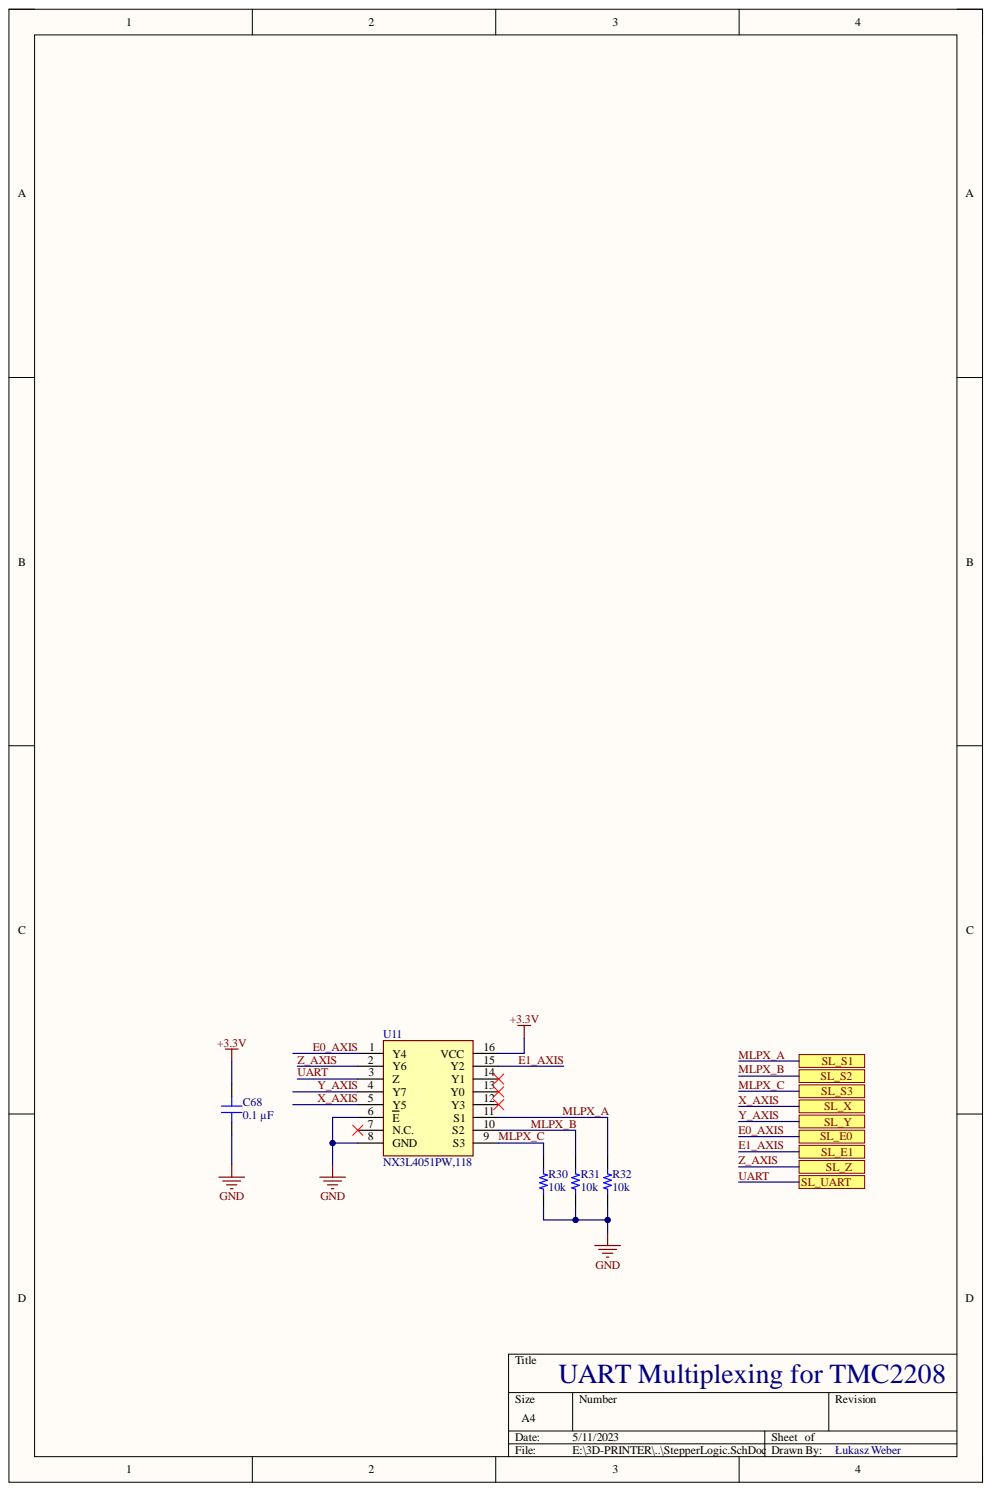
[picture p151: page 3]

Si z e A | Numbe r | Revi s i on

Dat e : 5/ 11/20 3 | Sheet of
Fi l e : E : \3D -PR IN T E R\..\Stepper Logic.SchD o | c D rawn By: Łukasz Webe r

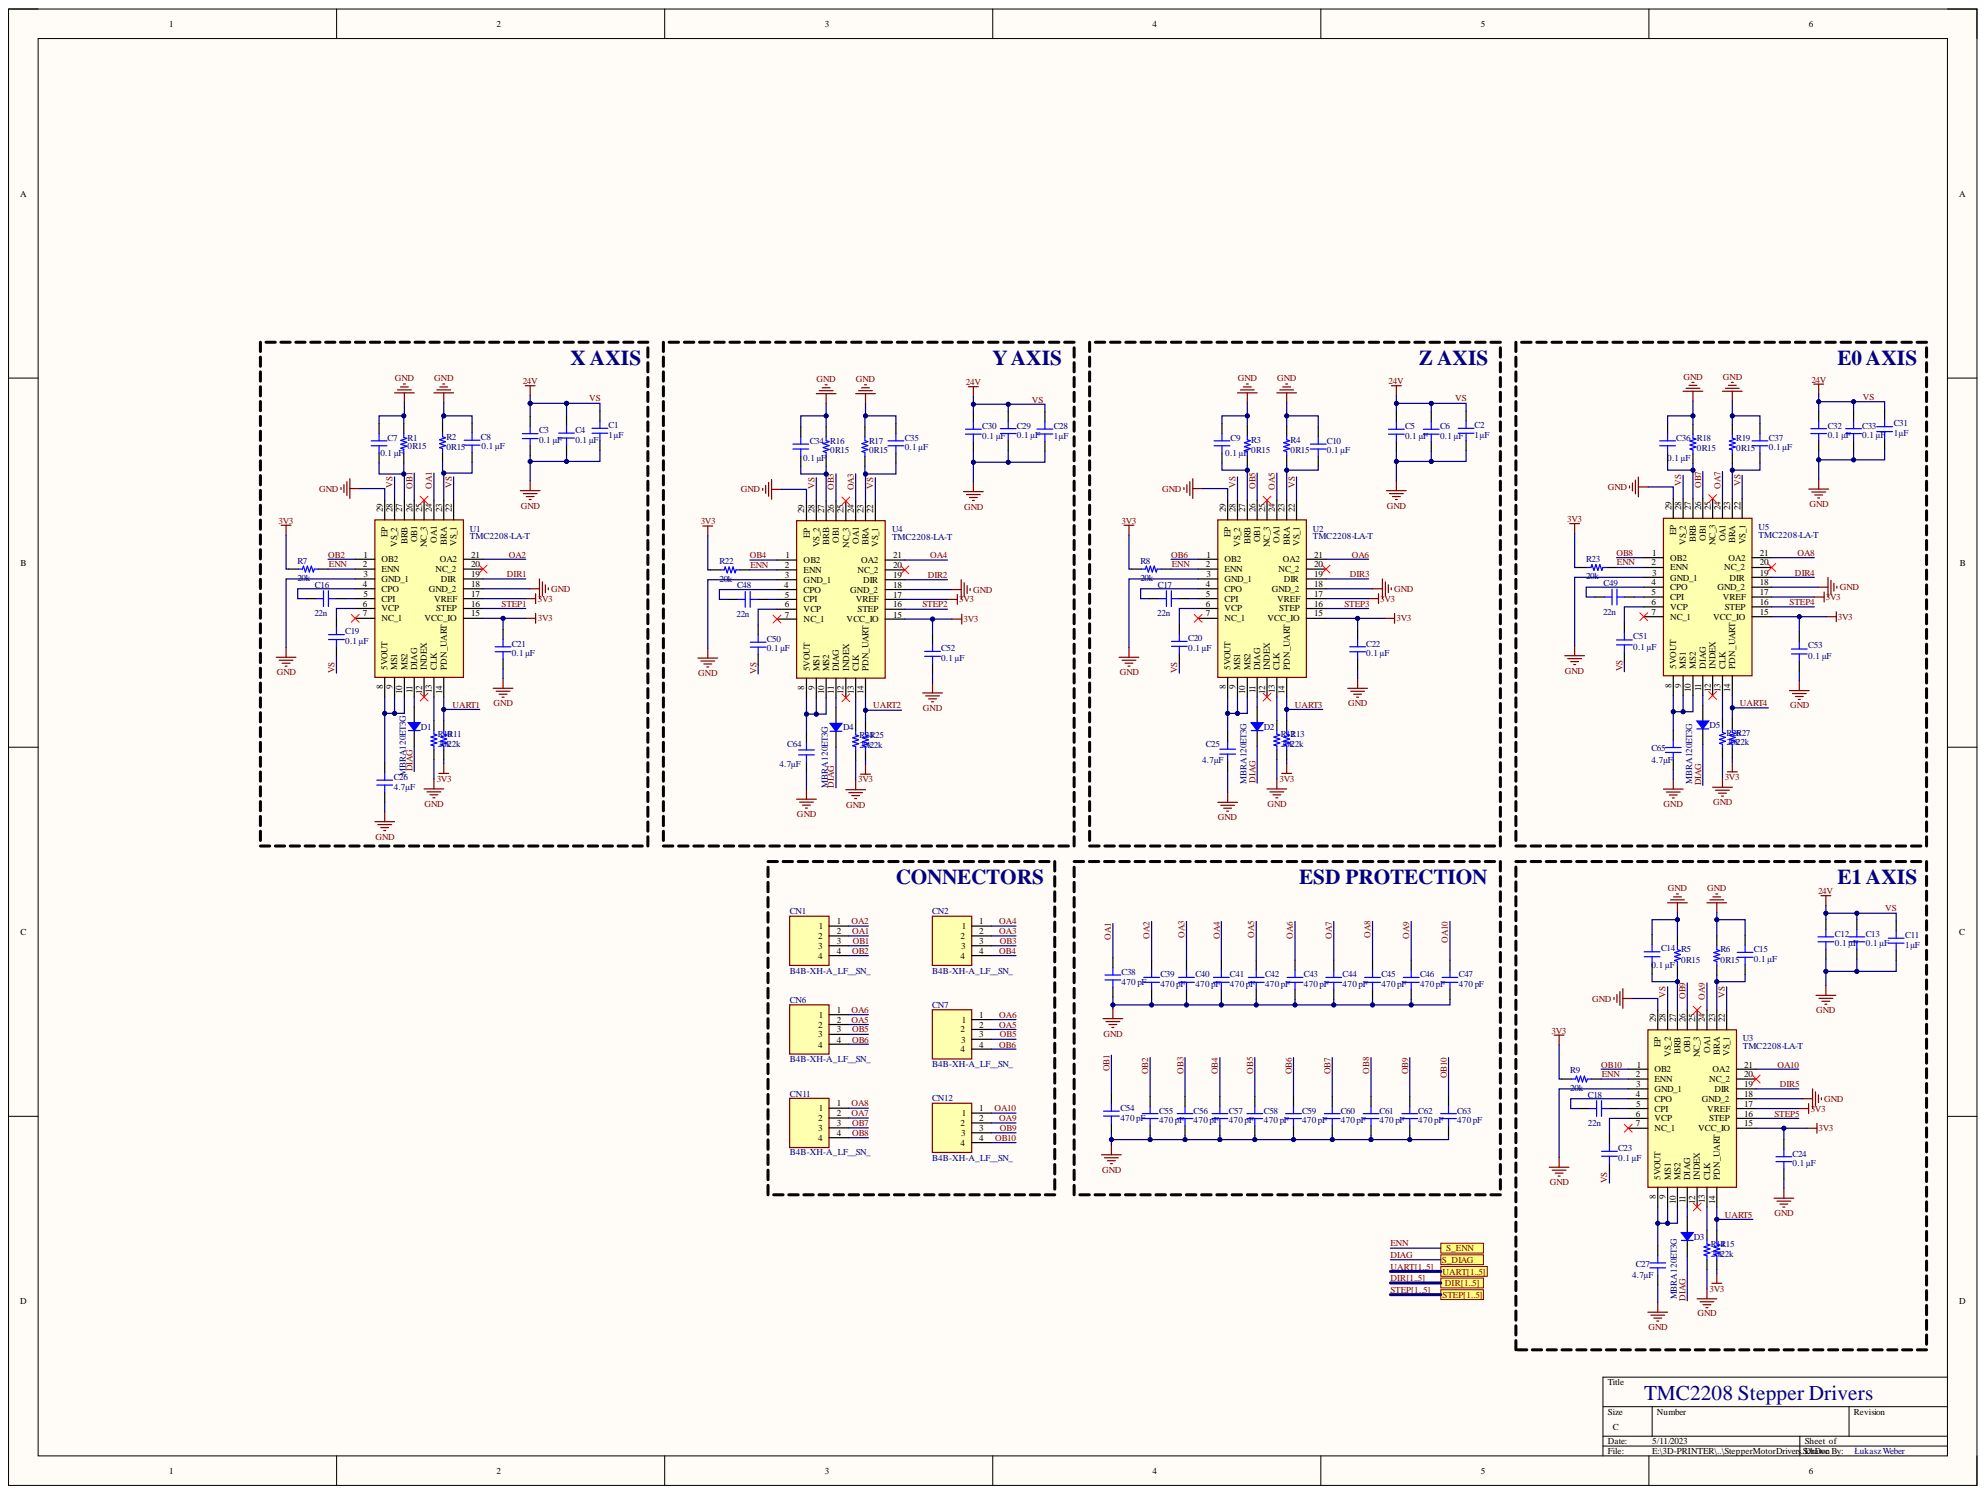
[picture p152: page 4]

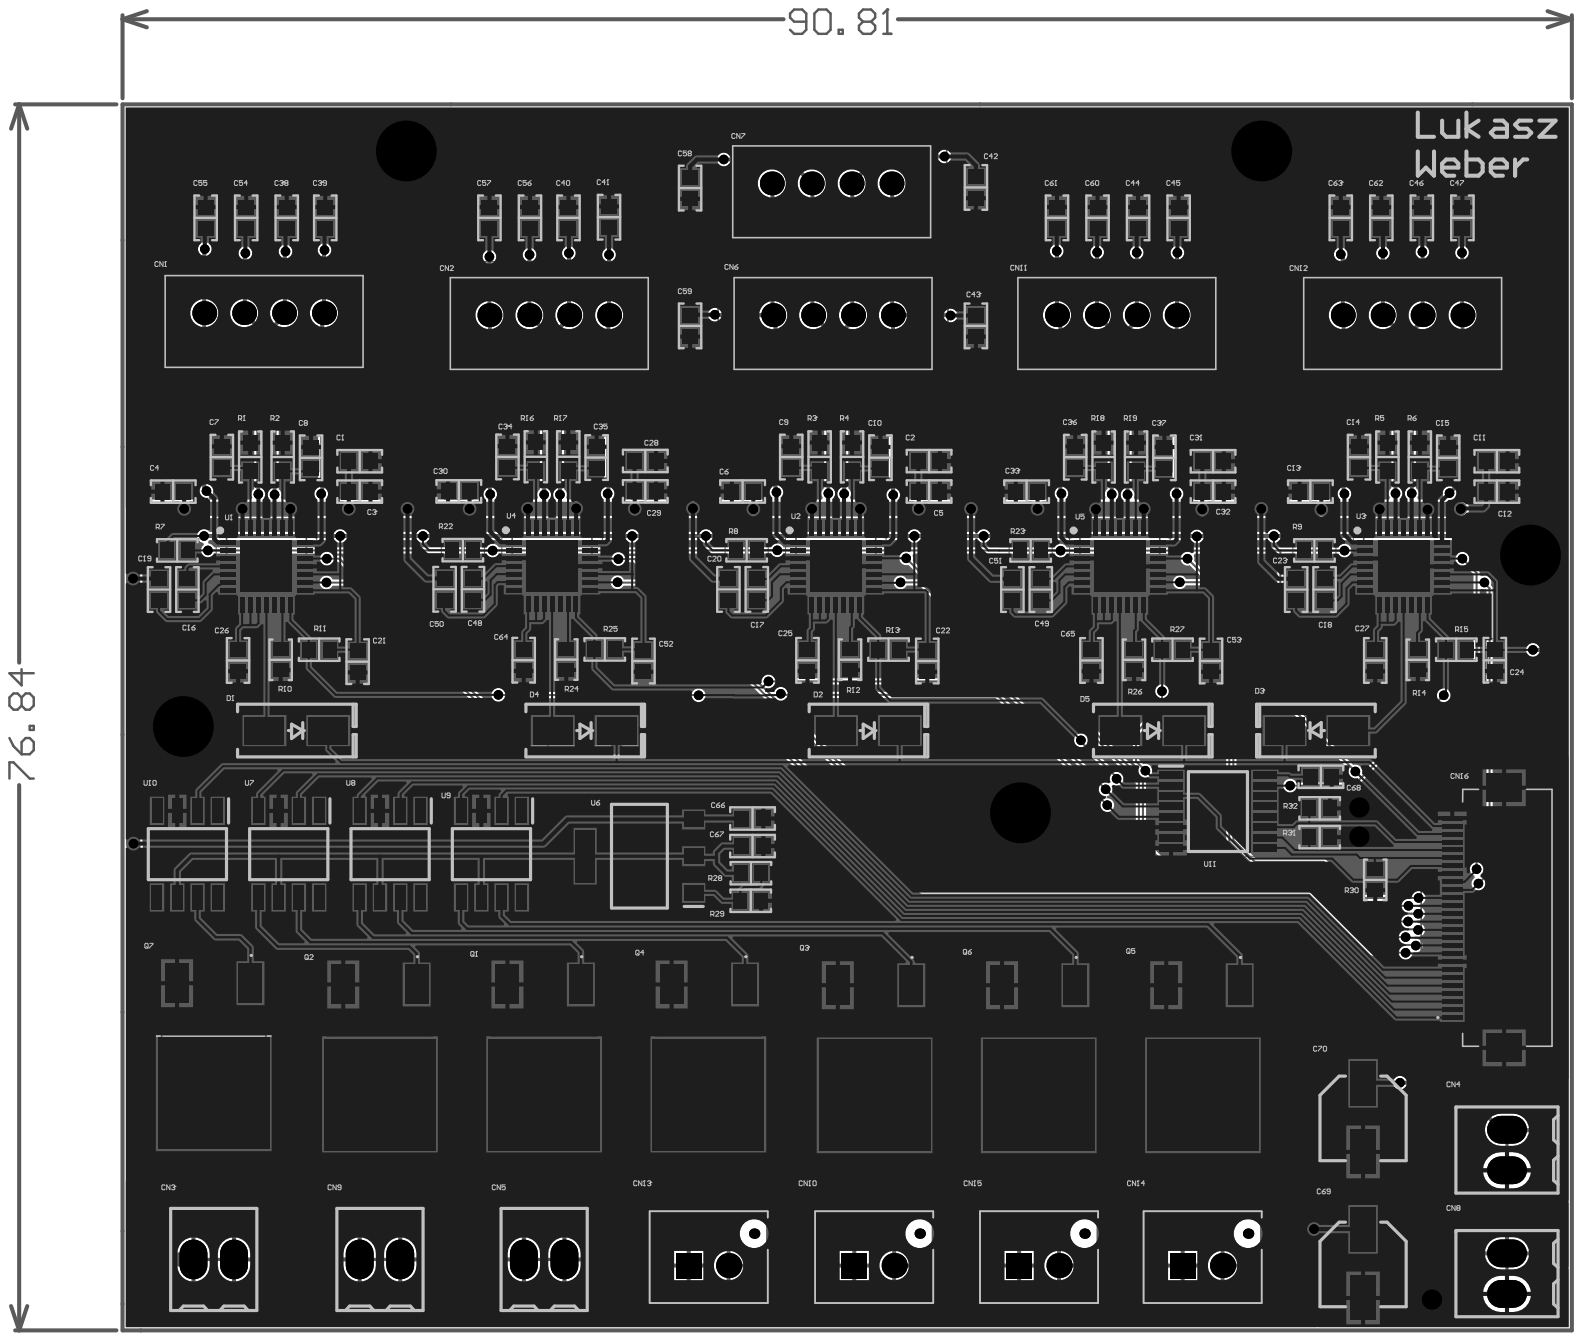
[picture p153: page 5]
