Fake-Oxygen/3D-PRINTER/MOTHERBOARD V2/Motherboard refurb/schemat.pdf

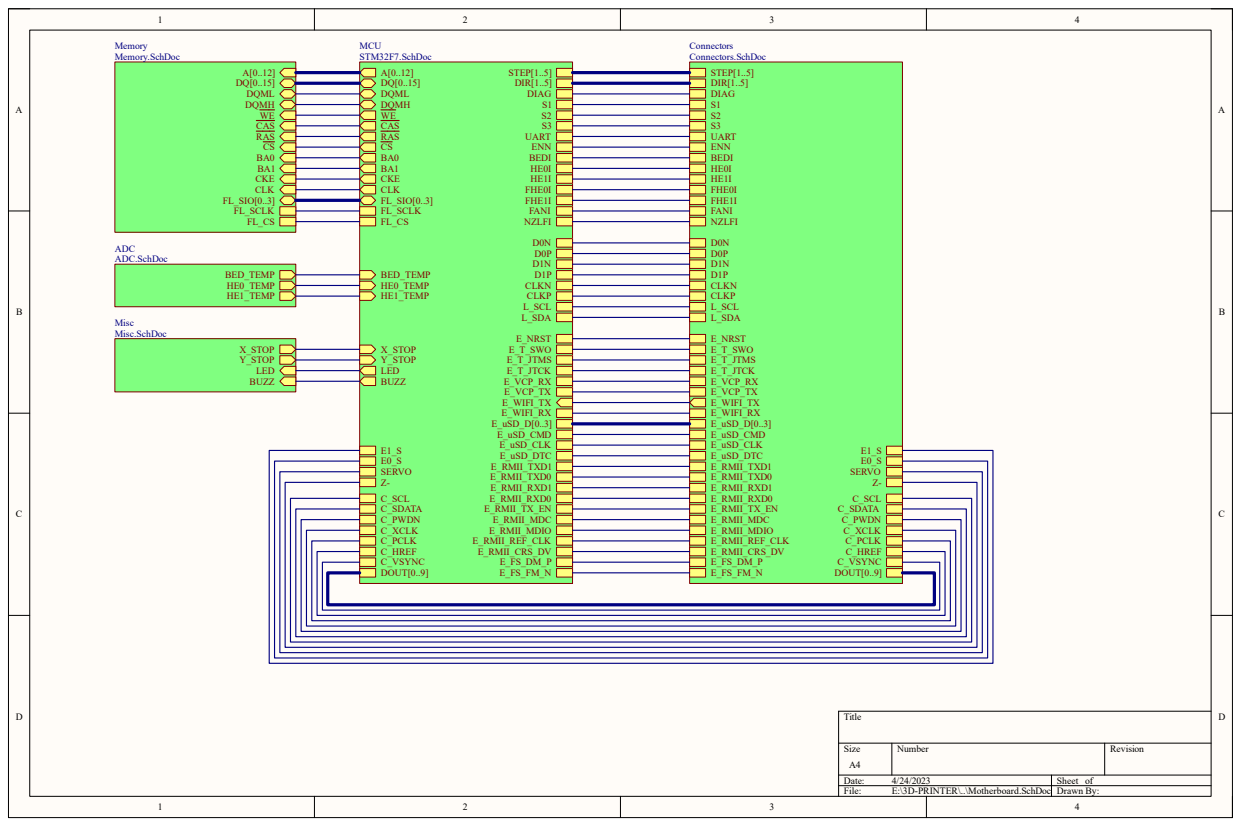
[picture p154: page 1]
Title; Size; Number; Revision; Date:; Sheet of; File:; E:\3D-PRINTER\..\Motherboard.SchDoc; Drawn By:; A[0..12] DQ[0..15] DQML DQMH WE CAS RAS CS BA0 BA1 CKE CLK FL_SIO[0..3] FL_SCLK FL_CS; BED_TEMP HE0_TEMP HE1_TEMP; X_STOP Y_STOP LED BUZZ; STEP[1..5] DIR[1..5] DIAG S1 S2 S3 UART ENN BEDI HE0I HE1I FHE0I FHE1I FANI NZLFI; D0N D0P D1N D1P CLKN CLKP L_SCL L_SDA; E_NRST E_T_SWO; E_uSD_CLK; E_RMII_TXD0; E_WIFI_RX; E_T_JTMS E_T_JTCK E_VCP_RX E_VCP_TX; E_uSD_D[0..3] E_uSD_CMD; E_uSD_DTC E_RMII_TXD1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

# SDRAM

# FLASH

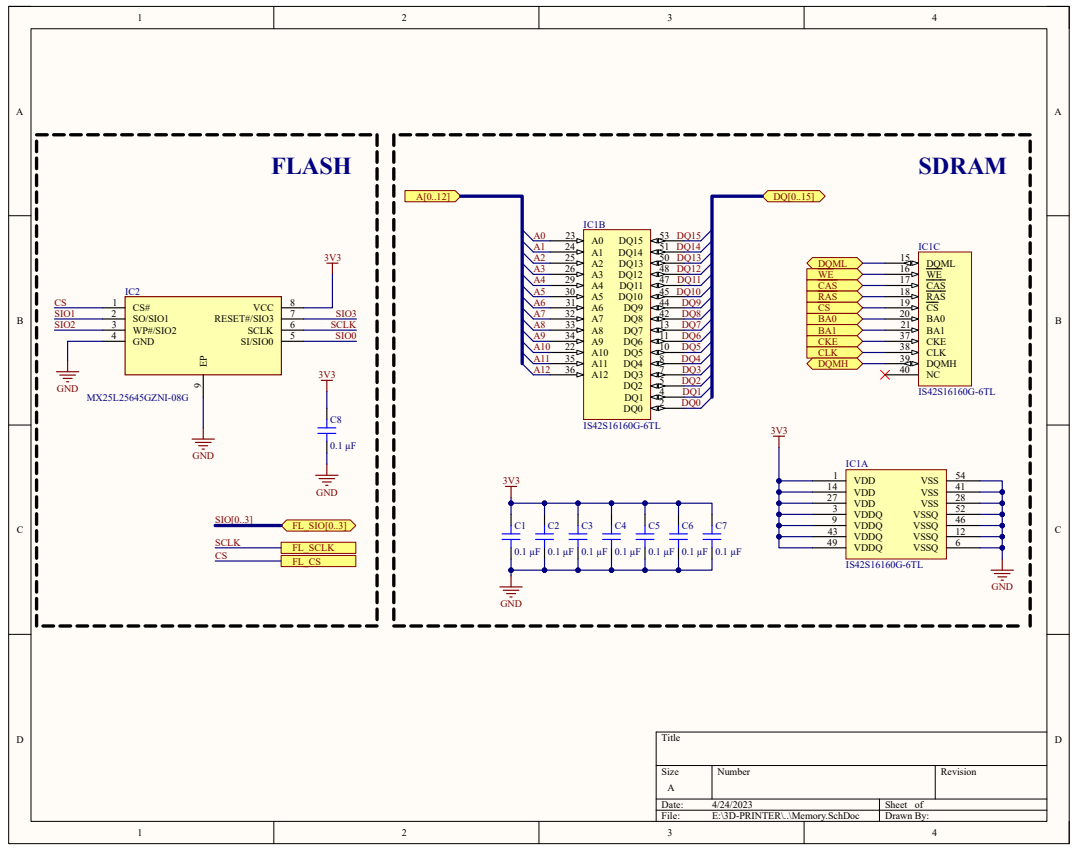
[picture p155: page 2]

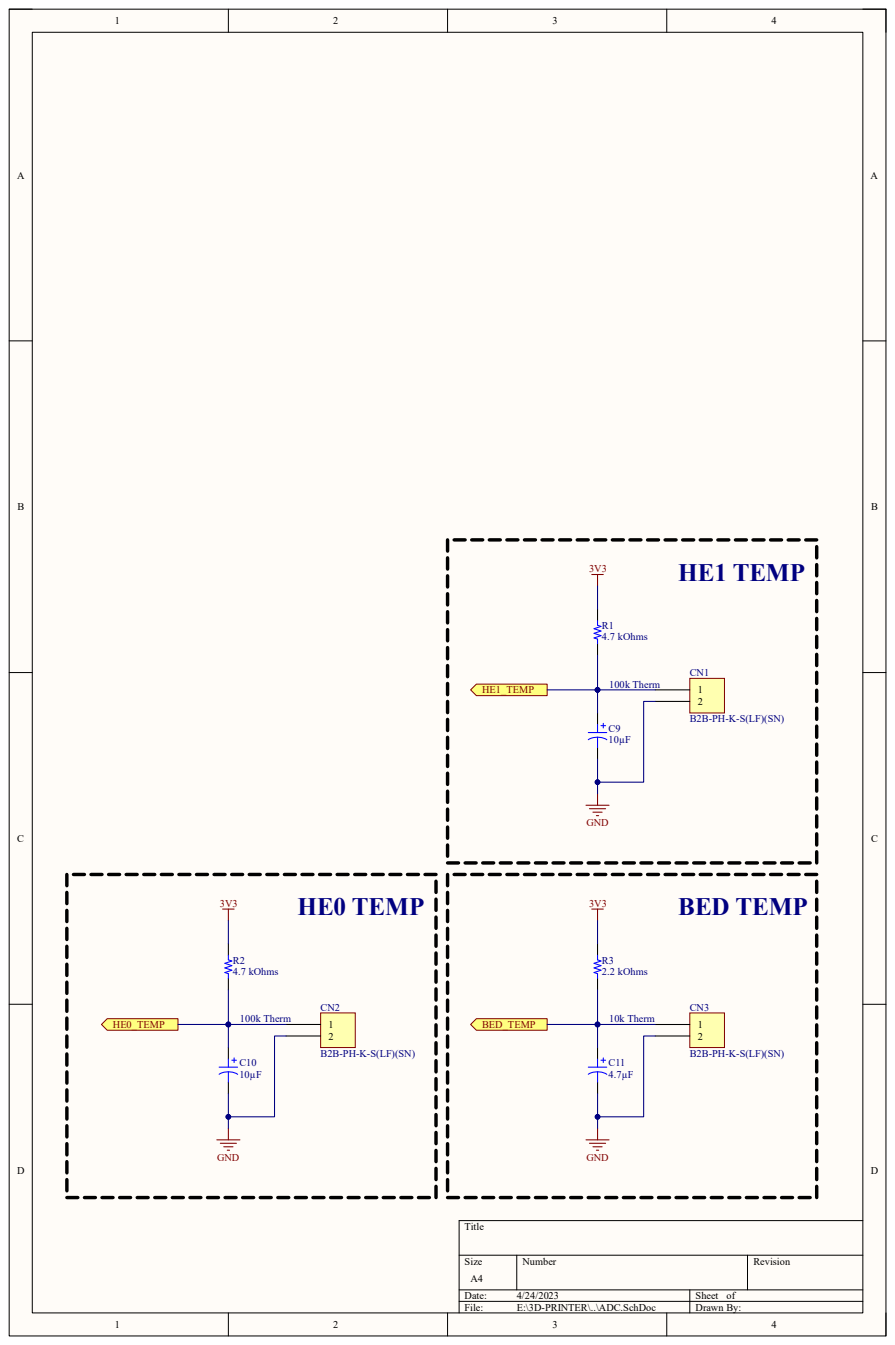
[picture p156: page 3]

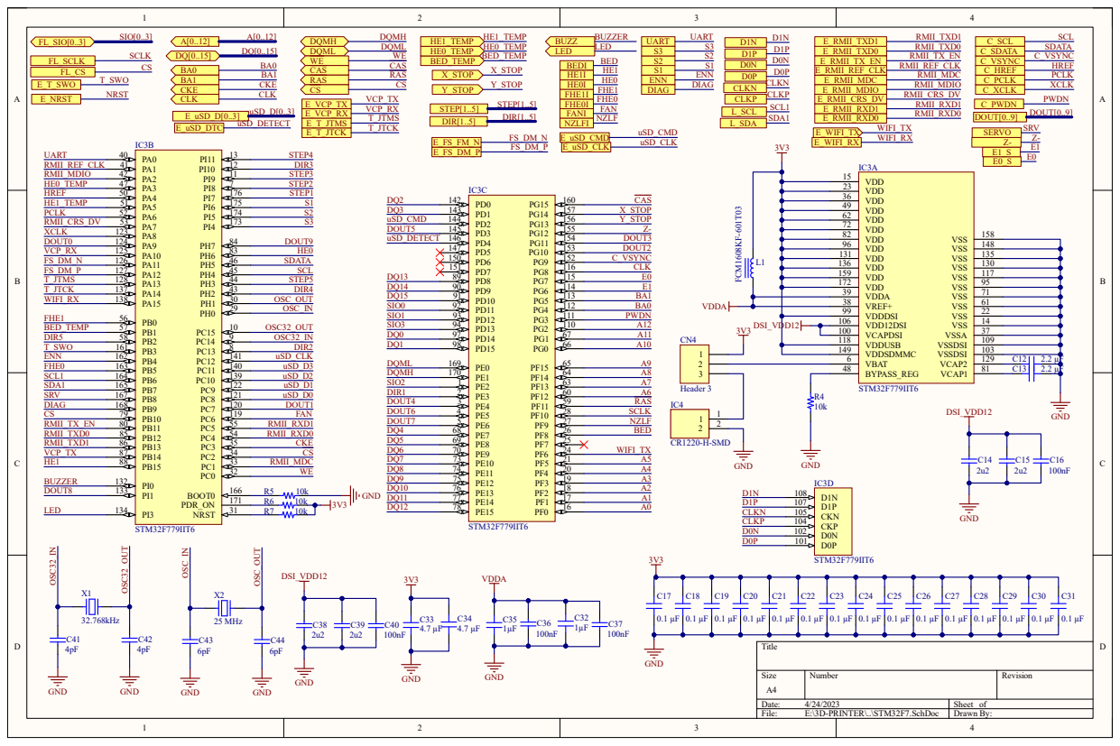
[picture p157: page 4]

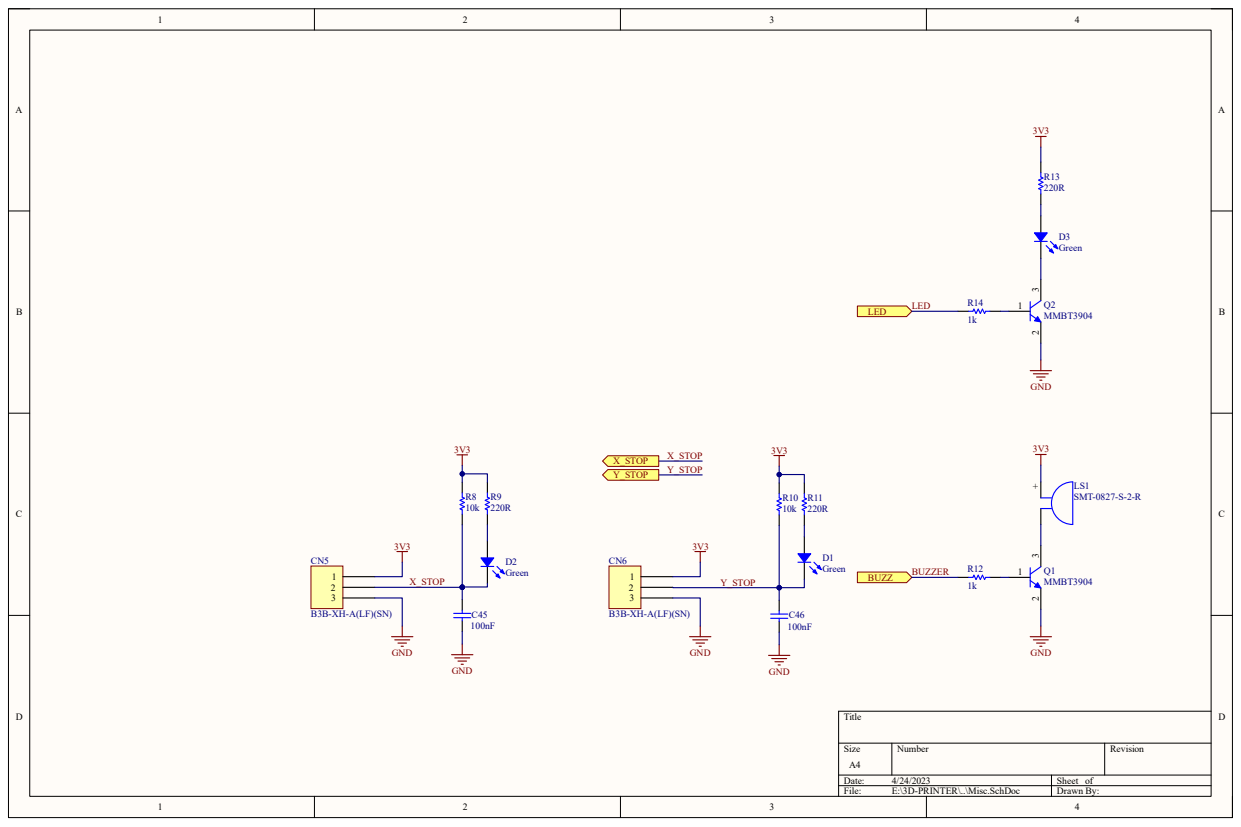
[picture p158: page 5]

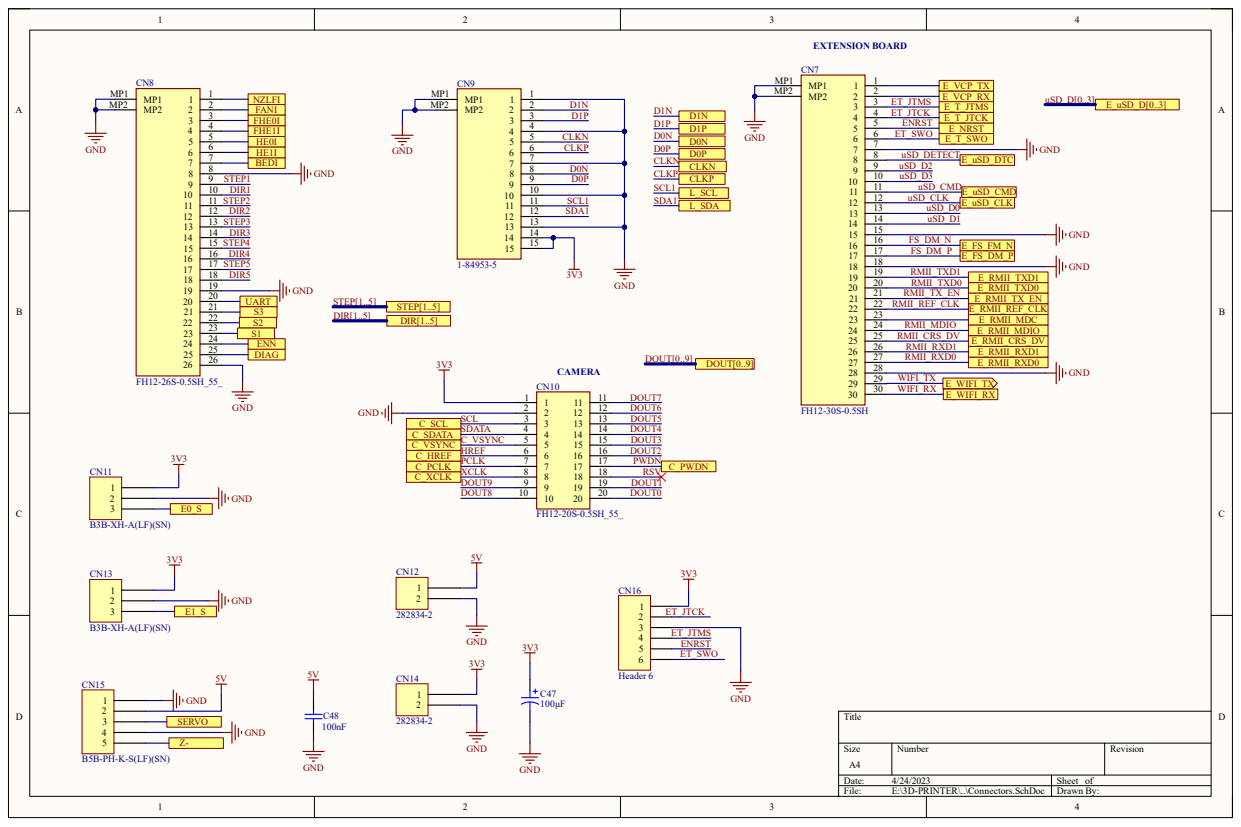
[picture p159: page 6]
