Fake-Oxygen/3D-PRINTER/MOTHERBOARD V2/Motherboard refurb/schemat2.pdf

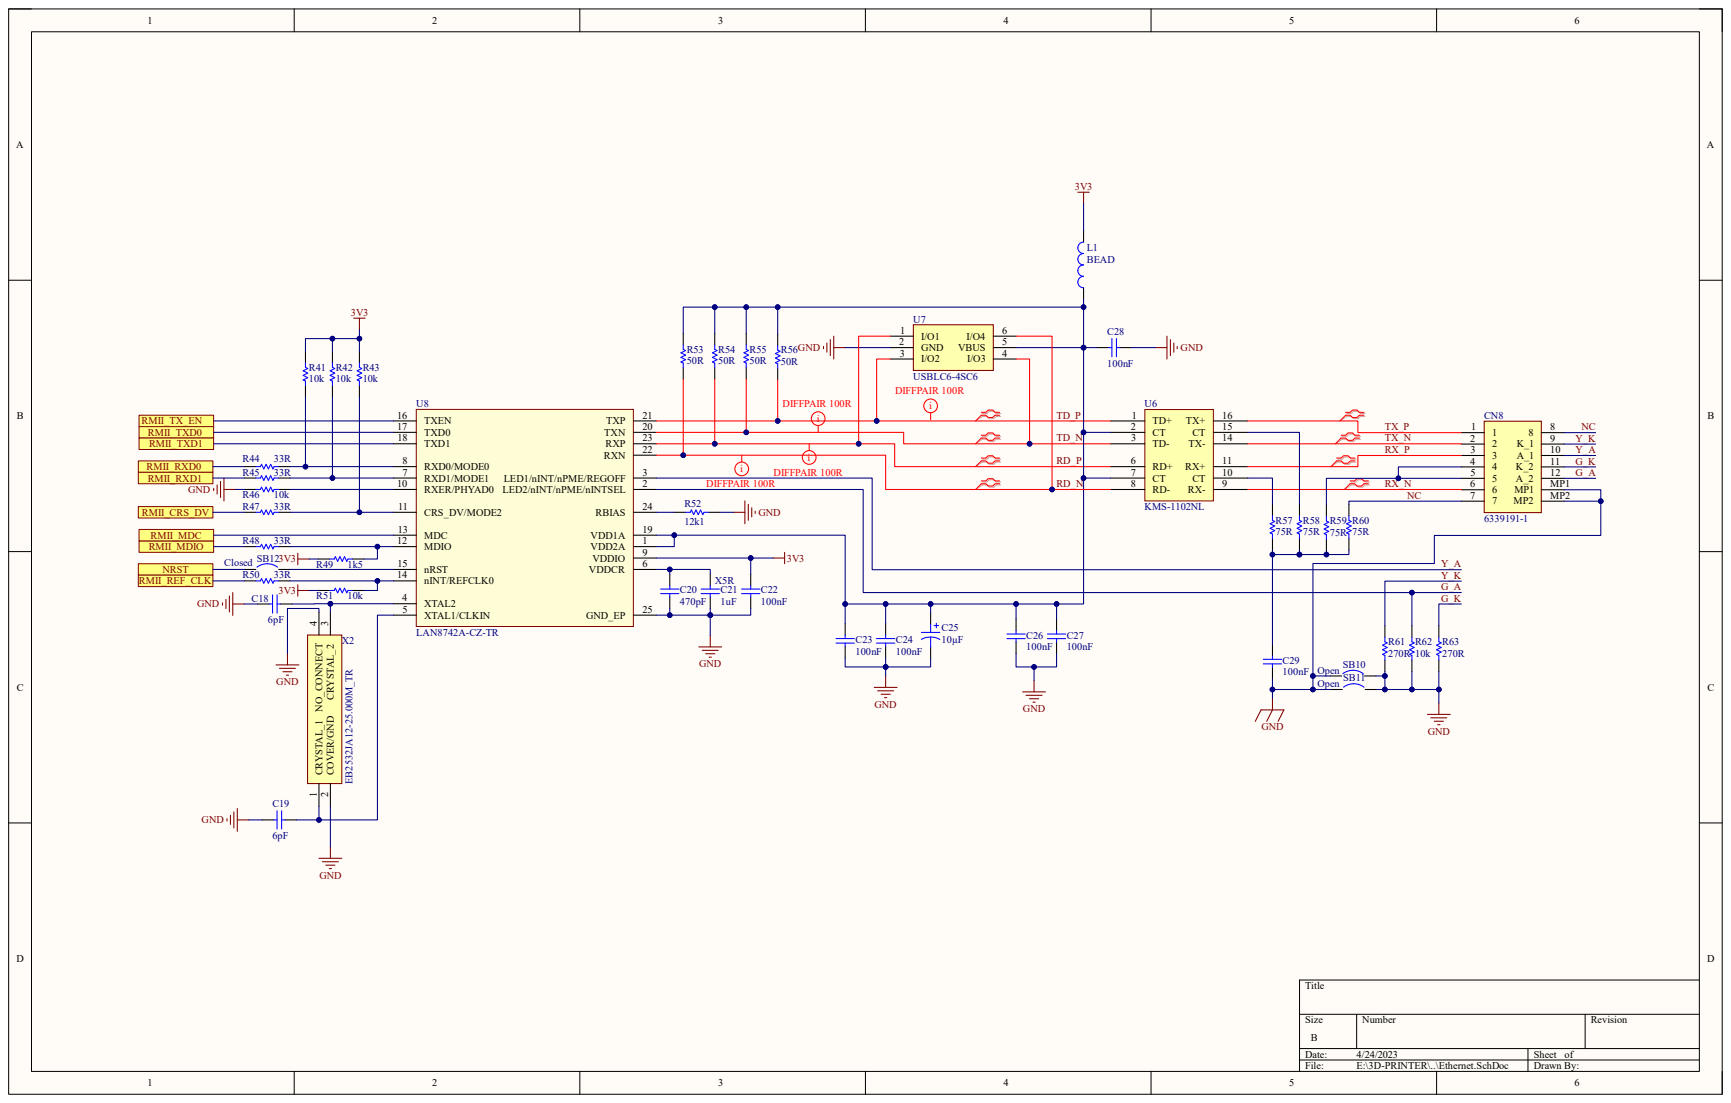
[picture p160: page 1]

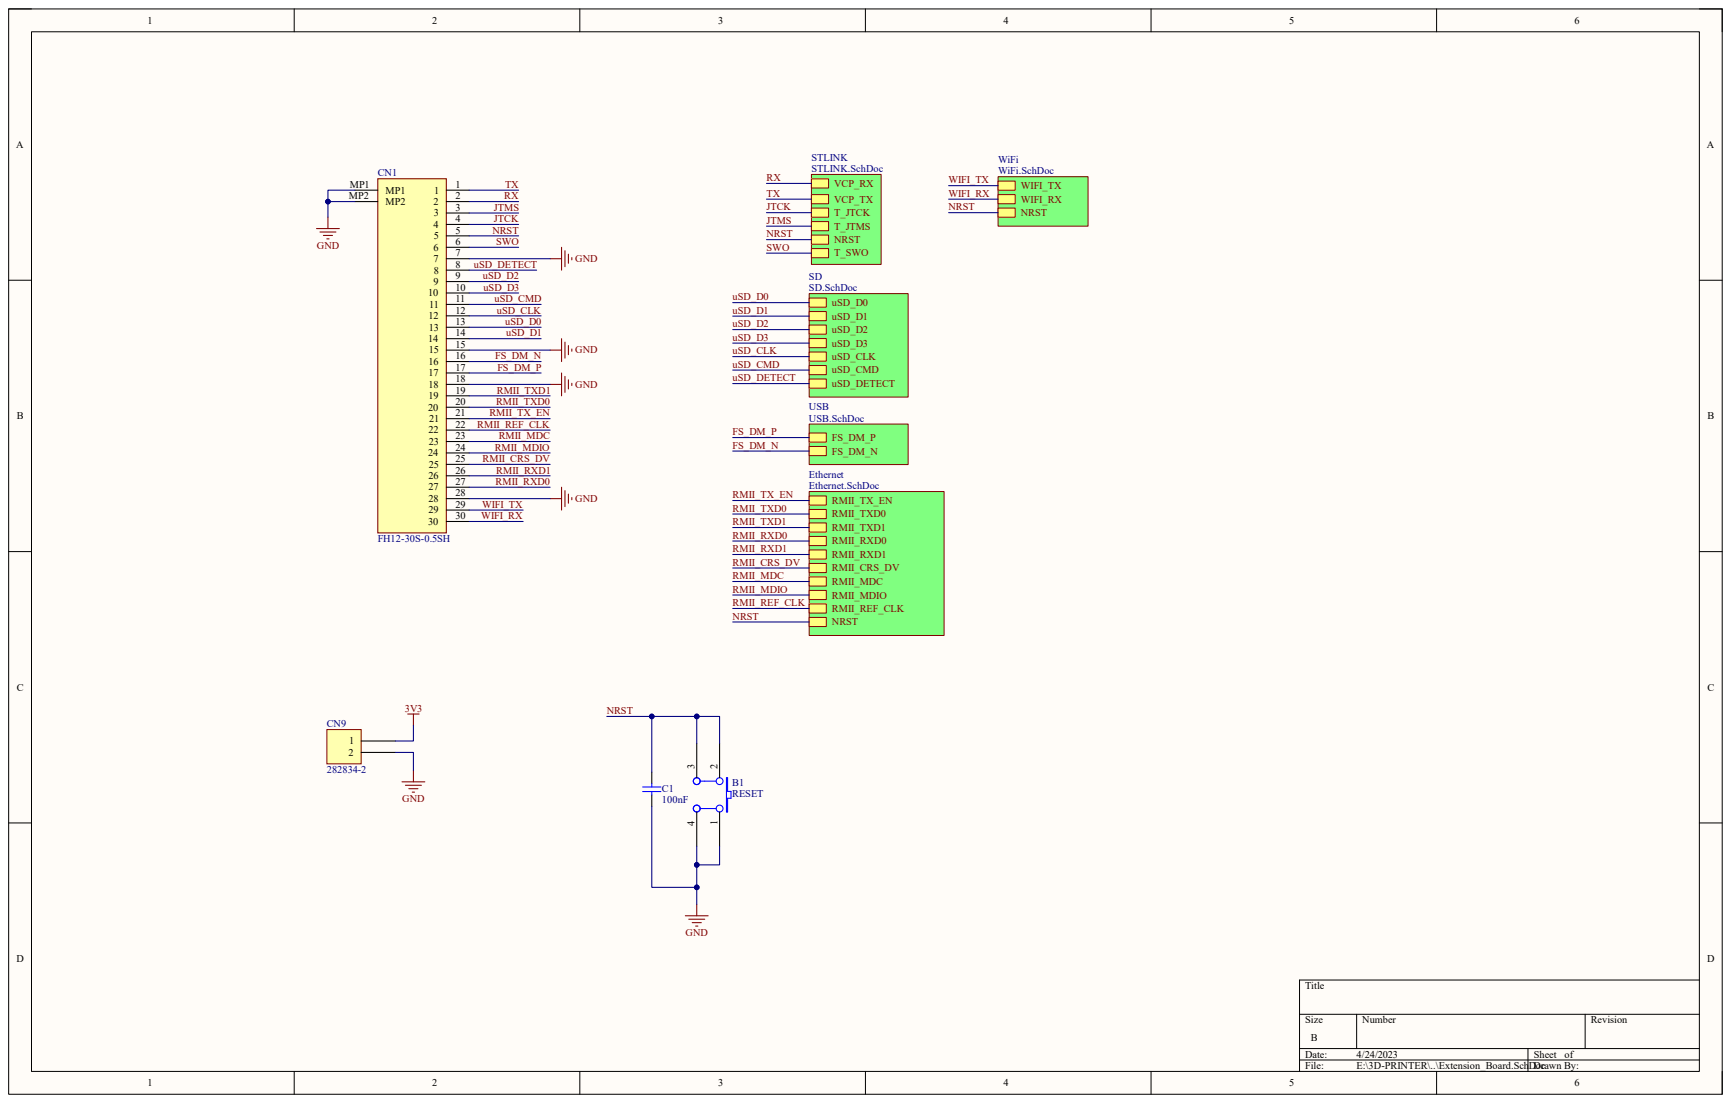
[picture p161: page 2]
Title; Size; Number; Revision B; Date:; Sheet of; File:; E:\3D-PRINTER\..\Extension_Board.SchDoc Drawn By:; GND; VCP_RX VCP_TX T_JTCK T_JTMS NRST T_SWO; STLINK STLINK.SchDoc; JTCK; JTMS NRST SWO; NRST SWO; NRST; uSD_D0 uSD_D1 uSD_D2 uSD_D3 uSD_CLK uSD_CMD uSD_DETECT; SD SD.SchDoc; uSD_CLK; USB USB.SchDoc; RMII_TX_EN RMII_TXD0 RMII_TXD1 RMII_RXD0 RMII_RXD1 RMII_CRS_DV RMII_MDC RMII_MDIO RMII_REF_CLK NRST; Ethernet Ethernet.SchDoc; RMII_TXD0; WIFI_TX WIFI_RX NRST; WiFi WiFi.SchDoc WIFI_TX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

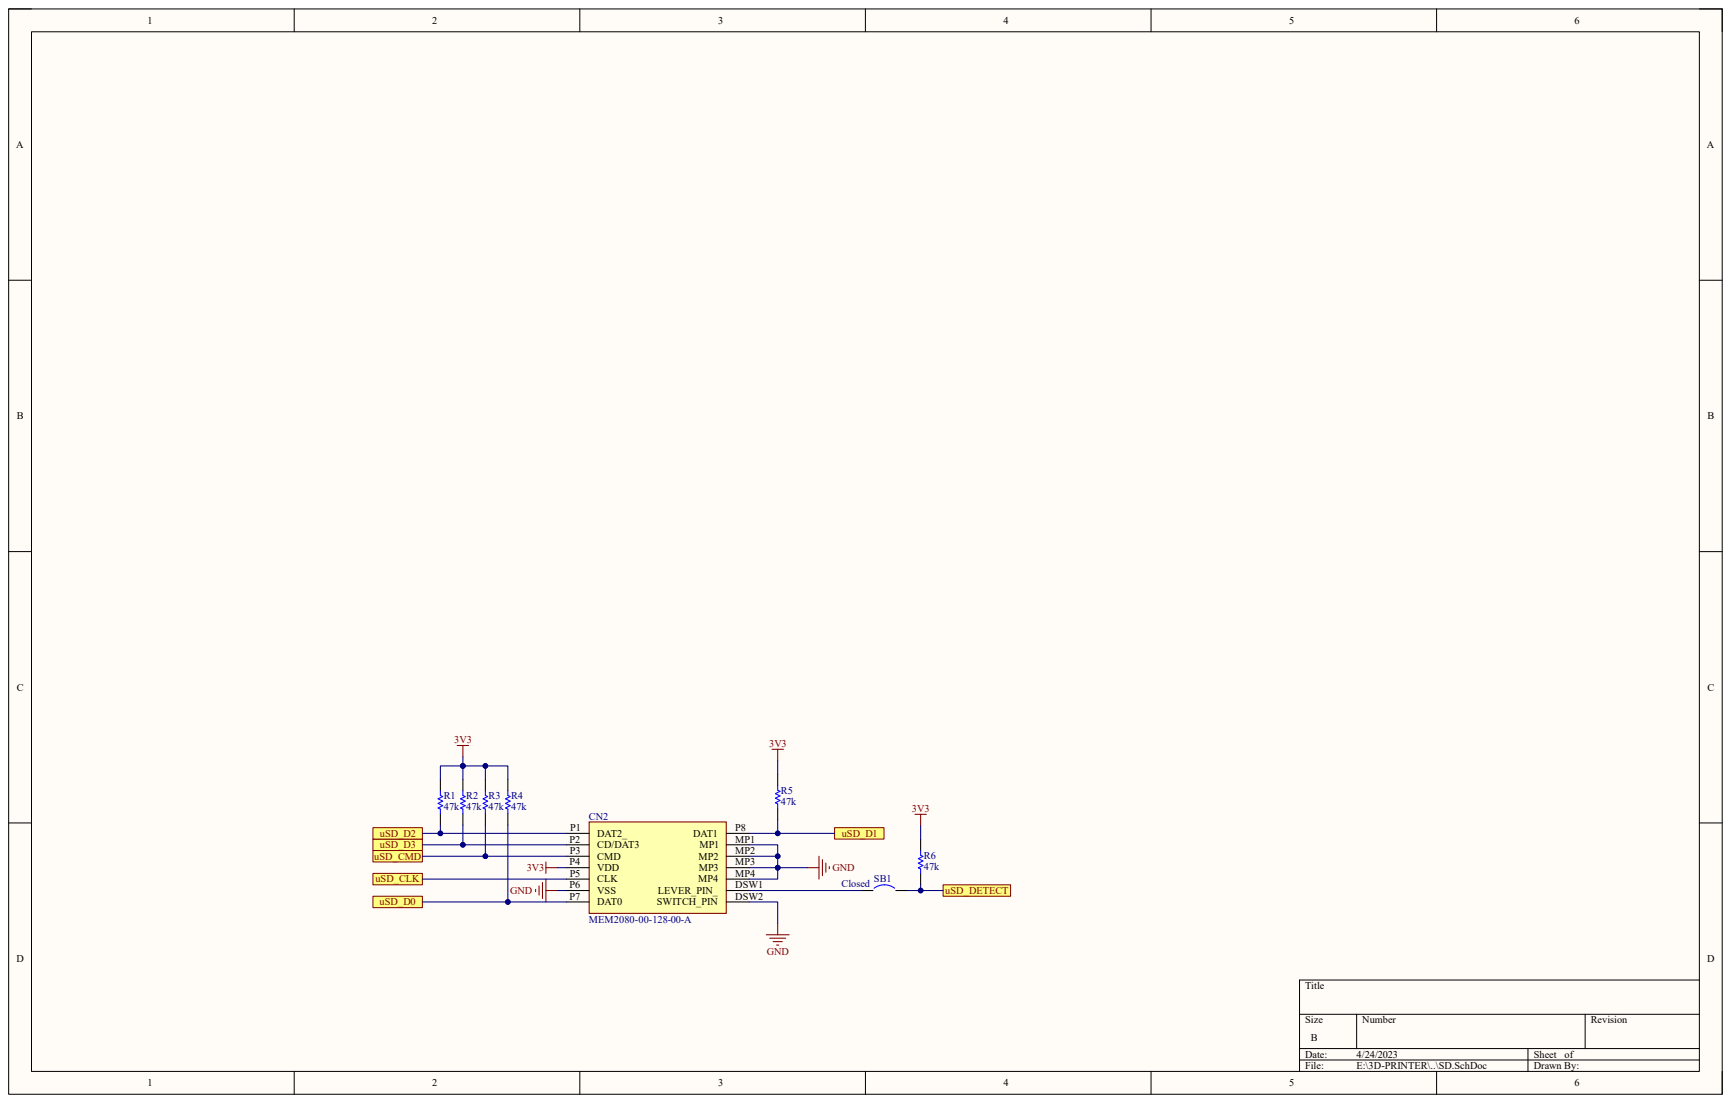
[picture p162: page 3]

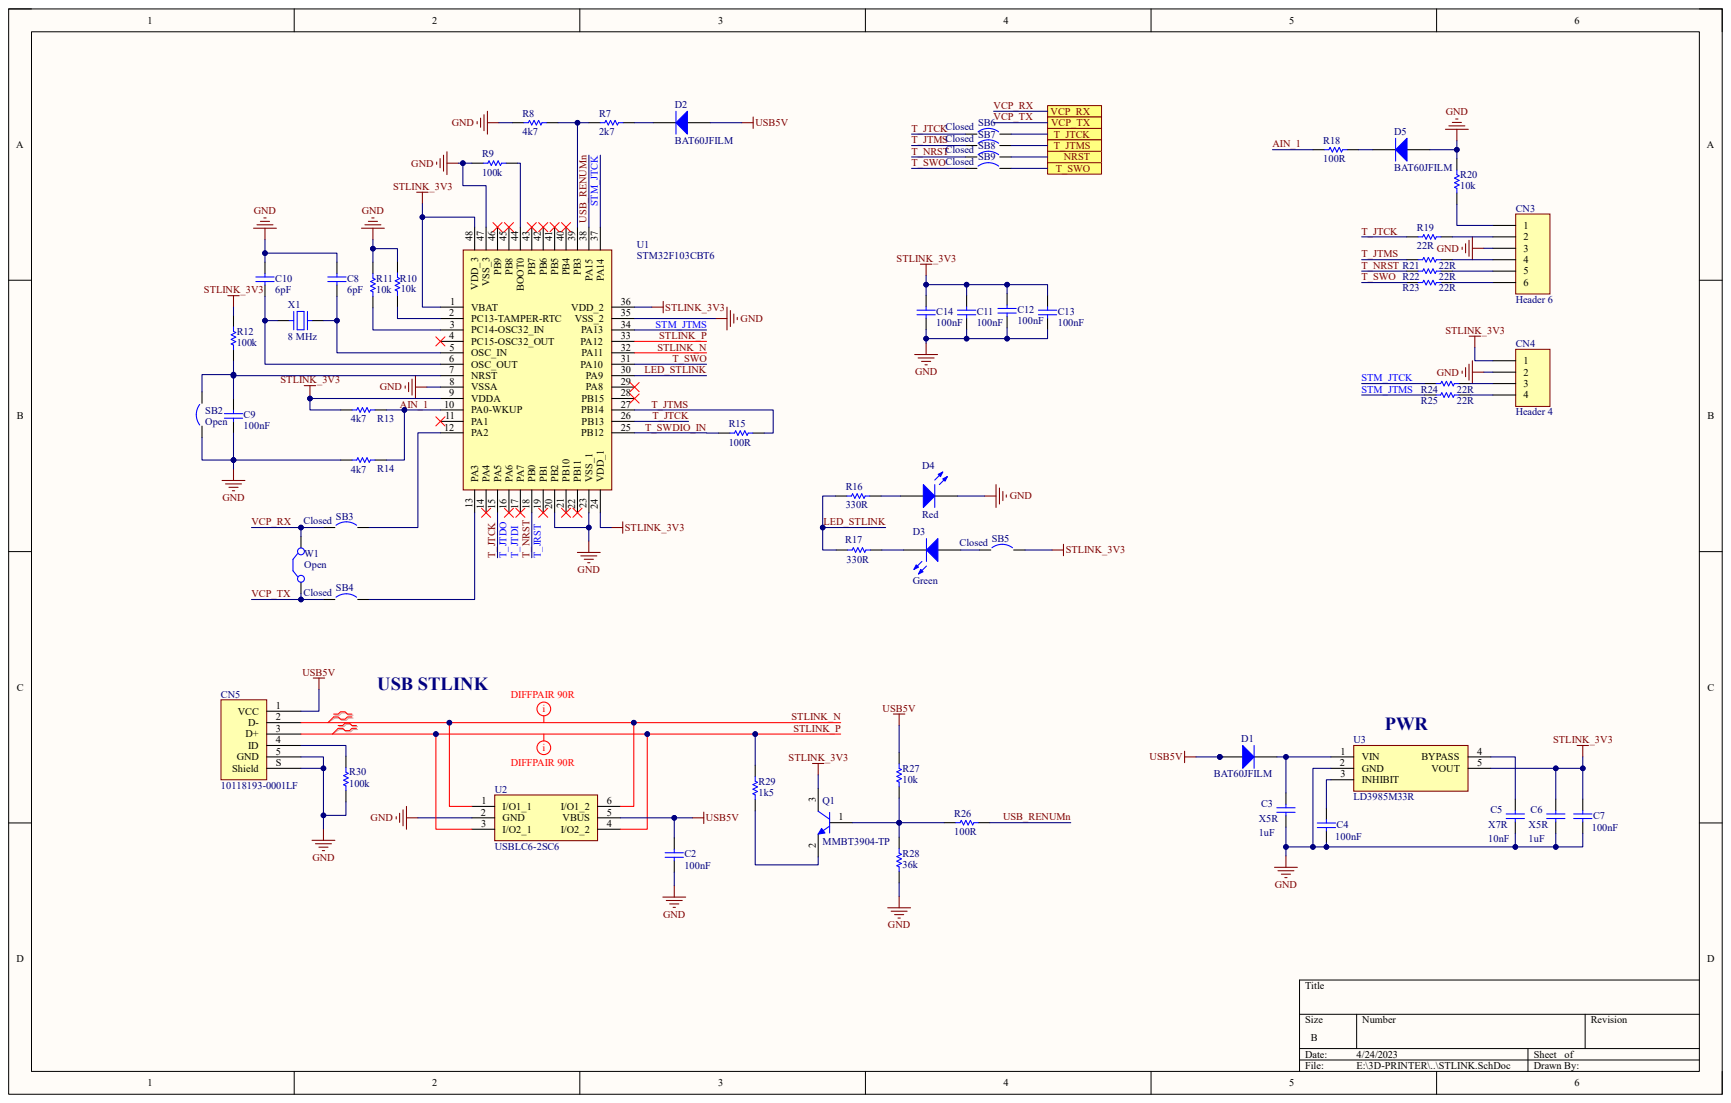
[picture p163: page 4]

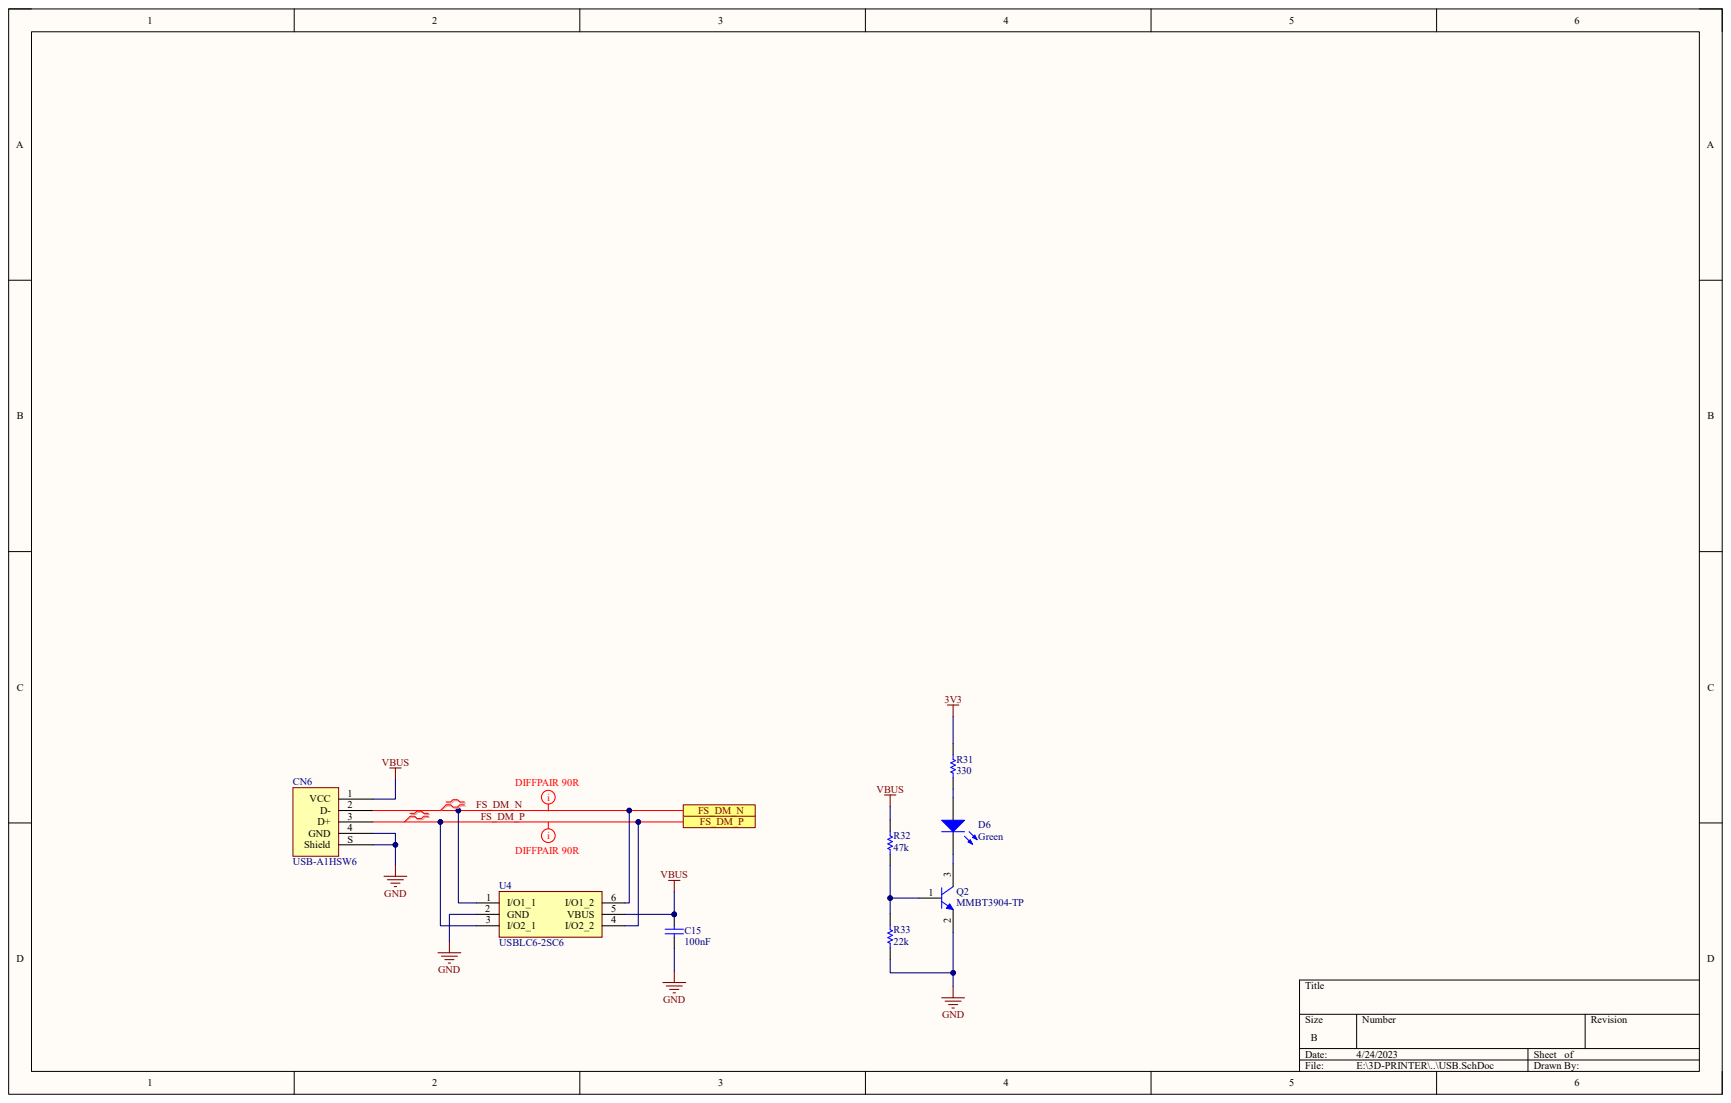
[picture p164: page 5]

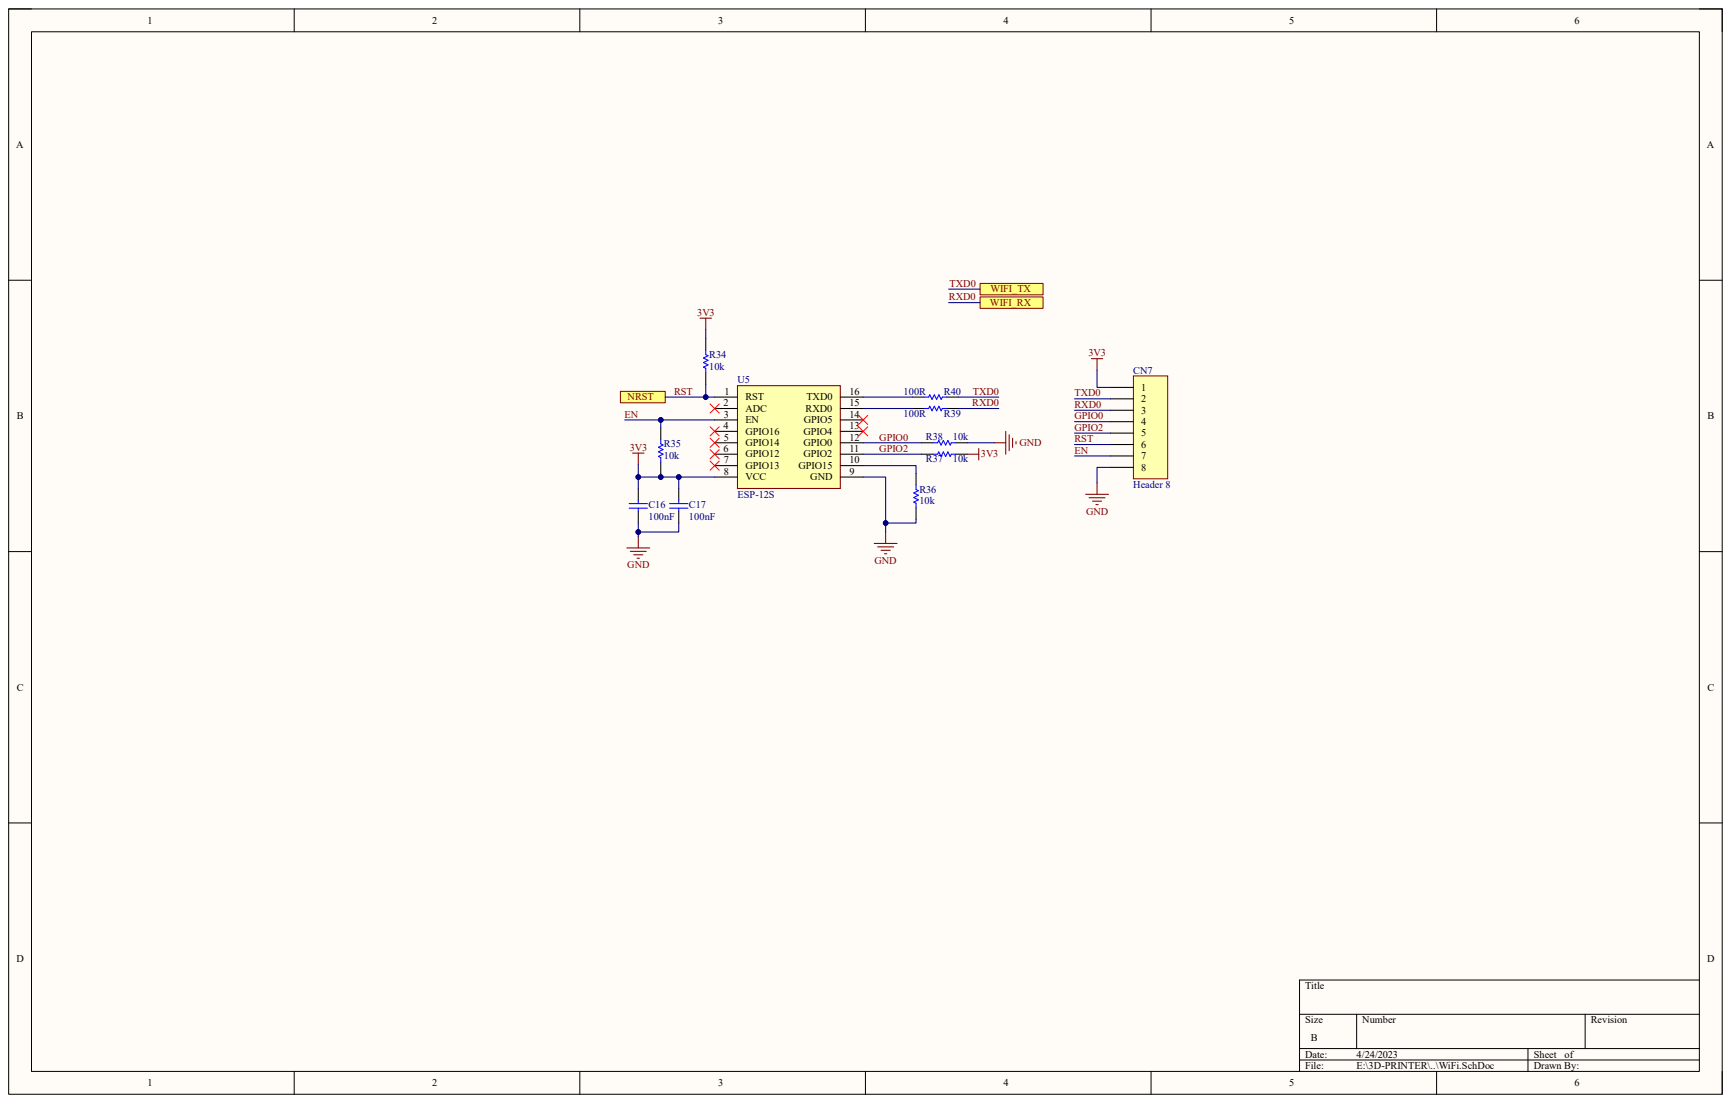
[picture p165: page 6]
