Fake-Oxygen/3D-PRINTER/MOTHERBOARD V2/Motherboard refurb/schemat3.pdf

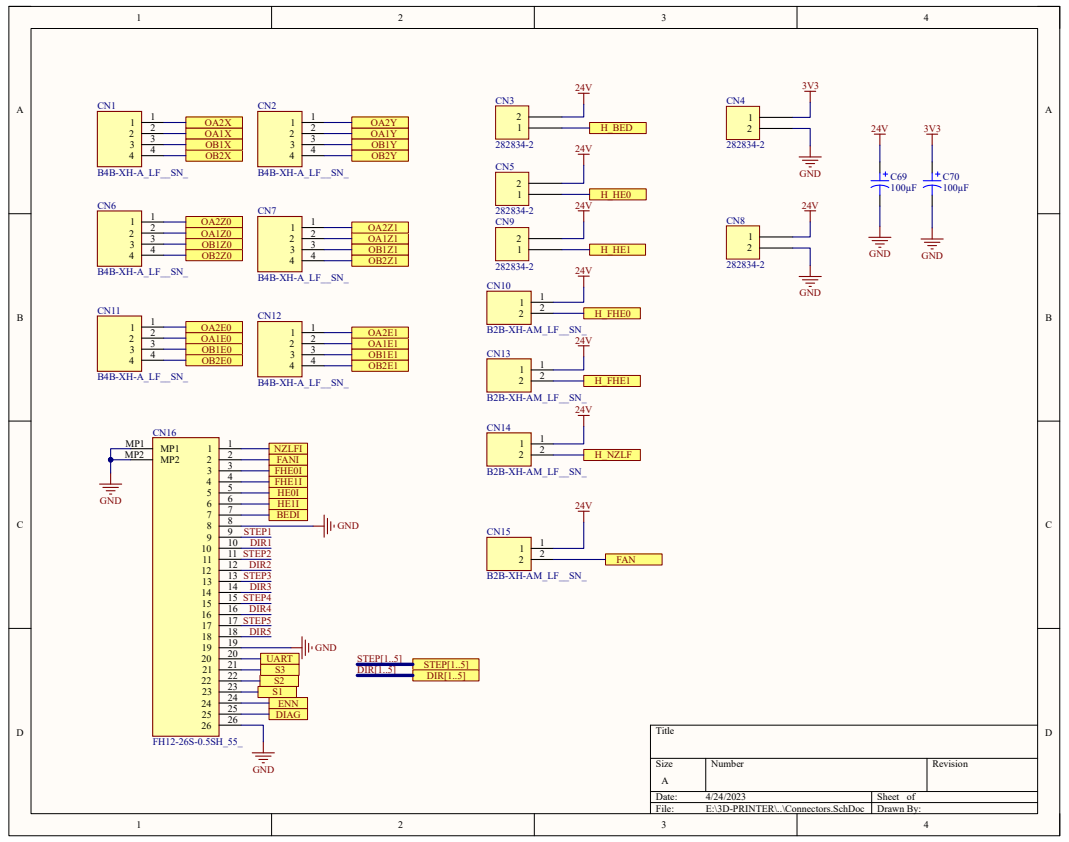
[picture p166: page 1]

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
Title

Size | Number | Revision A
File: | E:\3D-PRINTER\..\PowerDriver.SchDoc | Drawn By:

S_ENN

STEP[1..5]

S_DIAG

OA[1..10]

OB[1..10]

UART[1..5]

DIR[1..5]

Stepper Motor Drivers
StepperMotorDrivers.SchDoc

SL_E1

SL_Z

SL_UART
SL_Y

SL_E0

SL_X
SL_S1

SL_S3

SL_S2

Stepper Logic
StepperLogic.SchDoc

ENN

STEP[1..5]

DIAG

UART[1..5]

DIR[1..5]

OA[1..10]

OB[1..10]

UART
S1
S2
S3

UART1
UART2
UART3
UART4
UART5

FHE0O
FHE1I
HE0I | HE0O
BEDI | BEDO
| NZLFO
FANI | FANO FHE1O

NZLFI

FHE0I

HE1I | HE1O

PWM Driver
PWMDriver.SchDoc

OA1X
OB1X
OB2X
OA2X
OA1Y
OB1Y
OB2Y
OA2Y
OA1Z0
OB1Z0
OB2Z0
OA2Z0
OA1Z1
OB1Z1
OB2Z1
OA2Z1
OA1E0
OB1E0
OB2E0
OA2E0
OA1E1
OB1E1
OB2E1
OA2E1
H_BED
H_HE0
H_HE1
H_FHE0
H_FHE1
H_NZLF
FAN
UART
S1
S2
S3
FHE0I
FHE1I
HE0I
HE1I
BEDI
NZLFI
FANI
ENN
DIAG
STEP[1..5]
DIR[1..5]

Connectors
Connectors.SchDoc
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
OB10
OA10
BEDO
HE0O
HE1O
FHE0O
FHE1O
NZLFO
FANO
UART
S1
S2
S3
FHE0I
FHE1I
HE0I
HE1I
BEDI
NZLFI
FANI
ENN
DIAG
STEP[1..5]
DIR[1..5]

FHE0I
FHE1I
HE0I
HE1I
BEDI
NZLFI
FANI

FHE0O
FHE1O
HE0O
HE1O
BEDO
NZLFO
FANO

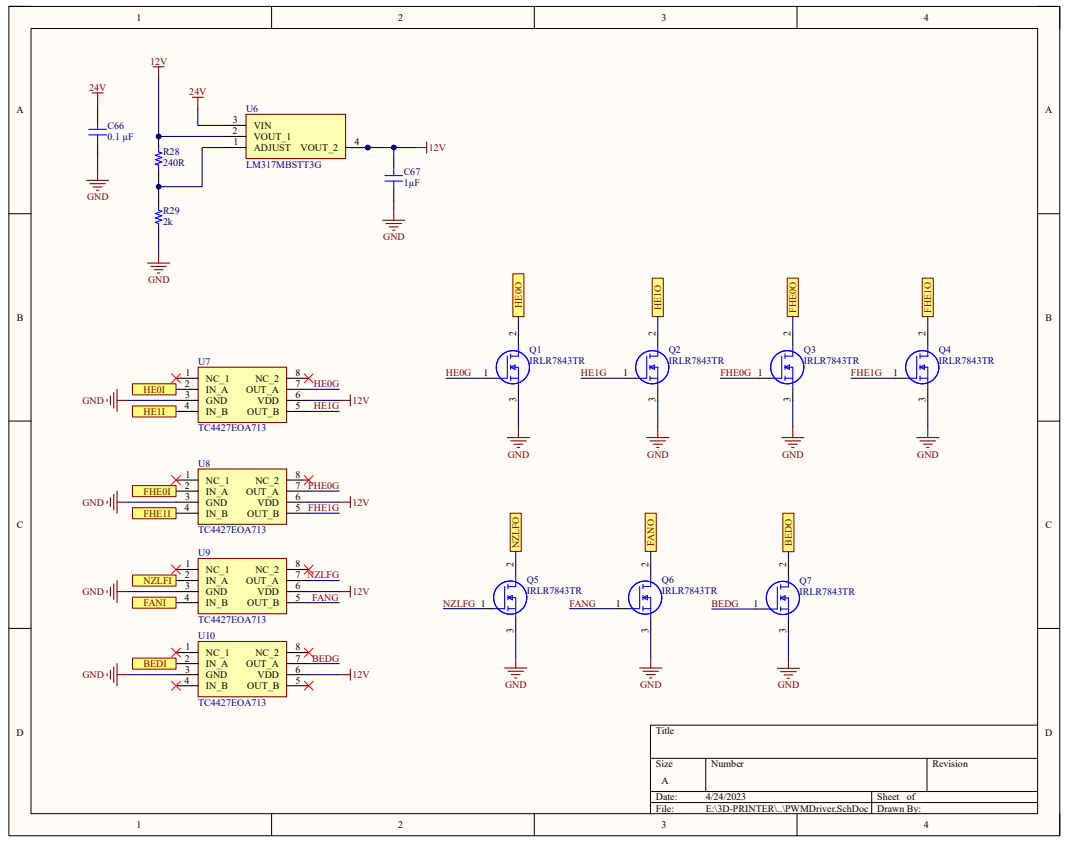
[picture p167: page 3]

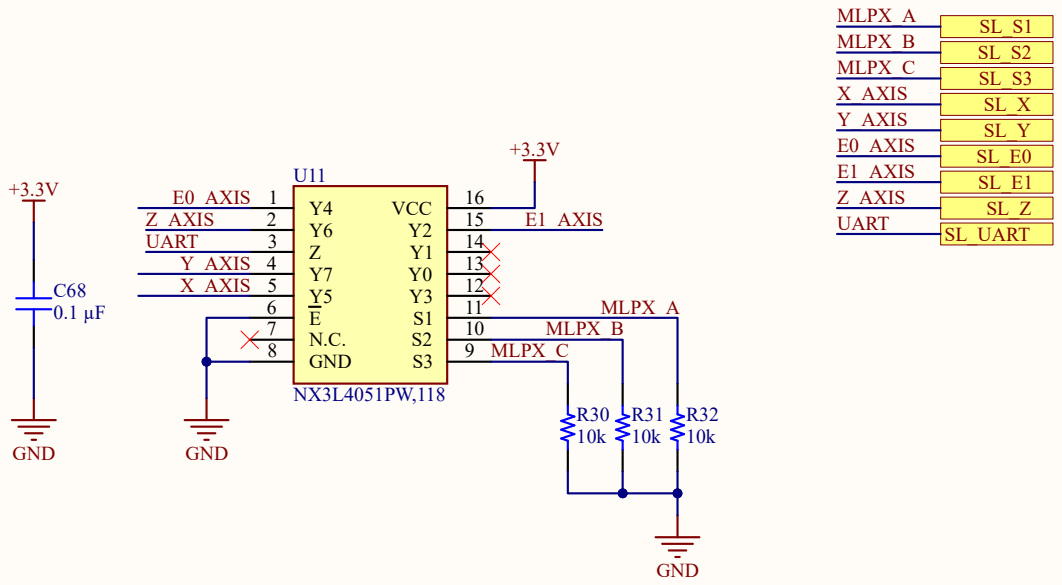
[picture p168: page 4]
Title; Size; Number; Revision; File:; E:\3D-PRINTER\..\StepperLogic.SchDoc Drawn By:; 6 N.C. 7 GND 8; VCC; GND; MLPX_A MLPX_B MLPX_C; UART; Z_AXIS; SL_UART; E1_AXIS; E0_AXIS; Y_AXIS; X_AXIS; MLPX_C; MLPX_B; MLPX_A

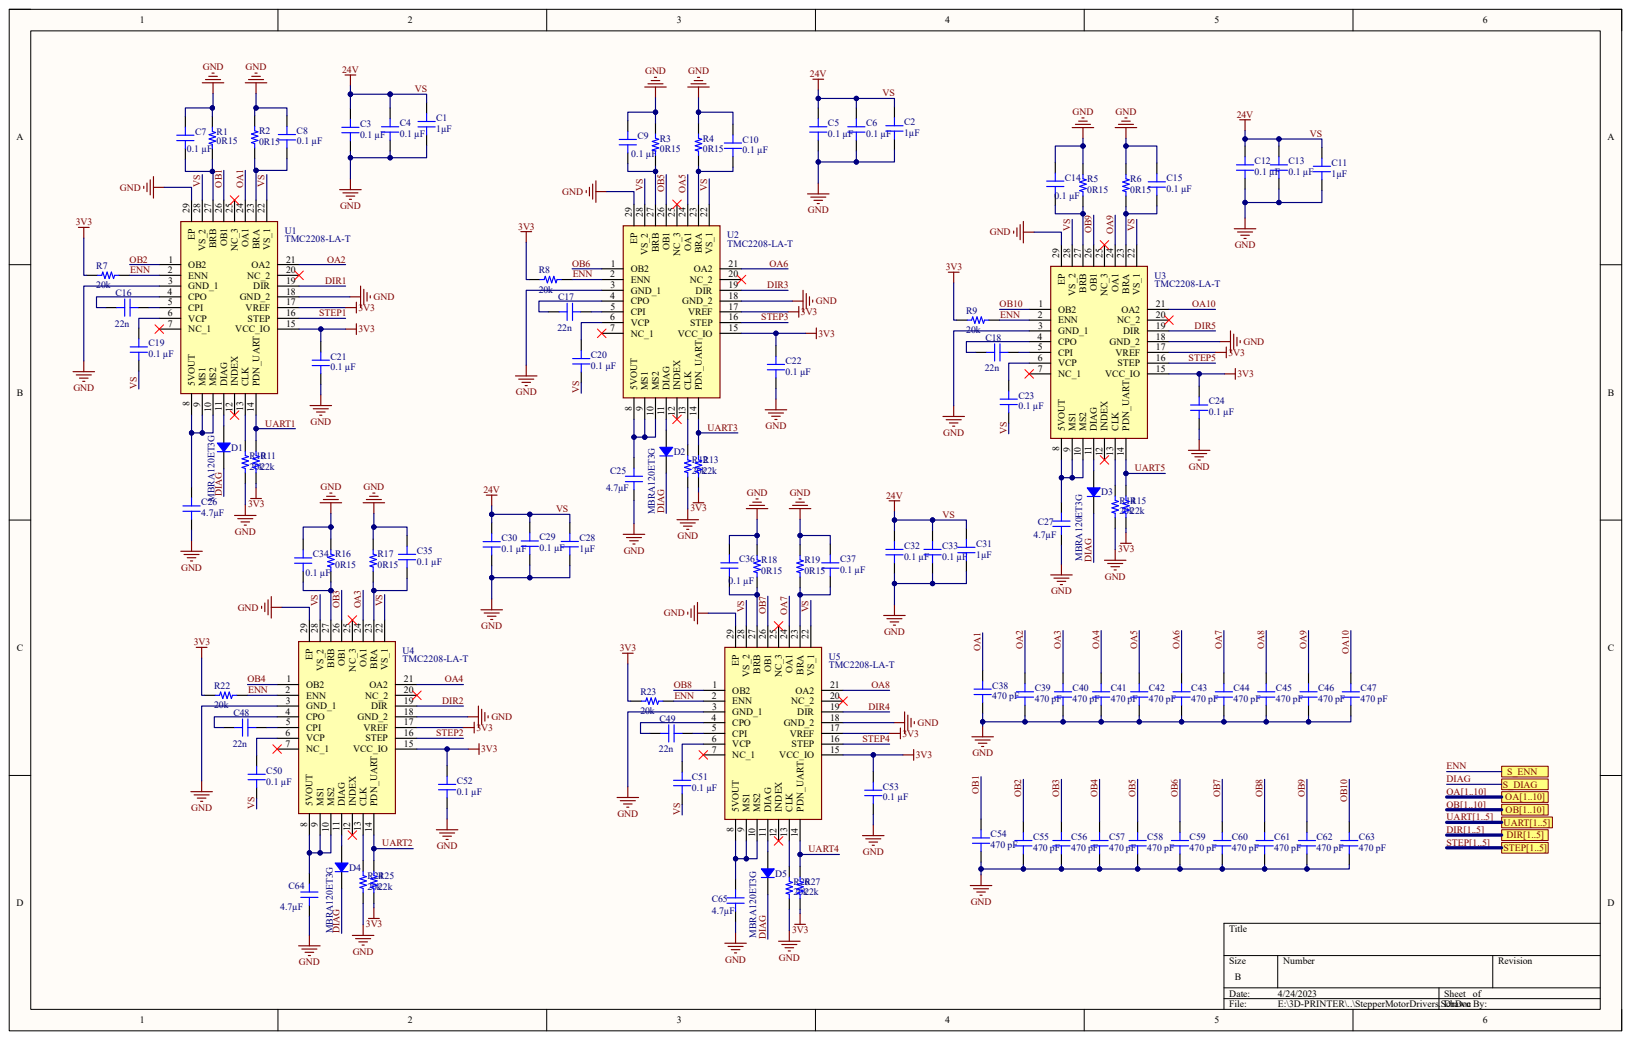
[picture p169: page 5]
