Fake-Oxygen/3D-PRINTER/(list of files, drawings)

Other design files:
MOTHERBOARD V2/3D Printer/3D Printer.PrjPcb
MOTHERBOARD V2/CAMERA/CAMERA.PrjPcb
MOTHERBOARD V2/CAMERA/Camera.SchDoc
MOTHERBOARD V2/CAMERA/PCB.PcbDoc
MOTHERBOARD V2/Connectors/Connectors.PrjPcb
MOTHERBOARD V2/Connectors/Connectors.SchDoc
MOTHERBOARD V2/Connectors/PCB3.PcbDoc
MOTHERBOARD V2/CPU/CPU.PrjPcb
MOTHERBOARD V2/CPU/CPU.SchDoc
MOTHERBOARD V2/CPU/PCB3.PcbDoc
MOTHERBOARD V2/CPU/Top.SchDoc
MOTHERBOARD V2/Extension_Board/Ethernet.SchDoc
MOTHERBOARD V2/Extension_Board/Extension_Board.PrjPcb
MOTHERBOARD V2/Extension_Board/Extension_Board.SchDoc
MOTHERBOARD V2/Extension_Board/MB1137.PcbLib
MOTHERBOARD V2/Extension_Board/MB1137.SCHLIB
MOTHERBOARD V2/Extension_Board/PCB.PcbDoc
MOTHERBOARD V2/Extension_Board/PCB_Auto.PcbDoc
MOTHERBOARD V2/Extension_Board/SD.SchDoc
MOTHERBOARD V2/Extension_Board/STLINK.SchDoc
MOTHERBOARD V2/Extension_Board/USB.SchDoc
MOTHERBOARD V2/Extension_Board/WiFi.SchDoc
MOTHERBOARD V2/GPU/GPU.PrjPcb
MOTHERBOARD V2/GPU/GPU.SchDoc
MOTHERBOARD V2/LCD/LCD.PrjPcb
MOTHERBOARD V2/LCD/LCD.SchDoc
MOTHERBOARD V2/Motherboard refurb/ADC.SchDoc
MOTHERBOARD V2/Motherboard refurb/Connectors.SchDoc
MOTHERBOARD V2/Motherboard refurb/Memory.SchDoc
MOTHERBOARD V2/Motherboard refurb/Misc.SchDoc
MOTHERBOARD V2/Motherboard refurb/Motherboard refurb.PrjPcb
MOTHERBOARD V2/Motherboard refurb/Motherboard.SchDoc
MOTHERBOARD V2/Motherboard refurb/STM32F7.SchDoc
MOTHERBOARD V2/Motherboard/ADCRead.SchDoc
MOTHERBOARD V2/Motherboard/Connectors.SchDoc
MOTHERBOARD V2/Motherboard/Flash.SchDoc
MOTHERBOARD V2/Motherboard/HeatControl.SchDoc
MOTHERBOARD V2/Motherboard/Motherboard.PrjPcb
MOTHERBOARD V2/Motherboard/Motherboard.SchDoc
MOTHERBOARD V2/Motherboard/PCB2.PcbDoc
MOTHERBOARD V2/Motherboard/SDRAM.SchDoc
MOTHERBOARD V2/Motherboard/STM32F7.SchDoc
MOTHERBOARD V2/Power Driver/PCB1.PCB
MOTHERBOARD V2/Power Driver/PCB1.PcbDoc
MOTHERBOARD V2/Power Driver/Power Driver.PrjPcb
MOTHERBOARD V2/Power Driver/PowerDriver.SchDoc
MOTHERBOARD V2/Power Driver/PWMDriver.SchDoc
MOTHERBOARD V2/Power Driver/StepperLogic.SchDoc
MOTHERBOARD V2/Power Driver/StepperMotorDrivers.SchDoc
MOTHERBOARD V2/Power_Delivery/Converters.SchDoc
MOTHERBOARD V2/Power_Delivery/PCB.PcbDoc
MOTHERBOARD V2/Power_Delivery/Power_Delivery.PrjPcb
MOTHERBOARD V2/WIFI/PCB2.PcbDoc
MOTHERBOARD V2/WIFI/WIFI.PrjPcb
MOTHERBOARD V2/WIFI/WIFI.SchDoc
SIMULATIONS/Mosfet drive circuit.ms14
