Fake-Oxygen/3D-PRINTER/SOFTWARE/CPU/CPU_L5/CPU_L5.ioc

Mcu.UserName=STM32L562RETx
PA0.GPIO_Label=HE0_T
PA0.Signal=ADCx_IN5
PA1.GPIO_Label=HE1_T
PA1.Signal=ADCx_IN6
PA10.GPIO_Label=HE1
PA10.Signal=S_TIM1_CH3
PA11.Signal=USB_DM
PA12.Signal=USB_DP
PA2.GPIO_Label=BED_T
PA2.Signal=ADCx_IN7
PA3.GPIO_Label=STEP_Y
PA3.Signal=GPIO_Output
PA4.GPIO_Label=DIR_X
PA4.Signal=GPIO_Output
PA5.GPIO_Label=GPU_SCK
PA5.Signal=SPI1_SCK
PA6.GPIO_Label=GPU_MISO
PA6.Signal=SPI1_MISO
PA7.GPIO_Label=GPU_MOSI
PA7.Signal=SPI1_MOSI
PA8.GPIO_Label=HE0
PA8.Signal=S_TIM1_CH1
PA9.GPIO_Label=TMC_UART
PA9.Signal=USART1_TX
PB0.GPIO_Label=NZLF
PB0.Signal=S_TIM3_CH3
PB1.GPIO_Label=FAN
PB1.Signal=S_TIM3_CH4
PB10.GPIO_Label=FHE0
PB10.Signal=S_TIM2_CH3
PB11.GPIO_Label=FHE1
PB11.Signal=S_TIM2_CH4
PB12.GPIO_Label=X_STOP
PB12.Signal=GPIO_Input
PB13.Signal=I2C2_SCL
PB14.Signal=I2C2_SDA
PB15.GPIO_Label=BED
PB15.Signal=S_TIM15_CH2
PB2.GPIO_Label=STEP_X
PB2.Signal=GPIO_Output
PB5.GPIO_Label=TMC_ENN
PB5.Signal=GPIO_Output
PB6.GPIO_Label=TMC_S1
PB6.Signal=GPIO_Output
PB7.GPIO_Label=TMC_S2
PB7.Signal=GPIO_Output
PB8.GPIO_Label=DIR_E1
PB8.Signal=GPIO_Output
PB9.GPIO_Label=SERVO
PB9.Signal=S_TIM17_CH1
PC0.GPIO_Label=DIR_Z
PC0.Signal=GPIO_Output
PC1.GPIO_Label=STEP_Z
PC1.Signal=GPIO_Output
PC10.Signal=SDMMC1_D2
PC11.Signal=SDMMC1_D3
PC12.Signal=SDMMC1_CK
PC13.GPIO_Label=STEP_E1
PC13.Signal=GPIO_Output
PC2.GPIO_Label=DIR_Y
PC2.Signal=GPIO_Output
PC3.GPIO_Label=Z_MIN
PC3.Signal=GPIO_Input
PC4.GPIO_Label=ESP_RX
PC4.Signal=USART3_TX
PC5.GPIO_Label=ESP_TX
PC5.Signal=USART3_RX
PC6.GPIO_Label=E0
PC6.Signal=GPIO_Input
PC7.GPIO_Label=E1
PC7.Signal=GPIO_Input
PC8.Signal=SDMMC1_D0
PC9.Signal=SDMMC1_D1
PD2.Signal=SDMMC1_CMD
PH3-BOOT0.GPIO_Label=TMC_S3
PH3-BOOT0.Signal=GPIO_Output
