Fake-Oxygen/3D-PRINTER/SOFTWARE/CPU/CPU_L5/Core/Src/main.cpp

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
/* Includes ------------------------------------------------------------------*/
#include "main.h"
#include "adc.h"
#include "dma.h"
#include "tim.h"
#include "usart.h"
#include "usb_device.h"
#include "gpio.h"

/* USER CODE BEGIN Includes */
#include "Temperature.h"
#include "string.h"
#include "usbd_cdc_if.h"
#include "TMC2208.h"
#include "MiniPID.h"
#include "types.h"
#include "reader.h"
#include "GCodes.h"
/* USER CODE END Includes */


/* USER CODE BEGIN PV */
uint32_t ADC_value[ADC_CHANNELS];
MiniPID pidbed = MiniPID(16.7, 0.3119, -23.99, 0.696); // zajebiste na bed
MiniPID pidhe0 = MiniPID(5.238, 0.0072, 3.979);
MiniPID pidhe1 = MiniPID(5.238, 0.0072, 3.979); //180 - git (1.238, 0.0041, 2.979)
const size_t INPUT_SIZE = 8;
int8_t usb_flag = -1;
uint8_t buffer[64];
/* USER CODE END PV */

void SystemClock_Config(void);
void PeriphCommonClock_Config(void);
/* USER CODE BEGIN PFP */

int GetTicks() {
	return __HAL_TIM_GET_COUNTER(&htim16);
}

void HAL_UART_RxCpltCallback(UART_HandleTypeDef *huart) {
	if (huart->Instance == USART1) {
		transEnd = 1;
		HAL_UART_Receive_IT(&huart1, commData, 12);
	}
}

int read_gcode(char input, gc_reader *reader, int *iter) {
	int done = 0;
	int error_code = read_code(reader, input, &done);
	if (error_code != GC_READER_ERROR_NOT_OCCURED) {
		printf("ERROR OCCURED!\n");
		return 1;
	} else {
		(*iter)++;
	}
	if (done) {
		printf("%c %lu -> X=%f Y=%f Z=%f E=%f S=%f F=%f rc=%lu c=%lu fc=%d\n",
				reader->code_type, reader->code_id, reader->X, reader->Y,
				reader->Z, reader->E, reader->S, reader->F,
				reader->read_checksum, reader->checksum,
				reader->found_checksum);
//        memcpy(reader, rd, sizeof(gc_reader));
		execute(reader);
		usb_flag = -1;
		memset(buffer, 0, sizeof(buffer));
	}
	return 0;
}

void SetTMCSettings(uint8_t Axis, uint16_t rms) {
	selectAxis(Axis);
	initTMC2208Registers(&huart1);

	uint32_t val = getRegVal(&huart1, GCONF_ADDR);
	val = setPDNDisable(val, 1);
	val = setIScaleAnalog(val, 0);
	val = setMstepRegSelect(val, 1);
	setRegValSafe(&huart1, GCONF_ADDR, val);
	getRMSCurrent(&huart1, 0.15);
	setRMSCurrent(&huart1, rms, 0.5, 0.15);
	getRMSCurrent(&huart1, 0.15);
	val = getRegVal(&huart1, CHOPCONF_ADDR);
	val = setTOFF(val, 2);
	setRegValSafe(&huart1, CHOPCONF_ADDR, val);
	getMRES(val);
	val = setMRES(val, 2);
	setRegValSafe(&huart1, CHOPCONF_ADDR, val);
	val = getRegVal(&huart1, CHOPCONF_ADDR);
	getMRES(val);
	val = getRegVal(&huart1, FACTORY_CONF_ADDR);
	setBit(val, 8, 0);
	setBit(val, 9, 1);
}

void DelayMicrosecond(uint16_t time) {
	__HAL_TIM_SET_COUNTER(&htim16, 0);
	while (__HAL_TIM_GET_COUNTER(&htim16) < time)
		;
}

/* USER CODE END PFP */

/* USER CODE BEGIN 0 */
char msg[60] = { '\0' };
int outb = 0;
int outhe0 = 0;
int outhe1 = 0;
char xyz[256];
float bed;
float he1;
gc_reader reader;
header head;
/* USER CODE END 0 */

/**
 * @brief  The application entry point.
 * @retval int
 */
int main(void) {
	/* MCU Configuration--------------------------------------------------------*/

	/* Reset of all peripherals, Initializes the Flash interface and the Systick. */
	HAL_Init();

	/* Configure the system clock */
	SystemClock_Config();

	/* Configure the peripherals common clocks */
	PeriphCommonClock_Config();

	/* Initialize all configured peripherals */
	MX_GPIO_Init();
	MX_DMA_Init();
	MX_USB_Device_Init();
	MX_ADC1_Init();
	MX_TIM15_Init();
	MX_USART1_UART_Init();
	MX_TIM1_Init();
	MX_TIM2_Init();
	MX_TIM3_Init();
	MX_TIM16_Init();
	MX_TIM17_Init();
	/* USER CODE BEGIN 2 */
	HAL_TIM_PWM_Start(&htim15, TIM_CHANNEL_2);
	HAL_TIM_PWM_Start(&htim1, TIM_CHANNEL_1);
	HAL_TIM_PWM_Start(&htim1, TIM_CHANNEL_3);
	HAL_TIM_PWM_Start(&htim2, TIM_CHANNEL_3);
	HAL_TIM_PWM_Start(&htim2, TIM_CHANNEL_4);
	HAL_TIM_PWM_Start(&htim3, TIM_CHANNEL_4);
	HAL_TIM_PWM_Start(&htim17, TIM_CHANNEL_1);
	TIM17->CCR1 = 0;
	HAL_TIM_Base_Start(&htim16);
	HAL_ADC_Start_DMA(&hadc1, ADC_value, ADC_CHANNELS);
	HAL_Delay(2000);
	HAL_GPIO_WritePin(GPIOB, GPIO_PIN_5, GPIO_PIN_RESET);
	pidbed.setOutputLimits(0, 100);
	pidbed.setOutputRampRate(10);
	pidhe0.setOutputLimits(0, 255);
	pidhe0.setOutputRampRate(10);
	pidhe1.setOutputLimits(0, 255);
	pidhe1.setOutputRampRate(10);

	HAL_UART_Receive_IT(&huart1, commData, 12);
	HAL_GPIO_WritePin(TMC_ENN_GPIO_Port, TMC_ENN_Pin, GPIO_PIN_RESET);
	HAL_GPIO_WritePin(DIR_Z_GPIO_Port, DIR_Z_Pin, GPIO_PIN_RESET);
	SetTMCSettings(X_AXIS, 400);
	SetTMCSettings(Z_AXIS, 800);
	SetTMCSettings(E0_AXIS, 400);
	SetTMCSettings(E1_AXIS, 400);

	memset(&reader, 0, sizeof(reader));
	memset(&head, 0, sizeof(head));
	int iter = 0;
	/* USER CODE END 2 */

	/* Infinite loop */
	/* USER CODE BEGIN WHILE */

	while (1) {
		bed = GetTemperature(BED, ADC_value[BED]);
		he1 = GetTemperature(HE1, ADC_value[HE1]);
		outb = (int) (pidbed.getOutput((double) bed, head.temp_bed));
		outhe1 = (int) (pidhe1.getOutput((double) he1, head.temp_he1));
		TIM15->CCR2 = outb;
		TIM1->CCR3 = outhe1;
		switch (head.isrunning) {
		case RUNNING:
			G0(&reader);
			break;
		case WAIT_FOR_BED_TEMP:
			if (bed >= head.temp_bed)
				head.isrunning = FREE;
			break;
		case WAIT_FOR_HE1_TEMP:
			if (he1 >= head.temp_he1)
				head.isrunning = FREE;
			break;
		case FREE:
			while (usb_flag != 0) {
				if (usb_flag - iter <= 0) {
					iter = 0;
					break;
				}
				read_gcode(buffer[iter], &reader, &iter);
			}
			break;
		}
		/* USER CODE END WHILE */

		/* USER CODE BEGIN 3 */
	}
	/* USER CODE END 3 */
}

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
