Fake-Oxygen/3D-PRINTER/SOFTWARE/3D_Printer/Core/Src/main.c

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
/* Includes ------------------------------------------------------------------*/
#include "main.h"
#include "fatfs.h"

/* USER CODE BEGIN Includes */
#include "Functions.h"
#include <stdio.h>
#include <string.h>
#include <ctype.h>
#include "ILI9341_STM32_Driver.h"
#include "ILI9341_GFX.h"
#include "5x5_font.h"
#include "vl53l0x_api.h"
#include "fatfs.h"
#include <stdarg.h>
// #include "Parser.h"
/* USER CODE END Includes */

ADC_HandleTypeDef hadc1;
DMA_HandleTypeDef hdma_adc1;

I2C_HandleTypeDef hi2c1;

UART_HandleTypeDef hlpuart1;
UART_HandleTypeDef huart4;
DMA_HandleTypeDef hdma_lpuart1_rx;

RNG_HandleTypeDef hrng;

SPI_HandleTypeDef hspi1;
SPI_HandleTypeDef hspi2;

TIM_HandleTypeDef htim2;
TIM_HandleTypeDef htim3;
TIM_HandleTypeDef htim4;
TIM_HandleTypeDef htim5;

PCD_HandleTypeDef hpcd_USB_OTG_FS;

/* USER CODE BEGIN PV */
uint32_t value[ADC_CHANNELS];

/// @brief Distance sensor
VL53L0X_RangingMeasurementData_t RangingData;
VL53L0X_Dev_t vl53l0x_c; // center module
VL53L0X_DEV Dev = &vl53l0x_c;
///

/* USER CODE END PV */

void SystemClock_Config(void);
static void MX_GPIO_Init(void);
static void MX_DMA_Init(void);
static void MX_LPUART1_UART_Init(void);
static void MX_USB_OTG_FS_PCD_Init(void);
static void MX_TIM4_Init(void);
static void MX_UART4_Init(void);
static void MX_TIM3_Init(void);
static void MX_ADC1_Init(void);
static void MX_TIM5_Init(void);
static void MX_TIM2_Init(void);
static void MX_SPI1_Init(void);
static void MX_RNG_Init(void);
static void MX_I2C1_Init(void);
static void MX_SPI2_Init(void);
/* USER CODE BEGIN 0 */

void myprintf(const char *fmt, ...)
{
  static char buffer[256];
  va_list args;
  va_start(args, fmt);
  vsnprintf(buffer, sizeof(buffer), fmt, args);
  va_end(args);

  int len = strlen(buffer);
  HAL_UART_Transmit(&hlpuart1, (uint16_t *)buffer, len, HAL_MAX_DELAY);
}

void HAL_UARTEx_RxEventCallback(UART_HandleTypeDef *huart, uint16_t Size)
{
  if (huart->Instance == LPUART1)
  {
    HAL_UARTEx_ReceiveToIdle_DMA(&hlpuart1, (uint8_t *)RxBuf, RxBuf_SIZE);
    __HAL_DMA_DISABLE_IT(&hdma_lpuart1_rx, DMA_IT_HT);
  }
}

void DelayMicrosecond(uint16_t time)
{
  __HAL_TIM_SET_COUNTER(&htim4, 0);
  while (__HAL_TIM_GET_COUNTER(&htim4) < time)
    ;
}

int GetTicks()
{
  return __HAL_TIM_GET_COUNTER(&htim5);
}

void SPI_Transmit(uint8_t *pData, uint16_t Size, uint32_t Timeout)
{
  HAL_SPI_Transmit(&hspi1, &pData, Size, Timeout);
}
/* USER CODE END 0 */

/**
  * @brief  The application entry point.
  * @retval int
  */
int main(void)
{
  /* USER CODE BEGIN 1 */
  //
  // VL53L0X initialisation stuff
  //
  uint32_t refSpadCount;
  uint8_t isApertureSpads;
  uint8_t VhvSettings;
  uint8_t PhaseCal;
  /* USER CODE END 1 */

  /* MCU Configuration--------------------------------------------------------*/

  /* Reset of all peripherals, Initializes the Flash interface and the Systick. */
  HAL_Init();

  /* Configure the system clock */
  SystemClock_Config();

  /* Initialize all configured peripherals */
  MX_GPIO_Init();
  MX_DMA_Init();
  MX_LPUART1_UART_Init();
  MX_USB_OTG_FS_PCD_Init();
  MX_TIM4_Init();
  MX_UART4_Init();
  MX_TIM3_Init();
  MX_ADC1_Init();
  MX_TIM5_Init();
  MX_TIM2_Init();
  MX_SPI1_Init();
  MX_RNG_Init();
  MX_I2C1_Init();
  MX_SPI2_Init();
  MX_FATFS_Init();
  /* USER CODE BEGIN 2 */
  HAL_TIM_PWM_Start(&htim3, TIM_CHANNEL_1);
  HAL_TIM_PWM_Start(&htim3, TIM_CHANNEL_2);
  HAL_TIM_PWM_Start(&htim3, TIM_CHANNEL_3);
  HAL_ADC_Start_DMA(&hadc1, value, ADC_CHANNELS);
  HAL_TIM_Base_Start(&htim4);
  HAL_TIM_Base_Start(&htim5);
  HAL_UARTEx_ReceiveToIdle_DMA(&hlpuart1, RxBuf, RxBuf_SIZE);
  __HAL_DMA_DISABLE_IT(&hdma_lpuart1_rx, DMA_IT_HT);
  memset(&RxBuf[0], 0, sizeof(RxBuf));
  reset_args();
  int steps = 0;
  bool started = false;
  uint32_t lasttimeX = 0;
  uint32_t lasttimeY = 0;
  ILI9341_Init();
  //
  // Distance sensor
  //

  Dev->I2cHandle = &hi2c1;
  Dev->I2cDevAddr = 0x52;

  HAL_GPIO_WritePin(GPIOF, GPIO_PIN_10, GPIO_PIN_RESET); // Disable XSHUT
  HAL_Delay(20);
  HAL_GPIO_WritePin(GPIOF, GPIO_PIN_10, GPIO_PIN_SET); // Enable XSHUT
  HAL_Delay(20);

  //
  // VL53L0X init for Single Measurement
  //

  VL53L0X_WaitDeviceBooted(Dev);
  VL53L0X_DataInit(Dev);
  VL53L0X_StaticInit(Dev);
  VL53L0X_PerformRefCalibration(Dev, &VhvSettings, &PhaseCal);
  VL53L0X_PerformRefSpadManagement(Dev, &refSpadCount, &isApertureSpads);
  VL53L0X_SetDeviceMode(Dev, VL53L0X_DEVICEMODE_SINGLE_RANGING);

  // Enable/Disable Sigma and Signal check
  VL53L0X_SetLimitCheckEnable(Dev, VL53L0X_CHECKENABLE_SIGMA_FINAL_RANGE, 1);
  VL53L0X_SetLimitCheckEnable(Dev, VL53L0X_CHECKENABLE_SIGNAL_RATE_FINAL_RANGE, 1);
  VL53L0X_SetLimitCheckValue(Dev, VL53L0X_CHECKENABLE_SIGNAL_RATE_FINAL_RANGE, (FixPoint1616_t)(0.1 * 65536));
  VL53L0X_SetLimitCheckValue(Dev, VL53L0X_CHECKENABLE_SIGMA_FINAL_RANGE, (FixPoint1616_t)(60 * 65536));
  VL53L0X_SetMeasurementTimingBudgetMicroSeconds(Dev, 2000000);
  VL53L0X_SetVcselPulsePeriod(Dev, VL53L0X_VCSEL_PERIOD_PRE_RANGE, 18);
  VL53L0X_SetVcselPulsePeriod(Dev, VL53L0X_VCSEL_PERIOD_FINAL_RANGE, 14);

  // HAL_Delay(1000);
  // FATFS FatFs;  // Fatfs handle
  // FIL fil;      // File handle
  // FRESULT fres; // Result after operations

  // fres = f_mount(&FatFs, "", 1); // 1=mount now
  // // HAL_Delay(1000);
  // while (fres != FR_OK)
  // {
  //   myprintf("f_mount error (%i)\r\n", fres);
  //   HAL_Delay(500);
  //   fres = f_mount(&FatFs, "", 1); // 1=mount now
  // }

  // DWORD free_clusters, free_sectors, total_sectors;

  // FATFS *getFreeFs;

  // fres = f_getfree("", &free_clusters, &getFreeFs);
  // while (fres != FR_OK)
  // {
  //   myprintf("f_getfree error (%i)\r\n", fres);
  //   HAL_Delay(500);
  //   fres = f_getfree("", &free_clusters, &getFreeFs);
  // }
  // total_sectors = (getFreeFs->n_fatent - 2) * getFreeFs->csize;
  // free_sectors = free_clusters * getFreeFs->csize;
  // myprintf("SD card stats:\r\n%10lu KiB total drive space.\r\n%10lu KiB available.\r\n", total_sectors / 2, free_sectors / 2);
  // fres = f_open(&fil, "AA8_cube.txt", FA_READ);
  // while (fres != FR_OK)
  // {
  //   myprintf("f_open error (%i)\r\n");
  //   HAL_Delay(500);
  //   fres = f_open(&fil, "AA8_cube.txt", FA_READ);
  // }
  // myprintf("I was able to open 'AA8_cube.txt' for reading!\r\n");
  int t = 0;
  /* USER CODE END 2 */

  /* Infinite loop */
  /* USER CODE BEGIN WHILE */
  while (1)
  {
    // ILI9341_Set_Address(0,0,320,240);
    // ILI9341_Draw_Colour_Burst(MAGENTA, 320*240);
    // ILI9341_Set_Rotation(SCREEN_HORIZONTAL_2);
    // ILI9341_Fill_Screen(WHITE);
    // VL53L0X_PerformSingleRangingMeasurement(Dev, &RangingData);
    if (RxBuf[0] != 0 && isRunning == false)
    {
      get_command(RxBuf);
      memset(&RxBuf[0], 0, sizeof(RxBuf));
    }
    // if(RangingData.RangeStatus == 0)
    // {
    //   sprintf((char*)msg_buffer, "Measured distance: %i\n\r", RangingData.RangeMilliMeter);
    //   HAL_UART_Transmit(&hlpuart1, (uint16_t *)msg_buffer, strlen(msg_buffer), 100);
    // }
    // ILI9341_Draw_Text("KURWA", 10, 10, BLACK, 4, WHITE);
    // ILI9341_Draw_Filled_Rectangle_Coord(0, 100, 200, 130, BLACK);
    // if (isRunning == false && started == true)
    // {
    //   isRunning = true;
    //   BYTE readBuf[40];
    //   TCHAR *rres = f_gets((TCHAR *)readBuf, 40, &fil);
    //   if (rres != 0)
    //   {
    //     myprintf("%s", readBuf);
    //     get_command(readBuf);
    //   }
    // }

    // HAL_Delay(400);

    if (READ_PIN(X_STOP_PIN) != 1 && READ_PIN(Y_STOP_PIN) != 1)
    {
      G0();
    }
    
    // M104();
    // M140();
    // if(t >= 1000)
    // {
    //   myprintf("T: %.2f R: %.2f B: %.2f\r\n", GetTemperature(ADC_HOT_END, value[ADC_HOT_END]), GetTemperature(6, value[ADC_HOT_END]), GetTemperature(ADC_BED, value[ADC_BED]));
    //   t = 0;
    // }else t++;
    // MAKE_MOTOR_STEP(X_AXIS_STEP);
    // MAKE_MOTOR_STEP(Y_AXIS_STEP);
    WRITE_PIN(X_AXIS_STEP, 0);
    WRITE_PIN(Y_AXIS_STEP, 0);
    WRITE_PIN(X_AXIS_STEP, 1);
    WRITE_PIN(Y_AXIS_STEP, 1);
    DelayMicrosecond(500);
    if (READ_PIN(USER_BUTTON) == 1)
    {
      started = true;
      myprintf("Cur X: %f, Des X: %f, Cur Y: %f, Des Y: %f, isRunning?: %d\r\n", Cur_X, X, Cur_Y, Y, isRunning);
    }
    /* USER CODE END WHILE */

    /* USER CODE BEGIN 3 */
  }
  // f_close(&fil);
  /* USER CODE END 3 */
}

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
