Fake-Oxygen/3D-PRINTER/SOFTWARE/3D_Printer/Core/Inc/Parser.h

#ifndef PARSER_H
#define PARSER_H

#include "main.h"
#include <stdlib.h>
#include <string.h>
#include <stdbool.h>

extern uint16_t F;
extern uint16_t interval, hot_end_temp_goal, hot_bed_temp_goal;
extern double X, Y, Z, E;

void reset_args();
void get_command(uint8_t buf[]);
void split_gcode(uint8_t buf[]);

#endif
