Fake-Oxygen/3D-PRINTER/(commit log)

2022-06-18 Rearranged file localizations
    [3D Printer.PrjPcb, Aluminium panel.SLDPRT, Bottom Plate Support Bar.SLDPRT, Bottom-Top Plate.SLDDRW, Bottom-Top Plate.SLDPRT, Carriage for V Slot.SLDPRT, Część1.SLDPRT, Development Board.PrjPcb]
2022-07-17 Added BOM
    [BOM.xlsx]
2022-07-18 Added Power supply
    [Zasilacz WIP.SLDPRT, Złożenie1.SLDASM]
2022-07-23 Test STM32 program + Thermistor control data
    [Thermistor Data.xlsx]
2022-07-24 Hotbed control circuitry
    [3D Printer.PrjPcb, Development Board.PrjPcb, Development Board.SchDoc, Motherboard.SchDoc]
2022-07-24 STM32 Test code
2022-07-31 TMC2208 Circuit
    [3D Printer.PrjPcb, Motherboard.SchDoc, TMC2208.SchDoc]
2022-08-08 test code stm32
    [Thermistor Data(AutoRecovered).xlsx]
2022-08-17 TMC Schematic updated
    [3D Printer.PrjPcb, Motherboard.PcbDoc, Motherboard.SchDoc, STM32.SchDoc, TMC2208.SchDoc]
2022-08-17 STM32 Power circuit
    [Motherboard.SchDoc, STM32.SchDoc]
2022-08-17 PDN Transmition circuit
    [Motherboard.SchDoc, STM32.SchDoc, TMC2208.SchDoc]
2022-08-18 Completed PDN Transmition
    [Motherboard.SchDoc, STM32.SchDoc]
2022-08-18 Removed development board
    [Development Board.PrjPcb, Development Board.SchDoc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]
2022-08-18 Moved stepper motor test codes
2022-08-18 TMC Fault detection circuit
    [Motherboard.SchDoc, STM32.SchDoc]
2022-08-18 STEP/DIR Connection
    [Motherboard.SchDoc, STM32.SchDoc, TMC2208.SchDoc]
2022-08-19 Fixed pull down resistor values
    [Motherboard.SchDoc, TMC2208.SchDoc]
2022-08-19 Fixed DIR connection
    [Motherboard.SchDoc, STM32.SchDoc, TMC2208.SchDoc]
2022-08-20 Tested LTDC
    [Motherboard.SchDoc]
2022-08-21 Added base code
    [Motherboard.SchDoc, Temperature.SchDoc]
2022-08-21 Temperature control circuit
    [Motherboard.SchDoc, TMC2208.SchDoc, Temperature.SchDoc]
2022-08-21 Temp control connection
    [Motherboard.SchDoc, STM32.SchDoc]
2022-08-22 UART Transmission + ADC DMA Read
2022-08-23 Reading STM temperature
2022-08-27 Deleted history files
    [3D Printer.PrjPcb]
2022-08-28 Updated thermistor data
    [Thermistor Data(AutoRecovered).xlsx, Thermistor Data.xlsx]
2022-08-28 Hot end thermistor modified
    [PowerConversion.SchDoc, Thermistor Data.xlsx]
2022-08-30 Stabilized ADC readings
    [3D Printer.PrjPcb, Motherboard.SchDoc, PowerConversion.SchDoc, Temperature.SchDoc]
2022-08-31 receiving data from uart via DMA
2022-08-31 Check character from uart
2022-09-12 Heating +Cooling + Movement
2022-09-13 3.3V Buck converter
    [PowerConversion.SchDoc]
2022-09-13 Added designators
    [PowerConversion.SchDoc]
2022-09-14 12V Buck converter
    [PowerConversion.SchDoc]
2022-09-14 X endstop
    [Motherboard.SchDoc, PowerConversion.SchDoc, STM32.SchDoc, TMC2208.SchDoc]
2022-09-16 Added decoupling caps
    [Motherboard.SchDoc]
2022-09-17 XY Axis test
    [3D Printer.PrjPcb, Motherboard.SchDoc, STM32.SchDoc, StepperMotorLogic.SchDoc]
2022-09-25 Hot Bed Assembly
    [3D Printer.PrjPcb, Bottom Plate Support Bar.SLDPRT, Bottom-Top Plate.SLDPRT, EndStops.SchDoc, Hot Bed.SLDPRT, Left Y Carriage Plate.SLDPRT, Middle Y Carriage Plate.SLDPRT, Pillar.SLDPRT]
2022-09-25 DZIAŁA PRZESÓWANIE KURWA
    [Aluminium panel connector.SLDPRT, Aluminium panel with connectors.SLDASM]
2022-10-09 Z axis test
2022-10-10 Block Schematics
2022-10-10 Fans + Bed leveling circuit
    [EndStops.SchDoc, Motherboard.SchDoc, STM32.SchDoc, Temperature.SchDoc]
2022-10-12 SPI setup
2022-10-12 ILI9341 Driver
2022-10-12 Full ILI9341 Driver implementation
2022-10-18 XY Axis models and assembly
    [625ZZ bearing.SLDPRT, Carriage for V Slot.SLDPRT, Spacer M5 6mm.SLDPRT, Tire for 625ZZ bearing.SLDPRT, Top Plate.SLDPRT, V Slot Carriage Assembly.SLDASM, Wheel for guideway.SLDASM, Złożenie1.SLDASM]
2022-10-19 XY Rail
    [MGNxx rail.SLDPRT, Top Plate.SLDPRT, V Slot Carriage Assembly.SLDASM, Złożenie1.SLDASM]
2022-10-19 Added MGNxx Block
    [MGNxx block.SLDPRT]
2022-10-20 Model of heatend cooler block
    [HeatEnd Cooler block.SLDPRT]
2022-10-20 Extruder models
    [HeatEnd Cooler block.SLDPRT, Heating Block.SLDPRT, Nozzle 0.4mm.SLDPRT, Throat tube.SLDPRT]
2022-10-21 Heat End + GT2 pulley
    [36 Teeth GT2 gear.SLDPRT, Heat End.SLDASM, Heating Block.SLDPRT, PTFE tube connector.SLDPRT]
2022-10-22 Head Assembly
    [36 Teeth GT2 gear.SLDPRT, Head Assembly.SLDASM, Head Holder.SLDPRT, Heat End.SLDASM, Kopia Threaded Rod M8.SLDPRT, Motherboard.SchDoc, STM32.SchDoc, V Slot Carriage Assembly.SLDASM]
2022-10-22 Bearing holder
    [Bearing Holder.SLDPRT, Head Assembly.SLDASM, MGNxx block.SLDPRT, V Slot Carriage Assembly.SLDASM, Złożenie1.SLDASM]
2022-10-23 pulley setup
    [625ZZ bearing.SLDPRT, Assem1.SLDASM, Bearing Holder.SLDPRT, Bearing holder cover.SLDPRT, Bearing.SLDPRT, Head Assembly.SLDASM, Kopia Threaded Rod M8.SLDPRT, Top Plate.SLDPRT]
2022-10-24 Stabilized Z Axis
    [Bottom-Top Plate.SLDPRT, GT2 Belt.SLDPRT, Head Assembly.SLDASM, Heat End.SLDASM, Kopia Threaded Rod M8.SLDPRT, LMK Bearing.SLDPRT, Middle Y Carriage Plate.SLDPRT, Rod Holder.SLDPRT]
2022-10-24 Stabilizers assembly
    [Head Assembly.SLDASM, Heat End.SLDASM, Stabilizer.SLDPRT, V Slot Carriage Assembly.SLDASM, Złożenie1.SLDASM]
2022-10-26 Header Cooling
    [Fan Housing.SLDPRT, Fan Propeller.SLDPRT, Fan.SLDASM, Head Assembly.SLDASM, Head Holder.SLDPRT, Header fan holder.SLDPRT, Heat End.SLDASM, Rod.SLDPRT]
2022-10-27 Turbine (To fix later)
    [Head Assembly.SLDASM, Head Holder.STL, Turbine Housing Bot.SLDPRT, Turbine Housing Top.SLDPRT, Turbine propeller.SLDPRT, Turbine.SLDASM]
2022-11-06 Z end stop
    [Back Header Cover.SLDPRT, End Stop.SLDPRT, Head Assembly.SLDASM, Head Holder.SLDPRT, Heat End.SLDASM, Pick.SLDPRT, Side Header Cover.SLDPRT, V Slot Carriage Assembly.SLDASM]
2022-11-11 Changed Scale
    [Header fan holder.SLDDRW]
2022-11-24 [WIP] Distance sensor
2022-11-24 Distance sensor compiling works
2022-11-25 Distance sensor works
2022-11-26 move xy algorithm tweaks
    [EndStops.SchDoc]
2022-12-16 Performed lots of tests
    [Stabilizer.STL, Temperature.SchDoc]
2023-01-13 Header completed
    [BLTouch-Smart V3.1.step, Blower fan holder.SLDPRT, Blower fan holder.STL, FanDuct.SLDPRT, FanDut.SLDPRT, FanDut.STL, Head Holder v2.SLDPRT, Head Holder v2.STL]
2023-02-11 Motherboard v2
    [1.75mm-filament-spool.step, 1.stp, 1.stp.SLDPRT, 2.stp, 2.stp.SLDPRT, 3.stp, 3.stp.SLDPRT, 30x38 2020 HINGE v2.step]
2023-03-09 General update
    [Back belt holder.SLDPRT, Back belt holder.STL, Bearing Holder.STL, Blower fan holder.SLDPRT, Blower fan holder.STL, FanDut.STL, Head Holder v2.SLDPRT, Header fan holder plate v2.SLDPRT]
2023-05-07 New version of motherboard (divided CPU + GPU)
    [ADC.SchDoc, ADCRead.SchDoc, BOM2.xlsx, Back belt holder.SLDPRT, Blower fan holder.SLDPRT, Bottom support bar.SLDPRT, CAMERA.PrjPcb, CAMERA.xlsx]
2023-06-02 Completed PCB
    [CPU.PrjPcb, CPU.SchDoc, Connectors.PrjPcb, Connectors.SchDoc, Frame.SLDASM, GPU.PrjPcb, GPU.SchDoc, Hot Bed.SLDASM]
2023-06-17 add Full\ Assembly.SLDASM
2023-06-17 PIME project
    [3D Printer.PrjPcb, Aluminium panel with connectors.SLDASM, Assem1.SLDASM, Back Belt Drive.SLDASM, Back top plate.SLDPRT, Bearing Holder.SLDPRT, Bearing.SLDPRT, Camera.SLDASM]
2023-10-18 major update
    [36 Teeth GT2 gear.SLDPRT, Back plate.SLDPRT, Bearing holder Z axis.SLDPRT, Belt holder.SLDPRT, Belt holder.STL, Belt protector in.SLDPRT, Belt protector in.STL, Belt protector in2.STL]
2023-10-18 CPU showups
    [CPU.PrjPcb]
