Fake-Oxygen/3D-PRINTER/(notices)

Notices in the files:
SOFTWARE/CPU/CPU/Core/Src/main.c:
Copyright (c) 2023 STMicroelectronics.
All rights reserved.
This software is licensed under terms that can be found in the LICENSE file
SOFTWARE/3D_Printer/Core/Inc/main.h:
Copyright (c) 2022 STMicroelectronics.
